cozycactus/x0xb0x-hardware/README.md

# x0xb0x hardware: KiCad and Blender

Private working repository for the x0xb0x Eagle-to-KiCad conversion and reconstructed enclosure assembly. Original design: **Copyright (c) Limor Fried & Adafruit Industries**. x0xb0x is an Adafruit trademark.

## Open the current projects

- [Mainboard — KiCad working revision 30](kicad-working/mainboard/mainboard.kicad_pro)
- [I/O board — KiCad working revision 30](kicad-working/ioboard/ioboard.kicad_pro)
- [Schematics as PDF: mainboard](kicad-working/schematic-redraw/mainboard-schematic.pdf) and [I/O board](kicad-working/schematic-redraw/ioboard-schematic.pdf)
- [Fabrication packages — revision 30](kicad-working/fabrication/revision-30/README.md)
- [Complete assembly — Blender revision 29](kicad-working/visualization/blender-case-revision-29/x0xb0x-populated-with-case.blend)
- [KiCad notes](kicad-working/README.md) and [Blender views and limitations](kicad-working/visualization/blender-case-revision-29/README.md)

Keep each complete project folder together: symbols, footprints and STEP models use project-relative paths. The Blender file embeds the populated boards and can be opened without the original workspace or external board exports. The current scene was saved with Blender 5.2.2 LTS. The current KiCad projects were checked using KiCad 10.0.7.

See [opening and verification instructions](docs/OPENING.md) for a fresh download.

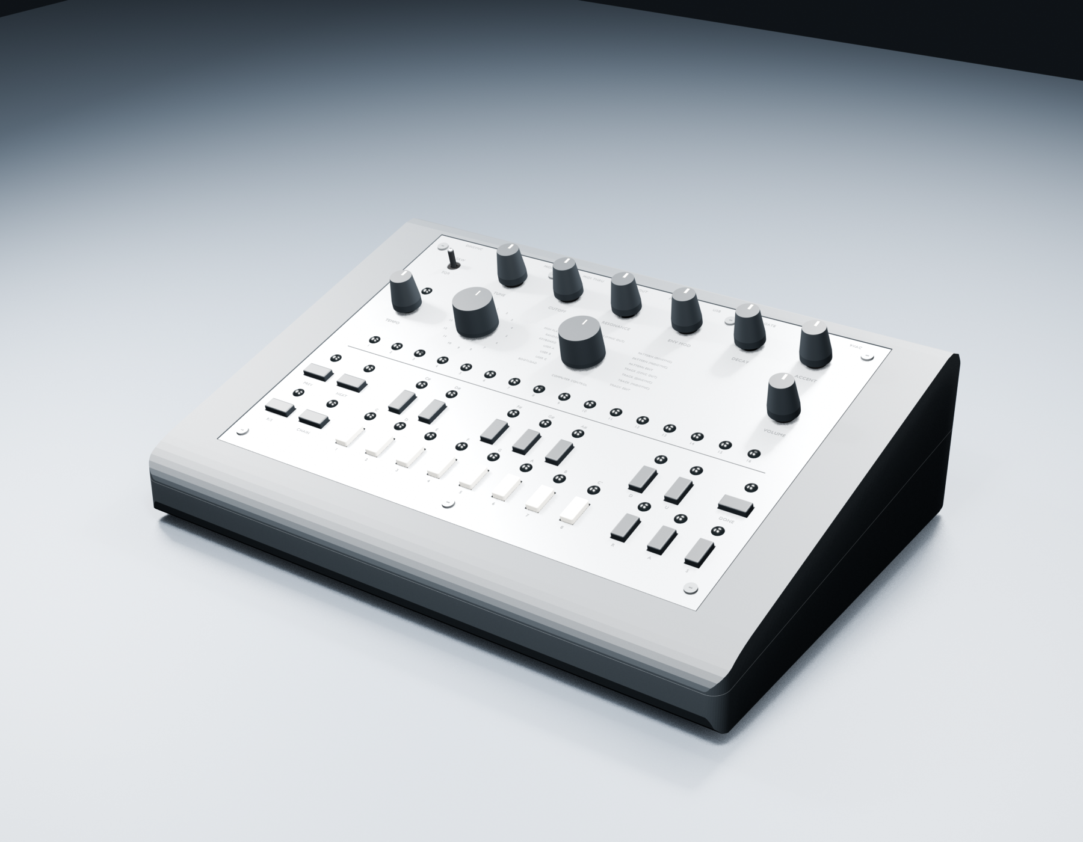
[picture p1: kicad-working/visualization/blender-case-revision-29/assembled.png]
Assembled x0xb0x


## What is included

- Both editable KiCad schematics and routed PCBs, project-local libraries and all 491 fitted component models.
- The original four Eagle files, byte-for-byte preserved under [original-eagle](original-eagle/).
- The corrected Blender enclosure, original panel DXFs, model generators, reference sources, attribution and verification reports.
- Complete PCB-mounted LED models with black STD240B spacers at all 40 positions. Their lenses pass through the front panel; the earlier duplicate lens objects were removed.
- All 23 button caps attached to their PCB switches in the exploded view, with their assembled positions retained.
- The detailed rear jacks and photo-qualified bent-back regulator/heatsink arrangement.
- Open rear socket mouths in the complete assembly: five obsolete solid display disks removed, and through-bores added to the three audio jack nuts and washers.
- The rear plate seated on the original Eagle I/O datum, with the three audio jack shoulders on its inner face.
- The I/O board on the original rear-panel height datum, with the USB shell now retaining its printed0.38mm body-to-PCB gap and the audio jacks centred in their holes.
- Solder terminals on every fitted model: the 12 models that had none now carry terminals from their manufacturer drawings, with the drawing/footprint conflicts recorded.
- A [simulation of the VCF and the whole analog section](kicad-working/validation/vcf-simulation/README.md) in ngspice, generated from the KiCad schematic and compared with published analysis of the TB-303 filter, with WAV renders from the line output. Nothing in it is measured on hardware.
- [Adapter boards](kicad-working/adapters/ssip5-dual/README.md) that replace the rare 2SC1583 and 2SC2291 dual transistors with current parts, without changing the mainboard. They are designed and checked in KiCad and in simulation; nothing has been ordered or built.
- [FR-4 main and rear panels](kicad-working/panels/README.md), drawn as KiCad boards with silkscreen legends so a PCB fab can make them. They are checked in KiCad and against part drawings; nothing has been ordered, made or fitted.
- A [parts order list](parts/README.md) for one unit: Mouser numbers, stock and prices as read, substitutes for the rare parts and fit notes checked against the footprints.

Blender views: **frame 1** assembled, **frame 80** exploded, **frame 120** control-side inspection, **frame 160** wiring study. The caps are intentionally hidden in the two inspection views.

## Validation and known limits

Blender29 brings the scene level with KiCad30 on the mainboard. The two SC-59 chips Q128 and Q139 stand at their footprints, and the do-not-place JFETs Q28 and Q39 they replace are out of the scene, so it shows the board as built and still holds 491 fitted models; Blender28 still shows the JFETs. The eight mainboard layer meshes are a fresh KiCad export in the scene's own materials. No chip model overlaps a neighbour. Q128 is the tight one, between C33 and standing resistor R105: its model is 0.35 mm from C33's and 0.42 mm from R105's, and its gate land ends 0.08 mm from R105's model in plan. See the [revision notes](kicad-working/visualization/blender-case-revision-29/README.md) and [validation](docs/blender-jfet-sites.json).

KiCad30 puts two SC-59 chips on the mainboard, Q128 and Q139, next to the rare JFETs Q28 and Q39, so that no rare transistor is left on the board. The holes stay, every original pad, track, via and drill still matches the Eagle board, and nothing has been built or measured. See [the SMD sites](kicad-working/smd-sites/README.md).

Blender28 brings the scene level with KiCad29 on the mainboard. The four chips stand at their footprints, and the do-not-place SIP pairs they replace are out of the scene, so it shows the board as built and still holds 491 fitted models; Blender27 still shows the pairs. The eight mainboard layer meshes are a fresh KiCad export in the scene's own materials, which also brings the earlier KiCad board changes into the scene. No chip model overlaps a neighbour; the closest is thermistor R100A0, 0.07 mm from Q126's top edge. See the [revision notes](kicad-working/visualization/blender-case-revision-28/README.md) and [validation](docs/blender-smd-sites.json).

KiCad29 puts four SOT-363 chips on the mainboard, next to the rare SIP pairs Q12, Q21, Q22 and Q26, so the board can be built with parts in production. The SIP holes stay, every original pad, track, via and drill still matches the Eagle board, and nothing has been built or measured. See [the SMD sites](kicad-working/smd-sites/README.md).

KiCad28 redraws both schematics by hand, block by block, on A3 sheets. Every pin is on the same net as on the board copper and in the original Eagle schematic, and the board files change only in the links from footprints to symbols, so the revision 27 fabrication packages still apply. See the [redraw notes](kicad-working/schematic-redraw/README.md).

KiCad27 makes both boards orderable. The first fabrication export, re-imported against the board files, found two defects. The mainboard's saved ground pour still cleared the SIP9 pads as they were before KiCad26 lengthened them, and touched 23 of them; KiCad26's DRC had refilled the zones before checking. The I/O board's Edge.Cuts also carried the original rear-plate datum as a second closed outline. The pours are refilled, with only their fill nodes copied in, and the four datum lines move to Dwgs.User. DRC of the copper as saved is clean, every other DRC item equals KiCad26, and the Eagle comparison is unchanged apart from the datum lines. The [order packages](kicad-working/fabrication/revision-27/README.md) (Gerbers, drills, drill maps, BOM, placement, fab notes with the owner's choices) pass a re-import against the board files and a gerbv re-export. See the [revision-27 notes](kicad-working/validation/models-review-27/README.md).

KiCad26 restores the two conversion differences KiCad25 recorded: the 27 SIP9 pads of IC14, IC15A and IC15B now have Eagle's 1.408x2.816mm size, and the 461 name labels sit at the original smashed positions, rotations and sizes, with the 11 references KiCad ends in 0 printing their Eagle names (MIXOUT, IC15A, ...). Every pad and every silkscreen text now matches the original Eagle CAM output; via tenting, the NPTH stop frame and the IC25 mask corners remain as recorded. Non-silkscreen DRC results are unchanged and silkscreen warnings decrease. See the [revision-26 notes](kicad-working/validation/models-review-26/README.md).

KiCad25 compares both boards' Gerbers and drills with the original Eagle 4.13 boards and settles the three recorded connection gaps. Drills, copper tracks, vias, pads, pour outlines and connectivity, paste and all non-text silkscreen reproduce the original, except 27 SIP9 pads that the import made 0.78mm shorter; 445 name labels sit at library positions instead of the original smashed positions. The +5V gap at S22 is closed inside switches S19 and S22, whose pins 1-2 form one strip, now declared as KiCad jumper pad groups. The two GND gaps are the original's drawn ground splits, joined without loops through the J3-J7 wiring, and stay unrouted. No copper changed. See the [fabrication comparison](kicad-working/validation/models-review-25/fabrication-comparison/README.md) and [readiness record](docs/fabrication-readiness.json).

KiCad24 and Blender27 print the part markings of the17 ICs, transcribed from the original kit photographs (part number and code lines, no logos), raised0.03mm in light-grey ink on the unchanged chip tops. See the [marking sources and validation](docs/ic-markings.json).

KiCad23 and Blender26 seat IC3 and IC2 in their original-BOM sockets (AMP390262-5 and390261-2) using TE manufacturer models: black ladder housings5.10mm tall with tin contacts, the chips resting on top. Socket tails fit the original drills; no new contact appears. See the [socket sources and validation](docs/ic-socket-completion.json).

KiCad22 and Blender25 give all212 fixed resistors the original kit's colour bands, read from the original parts page: tan5% bodies with four bands and light-blue1% bodies with five (R4, R5, R106, R74-R90). Body and lead geometry are the unchanged KiCad models, so no outline, clearance or fit changes. R16 and R106 follow the parts page; their PCB values are unchanged. See the [band sources and validation](docs/resistor-colour-bands.json).

KiCad21 and Blender24 give all39 radial electrolytics Xicon XRL bodies, the original kit's light-blue Mouser parts, sized from the XRL datasheet and checked against the original kit photographs:5x11mm for33 parts,6.3x11mm for C7/C8 and10x12.5mm for C43, replacing generic5mm- and10mm-tall cans. Leads land on the original2.54/5.08mm holes; C17 and C3/C5 keep their geometry in the photo colours. C8's larger can reaches the TM6 trimmer by about0.09mm, recorded rather than moved. See the [sources, sizes and validation](docs/electrolytic-xrl-correction.json). The expanded BOM, later printed from the wiki by the owner, confirms all seven XRL part numbers (its two100uF numbers are transposed against their descriptions, which the circuit shows are right) and208 of209 resistor values; see the [expanded BOM cross-check](docs/expanded-bom-crosscheck.json).

KiCad20 and Blender23 correct both Micro-Ohm LPTC12 PTCs from the original manufacturer page recovered by the user:3.7x1.9mm body and0.45mm leads, replacing the footprint-derived7.62x2.54mm body and assumed0.50mm leads. Original PCB spacing and all component transforms remain. See the [source dimensions and validation](docs/ptc-primary-dimension-correction.json).

Additional [terminal and source checks](docs/terminal-isolation-and-source-review.json) found no overlap or touching among151 pairs of separate solder-terminal solids across12 families at25 references. The original Mitsubishi2SC1583 datasheet is now included, with fresh package/pad checks for Q12/Q21/Q26. These checks preserve KiCad19 and Blender22 geometry.

KiCad19 and Blender22 add the40 black STD240B spacers from the user-supplied VCC drawing. Its section A-A confirms that0.240inch includes the end lands, preserving the existing6.096mm LED seat. The original three LED solids, optics and panel projection remain unchanged. See the [spacer source and validation](docs/led-spacer-completion.json).

KiCad working revision18 and Blender revision21 correct USB0 from the recovered original-BOM Kobiconn154-2442-E drawing (KC-301021,2006). The shell sits0.38mm above the PCB; signal pins project2.91mm and mounting tabs3.72mm below it. The previous mixed model used a flush body and FCI61729 terminal lengths. Four signal pins also intersected the illustrative metal floor; their exits now have shell clearances and white insulation. Four illustrative gold mating strips are added. The original footprint, model transform, body width/depth/height, mating cavity, all other components and every assembly pose are preserved. See the [USB correction](docs/usb-kobiconn-correction.json) and [source review](kicad-working/validation/models-review-18/README.md).

KiCad working revision 17 and Blender revision 20 colour the TL1100F tact-switch legs as metal. Revision 8 had coloured the publisher CAD by face position and left black the leg faces that rise above the board outside the housing. Only colours change; the geometry is byte-identical. See the [TL1100F colour report](docs/tl1100f-leg-colour.json).

KiCad working revision 16 and Blender revision 19 rebuild the two Grayhill 25L rotary switches (S3, S4) from the Series 25L drawing and a product photograph of the hex-output part. The photograph supplies the round drum top with lock lugs, the white `8 4 2 1 C` label band, and the green output board with solder joints; the drawing puts the non-turn tab on the centre line opposite the pins. Printed dimensions and pins are unchanged, and the four MT holes stay empty because the BOM part 25LB22-H has no bracket. See the [Grayhill rebuild report](docs/grayhill-25l-rebuild.json), the [KiCad review](kicad-working/validation/models-review-16/README.md) and the [revision-19 notes](kicad-working/visualization/blender-case-revision-19/README.md).

KiCad working revision 15 and Blender revision 18 join every drawing-derived terminal to its body. Checking pots in the KiCad 3D viewer showed that 24 terminals of six models (the Alpha and Panasonic pots, the CTS encoder, the NKK bracket legs, SDS-50J pins 4–5 and the MJ-3536N tip and shunt) stopped just above the seat beside the body. The drawings show them leaving the base edge and turning down; each now has a formed leg with its own section. Leg height and bend are assumptions, and pins, holes and the recorded hole conflicts are unchanged. A new check confirms that all 133 placed terminal pieces join their bodies. See the [terminal join report](docs/terminal-join-correction.json), the [KiCad review](kicad-working/validation/models-review-15/README.md) and the [revision-18 notes](kicad-working/visualization/blender-case-revision-18/README.md).

KiCad working revision 14 and Blender revision 17 correct four of those terminal models against their drawings, after an independent source review of the 19 recorded hole conflicts. The Alpha and Panasonic potentiometer tabs move to their slot centres: their drawings' 13.0 and 10.60 mm dimensions run across the outer slot edges, which revision 13 misread as centre spacing. PJ-202AH terminal 2 becomes the 2.50 mm blade, and the SDS-50J pins follow the period CUI drawing (rev D, 2006), now retained in the repository. The conflicts fall from 19 to 11. The NYS216 rows remain 0.35 mm from the footprint rows with no source explaining the Eagle datum, and the illustrative USB board locks exceed Eagle's smaller nominal mounting holes; their actual deformation and fitted variant remain unqualified; PJ-202AH terminal 3 and SDS-50J pins 1 and 2 differ by Eagle's grid positions within drawing tolerance. Only 12 model paths and 12 Blender meshes change. See the [terminal correction report](docs/terminal-drawing-correction.json), the [KiCad review](kicad-working/validation/models-review-14/README.md) and the [revision-17 notes](kicad-working/visualization/blender-case-revision-17/README.md).

KiCad working revision 13 and Blender revision 16 add solder terminals from the manufacturer drawings to the 12 component models that had none: the NYS216, SDS-50J, MJ-3536N, PJ-202AH and USB-B rear connectors, the bent-back MC78M05, the LPTC thermistors, the CTS encoder, the Alpha and Panasonic potentiometers, and the NKK and Grayhill switches (25 placed references). Every fitted component now has a lead in every drilled hole, except the four Grayhill bracket holes, whose legs the drawing does not define. Terminals follow the drawing dimensions and were not moved to the pads. A native audit against the real drills records 19 nominal interferences where a drawing and the footprint disagree, for example the NYS216 rows 0.35 mm from the footprint rows and the Alpha and Panasonic bracket tabs outside their holes; neither source was altered to fit. Previous body solids, copper, placement and every Blender pose are preserved. Terminal thicknesses, bends and some widths are labelled assumptions. See the [terminal completion report](docs/terminal-completion.json), the [KiCad review](kicad-working/validation/models-review-13/README.md) and the [revision-16 notes](kicad-working/visualization/blender-case-revision-16/README.md).

Blender revision 15 seats the I/O board on the height datum of the original rear-panel DXF, which measures every cutout from 0.250 in (6.350 mm) above the plate's lower edge. Both POWER/USB rectangles start exactly there, and the audio and DIN holes sit their part axis heights above it within 0.001 and 0.018 mm. Revision 14's 6.269 mm compromise left the POWER/USB bodies 0.081 mm below their cutouts. Only the I/O board, with its wiring-study endpoints and the three audio nuts that thread onto the jacks, now moves 0.081 mm upward. No port overlaps plate material, the audio jacks are centred in their holes and no new contacts appear. The original CV/GATE holes sit 0.21 in (5.334 mm) above that datum, against the MJ-3536N's 5.5 mm axis, which the manufacturer's revision history shows unchanged from the 2005 release through 2024. They read as an inch rounding within the part's ±0.2 mm tolerance, so the modelled bushings clear by only about 0.005 mm; see the [MJ-3536N note](kicad-working/validation/rear-seating-review/source-audit/README.md#mj-3536n-axis-height-follow-up-to-blender-revision-15). See the [rear height datum report](docs/rear-height-datum-correction.json) and the [revision-15 notes](kicad-working/visualization/blender-case-revision-15/README.md).

Blender revision 14 seats the rear plate on the datum drawn in the original Eagle I/O board. A detached Dimension-layer strip lies 0.508 mm (0.020 in) behind the PCB rear edge, exactly at the three REAN audio footprint origins, and the original finishing manual clamps the plate with those three jacks. Revision 13 had put the plate inner face on the PCB edge, so each audio shoulder ran 0.508 mm (about 102 mm³) into the plate. Only the I/O board placement moved 0.508 mm toward the case front, with its wiring-study endpoints. The audio shoulders seat within 0.001 mm, the DIN and MJ fronts sit 0.508 mm behind the plate, and a triangle-level screen finds no new contacts. KiCad, copper, placement, the case, plate cutouts and all other poses are unchanged. Reading the strip as the plate section is an interpretation, since the strip is wider than the plate. See the [rear plate datum report](docs/rear-plate-datum-correction.json) and the [revision-14 notes](kicad-working/visualization/blender-case-revision-14/README.md).

Blender revision 13 and KiCad working revision 12 correct the contact pattern of all four SDS-50J DIN models. The primary drawing's 25-degree leaders describe elongated slot tilts; our previous reconstruction used them incorrectly for the outer contact center positions. The two outer centers now lie on the horizontal diameter. The three lower contacts, nominal body envelope, all component poses, materials, case geometry and animation are preserved. See the [contact correction report](docs/din-contact-correction.json) and [model source review](kicad-working/validation/models-review-12/README.md).

The downloaded Warehouse model was placed unchanged into two separate local full-case comparison scenes. Its flange dimensions and body-to-pin datum differ from the current drawing and PCB: its terminals match the drawing's pattern measured from the back of a 0.2 mm thicker flange. At the revision-13 plate position, a nominal pin-fitting shift moved its flange 0.12 mm into the panel material. At the revision-14 plate datum the same fit clears the plate by 0.388 mm. It has not replaced the active drawing-derived model. The received CAD and comparison scenes remain outside this published repository.

Blender revision 12 corrected three rear MIDI legends against the original Eagle schematic and PCB wiring: DIN1 is MIDI OUT, DIN2 is MIDI THRU (displayed as THRU), DIN3 is MIDI IN, and DIN4 remains DIN SYNC (displayed as SYNC). In that revision only the three existing text bodies changed; their fonts, materials, style, positions and 0.01 mm panel offset are preserved. Every connector, component, PCB, enclosure, hardware mesh and animation was preserved in revision 12. See the [DIN/MIDI source review](kicad-working/validation/din-midi-review/README.md) and [correction report](docs/din-midi-correction.json). The [original receipt and source inspection](kicad-working/validation/din-midi-review/user-model-inspection.json) is preserved separately.

Blender revision 11 places the eleven existing rear legends on the plate. Their glyphs previously floated more than 1.24 mm above it and cast detached shadows; they now retain a 0.01 mm rendering gap. Their typography, ink material and in-plane positions are preserved, along with all connector, nut, washer, PCB and enclosure geometry. The text remains presentation artwork; the original rear DXF contains manufacturing annotations rather than these control legends. See the [rear seating and legend review](docs/rear-seating-and-legends.json).

The revision-11 seating review recorded nominal intersections: the three audio body shoulders extended 0.508 mm into the panel from its inner plane, and the power/USB bodies overlap the rectangular lower edges by approximately 0.081 mm. Revision 14 resolves the audio intersection from the original Eagle datum, and revision 15 resolves the power/USB lower-edge overlap from the original rear-DXF height datum. Historical body/terminal registration and fitted variants remain uncertain, and the original cutouts are unchanged. The legend correction does not establish mechanical clearance. Detailed [scene measurements](kicad-working/validation/rear-seating-review/scene-audit/README.md) and [source limits](kicad-working/validation/rear-seating-review/source-audit/README.md) remain explicit.

Blender revision 10 refines the three NYS216 mounting nuts from the retained official DXF, PDF and product photograph: 15 mm wrench flats, a circular rear flange and a rounded front treatment. Only these three presentation meshes change. The washer geometry, native connectors, all other components, case, materials, positions and animation remain as in revision 9. The source dimensions and illustrative details are separated in the [hardware refinement review](kicad-working/validation/nys216-hardware-quality/README.md). The front rounding remains a visual reconstruction; undimensioned rear-face features are omitted. See the [nut refinement report](docs/nys216-hardware-refinement.json).

Blender revision 9 corrects rear socket occlusion in the presentation geometry. The installed native connector models already had open entrances; five separate display disks and six solid audio hardware pieces covered them. The correction preserves all 491 native component assemblies, the case and panel cutouts, component positions, materials and animation. Independent checks inspect all 11 rear ports using the evaluated assembly geometry, including the DIN contact mouths and the passages around the power pin and USB tongue. See the [rear opening review](kicad-working/validation/rear-openings-review/scene-audit/README.md) and [source model review](kicad-working/validation/rear-openings-review/source-audit/README.md). Earlier preservation checks did not test these openings.

The audio nut bores use an illustrative 9.6 mm clearance around the installed 9.525 mm nose; washer bores use the retained 11.3 mm drawing dimension. The manufacturer's DXF and product photo confirm the six-flat SW15 nut, as recorded in the [hardware source review](kicad-working/validation/rear-openings-review/source-audit/NYS216-HARDWARE.md). The older 3/8-32 UNEF source and later M11 drawing describe different threads, so the exterior hardware depiction does not establish interchangeability or physical fit. Those revision-9 and revision-10 updates changed only Blender and preserved the KiCad revision-11 projects and electrical findings.

KiCad revision 11 updates 24 historical 2SC536F transistor illustrations and both ceramic resonators. Its saved model integration passed 5,200 checks and source/native integration review passed 4,041 checks; the companion Blender revision 8 passed 12,819 preservation checks. The transistor dimensions are typical values, and the historical NP package choice remains a documented inference from the BOM and original photo. Resonator maximum envelopes and complete leads are preserved. Both schematics passed ERC with zero errors and warnings under the recorded project rules. Existing PCB connection gaps remain at mainboard IC9.8/GND, mainboard S22.1/+5V and I/O MIXOUT0/GND; recorded DRC and schematic-parity warnings also remain. The 3D updates did not alter the circuit, copper routing or footprint placement.

The LED height uses the BOM's named STD240B 0.24-inch spacer. An older assembly table says 0.22 inch; the discrepancy is documented. Exact spacer molding, button retention/travel, historical vendor variations, assumed terminal sections, the remaining omitted locators, reconstructed enclosure tolerances and the wiring study remain qualified. These files do not establish physical assembly readiness.

Twelve reusable checks are included:

- `python3 scripts/verify_project.py` checks file hashes, the 375 current KiCad project files, original Eagle sources and saved Blender scene.
- `python3 scripts/verify_kicad_dependencies.py` checks that symbols, footprints and all 497 placed models, the six do-not-place parts among them, resolve inside the checkout, without global KiCad libraries. Both Python checks accept `--root PATH` and require Python 3.9 or later.
- `scripts/verify_blender_scene.py` runs inside native Blender and checks embedded components, complete LED assemblies, cap attachment across views and external file dependencies. See the opening instructions for the command, including the required failure exit-code option.
- `scripts/verify_rear_openings.py` runs inside native Blender and checks the actual rear mating passages for scene geometry that covers them. It accounts for intentional contacts and recessed inserts.
- `scripts/verify_kicad_blender_models.py` runs inside native Blender, exports both KiCad PCBs to a temporary folder with `kicad-cli`, and checks that every placed KiCad model matches the scene's embedded native mesh: footprint frame, bounds, centroid, surface area and triangle count. Footprints marked do-not-place are left out of the export, because the scene shows the boards as built. Blender-only enclosure and presentation parts are outside its scope. It needs KiCad installed; set `KICAD_CLI` to override the macOS path.
- `scripts/verify_drill_fit.py` runs inside native Blender, exports both KiCad PCBs to a temporary folder and cuts every placed model at both board faces and mid-depth against the drills read from the PCB files. It requires a lead in every drilled hole and fails on any interference or board crossing not declared, with its source reason, in [docs/drill-fit-allowances.json](docs/drill-fit-allowances.json). It exports the do-not-place SIP pairs too, so their leads stay checked against the holes that remain. Currently it measures 489 models and finds only the declared exceptions: the TL1100F free-state retention kinks, the NYS216 row offset, the USB press-fit board locks, two SDS-50J pins, PJ-202AH terminal 3 and the empty Grayhill bracket holes.
- `scripts/verify_terminal_joins.py` runs inside native Blender, exports both KiCad PCBs to a temporary folder and checks that every terminal of the drawing-derived terminal models (`*_Terminals.step`) touches or enters its body. It currently checks 133 terminal pieces at 25 references.
- `python3 kicad-working/schematic-redraw/verify_current_functions.py` replays 214 original-source and current-PCB MIDI function checks. It does not modify the project.
- `python3 kicad-working/fabrication/revision-30/verify_packages.py` re-imports the fabrication packages and checks every pad, via, track, zone fill, mask and paste opening, drill and outline segment against the board files, re-exports every file with gerbv, and runs KiCad's DRC on the copper as saved. It needs KiCad and gerbv.
- `python3 kicad-working/validation/vcf-simulation/verify_report.py` checks the stored VCF and analog-section simulation results against the published statements they are compared with, and that the simulated parts still match the schematic. It needs numpy and `kicad-cli`, and says nothing about real hardware.
- `python3 kicad-working/schematic-redraw/verify_redraw.py` regenerates the schematics and compares them with the installed files, checks their file format and sheet instances, compares every pin with the board copper and the original Eagle nets, checks each footprint's link to its symbol, and reruns ERC and DRC. `--mutation` also leaves one wire out of each sheet to show that the comparison fails. It needs `kicad-cli`.
- `python3 -I kicad-working/adapters/ssip5-dual/make_package.py --check` reruns ERC and DRC on the adapter boards, checks that every mainboard pad reaches the expected chip pin, reads the exported Gerbers and drills back, and compares them with their recorded hashes. It needs `kicad-cli`, and says nothing about a built adapter.
- `kicad-working/panels/make_package.py`, with any Python that has Pillow, reruns DRC on the FR-4 panels, exports them afresh, reads the Gerbers and drills back, compares them with the original panel drawings and the boards, and works out each part's margin at the worst fab tolerance.
- `python3 -I parts/scripts/build_table.py` rebuilds the parts list and checks every reference and quantity in it against the boards.

The initial revision-10 fresh download passed native KiCad ERC, model exports and 106 Blender portability checks; [historical fresh-download verification](docs/fresh-clone-verification.json) pins that source commit and scene hash. Current model integration and electrical evidence are recorded in [working validation](kicad-working/validation/working-validation-summary-revision-30.json). Fresh ERC on both boards reports zero errors and warnings under the recorded rules; DRC now checks the copper as saved, without a zone refill. Both boards' non-silkscreen DRC violations, parity and ignored-check lists exactly equal the previous fresh reports, and I/O silkscreen-to-edge warnings decrease with the datum outline removed; the remaining unconnected items are the two original GND splits. The saved Blender28 audit passes 16 saved-scene comparison checks against revision 27, 106 portability checks and 44 rear-opening checks using 974 rays, and all 491 placed KiCad models match the scene's native meshes. The Blender13 contact-correction, Blender14 plate-datum, Blender15 height-datum, Blender16 terminal, Blender17 terminal-correction, Blender18 terminal-join and Blender19 Grayhill evidence, including the four circuit-function checks, is retained.

These checks do not establish physical fit. The historical native audit/model-generation scripts retain source paths and may require macOS applications, earlier source baselines or other tools; their recorded results are preserved as evidence.

Key reports: [working validation](kicad-working/validation/working-validation-summary-revision-30.json), [fabrication readiness](docs/fabrication-readiness.json), [fabrication packages](kicad-working/fabrication/revision-30/README.md), [FR-4 panels](kicad-working/panels/README.md), [parts list](parts/x0xb0x-parts-order.md), [SMD sites](kicad-working/smd-sites/README.md), [VCF simulation](kicad-working/validation/vcf-simulation/README.md), [dual-transistor adapters](kicad-working/adapters/ssip5-dual/README.md), [front controls](kicad-working/validation/models-review-10/front-controls-review/final-front-control-assembly-review.md), [saved-scene verification](kicad-working/visualization/blender-case-revision-29/verification/final-saved-scene-audit.json), [Blender JFET sites](docs/blender-jfet-sites.json), [Blender SMD sites](docs/blender-smd-sites.json), [rear opening correction](docs/rear-opening-correction.json), [hardware refinement](docs/nys216-hardware-refinement.json), [rear seating and legends](docs/rear-seating-and-legends.json), [DIN/MIDI functions](docs/din-midi-correction.json), [DIN contact correction](docs/din-contact-correction.json), [rear plate datum](docs/rear-plate-datum-correction.json), [rear height datum](docs/rear-height-datum-correction.json), [terminal completion](docs/terminal-completion.json), [terminal drawing correction](docs/terminal-drawing-correction.json), [terminal joins](docs/terminal-join-correction.json), [Grayhill rebuild](docs/grayhill-25l-rebuild.json), [TL1100F leg colour](docs/tl1100f-leg-colour.json), [USB BOM correction](docs/usb-kobiconn-correction.json), [XRL electrolytics](docs/electrolytic-xrl-correction.json), [resistor colour bands](docs/resistor-colour-bands.json), [IC sockets](docs/ic-socket-completion.json), [IC markings](docs/ic-markings.json).

Delivery ZIPs, earlier experimental Blender scenes, temporary native probes, local application state and redundant board GLB exports are excluded. The revision-7 through revision-28 scenes are retained as comparison baselines for the subsequent updates. Native meshes are already embedded in the saved Blender scene. Whole-board exports can be regenerated with the recorded scripts; the last exports' hashes (revision 24; revision 25 changes no model) are recorded in `validation/models-review-24/native-export-record.json`.

## Sources and licensing

See [LICENSE.md](LICENSE.md) for asset-level attribution. Original documentation: [downloads](https://www.ladyada.net/make/x0xb0x/download.html), [parts list](https://www.ladyada.net/make/x0xb0x/fab/parts.html), [sequencer assembly](https://www.ladyada.net/wiki/x0x/sequencerfabrication). The original Eagle conversion used the existing cozycactus KiCad fork at commit `ac8691a64afa0a78d04f0073e82896bcdec82657`; no KiCad source change was required.

This repository starts with a snapshot of the current validated working files. Earlier local work is represented by the included provenance and reports, rather than an invented Git history.
