cozycactus/x0xb0x-hardware/kicad-working/panels/fabrication/iopanel/gerbers/iopanel-drill-report.txt

Drill report for iopanel.kicad_pcb
Created on 2026-11-05T16:48:35

Copper Layer Stackup:
    =============================================================
    L1 :  F.Cu                      front
    L2 :  B.Cu                      back

Drill file 'iopanel-PTH.drl' contains
    plated through holes:
    =============================================================

    Total plated holes count 0

Drill file 'iopanel-NPTH.drl' contains
    unplated through holes:
    =============================================================

    Total unplated holes count 0
