cozycactus/x0xb0x-hardware/kicad-working/panels/fabrication/mainpanel/gerbers/mainpanel-drill-report.txt

Drill report for mainpanel.kicad_pcb
Created on 2026-11-05T16:48:32

Copper Layer Stackup:
    =============================================================
    L1 :  F.Cu                      front
    L2 :  B.Cu                      back

Drill file 'mainpanel-PTH.drl' contains
    plated through holes:
    =============================================================

    Total plated holes count 0

Drill file 'mainpanel-NPTH.drl' contains
    unplated through holes:
    =============================================================
    T1  3.454mm  0.1360"  (7 holes))
    T2  5.400mm  0.2126"  (40 holes))

    Total unplated holes count 47
