cozycactus/x0xb0x-hardware/kicad-working/fabrication/revision-30/ioboard/gerbers/ioboard-drill-report.txt

Drill report for ioboard.kicad_pcb
Created on 2026-11-05T02:32:41

Copper Layer Stackup:
    =============================================================
    L1 :  F.Cu                      front
    L2 :  B.Cu                      back

Drill file 'ioboard-PTH.drl' contains
    plated through holes:
    =============================================================
    T1  0.600mm  0.0236"  (2 holes))
    T2  0.813mm  0.0320"  (17 holes))
    T3  0.950mm  0.0374"  (4 holes))
    T4  1.000mm  0.0394"  (116 holes))
    T5  1.016mm  0.0400"  (27 holes))
    T6  1.200mm  0.0472"  (8 holes))
    T7  1.321mm  0.0520"  (28 holes))
    T8  1.600mm  0.0630"  (18 holes))
    T9  2.200mm  0.0866"  (2 holes))
    T10  2.540mm  0.1000"  (6 holes))
    T11  2.800mm  0.1102"  (2 holes))
    T12  3.200mm  0.1260"  (1 hole)

    Total plated holes count 231

Drill file 'ioboard-NPTH.drl' contains
    unplated through holes:
    =============================================================

    Total unplated holes count 0
