cozycactus/x0xb0x-hardware/kicad-working/fabrication/revision-30/mainboard/gerbers/mainboard-drill-report.txt

Drill report for mainboard.kicad_pcb
Created on 2026-11-05T02:32:35

Copper Layer Stackup:
    =============================================================
    L1 :  F.Cu                      front
    L2 :  B.Cu                      back

Drill file 'mainboard-PTH.drl' contains
    plated through holes:
    =============================================================
    T1  0.390mm  0.0154"  (7 holes))
    T2  0.600mm  0.0236"  (6 holes))
    T3  0.813mm  0.0320"  (228 holes))
    T4  0.900mm  0.0354"  (27 holes))
    T5  1.000mm  0.0394"  (781 holes))
    T6  1.016mm  0.0400"  (36 holes))
    T7  1.194mm  0.0470"  (92 holes))
    T8  1.270mm  0.0500"  (15 holes))
    T9  1.600mm  0.0630"  (8 holes))
    T10  2.184mm  0.0860"  (14 holes))
    T11  2.800mm  0.1102"  (2 holes))

    Total plated holes count 1216

Drill file 'mainboard-NPTH.drl' contains
    unplated through holes:
    =============================================================
    T1  3.302mm  0.1300"  (7 holes))

    Total unplated holes count 7
