cozycactus/x0xb0x-hardware/kicad-working/adapters/ssip5-dual/fabrication/cb/gerbers/ssip5-cb-drill-report.txt

Drill report for ssip5-cb.kicad_pcb
Created on 2026-11-04T11:57:08

Copper Layer Stackup:
    =============================================================
    L1 :  F.Cu                      front
    L2 :  B.Cu                      back

Drill file 'ssip5-cb-PTH.drl' contains
    plated through holes:
    =============================================================
    T1  0.300mm  0.0118"  (2 holes))
    T2  0.800mm  0.0315"  (5 holes))

    Total plated holes count 7

Drill file 'ssip5-cb-NPTH.drl' contains
    unplated through holes:
    =============================================================

    Total unplated holes count 0
