cozycactus/x0xb0x-hardware/kicad-working/visualization/blender-case-revision-22/README.md

# Blender revision22 —40 LED spacers

Open `x0xb0x-populated-with-case.blend` with Blender5.2.2LTS. Forty black STD240B spacer meshes are added at the existing PCB-mounted LEDs. All1681 previous objects, original meshes/materials, cameras, poses and animation are retained. There are now1721 objects,491 native references,40 LEDs and23 button caps. LED height and panel projection remain unchanged.

The detailed VCC drawing resolves0.240inch as total spacer length including end lands:6.096mm. Central third-lead bore and end-land radii remain illustrative and compliant retention tabs are omitted. See `../../../docs/led-spacer-completion.json` and the KiCad19 source review.

The frozen scene passes9 saved-file preservation checks,160 spacer pose/visibility comparisons across four frames,106 portability checks,491 exact native-model comparisons,44 rear-opening checks/974 rays, and the existing terminal-join checks. All489 models with drilled holes pass declared fit allowances. The40 new spacers introduce no unexpected contacts in113 nearby-mesh tests. Five rendered views were visually reviewed.

Frames1 assembled,80 exploded,120 control-side and160 wiring study. New close-ups are `led-spacer-detail.png` and `led-spacer-installed.png`; the latter adds temporary inspection lighting only during its read-only render. The previous USB correction and all enclosure details are retained. Existing11 nominal fit findings and three electrical gaps remain; this does not qualify fabrication or actual assembly.
