cozycactus/x0xb0x-hardware/kicad-working/visualization/blender-case-revision-7/harness-sources/primary-wiki-jumpers.md

- [skip to content](https://wiki.ladyada.net/x0x/jumpers#dokuwiki__content)

# [AdaWiki](https://wiki.ladyada.net/start "[H]")

### User Tools

- [Log In](https://wiki.ladyada.net/x0x/jumpers?do=login&sectok= "Log In")

### Site Tools

Search

ToolsShow pagesourceOld revisionsBacklinksRecent ChangesMedia ManagerSitemapLog In>

- [Recent Changes](https://wiki.ladyada.net/x0x/jumpers?do=recent "Recent Changes [R]")
- [Media Manager](https://wiki.ladyada.net/x0x/jumpers?do=media&ns=x0x "Media Manager")
- [Sitemap](https://wiki.ladyada.net/x0x/jumpers?do=index "Sitemap [X]")

* * *

x0x:jumpers

## Jumpers

#### 3 Wire Jumpers

| Jumper | Pin1 | Pin2 | Pin3 |
| --- | --- | --- | --- |
| J4 | 5.333V | GND | 12V |
| J5 | Headphone | GND | 6V |
| J6 | CV | GND | Gate |
| J7 | Mix Out | GND | Mix In |

#### The 12 Wire Jumper

| Pin | Signal |
| --- | --- |
| 1 | USB TX |
| 2 | USB RX |
| 3 | +5 V |
| 4 | +5 V |
| 5 | Midi In |
| 6 | Midi Out |
| 7 | GND |
| 8 | GND |
| 9 | Din Sync 4 |
| 10 | Din Sync 3 |
| 11 | Din Sync 2 |
| 12 | Din Sync 1 |

/home/ladyada/public\_html/wiki/data/pages/x0x/jumpers.txt · Last modified: 2016/01/28 18:05 (external edit)

* * *

### Page Tools

- [Show pagesource](https://wiki.ladyada.net/x0x/jumpers?do=edit "Show pagesource [V]")
- [Old revisions](https://wiki.ladyada.net/x0x/jumpers?do=revisions "Old revisions [O]")
- [Backlinks](https://wiki.ladyada.net/x0x/jumpers?do=backlink "Backlinks")

Except where otherwise noted, content on this wiki is licensed under the following license: [CC Attribution-Share Alike 4.0 International](http://creativecommons.org/licenses/by-sa/4.0/)

CC Attribution-Share Alike 4.0 International (http://creativecommons.org/licenses/by-sa/4.0/)Donate (http://www.dokuwiki.org/donate "Donate")Powered by PHP (http://www.php.net/ "Powered by PHP")Valid HTML5 (http://validator.w3.org/check/referer "Valid HTML5")Valid CSS (http://jigsaw.w3.org/css-validator/check/referer?profile=css3 "Valid CSS")Driven by DokuWiki (http://dokuwiki.org/ "Driven by DokuWiki")
