cozycactus/x0xb0x-hardware/kicad-working/visualization/blender-case-revision-7/harness-sources/termination-continuity-strategy.md

# Ribbon termination continuity strategy

Keep all existing491 native references and their source meshes, including the10 ribbon terminations. A full harness can join the existing flat insulation ends at canonical Z7.5mm. Extend the existing visible termination rather than adding a second stub or a fictitious connector housing. A small0.05mm overlap of the new visual cable into the preserved insulation end can hide a numerical seam without modifying the original ECAD geometry.

The existing source construction uses2.54mm conductor pitch, D1.0mm insulation, a0.35mm connecting web, and insulation from Z1.2 to7.5mm. The D0.4mm bare ends extend from Z−1.8 to+1.2mm. There is no exposed metal at the upper insulation tip. Three-way overall width is6.08mm;12-way width is28.94mm. These sections and installed heights are documented illustration assumptions, while pad axes and conductor counts follow the source footprints.

Use each exported world tip and outward tangent as the cable attachment frame. Start new geometry0.05mm inside the tip, keep its centerline tangent to outward canonical Z through the attachment, and carry the2.54mm row axis into the span with a continuous transported frame. Preserve the1mm insulation diameter and web thickness at the join. If a thinner/different-pitch ribbon is later supported by a manufacturer source, put the explicit fan-out transition in the new span, without altering these native terminations.

An8mm minimum curve radius is a reasonable visible routing choice for the initial illustration; it is not a manufacturer minimum. Document route length, any torsional transition and radius per cable. Original152.4mm stock length does not establish installed length: current inferred stub heights and board seats can already conflict with a straight-span lower bound. Treat that as a visualization/seating ambiguity to resolve, not a factory defect.

For a saved harness revision, audit endpoint centerline error at each of48 joins (target less than0.01mm), tangent dot product (target greater than0.9999), diameter/web continuity and minimum centerline radius. Confirm each new conductor uses the separately reviewed pin mapping. Check conductor-to-conductor and nearby-body intersections, recording any intersections with coarse housing envelopes as source/seating uncertainties.

Reopen the saved harness scene independently. Compare all491 native reference sets, native mesh vertex/topology/transform fingerprints, native palettes, source collection retention, hidden historical outline, labels/caps and unchanged assembly matrices against stable revision4. Only a new dedicated harness collection and its explicit route/animation data should be added. Verify frames1,80,120 against the exported moving endpoint frames or clearly state the harness's supported inspection frames. Do not save any scene during the audit.
