cozycactus/x0xb0x-hardware/kicad-working/visualization/blender-case-revision-7/source/ladyada-download.md

x0xb0x®Downloads

- [About](https://www.ladyada.net/make/x0xb0x/index.html)

- [News](https://www.ladyada.net/rant/?cat=2)

- [F.A.Q.](https://www.ladyada.net/make/x0xb0x/FAQ.html)

- [Samples](https://www.ladyada.net/make/x0xb0x/samples.html)

- [Gallery](https://www.ladyada.net/make/x0xb0x/gallery.html)

- [Mods](https://www.ladyada.net/make/x0xb0x/mods.html)

- [Make it!](https://www.ladyada.net/make/x0xb0x/fab/index.html)

- [Use it!](https://www.ladyada.net/make/x0xb0x/manual/index.html)

- [Firmware](http://sourceforge.net/projects/x0xb0x/)

- [Software](https://www.ladyada.net/make/x0xb0x/software/index.html)

- [Download](https://www.ladyada.net/make/x0xb0x/download.html)

- [Resources](https://www.ladyada.net/make/x0xb0x/resc.html)

- [Forums](http://forums.ladyada.net/)

- [Wiki](https://www.ladyada.net/wiki/x0x:x0xd0x)

ladyada.net

Please note!

If you plan to make, sell or manufacture x0xb0xes please contact us - we request that you credit Adafruit Industries on the documentation, supporting pages and circuit boards "Copyright (c) Limor Fried & Adafruit industries". x0xb0x (TM) is a trademarked name of Adafruit Industries. Please contact [support@adafruit.com](mailto:support@adafruit.com) if you wish to seek permission to use the name for your products or projects, otherwise you cannot call your product "x0xb0x".

Source

Files

These

files are all released under the [MIT Open Source license:](https://en.wikipedia.org/wiki/MIT_License)

**Copyright (c)**

**Limor Fried & Adafruit industries**

**Permission is hereby granted, free of charge, to any person**
**obtaining a copy of this software, firmware, layout and associated documentation**
**files (the "Design files"), to deal in the Design files without**
**restriction, including without limitation the rights to use,**
**copy, modify, merge, publish, distribute, sublicense, and/or sell**
**copies of the Design, and to permit persons to whom the**
**Design is furnished to do so, subject to the following**
**conditions:**

**The above copyright notice and this permission notice shall be**
**included in all copies or substantial portions of the Design.**

**THE DESIGN FILES ARE PROVIDED "AS IS", WITHOUT WARRANTY OF ANY KIND,**
**EXPRESS OR IMPLIED, INCLUDING BUT NOT LIMITED TO THE WARRANTIES**
**OF MERCHANTABILITY, FITNESS FOR A PARTICULAR PURPOSE AND**
**NONINFRINGEMENT. IN NO EVENT SHALL THE AUTHORS OR COPYRIGHT**
**HOLDERS BE LIABLE FOR ANY CLAIM, DAMAGES OR OTHER LIABILITY,**
**WHETHER IN AN ACTION OF CONTRACT, TORT OR OTHERWISE, ARISING**
**FROM, OUT OF OR IN CONNECTION WITH THE SOFTWARE OR THE USE OR**
**OTHER DEALINGS IN THE SOFTWARE.**

- DXF files (imperial dimension) for the [top](https://www.ladyada.net/media/x0xb0x/x0xbox_mainpanel_march2.dxf)
and [i/o](https://www.ladyada.net/media/x0xb0x/x0xb0x_iopanel_march2.dxf) panels.
These fit the [PT-10](http://www.pactecenclosures.com/Plastic-Enclosures/PT-10.html)
case and should be cut out of 0.062" material.
- [Schematic](http://x0xb0x.cvs.sourceforge.net/*checkout*/x0xb0x/hardware/mainboard.sch?revision=1.1)
and [board file](http://x0xb0x.cvs.sourceforge.net/*checkout*/x0xb0x/hardware/mainboard.brd?revision=1.1) for v1.0 mainboard (in [Eagle](http://www.cadsoft.de/) 4.13 format) and [snapshot](https://www.ladyada.net/media/x0xb0x/mainboard_beta.png)
- [Schematic](http://x0xb0x.cvs.sourceforge.net/*checkout*/x0xb0x/hardware/ioboard.sch?revision=1.1) and [board file](http://x0xb0x.cvs.sourceforge.net/*checkout*/x0xb0x/hardware/ioboard.brd?revision=1.1) for v1.0 ioboard and [snapshot](https://www.ladyada.net/media/x0xb0x/ioboard%20release%20v1_0.png) (the files are out of sync but are correct, hopefully someone can fix it or I will later)

- [Firmware is available from sourceforge](http://sourceforge.net/projects/x0xb0x), [download the latest .hex file](http://x0xb0x.cvs.ourceforge.net/*checkout*/x0xb0x/firmware/x0xb0x.hex?revision=1.12) (1.05) or look in the [CVS repository for the latest firmware/bootloader source code](http://x0xb0x.cvs.sourceforge.net/x0xb0x/).

If you plan to make, sell or manufacture x0xb0xes please contact us - we request that you credit Adafruit Industries on the documentation, supporting pages and circuit boards " **Copyright (c)**

**Limor Fried & Adafruit industries**"

Datasheets

- [BA6110](https://www.ladyada.net/wiki/x0x/rareparts)
- [2SC1583](https://www.ladyada.net/wiki/x0x/rareparts)
- [2SK30](https://www.ladyada.net/wiki/x0x/rareparts)
- [2SA733](https://www.ladyada.net/wiki/x0x/rareparts)

October 17, 2011 11:32
