cozycactus/x0xb0x-hardware/kicad-working/validation/models-review-10/remaining-quality-research/sources/sanyo-discontinued-transistors-table-primary-scan.pdf

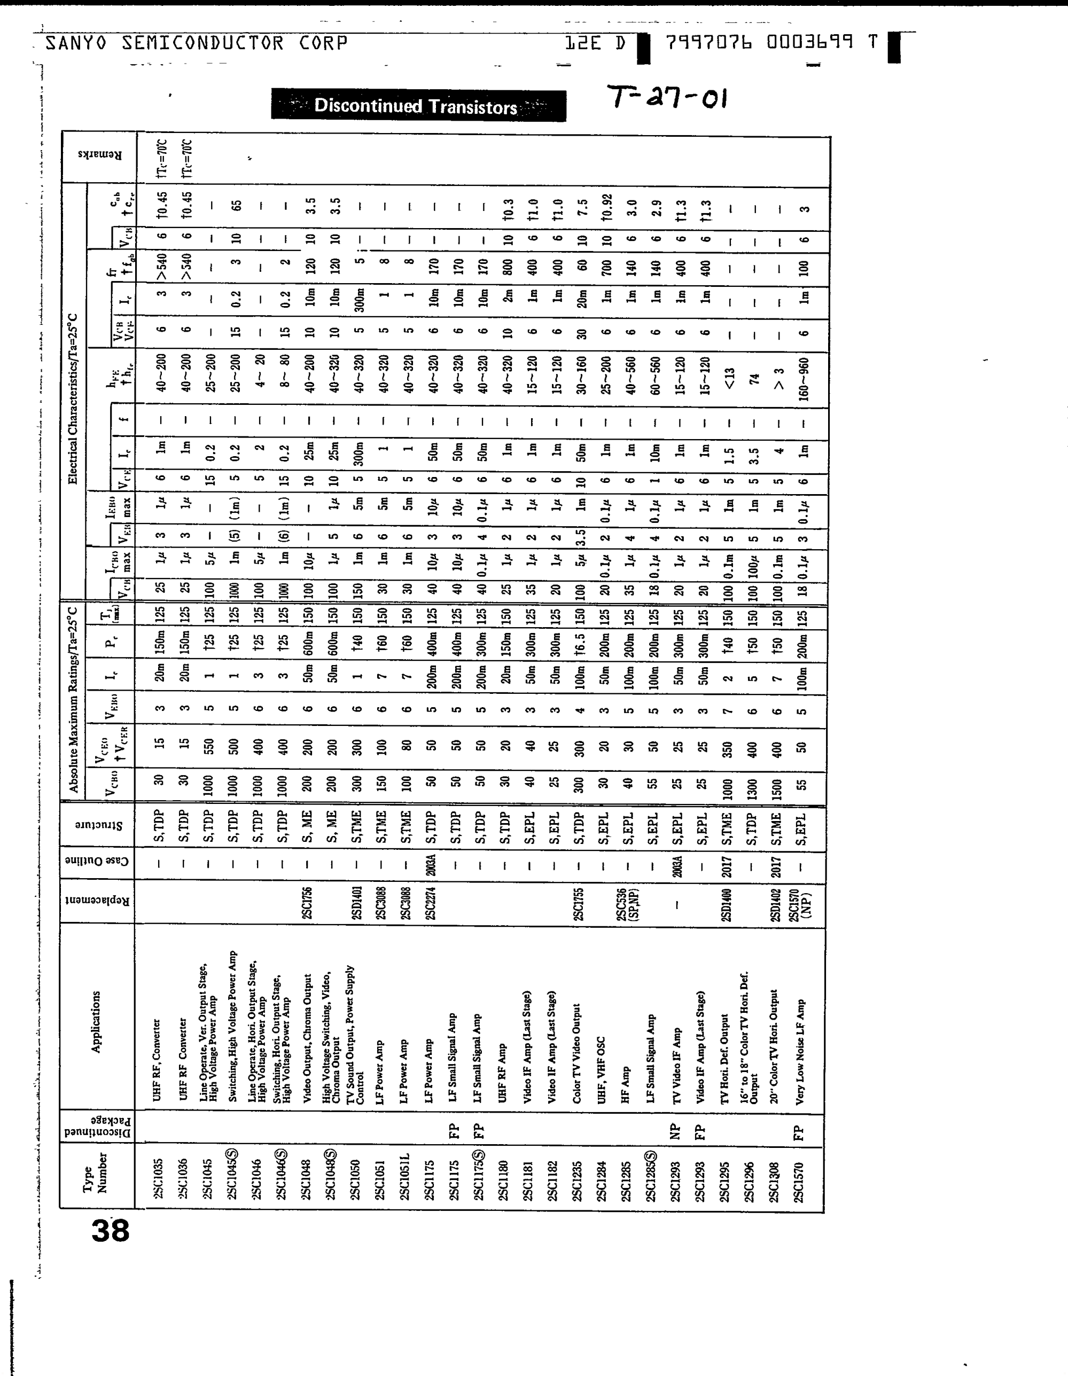
[picture p13: page 1]

Find price and stock options from leading distributors for 2SC536NP on Findchips.com:

https://findchips.com/search/2SC536NP (https://findchips.com/search/2SC536NP?f=dsa&manufacturer=SANYO-Semiconductor-Co-Ltd)

Find CAD models and details for this part:

https://findchips.com/detail/2sc536np/SANYO-Semiconductor-Co -Ltd (https://findchips.com/detail/2sc536np/SANYO-Semiconductor-Co-Ltd?f=dsa)
