cozycactus/x0xb0x-hardware/kicad-working/adapters/ssip5-dual/previews/cb-back.png

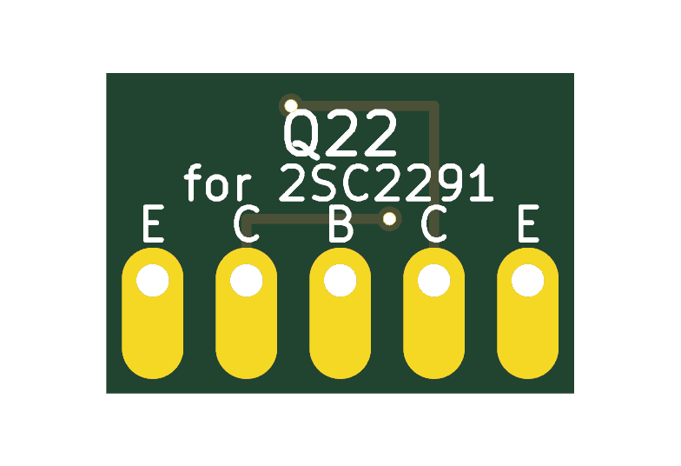
kicad-working/adapters/ssip5-dual/previews/cb-back.png
