cozycactus/x0xb0x-hardware/kicad-working/panels/previews/iopanel-back.png

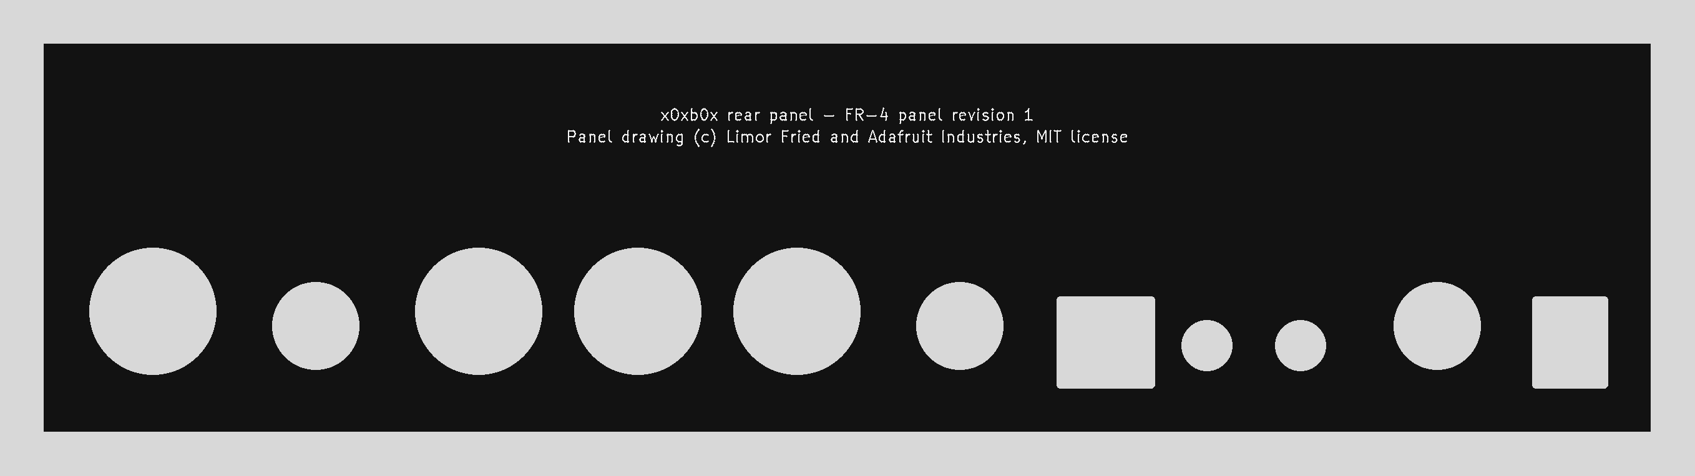
kicad-working/panels/previews/iopanel-back.png
