cozycactus/x0xb0x-hardware/kicad-working/panels/previews/mainpanel-back.png

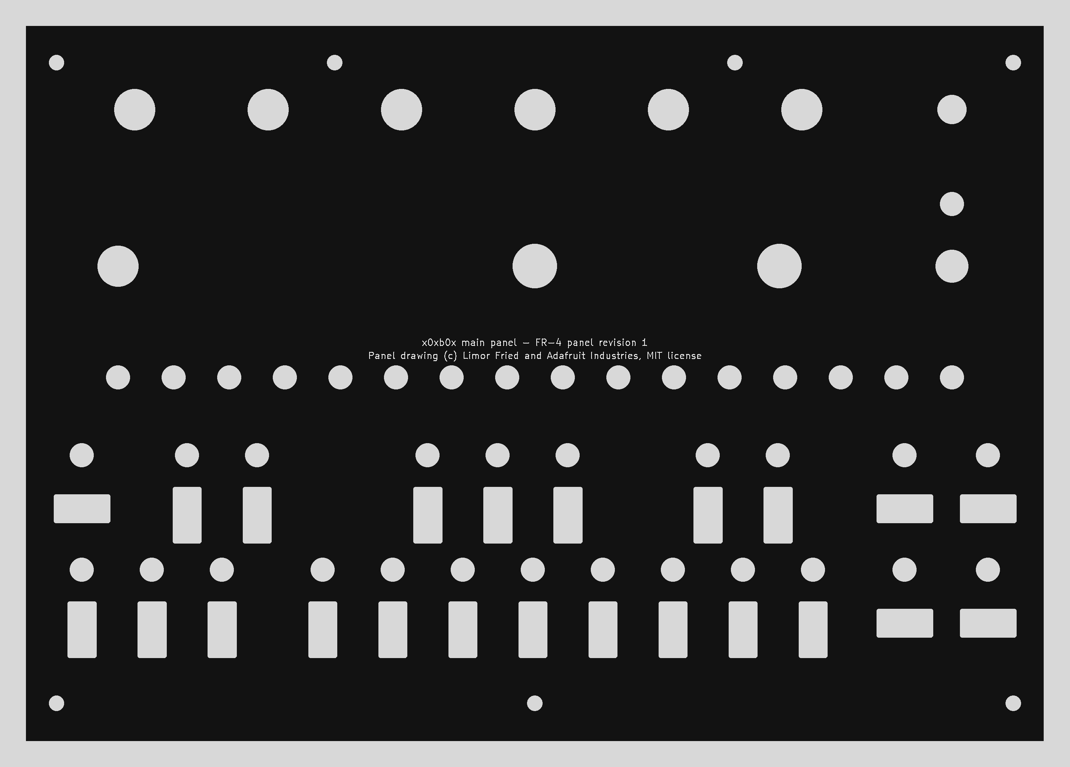
kicad-working/panels/previews/mainpanel-back.png
