cozycactus/x0xb0x-hardware/kicad-working/visualization/blender-case-revision-29/control-side.png

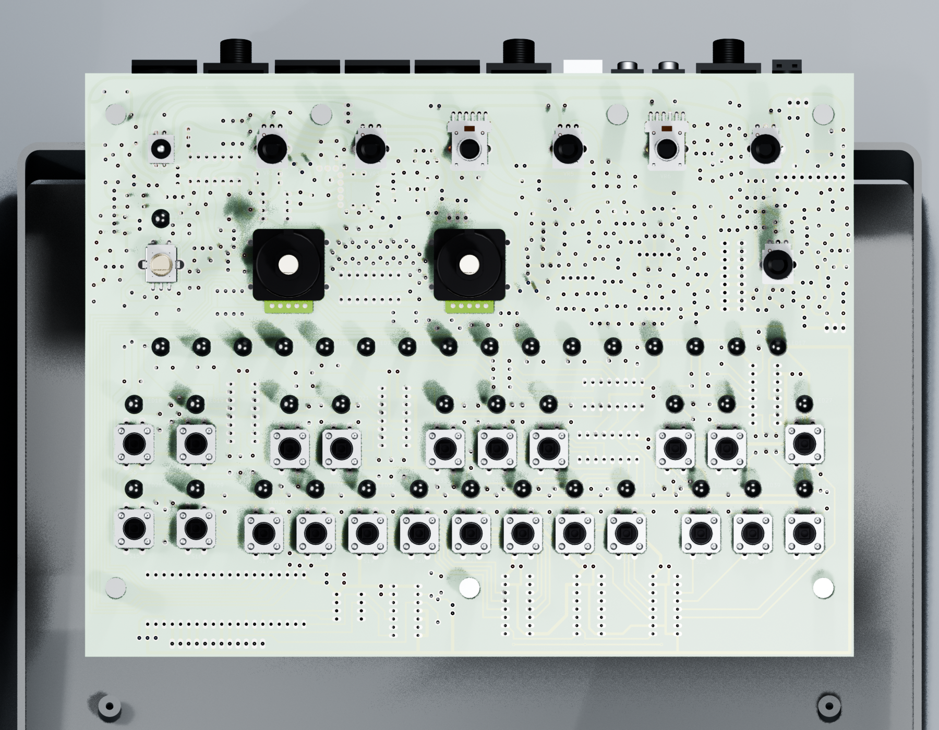
kicad-working/visualization/blender-case-revision-29/control-side.png
