cozycactus/x0xb0x-hardware/kicad-working/visualization/blender-case-revision-29/jfet-q139-before.png

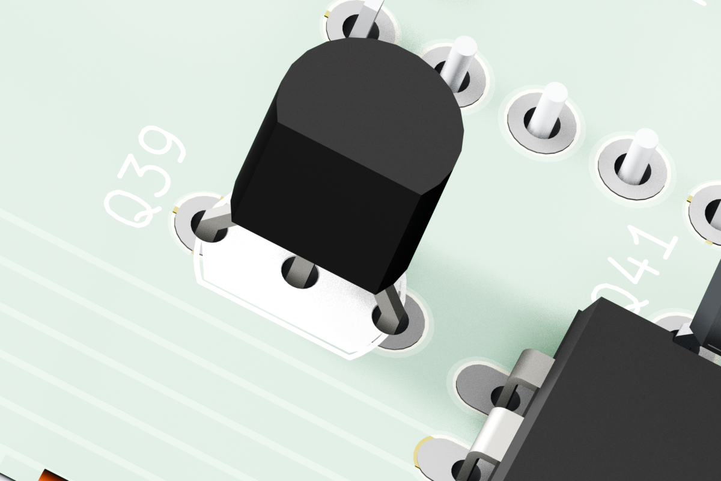
kicad-working/visualization/blender-case-revision-29/jfet-q139-before.png
