cozycactus/x0xb0x-hardware/parts/x0xb0x-parts-order.md

# x0xb0x parts order list (one unit)

Research only: nothing was ordered and neither repository was changed. Mouser stock and one-piece prices were re-read on **2026-11-05**, before shipping and tax. Re-check them on the day you order.

The CSV is [`x0xb0x-parts-order.csv`](x0xb0x-parts-order.csv). It has one row per BOM line, plus the source URLs and notes columns that this page leaves out. Regenerate both files with `python3 -I scripts/extract_footprints.py <mainboard.kicad_pcb> <ioboard.kicad_pcb>` and then `python3 -I scripts/build_table.py`. The build fails loudly if a reference is missing from the boards, listed twice, or does not add up to the row quantity. It passes for all 112 rows: every populated reference on both KiCad boards appears exactly once.

## Summary

| Status | BOM lines | Parts | Meaning |
|---|---|---|---|
| in stock | 69 | 434 | The original part, or an identical current version, is stocked at a major distributor. |
| in stock (EOL) | 2 | 2 | Stocked now, but marked End of Life or No Longer Manufactured. Buy these first. |
| substitute | 28 | 126 | A different current part with a stated fit check, or the original is backordered. |
| hunt | 3 | 3 | No new equivalent exists. You need old stock, the secondary market, or an adapter. |
| generic | 10 | 40 | Screws, standoffs, wire, wall adapter: any equivalent. |
| custom | 2 | 2 | Panels and PCBs, made to order. |
| not ordered | 1 | 0 | Optional BA662A position, left empty. |

**The 3 hunt lines (3 parts):**
- BA6110 ×1
- LA4140 ×1
- FT232BM ×1 (FT232BL is obsolete too)

Everything else can be bought new today. The rare 2SC1583 and 2SC2291 pairs are replaced by [SOT-363 chips on the mainboard](../kicad-working/smd-sites/README.md), lines 61-62, using current parts. That design is simulated and checked in KiCad, but not built. The rows not re-checked are the generic hardware and the made-to-order panels and PCBs (see "Limits").

## Order table

| # | Original description | Qty | References | Original part | Footprint constraint | Order now (MPN / distributor no.) | Checked 2026-11-05 | Status | Fit flag |
|---|---|---|---|---|---|---|---|---|---|
| 1 | 10 ohm 5% resistor | 2 | R164 R186 | Generic 5% (BOM) | 0207 axial, mounted standing; pads 5.08 mm apart, 1.0 mm drill | MFR-25FBF52-10R (YAGEO) / Mouser 603-MFR-25FBF52-10R | Mouser 35,242 at $0.10. Read 2026-11-05 | in stock | none |
| 2 | 22 ohm 5% resistor | 2 | R20 R150 | Generic 5% (BOM) | 0207 axial, mounted standing; pads 5.08 mm apart, 1.0 mm drill | MFR-25FBF52-22R (YAGEO) / Mouser 603-MFR-25FBF52-22R | Mouser 78,658 at $0.11. Read 2026-11-05 | in stock | none |
| 3 | 27 ohm 5% resistor | 2 | R6 R7 | Generic 5% (BOM) | 0207 axial, mounted standing; pads 5.08 mm apart, 1.0 mm drill | MFR-25FBF52-27R (YAGEO) / Mouser 603-MFR-25FBF52-27R | Mouser 7,783 at $0.10. Read 2026-11-05 | in stock | none |
| 4 | 100 ohm 5% resistor | 6 | R1 R95 R130 R132 R136 R152 | Generic 5% (BOM) | 0207 axial, mounted standing; pads 5.08 mm apart, 1.0 mm drill | MFR-25FBF52-100R (YAGEO) / Mouser 603-MFR-25FBF52-100R | Mouser 46,691 +40,000 on order at $0.10. Read 2026-11-05 | in stock | none |
| 5 | 220 ohm 5% resistor | 5 | R13 R14 R15 R18 R19 | Generic 5% (BOM) | 0207 axial, mounted standing; pads 5.08 mm apart, 1.0 mm drill | MFR-25FBF52-220R (YAGEO) / Mouser 603-MFR-25FBF52-220R | Mouser 6,873 +10,000 on order at $0.10. Read 2026-11-05 | in stock | none |
| 6 | 470 ohm 5% resistor | 1 | R12 | Generic 5% (BOM) | 0207 axial, mounted standing; pads 5.08 mm apart, 1.0 mm drill | MFR-25FBF52-470R (YAGEO) / Mouser 603-MFR-25FBF52-470R | Mouser 4,633 +10,000 on order at $0.11. Read 2026-11-05 | in stock | none |
| 7 | 1K 5% resistor | 4 | R2 R17 R137 R161 | Generic 5% (BOM) | 0207 axial, mounted standing; pads 5.08 mm apart, 1.0 mm drill; R137/R232 lie flat on 10.16 mm, R234 on 15.24 mm | MFR-25FBF52-1K (YAGEO) / Mouser 603-MFR-25FBF52-1K | Mouser 45,172 +130,000 on order at $0.10. Read 2026-11-05 | in stock | none |
| 8 | 1.5K 5% resistor | 1 | R8 | Generic 5% (BOM) | 0207 axial, mounted standing; pads 5.08 mm apart, 1.0 mm drill | MFR-25FBF52-1K5 (YAGEO) / Mouser 603-MFR-25FBF52-1K5 | Mouser 13,163 +10,000 on order at $0.12. Read 2026-11-05 | in stock | none |
| 9 | 1.8K 5% resistor | 1 | R179 | Generic 5% (BOM) | 0207 axial, mounted standing; pads 5.08 mm apart, 1.0 mm drill | MFR-25FBF52-1K8 (YAGEO) / Mouser 603-MFR-25FBF52-1K8 | Mouser 75,848 at $0.10. Read 2026-11-05 | in stock | none |
| 10 | 2.2K 5% resistor | 19 | R21 R22 R23 R24 R67 R68 R69 R70 R71 R98 R104 R107 R108 R124 R125 R126 R133 R162 R178 | Generic 5% (BOM) | 0207 axial, mounted standing; pads 5.08 mm apart, 1.0 mm drill; R96 R97 R98 R115 standing on 2.54 mm pads (0207_2V) | MFR-25FBF52-2K2 (YAGEO) / Mouser 603-MFR-25FBF52-2K2 | Mouser 18,395 +20,000 on order at $0.10. Read 2026-11-05 | in stock | At assembly: bend the leads for the 2.54 mm pads (R96 R97 R98 R115) |
| 11 | 4.7K 5% resistor | 2 | R9 R135 | Generic 5% (BOM) | 0207 axial, mounted standing; pads 5.08 mm apart, 1.0 mm drill | MFR-25FBF52-4K7 (YAGEO) / Mouser 603-MFR-25FBF52-4K7 | Mouser 10,110 +20,000 on order at $0.11. Read 2026-11-05 | in stock | none |
| 12 | 6.8K 5% resistor | 1 | R3 | Generic 5% (BOM) | 0207 axial, mounted standing; pads 5.08 mm apart, 1.0 mm drill | MFR-25FBF52-6K8 (YAGEO) / Mouser 603-MFR-25FBF52-6K8 | Mouser 11,462 +10,000 on order at $0.10. Read 2026-11-05 | in stock | none |
| 13 | 10K 5% (40 of them are LED series resistors) resistor | 94 | R10 R11 R34 R36 R47 R61 R64 R65 R94 R96 R97 R101 R105 R109 R112 R115 R116 R142 R143 R144 R145 R148 R149 R157 R158 R160 R201-R234 R237-R270 | Generic 5% (BOM) | 0207 axial, mounted standing; pads 5.08 mm apart, 1.0 mm drill; R96 R97 R98 R115 standing on 2.54 mm pads (0207_2V); R137/R232 lie flat on 10.16 mm, R234 on 15.24 mm | MFR-25FBF52-10K (YAGEO) / Mouser 603-MFR-25FBF52-10K | Mouser 110,107 +70,000 on order at $0.10. Read 2026-11-05 | in stock | At assembly: bend the leads for the 2.54 mm pads (R96 R97 R98 R115) |
| 14 | 22K 5% resistor | 10 | R45 R60 R110 R111 R117 R120 R129 R134 R146 R151 | Generic 5% (BOM) | 0207 axial, mounted standing; pads 5.08 mm apart, 1.0 mm drill | MFR-25FBF52-22K (YAGEO) / Mouser 603-MFR-25FBF52-22K | Mouser 6,224 +10,000 on order at $0.10. Read 2026-11-05 | in stock | none |
| 15 | 33K 5% resistor | 1 | R159 | Generic 5% (BOM) | 0207 axial, mounted standing; pads 5.08 mm apart, 1.0 mm drill | MFR-25FBF52-33K (YAGEO) / Mouser 603-MFR-25FBF52-33K | Mouser 26,679 at $0.10. Read 2026-11-05 | in stock | none |
| 16 | 47K 5% resistor | 4 | R46 R119 R127 R155 | Generic 5% (BOM) | 0207 axial, mounted standing; pads 5.08 mm apart, 1.0 mm drill | MFR-25FBF52-47K (YAGEO) / Mouser 603-MFR-25FBF52-47K | Mouser 9,325 +10,000 on order at $0.10. Read 2026-11-05 | in stock | none |
| 17 | 68K 5% resistor | 1 | R138 | Generic 5% (BOM) | 0207 axial, mounted standing; pads 5.08 mm apart, 1.0 mm drill | MFR-25FBF52-68K (YAGEO) / Mouser 603-MFR-25FBF52-68K | Mouser 6,050 +10,000 on order at $0.12. Read 2026-11-05 | in stock | none |
| 18 | 100K 5% resistor | 24 | R25 R26 R27 R28 R35 R59 R66 R72 R73 R92 R93 R99 R102 R113 R114 R118 R122 R139 R140 R141 R153 R154 R156 R165 | Generic 5% (BOM) | 0207 axial, mounted standing; pads 5.08 mm apart, 1.0 mm drill | MFR-25FBF52-100K (YAGEO) / Mouser 603-MFR-25FBF52-100K | Mouser 12,970 +70,000 on order at $0.10. Read 2026-11-05 | in stock | none |
| 19 | 220K 5% resistor | 8 | R62 R63 R103 R121 R128 R131 R235 R236 | Generic 5% (BOM) | 0207 axial, mounted standing; pads 5.08 mm apart, 1.0 mm drill | MFR-25FBF52-220K (YAGEO) / Mouser 603-MFR-25FBF52-220K | Mouser 3,559 +10,000 on order at $0.10. Read 2026-11-05 | in stock | none |
| 20 | 1MEG 5% resistor | 2 | R91 R200 | Generic 5% (BOM) | 0207 axial, mounted standing; pads 5.08 mm apart, 1.0 mm drill | MFR-25FBF52-1M (YAGEO) / Mouser 603-MFR-25FBF52-1M | Mouser 14,847 +50,000 on order at $0.10. Read 2026-11-05 | in stock | none |
| 21 | 2.4K 1% resistor | 1 | R5 | Generic 5% (BOM) | 0207 axial, mounted standing; pads 5.08 mm apart, 1.0 mm drill | MFR-25FBF52-2K4 (YAGEO) / Mouser 603-MFR-25FBF52-2K4 | Mouser 18,733 at $0.10. Read 2026-11-05 | in stock | none |
| 22 | 5.6K 1% resistor | 1 | R4 | Generic 5% (BOM) | 0207 axial, mounted standing; pads 5.08 mm apart, 1.0 mm drill | MFR-25FBF52-5K6 (YAGEO) / Mouser 603-MFR-25FBF52-5K6 | Mouser 6,715 +10,000 on order at $0.10. Read 2026-11-05 | in stock | none |
| 23 | 200K 1% resistor | 17 | R74-R90 | Generic 5% (BOM) | 0207 axial, mounted standing; pads 5.08 mm apart, 1.0 mm drill | MFR-25FBF52-200K (YAGEO) / Mouser 603-MFR-25FBF52-200K | Mouser 500 +80,000 on order at $0.11. Read 2026-11-05 | in stock | none |
| 24 | 1.5MEG 5% resistor | 1 | R123 | Generic | 0207 axial, mounted standing; pads 5.08 mm apart, 1.0 mm drill | MFR-25FTE52-1M5 (YAGEO) / Mouser 603-MFR-25FTE52-1M5 | Mouser 7,176 +5,000 on order at $0.11. Read 2026-11-05 | in stock | none |
| 25 | 24K 1% resistor (BOM) / 27K on the PCB | 1 | R106 | Generic; BOM PDF and parts page 24.0K 1%, PCB value 27K | 0207 axial, mounted standing; pads 5.08 mm apart, 1.0 mm drill | MFR-25FBF52-24K (and MFR-25FBF52-27K) (YAGEO) / Mouser 603-MFR-25FBF52-24K / -27K | Mouser 78,937 / 13,839 at $0.10. Read 2026-11-05 | in stock | none |
| 26 | 1K PTC thermistor (VCO tempco) | 2 | R100A R100B | Micro-Ohm LPTC12T21001 (1/6 W, 1k, T2 = +3000 ppm/K) | R-7,5: axial, pads 10.16 mm apart, 1.0 mm drill; original body 3.7 x 1.9 mm | LT7330002A1K0JTE (LT73, 3000, 1K0, 5%, SMD) (TE Connectivity) / Mouser 279-LT7330002A1K0JTE | Mouser 3,645 at $1.22, End of Life. ERA-S33J102V (667-ERA-S33J102V): Restricted Availability, End of Life. Read 2026-11-05 | substitute | At assembly: an 0805 chip on wire tails across the 10.16 mm pads |
| 27 | 2K (202) trim potentiometer | 1 | TM6 | Vishay CT6EP202 (Digi-Key 306UC202B) | 306: 3 pads in a triangle (1 and 3 at 5.08 mm, wiper 2.54 mm offset), 6.4 x 6.4 mm outline | 3362P-1-202LF (Bourns) / Mouser 652-3362P-1-202LF | Mouser 151 +6,750 on order at $1.25. CT-6EP202 (229-CT-6EP202): 0. Read 2026-11-05 | substitute | At assembly: the body corner reaches C8's 6.3 mm can by 0.17 mm. Form C8 0.3 mm away from TM6 |
| 28 | 5K (502) trim potentiometer | 1 | TM5 | Vishay CT6EP502 (Digi-Key 306UC502B) | 306: 3 pads in a triangle (1 and 3 at 5.08 mm, wiper 2.54 mm offset), 6.4 x 6.4 mm outline | 3362P-1-502 (or CT-6EP502 / 3362P-1-502LF when they arrive) (Bourns) / Mouser 652-3362P-1-502 | Mouser 194 at $1.68, not the LF part. CT-6EP502 (229-CT-6EP502): 0 +7,000 on order. 3362P-1-502LF: 0 +23,500 on order. Read 2026-11-05 | substitute | none |
| 29 | 50K (503) trim potentiometer | 1 | TM4 | Vishay CT6EP503 (Digi-Key 306UC503B) | 306: 3 pads in a triangle (1 and 3 at 5.08 mm, wiper 2.54 mm offset), 6.4 x 6.4 mm outline | CT-6EP503 (Nidec Copal) / Mouser 229-CT-6EP503 | Mouser 887 at $1.10. Read 2026-11-05 | in stock | none |
| 30 | 500K (504) trim potentiometer | 1 | TM3 | Vishay CT6EP504 (Digi-Key 306UC504B) | 306: 3 pads in a triangle (1 and 3 at 5.08 mm, wiper 2.54 mm offset), 6.4 x 6.4 mm outline | CT-6EP504 (Nidec Copal) / Mouser 229-CT-6EP504 | Mouser 199 at $1.10. Read 2026-11-05 | in stock | none |
| 31 | 50K D (log) potentiometer | 3 | VR3 VR5 VR8 | Panasonic EVU-F2LFL3D54 (Digi-Key P3L2503) | EVU: 3 pins at 2.5 mm pitch, pin row 7.0 mm behind two mounting lugs 9.144 mm apart (2.18 mm drill); 9.6 x 12.5 mm outline | PTV09A-5025F-A503 (audio taper, 6 mm D shaft, 25 mm, plastic bushing) (Bourns) / Mouser 652-PTV09A-5025FA503 | Mouser 831 at $1.75. Alpha RV09AF-40-20K-A54 (317-2080F-50K) 620 at $1.32 has a knurled shaft, which does not suit the D knob. EVU-F2LFL3D54: Obsolete. Read 2026-11-05 | substitute | none |
| 32 | 50K B (linear) potentiometer | 2 | VR2 VR7 | Panasonic EVU-F2LFL3B54 (Digi-Key P3K1503) | EVU: 3 pins at 2.5 mm pitch, pin row 7.0 mm behind two mounting lugs 9.144 mm apart (2.18 mm drill); 9.6 x 12.5 mm outline | PTV09A-4025F-B503 (linear, 6 mm D shaft, 25 mm) (Bourns) / Mouser 652-PTV09A-4025FB503 | Mouser 1,040 at $0.89. EVU-F2LFL3B54: Obsolete. Read 2026-11-05 | substitute | none |
| 33 | 50K B (linear) dual potentiometer | 1 | VR4 | Alpha RV112BCF-40-25F-B54 (Mouser 317-2202-50K) | ALPHADUAL: 6 pins in one row at 2.0 mm pitch, row 11 mm behind two lugs 11 mm apart (2.18 mm drill); 13 x 17.6 mm outline | RV112BCF-40-25A-B50K (11 mm linear 50K dual, 6 mm D shaft, 25 mm) (Alpha (Taiwan)) / Mouser 317-2202F-50K | Mouser 135 at $2.49. Read 2026-11-05 | substitute | none |
| 34 | 1Meg A (log) dual potentiometer | 1 | VR6 | Alpha RV112BCF-40-25F-A16 (Mouser 317-2102-1M) | ALPHADUAL: 6 pins in one row at 2.0 mm pitch, row 11 mm behind two lugs 11 mm apart (2.18 mm drill); 13 x 17.6 mm outline | RV112BCF-40-25F-A16 (Alpha (Taiwan)) / Mouser 317-2102F-1M | Mouser 1,276 at $2.49. Read 2026-11-05 | in stock | none |
| 35 | .001uF (2A102K) polyester capacitor | 3 | C34 C100 C101 | Xicon PM2A102K | C050-035X075: pads 3.556 mm apart, 5.08 x 2.54 mm outline | C320C102J1G5TA (1000 pF C0G ceramic, 100 V, 2.54 mm) (KEMET) / Mouser 80-C320C102J1G | Mouser 2,418 at $0.52. WIMA MKS02 at 1000 pF: not found at Mouser. FKP2D011001D00HO00 film 5,979 at $0.68 needs 5 mm. Read 2026-11-05 | substitute | none |
| 36 | .0068uF (2A682K) polyester capacitor | 1 | C47 | Xicon PF2A682K | C050-075X075: pads 3.81 mm apart, 5.46 x 3.05 mm outline | MKS0F016800B00MSSD (6800 pF, 250 V, 2.5 mm) (WIMA) / Mouser 505-MKS026800/250/20 | Mouser 513 at $0.84, marked Factory Special Order. Read 2026-11-05 | substitute | none |
| 37 | .01uF (2A103K) polyester capacitor | 5 | C10 C20 C21 C33 C46 | Xicon PM2A103K | C050-024X044: pads 4.064 mm apart, 6.10 x 3.30 mm outline | MKS0C021000B00JSSD (0.01 uF, 63 V, 5%, 2.5 mm) (WIMA) / Mouser 505-MKS02.01/63/5 | Mouser 5,478 at $1.13, marked Factory Special Order. Read 2026-11-05 | substitute | none |
| 38 | .018uF (2A183K) polyester capacitor | 1 | C18 | Xicon PF2A183K | C050-025X075: pads 4.064 mm apart, 6.35 x 3.56 mm outline | C320C183J1G5TA (0.018 uF C0G ceramic, 100 V, 2.54 mm) (KEMET) / Mouser 80-C320C183J1G5TA | Mouser 356 at $0.68. Film with 5 mm leads: R82EC2180SH50J 52,973 at $0.34. Read 2026-11-05 | substitute | none |
| 39 | .033uF (2A333K) polyester capacitor | 5 | C19 C24 C26 C36 C201 | Xicon PM2A333K | C050-025X075 (C19 C24 C36 C201): 4.064 mm; C075-032X103 (C26): 5.08 mm | MKS2D023301A00KSSD (C26) + MKS0C023300B00KSSD (others, 2.5 mm, 63 V, 10%) (WIMA) / Mouser 505-MKS2.033/100/10 (C26); 505-MKS0C023300BKSSD (others) | Mouser 9,706 at $0.61 (C26); 2,698 at $0.81 (others). Read 2026-11-05 | substitute | none |
| 40 | .047uF (2A473K) polyester capacitor | 1 | C54 | Xicon PM2A473K | C050-055X075: pads 5.08 mm apart, 7.37 x 4.32 mm outline | MKS2D024701A00KSSD (2.5 x 6.5 x 7.2 mm, 5 mm) (WIMA) / Mouser 505-MKS2.047/100/10 | Mouser 10,123 at $0.62. Read 2026-11-05 | substitute | none |
| 41 | .068uF (2A683K) polyester capacitor | 1 | C45 | Xicon PF2A683K | C050-050X075: pads 7.62 mm apart, 8.89 x 5.08 mm outline | MKS4D026802A00KSSD (0.068 uF, 100 V, 7.5 mm) (WIMA) / Mouser 505-MKS4.068/100/10 | Mouser 515 +5,000 on order at $0.95. MKS4D026803C00KSSD (505-MKS4.068/100/10P) 2,710 at $0.67. Read 2026-11-05 | substitute | none |
| 42 | .1uF (2A104K) polyester capacitor | 3 | C25 C27 C41 | Xicon PM2A104K | C050-030X075: pads 5.08 mm apart, 8.13 x 5.08 mm outline | MKS2D031001A00KSSD (2.5 x 6.5 x 7.2 mm, 5 mm) (WIMA) / Mouser 505-MKS2.1/100/10 | Mouser 9,619 at $0.58. Read 2026-11-05 | substitute | none |
| 43 | .22uF (2A224K) polyester capacitor | 1 | C35 | Xicon PM2A224K | C050-045X075: pads 7.62 mm apart, 11.43 x 6.35 mm outline | MKS4D032202B00KSSD (0.22 uF, 100 V, 7.5 mm) (WIMA) / Mouser 505-MKS4.22/100/10 | Mouser 8,288 at $0.60. MKS4D032203C00KSSD (505-MKS4.22/100/10P) 2,067 at $0.67. Read 2026-11-05 | substitute | none |
| 44 | .1uF (104) ceramic capacitor | 16 | C1 C2 C4 C6 C103 C104 C106 C107 C108 C109 C110 C111 C112 C113 C202 C204 | AVX SR205E104MAR (Mouser 581-SR205E104M) | C050H075X075: pads 2.54 mm apart, 4.57 x 2.54 mm outline | SR205E104MARAP1 (the same part, ammo packaging) (KYOCERA AVX) / Mouser 581-SR205E104MARAP1 | Mouser 13,783 at $0.44. 581-SR205E104MAR: 0 +51,480 on order. X7R alternative FG18X7R1H104KNT06 (810-FG18X7R1H104KNT6) 25,459 at $0.27. Read 2026-11-05 | in stock | none |
| 45 | 1uF (105) tantalum capacitor | 2 | C42 C62 | Kemet T350A105K035AT (Digi-Key 399-1429) | E2,5-7: pads 2.54 mm apart, 5.1 x 4.1 mm outline | T350A105K035AT (KEMET) / Mouser 80-T350A105K035AT | Mouser 114 +35,000 on order at $3.22. Read 2026-11-05 | in stock | none |
| 46 | 1uF 50V electrolytic | 13 | C11 C13 C14 C15 C17 C22 C23 C29 C38 C56 C58 C59 C105 | Xicon XRL50V1.0 (Mouser 140-XRL50V1.0) | E5-6: pads 2.54 mm, 5.33 mm circle (12 pcs); C17 E3,5-8: pads 3.556 mm | ESK105M050AC3AA (5 x 11 mm, 2.0 mm lead spacing) (KEMET) / Mouser 80-ESK105M050AC3AA | Mouser 37,659 +22,500 on order at $0.16. Read 2026-11-05 | in stock | At assembly: form the leads from 2.0 to 2.54 mm; C17 needs 3.556 mm |
| 47 | 2.2uF 50V electrolytic | 1 | C51 | Xicon XRL50V2.2 | E5-6: pads 2.54 mm, 5.33 mm circle | ESK225M050AC3AA (5 x 11 mm) (KEMET) / Mouser 80-ESK225M050AC3AA | Mouser 5,627 at $0.20. Read 2026-11-05 | in stock | At assembly: form the leads from 2.0 to 2.54 mm |
| 48 | 10uF 16V (or 35V) electrolytic | 13 | C16 C30 C31 C32 C37 C40 C50 C52 C60 C61 C72 C203 C205 | Xicon XRL16V10 | E5-6: pads 2.54 mm, 5.33 mm circle | ESK106M035AC3AA (10 uF 35 V, 5 x 11 mm) (KEMET) / Mouser 80-ESK106M035AC3AA | Mouser 38,171 at $0.17. Read 2026-11-05 | in stock | At assembly: form the leads from 2.0 to 2.54 mm |
| 49 | 47uF 16V electrolytic (parts page: 10V) | 4 | C28 C44 C53 C55 | Xicon XRL16V47 | E5-6: pads 2.54 mm, 5.33 mm circle | ECA-1CM470 (Panasonic) / Mouser 667-ECA-1CM470 | Mouser 6,521 at $0.23. Read 2026-11-05 | in stock | none |
| 50 | 100uF 10V electrolytic | 3 | C48 C49 C102 | Xicon XRL (BOM PDF lists 140-xrl25v100 here: transposed) | E5-6: pads 2.54 mm, 5.33 mm circle | ESK107M010AC3AA (5 x 11 mm) (KEMET) / Mouser 80-ESK107M010AC3AA | Mouser 11,251 at $0.18. Read 2026-11-05 | in stock | At assembly: form the leads from 2.0 to 2.54 mm |
| 51 | 100uF 25V electrolytic | 2 | C7 C8 | Xicon XRL (BOM PDF lists 140-xrl10v100 here: transposed) | E5-6: pads 2.54 mm, 5.33 mm circle (original XRL is 6.3 x 11 mm) | ESK107M025AE3AA (6.3 x 11 mm, 2.5 mm) (KEMET) / Mouser 80-ESK107M025AE3AA | Mouser 12,105 at $0.22. Read 2026-11-05 | in stock | none |
| 52 | 1000uF 10V electrolytic (PCB: 1000/6.3) | 1 | C43 | Xicon XRL10V1000 | E5-5: pads 5.08 mm, 10.85 mm circle | UVR1A102MPD (10 x 12.5 mm, 5 mm) (Nichicon) / Mouser 647-UVR1A102MPD | Mouser 2,630 at $0.62. Read 2026-11-05 | in stock | none |
| 53 | 2200uF 16V electrolytic | 2 | C3 C5 | Xicon XRL16V2200 | E5-13: pads 5.08 mm, 12.7 mm circle | UVR1C222MHD (12.5 x 20 mm, 5 mm) (Nichicon) / Mouser 647-UVR1C222MHD | Mouser 922 at $0.93. Read 2026-11-05 | in stock | none |
| 54 | 1N4001 | 4 | D40 D41 D42 D43 | Generic 1N4001 | DO41-10: pads 11.18 mm apart, 1.2 mm drill | 1N4001G (onsemi) / Mouser 863-1N4001G | Mouser 47,613 at $0.27. Read 2026-11-05 | in stock | none |
| 55 | 1N4148 | 29 | D1 D2 D3 D4 D5 D6 D7 D8 D9 D10 D24 D25 D26 D27 D28 D29 D30 D31 D32 D33 D34 D35 D36 D37 D44 D45 D46 D47 D48 | Generic 1N4148 | DO35-10: pads 7.11 mm apart | 1N4148-TAP (Vishay) / Mouser 78-1N4148-TAP | Mouser 111,783 at $0.26. Read 2026-11-05 | in stock | none |
| 56 | Red 5mm LED | 40 | LED1-LED40 | Generic | LED5MM: pads 2.54 mm, 5.7 mm outline | WP7113ID (diffused, 625 nm) (Kingbright) / Mouser 604-WP7113ID | Mouser 26,977 +81,000 on order at $0.21. Read 2026-11-05 | in stock | none |
| 57 | 0.24" LED standoff | 40 | LED1-LED40 (spacers) | VCC STD240B (Mouser 593-STD240B) | Spacer 6.10 mm long, 5.08 mm OD, 2.54 mm lead holes (repo led-spacer record) | ELM 1-240 (5 mm LED mount, black, 0.240 in) (Bivar) / Mouser 749-ELM-1-240 | Mouser 9,900 at $0.38. Essentra LEDS2M-240-01 (144-LEDS2M-240-01): Non-Stocked. Read 2026-11-05 | substitute | none |
| 58 | 2SA733P PNP, TO-92 | 10 | Q1 Q2 Q8 Q9 Q10 Q27 Q31 Q33 Q36 Q38 | Fairchild 2SA733P (Mouser) | TO92 / 2SC536F: 3 pads in line at 2.54 mm; pad order E-C-B (E -2.54, C 0, B +2.54) | KSA992FTA (E-C-B, hFE 300-600) (onsemi) / Mouser 512-KSA992FTA | Mouser 101,160 at $0.34. Read 2026-11-05 | substitute | none |
| 59 | 2SC536F NPN, TO-92 | 24 | Q3 Q4 Q5 Q11 Q13 Q14 Q15 Q16 Q17 Q18 Q19 Q20 Q23 Q24 Q25 Q29 Q30 Q32 Q34 Q35 Q37 Q40 Q41 Q50 | NEC 2SC536F ("Rare") | TO92 / 2SC536F: 3 pads in line at 2.54 mm; pad order E-C-B (E -2.54, C 0, B +2.54); Q17 Q19 Q23 use 2SC536_UNEVEN (E pad at -3.30 mm) | KSC1815YTA or KSC945CYTA (both E-C-B, hFE 120-240) (onsemi) / Mouser 512-KSC1815YTA / 512-KSC945CYTA | Mouser 119,521 / 13,603 at $0.31. Read 2026-11-05 | substitute | none |
| 60 | JFET on the board, in place of the 2SK30A at Q28 (O grade) and Q39 (Y grade) | 2 | Q128 Q139 | Toshiba 2SK30A-O / 2SK30A-Y at Q28 and Q39 ("Rare") | x0x-smd:SC-59_Hand on the mainboard since KiCad revision 30: 3 lands, 1.9 mm pitch | 2SK208-O at Q128 and 2SK208-Y at Q139, S-Mini (SC-59) (Toshiba) / Mouser 757-2SK208OTE85LF / 757-2SK208-YTE85LF | Mouser 9,313 / 9,454 at $0.66. Read 2026-11-05 | substitute | At assembly: O grade at Q128, Y grade at Q139; solder them before the neighbours. Fit a chip or its TO-92 part, never both |
| 61 | Dual NPN on the board, in place of the 2SC1583 at Q12 and Q26 and the 2SC2291 at Q22 | 3 | Q112 Q122 Q126 | Mitsubishi 2SC1583 at Q12 and Q26, 2SC2291 at Q22 ("Rare"); those SIP positions are do-not-place | x0x-smd:SOT-363_Hand on the mainboard since KiCad revision 29: 6 lands, 0.65 mm pitch | BCM847BS,135 (Nexperia) / Mouser 771-BCM847BS135 | Mouser 2,018 +10,000 on order at $0.51. Also at Mouser: 771-BCM847BS-T/R 1,508 at $0.76, Diotec 637-BCM847BS 7,100 at $0.39, Diodes 621-BCM847BS-7 238 at $0.36 (those read 2026-11-04). Digi-Key: Diotec 12,587, Nexperia and Diodes none (2026-11-04). Read 2026-11-05 | substitute | At assembly: solder before the neighbours, 0.65 mm pitch by hand. Q126 touches the R100A model |
| 62 | Dual NPN on the board, in place of the 2SC1583 at Q21 | 1 | Q121 | Mitsubishi 2SC1583 at Q21 ("Rare"); that SIP position is do-not-place | x0x-smd:SOT-363_Hand on the mainboard since KiCad revision 29: 6 lands, 0.65 mm pitch | BC847CDW1T1G (onsemi) / Mouser 863-BC847CDW1T1G | Mouser 14,086 +60,000 on order at $0.19; Digi-Key 48,000 (2026-11-04). Read 2026-11-05 | substitute | At assembly: solder before R110; its land ends 0.07 mm from the R110 model |
| 63 | AN6562 8-DIP dual op-amp | 2 | IC11 IC23 | Panasonic AN6562 ("Rare") | DIL08: 300 mil DIP-8, standard dual op-amp pinout (OUT1 -IN1 +IN1 V- +IN2 -IN2 OUT2 V+) | LM358P (Texas Instruments) / Mouser 595-LM358P | Mouser 39,792 at $0.33. Read 2026-11-05 | substitute | none |
| 64 | 4066 analog switch | 1 | IC12 | Generic 4066 | DIL14 | CD4066BE (Texas Instruments) / Mouser 595-CD4066BE | Mouser 19,069 at $0.99. Read 2026-11-05 | in stock | none |
| 65 | 74HC174 / 74AC174 | 1 | IC9 | Generic (parts page: HC or AC) | DIL16 | SN74HC174N (Texas Instruments) / Mouser 595-SN74HC174N | Mouser 526 at $1.72. Read 2026-11-05 | in stock | none |
| 66 | 74HC126 | 1 | IC1 | Generic | DIL14 | SN74HC126N (Texas Instruments) / Mouser 595-SN74HC126N | Mouser 1,139 at $0.97. Read 2026-11-05 | in stock | none |
| 67 | 74AC165 / 74HC165 | 3 | IC16 IC17 IC18 | Generic (parts page: AC or HC) | DIL16 | SN74HC165N (Texas Instruments) / Mouser 595-SN74HC165N | Mouser 3,954 at $1.64. Read 2026-11-05 | in stock | none |
| 68 | 74HC595 | 5 | IC4 IC5 IC6 IC7 IC8 | Generic | DIL16 | SN74HC595N (Texas Instruments) / Mouser 595-SN74HC595N | Mouser 10,480 at $1.86. Read 2026-11-05 | in stock | none |
| 69 | 4N37 optoisolator | 1 | IC24 | Generic 4N37 (Mouser 512-4N37, onsemi: now obsolete) | DIL06 | 4N37 (Lite-On) / Mouser 859-4N37 | Mouser 6,678 at $0.44. Read 2026-11-05 | in stock | none |
| 70 | 25C33 SPI EEPROM, 32 Kbit | 1 | IC2 | CSI/onsemi CAT25C33P (parts page: CAT2532 / AT25320) | DIL08_AT25: DIP-8, 25xxx SPI pinout | 25LC320A-I/P (Microchip) / Mouser 579-25LC320A-I/P | Mouser 740 at $0.90. Read 2026-11-05 | substitute | none |
| 71 | ATmega162 microcontroller | 1 | IC3 | Atmel ATmega162-16PU (BOM PDF: -40PI) | DIL40 (600 mil) | ATMEGA162-16PU (Microchip) / Mouser 556-ATMEGA162-16PU | Mouser 380 at $6.18. Read 2026-11-05 | in stock | none |
| 72 | LA4140 9-SIP headphone amplifier | 1 | IC14 | Sanyo LA4140 ("Rare") | SIP9: 9 pads at 2.54 mm, 0.9 mm drill, 23 x 3 mm outline | LA4140 NOS/pull (-) | Not at Mouser: no match for LA4140. Read 2026-11-05 | hunt | none for an original part; any replacement amp needs an adapter |
| 73 | BA6110 9-SIP OTA (VCA) | 1 | IC15B | Rohm BA6110 ("Rare") | SIP9 at IC15B: 9 pads at 2.54 mm; IC15A is the alternative BA662 footprint (pins 1-4 differ) | BA6110 NOS/pull (-) | Not at Mouser: no match for BA6110. Read 2026-11-05 | hunt | At assembly: a BA662 or a clone goes in IC15A, not IC15B, with Q1-Q4 left off |
| 74 | BA662A 9-SIP OTA (optional, not in kit) | 0 |  | Roland/Rohm BA662A ("Extremely rare") | SIP9 at IC15A | not ordered (-) | - | not ordered | none |
| 75 | 7805 regulator, TO-220 | 1 | IC20 | onsemi MC78M05CT (Mouser 512-MC78M05CT) | 78XXS: TO-220 lying flat, IN-GND-OUT at 2.54 mm | MC78M05CTG (onsemi) / Mouser 863-MC78M05CTG | Mouser 3,441 at $0.78. Read 2026-11-05 | in stock | none |
| 76 | 78L06 regulator, TO-92 | 1 | IC21 | JRC NJM78L06A (Mouser 513-NJM78L06A) | TO-92_x0x: 3 pads at 2.54 mm | UA78L06ACLP (Texas Instruments) / Mouser 595-UA78L06ACLP | Mouser 1,360 at $1.20. Read 2026-11-05 | substitute | none |
| 77 | LM336Z-5.0 reference, TO-92 | 1 | IC22 | National LM336Z-5.0 | TO-92_x0x | LM336Z-5.0/NOPB (Texas Instruments) / Mouser 926-LM336Z-50/NOPB | Mouser 4,888 at $0.83. Read 2026-11-05 | in stock | none |
| 78 | FT232BM USB UART | 1 | IC25 | FTDI FT232BM (Mouser) | SQFP-S-7X7-32: LQFP-32, 7 x 7 mm body, 0.8 mm pitch (SMD) | FT232BL (pin-compatible lead-free B-series) (FTDI) / LCSC C15916 / C18968 | Mouser: FT232BM (895-FT232BM) Obsolete, no match for FT232BL. Read 2026-11-05. LCSC marketplace figures are from 2026-10-17 | hunt | none for FT232BL; FT232R/FT232RL are not pin-compatible |
| 79 | 6MHz ceramic resonator | 1 | XTL2 | Abracon AWCR-6.00MD | Resonator_6MHz_x0x: 3 pads at 2.54 mm | CSTLS6M00G53-B0 (Murata) / Mouser 81-CSTS0600MG03 | Mouser 1,770 at $0.21. Read 2026-11-05, End of Life | in stock (EOL) | none |
| 80 | 16MHz ceramic resonator | 1 | XTL1 | Abracon AWCR-16.00MD | 2SC2021 footprint: 3 pads at 2.54 mm | CSTLS16M0X53-B0 (Murata) / Mouser 81-CSTLS16M0X53-B0 | Mouser 15,541 at $0.34. Read 2026-11-05, End of Life | in stock (EOL) | none |
| 81 | 40-pin DIP socket | 1 | IC3 (socket) | TE AMP 390262-5 (Mouser 571-3902625) | DIL40 600 mil | 110-44-640-41-001000 (Mill-Max) / Mouser 575-11044640 | Mouser 3,801 at $3.22. Read 2026-11-05 | substitute | none |
| 82 | 8-pin DIP socket | 1 | IC2 (socket) | TE AMP 390261-2 (Mouser 571-3902612) | DIL08 300 mil | 110-44-308-41-001000 (Mill-Max) / Mouser 575-144308 | Mouser 8,752 at $0.89. Read 2026-11-05 | substitute | none |
| 83 | Heat sink (TO-220) | 1 | KK1 (on IC20) | Aavid 574502B00000G (Mouser 532-574502B00) | D03S outline 13.7 x 7.6 mm | 574502B00000G (Boyd/Aavid) / Mouser 532-574502B00 | Mouser 21,205 at $1.98. Read 2026-11-05 | in stock | none |
| 84 | 1/4" stereo jack | 3 | MIXOUT MIXIN HEADPHONE | Neutrik/REAN NYS216 (Mouser 568-NYS216) | REAN_1_4STERO: 6 pads, 1.6 mm drill, 18.2 x 32.7 mm outline | NYS216-U (the same jack, with nut and washer loose) (REAN (Neutrik)) / Mouser 568-NYS216-U | Mouser 801 at $0.61. NYS216: 0 +6,800 on order at $0.72. Read 2026-11-05 | in stock | none |
| 85 | 1/8" jack | 2 | CV GATE | CUI MJ-CP3536N (Digi-Key CP-3536N) | MJ-3536N: 3 slotted pads, 2.54 mm drill, 10.2 x 17.8 mm outline | MJ-3536N (Same Sky (CUI)) / Mouser 490-MJ-3536N | Mouser 7,424 +12,500 on order at $1.09. Read 2026-11-05 | in stock | none |
| 86 | 2.1mm power jack | 1 | POWER | CUI PJ-202AH (Digi-Key CP-202A) | PJ-202AH: 3 slotted pads 2.8/3.2 mm | PJ-202AH (Same Sky (CUI)) / Mouser 490-PJ-202AH | Mouser 3,610 at $0.86. Read 2026-11-05 | in stock | none |
| 87 | USB type-B jack | 1 | USB | Kobiconn 154-2442-E (Mouser) | PN61729: signal pins 2.5 x 2.0 mm, board locks 12.19 mm apart (2.2 mm drill) | 61729-0010BLF (Amphenol FCI) / Mouser 649-61729-0010BLF | Mouser 24,974 at $1.61. Read 2026-11-05 | substitute | none |
| 88 | MIDI/DINSYNC 5-pin DIN jack | 4 | DIN1 DIN2 DIN3 DIN4 | CUI SDS-50J (Digi-Key CP-2350) | CP-2350: 5 pins on a 7 mm circle + 2 shield pins, 1.32 mm drill | SDS-50J (Same Sky (CUI)) / Mouser 490-SDS-50J | Mouser 20,799 at $2.65. Read 2026-11-05 | in stock | none |
| 89 | Toggle switch (saw/square) | 1 | S1 | NKK B12AB-RO (Mouser 633-B12AB) | NKKTOGGLE: 3 pins at 2.54 mm + 4 bracket pins | B12AB (NKK) / Mouser 633-B12AB | Mouser 2,996 at $7.04. Read 2026-11-05 | in stock | none |
| 90 | Rotary encoder (tempo) | 1 | S2 | CTS 290VAA5F201B2 (Digi-Key CT3011) | PEC11-S: A-C-B at 2.5 mm, switch pins 5 mm, lugs 11.4 mm apart (2.8 mm) | 290VAA5F201B2 (CTS) / Mouser 774-290VAA5F201B2 | Mouser 472 at $4.96. Read 2026-11-05 | in stock | none |
| 91 | 16-position rotary switch (bank/mode) | 2 | S3 S4 | Grayhill 25LB22-H (Digi-Key GH3074) | GH3074: C,1,2,4,8 at 2.54 mm, 12.7 mm from shaft; MT1-MT4 take no bracket, only the anchor wire | 25LB22-H (Grayhill) / Mouser 706-25LB22-H | Mouser 60 at $33.63. Read 2026-11-05 | in stock | none |
| 92 | Tact switch 12 mm | 23 | S5-S27 | E-Switch TL1100F160Q (Digi-Key EG1821) | B3F-40XX: 4 pins 12.5 x 5.0 mm, 1.19 mm drill | TL1100F160Q (E-Switch) / Mouser 612-TL1100 | Mouser 3,126 +12,000 on order at $0.51. Read 2026-11-05 | in stock | none |
| 93 | Switch cap (white) | 8 | (on S5-S27) | ITT PE/WHT (Digi-Key 401-1155) | Cap 12.1 x 5.9 x 11 mm | PEWH (C&K) / Mouser 611-PEWH | Mouser 2,338 at $0.93. Read 2026-11-05 | in stock | none |
| 94 | Switch cap (black) | 15 | (on S5-S27) | ITT PE/BLK (Digi-Key 401-1152) | Cap 12.1 x 5.9 x 11 mm | PEBK (C&K) / Mouser 611-PEBK | Mouser 1,999 at $0.84. Read 2026-11-05 | in stock | none |
| 95 | Potentiometer knob | 8 | (on VR2-VR8, S2) | Eagle Plastic Devices 450-4760 (Mouser) | 6 mm D shaft; 13.2 mm body | 450-4765 soft-touch knob (grey pointer line) (Eagle Plastic Devices) / Mouser 450-4765 | Mouser 3,732 at $1.66. 450-4760 (white line, the original): 3 +4,000 on order at $1.88. Plain 450-BA600: 8,541 at $1.85. Read 2026-11-05 | substitute | none |
| 96 | Switch knob | 2 | (on S3 S4) | Davies 1510AH (Mouser 5164-1510) | 0.75 in dia x 0.56 in | 1510AH (Davies Molding) / Mouser 5164-1510AH | Mouser 4,030 at $1.73. Read 2026-11-05 | in stock | none |
| 97 | Board-to-board jumper ribbon (0.1 in) | 4 x 6-wire, or 2 x 9 + 1 x 6 | J3 J4 J5 J6 J7 (both boards) | Molex jumpers (Digi-Key WM09-06 / WM06-06 / WM03-06) | MA12-1 + 4 x MA03-1: 0.100 in pitch, 1.016 mm drill, 24 conductors per board | 0.1 in pitch flat jumper / ribbon, solder both ends (-) | Digi-Key codes not resolved; not checked | generic | none |
| 98 | Wire links J1 (12.7 mm) and J2 (15.24 mm) | 2 | J1 J2 | Not in BOM | 2 pads each, 1.0 mm drill | resistor lead offcuts (-) | - | generic | none |
| 99 | Solid ~20 AWG wire (anchor S3, S4) | 1 |  | Generic (supply yourself) | - | solid 20 AWG tinned copper (-) | - | generic | At assembly: separate wires MT1-MT4 and MT2-MT3, or the ground split is bridged (check 15) |
| 100 | ABS case | 1 |  | PacTec PT-10 | - | 82404-501-000 (PT-10 production unit, black) (PacTec) / Mouser 616-82404-501-000 | Mouser 160 +23 on order at $18.85. Read 2026-11-05 | in stock | Black, the owner's choice on 2026-11-06, to match the black FR-4 panels. Bone is Mouser 616-82404-501-039, 24 at $18.85, read 2026-11-05. No kit needed: this unit has both covers, the assembly screws and the feet, and the panels are line 101 |
| 101 | Set of main and I/O panels | 1 |  | Custom (Adafruit) | - | fabricated from kicad-working/panels (-) | JLCPCB $22.30 main + $9.60 rear for 5 of each, before shipping. Both ZIPs uploaded, read 2026-11-05 | custom | FR-4, black with white legends. Designed, not made or fitted: kicad-working/panels/README.md |
| 102 | Set of main and I/O PCBs | 1 |  | Custom (Adafruit) | - | fabricated from kicad-working/fabrication/revision-30 (-) | JLCPCB $26.80 mainboard + $9.90 I/O for 5 of each, before shipping. Mainboard: revision 30 ZIP uploaded, read 2026-11-05. I/O: revision 29 ZIP, read 2026-11-04 | custom | none |
| 103 | 9 V AC wall adapter, 300-500 mA, 2.1 mm plug | 1 |  | Generic (Jameco) | - | 9 V AC (not DC) adapter, >= 500 mA, 2.1 mm barrel (-) | Not checked (choose for your mains) | generic | none |
| 104 | 15/32" x 1/4" hex 4-40 standoff | 3 |  | Generic (McMaster) | - | aluminium hex standoff, female-female, 4-40, 15/32 in (-) | Generic McMaster hardware; not checked | generic | none |
| 105 | 3/8" x 1/4" hex 4-40 standoff | 4 |  | Generic (McMaster) | - | aluminium hex standoff, female-female, 4-40, 3/8 in (-) | Generic McMaster hardware; not checked | generic | none |
| 106 | 4-40 lock washer | 7 |  | Generic (McMaster) | - | #4 split lock washer (-) | Generic McMaster hardware; not checked | generic | none |
| 107 | 4-40 washer | 4 |  | Generic (McMaster) | - | #4 flat washer (-) | Generic McMaster hardware; not checked | generic | none |
| 108 | 4-40 x 1/4" hex button screw | 7 |  | Generic (McMaster) | - | 4-40 x 1/4 in button head hex drive (-) | Generic McMaster hardware; not checked | generic | none |
| 109 | 4-40 x 1/4" phillips button screw | 7 |  | Generic (McMaster) | - | 4-40 x 1/4 in button head Phillips (-) | Generic McMaster hardware; not checked | generic | none |
| 110 | 4-40 x 1/2" phillips cheesehead screw + 4 rubber feet | 4 |  | Comes with case | - | included with PT-10 (PacTec) | - | in stock | none |
| 111 | 100 pF C0G ceramic, IC9 clock | 1 | IC9 pin 9 to pin 8 | Not in BOM | Existing pads 7.62 mm apart | FG28C0G1H101JNT06 (5 mm leads) (TDK) / Mouser 810-FG28C0G1H101JNT6 | Mouser 3,813 in stock at $0.23. Read 2026-11-05 | in stock | At assembly: form the leads from 5 mm to 7.62 mm, on the solder side |
| 112 | 1 nF C0G ceramic, across the ground split | 1 | IC9 pin 8 to S3 MT3 | Not in BOM | Existing pads 6.03 mm apart | FG28C0G1H102JNT06 (5 mm leads) (TDK) / Mouser 810-FG28C0G1H102JNT6 | Mouser 12,277 in stock at $0.27. Read 2026-11-05 | in stock | At assembly: form the leads to 6.03 mm; S3 MT3 also takes the anchor wire (check 15) |
| 113 | 0.1 uF X7R ceramic, 595 LED driver decoupling | 3 | IC4 IC5 IC7, pin 16 to pin 13 | Not in BOM | Existing pads 7.62 mm apart | FG28X7R1H104KNT06 (5 mm leads) (TDK) / Mouser 810-FG28X7R1H104KNT6 | Mouser 103,402 in stock at $0.27. Read 2026-11-05 | in stock | At assembly: on the solder side, with the leads arched clear of the joints of pins 14 and 15 |
| 114 | 0.1 uF X7R ceramic, MCU decoupling | 1 | IC3 pin 40 to C101 pad 1 | Not in BOM | Existing pads 3.64 mm apart | FG18X7R1H104KNT06 (2.5 mm leads) (TDK) / Mouser 810-FG18X7R1H104KNT6 | Mouser 25,459 in stock at $0.27. Read 2026-11-05 | in stock | At assembly: form the leads from 2.5 mm to 3.64 mm, on the solder side |
| 115 | 150 ohm 5% resistor | 1 | R16 | Parts page: 150 ohm in newer kits, 100 ohm in older ones; BOM PDF and PCB 100 ohm | 0207 axial, mounted standing; pads 5.08 mm apart, 1.0 mm drill | MFR-25FBF52-150R (YAGEO) / Mouser 603-MFR-25FBF52-150R | Mouser 6,535 +30,000 expected 2026-12-03 at $0.10. Read 2026-11-05 | in stock | none |

## Rare and obsolete parts: substitutes and fit

The parts marked **secondary market** below can only be had as old stock (NOS), pulls or clones. Expect fakes, and test each part before soldering it in.

| Part (qty, refs) | Status | Best route | Electrical fit | Footprint fit / change needed | Sources |
|---|---|---|---|---|---|
| **2SC1583** ×3, Q12 Q21 Q26 | substitute, **chips on the board** (owner's choice) | [SOT-363 sites](../kicad-working/smd-sites/README.md) on the mainboard: **BCM847BS** as Q112 and Q126, and **BC847CDW1T1G** as Q121. Old stock from eBay remains the alternative, with a risk of fakes; it goes in the SIP holes, as does an [adapter](../kicad-working/adapters/ssip5-dual/README.md), only if the chip stays off. | Dual NPN; the board ties the two emitters. In the model Q21's gain sets the resonance: top Q 28.3 with BC847C, 18.1 with BCM847, 26.1 for an original at hFE 400. BC847C has no matching figure, and BCM847's holds only at 2 mA, so measure a chip before relying on it. Avoid DMMT3904W at Q21: only a minimum hFE of 100 at 10 mA was confirmed. | No drop-in part exists, so KiCad revision 29 adds 6-land SOT-363 sites beside the SIP holes. See check 2 below. | SMD sites README; [midibox thread](https://forum.midibox.org/t/x0xb0x-rare-parts/9689); repo `kicad-working/validation/2sc1583-review/sources/mitsubishi-2sc1583.pdf`; [Brian Castro via sequencer.de](https://www.sequencer.de/synthesizer/threads/303.123942/post-1463815) (SMD pairs exist but need sorting); [Mouser BCM847BS](https://www.mouser.com/c/?q=BCM847BS); [Mouser BC847CDW1T1G](https://www.mouser.com/c/?q=BC847CDW1T1G); [Digi-Key BC847CDW1T1G](https://www.digikey.ie/en/products/detail/onsemi/BC847CDW1T1G/1476009) |
| **2SC2291** ×1, Q22 | substitute, **chip on the board** (owner's choice) | **BCM847BS** as Q122. Old stock from eBay ([listing example](https://www.ebay.de/itm/177515067274)) remains the alternative, in the SIP holes, only if the chip stays off. | Dual NPN; the board ties the two bases. The model shows no effect from this pair. | As above. | as above |
| **BA6110** ×1, IC15B | **secondary market** | Pulls from eBay or AliExpress. A 2010 forum post warns about one seller of defective parts. | Option: the Open Music Labs **BA662 clone**, a discrete matched-pair replica. Compared with the BA6110, the BA662 is 3-7 dB quieter (subatomicglue measured one chip of each) and has a 0.6 V control threshold instead of about 1.15 V. | The clone is a BA662 replacement, so it goes in **IC15A** (the BA662 footprint). With anything in IC15A, leave IC15B and Q1-Q4 off: Q1-Q4 are the BA6110's current mirror, and Q3 would sit across the BA662's control input. IC15A and IC15B differ in pins 1-4. LM13700 is not pin-compatible, and TI's DIP version is obsolete. | [OML BA662 clone](http://www.openmusiclabs.com/projects/ba662-clone/); [subatomicglue BA662 analysis](https://www.subatomicglue.com/x0xl0g/ba662a-analysis/); [diystompboxes thread](https://www.diystompboxes.com/smfforum/index.php?msg=950824) |
| **LA4140** ×1, IC14 | **secondary market** | NOS or pulls only. It is not stocked at Mouser or LCSC. | Headphone amplifier only. | Nothing pin-compatible is current. A modern amplifier would need a SIP9 adapter (2.54 mm pitch). | [midibox thread](https://forum.midibox.org/t/x0xb0x-rare-parts/9689) |
| **AN6562** ×2, IC11 IC23 | substitute, **new** | **TI LM358P** (Mouser 39,792). | Panasonic's datasheet calls the AN6562 the AN1358, a 358-class dual op-amp whose input range reaches 0 V. A midibox builder reported that LM358 works. A 4558 is a different class. | Drop-in: standard DIP-8 dual op-amp pinout, confirmed from the board symbol. | [AN6562 datasheet](https://html.alldatasheet.com/html-pdf/13277/PANASONIC/AN6562S/406/1/AN6562S.html); [midibox](https://forum.midibox.org/t/x0xb0x-rare-parts/9689) |
| **2SK30A** ×2, Q28 (O) and Q39 (Y) | substitute, **chips on the board** (owner's choice) | [SC-59 sites](../kicad-working/smd-sites/README.md) on the mainboard: **Toshiba 2SK208-O** as Q128 and **2SK208-Y** as Q139 (Mouser 9,313 / 9,454). QNHCHIP 2SK30A-Y/-GR clones from LCSC (960 / 1,140) remain the alternative, in the original holes. | The two datasheets give the same ratings and characteristics line by line; nothing was measured. midibox says the Y grade at Q39 matters most. | Fit a chip or its TO-92 part, never both. 2N5457 and J201 have a different pin order and Idss. | [pedalpcb thread](https://forum.pedalpcb.com/goto/post?id=319954); [midibox p.4](https://forum.midibox.org/t/x0xb0x-rare-parts/9689?page=4); [LCSC 2SK30A](https://www.lcsc.com/search?q=2SK30A) |
| **2SC536F** ×24 | substitute, **new** | **onsemi KSC1815YTA** or **KSC945CYTA**. Both are E-C-B with hFE 120-240. Toshiba 2SC1815-GR (200-400) is on the LCSC marketplace. | The community group buys listed 2SC945P as the 2SC536F alternative. A 2008 batch had "totally wrong" hFE, so measure. Match Q3/Q4 (VCA pair), and preferably the VCF ladder too. | Drop-in E-C-B, **but the KSC945 needs the -C suffix**: plain KSC945 is E-B-C (onsemi datasheet). Q17, Q19 and Q23 sit on an uneven footprint (E pad 3.30 mm out), so bend the leads. | [onsemi KSC945](https://www.onsemi.com/pdf/datasheet/ksc945-d.pdf), [onsemi KSC1815](https://www.onsemi.com/pdf/datasheet/ksc1815-d.pdf); [midibox p.4-5](https://forum.midibox.org/t/x0xb0x-rare-parts/9689?page=5) |
| **2SA733P** ×10 | substitute, **new** | **onsemi KSA992FTA** (E-C-B, hFE 300-600, 101k stock). Alternative: MCC 2SA1015-GR-AP (E-C-B, 200-400, EOL). Renesas 2SA733 old stock is on the LCSC marketplace (minimum 100). | A 2008 batch of 2SA733P measured hFE 340-350 (midibox), so KSA992F is the closest gain grade. Its 120 V / 50 mA rating is fine for small-signal use. Match Q1/Q2. | Drop-in E-C-B. Check the flat side against the silkscreen. | [onsemi KSA992](https://www.onsemi.com/pdf/datasheet/ksa992-d.pdf); [midibox p.5](https://forum.midibox.org/t/x0xb0x-rare-parts/9689?page=5) |
| **Grayhill 25LB22-H** ×2 | in stock | Original part: Mouser 60 in stock at $33.63 each. | Same part. | Same part. There is no bracket, so holes MT1-MT4 take only the anchor wire (check 15 below). | [Mouser](https://www.mouser.com/c/?q=25LB22-H) |
| **Kobiconn 154-2442-E** ×1 | substitute, **new** | **Amphenol FCI 61729-0010BLF** (Mouser 24,974). | Same USB-B pinout. | The board footprint is literally named PN61729, so this is the footprint's own part. | [Mouser](https://www.mouser.com/ProductDetail/Amphenol-FCI/61729-0010BLF) |
| **Neutrik/REAN NYS216** ×3 | substitute (original backordered) | Original part: Mouser 0 in stock with 6,800 on order. NYS216-U has 801 in stock at Mouser. | Same part. | Check the NYS216-U pin layout against REAN_1_4STERO before choosing it instead. | [Mouser](https://www.mouser.com/c/?q=NYS216) |
| **CUI SDS-50J / MJ-3536N / PJ-202AH** | in stock | Originals, now sold under the Same Sky name: 20,799 / 7,424 / 3,610 in stock. | Same parts. | Same parts. | [Mouser SDS-50J](https://www.mouser.com/ProductDetail/Same-Sky/SDS-50J) |
| **TL1100F160Q** ×23 | in stock | Original part: Mouser 3,126 in stock. Caps are C&K PEWH/PEBK (Mouser 611-PEWH 2,338, 611-PEBK 1,999). | Same part. | Same part. | [Mouser](https://www.mouser.com/c/?q=TL1100F160Q); [Digi-Key PEWH](https://www.digikey.com/en/products/detail/c-k/PEWH/417706) |
| **STD240B spacers** ×40 | substitute | Bivar ELM 1-240 (Mouser 9,900): 5.1 mm OD, 6.1 mm long, lead slots on 2.54 mm, black, as the original. Essentra LEDS2M-240-01 is Non-Stocked at Mouser. | Mechanical only. | Length sets the LED height under the panel. Keep it at 6.10 mm. | repo `docs/led-spacer-completion.json` |
| **Xicon PM/PF film caps** ×21 | substitute | WIMA MKS2 100 V for the 5.08 mm positions (MKS2D021001A00KSSD: Mouser 9,735). Use WIMA MKS02 (2.5 mm pitch, 63 V or 250 V at Mouser) with spread leads for the 3.56-4.06 mm positions. Mouser has no 2.5 mm film part at 1000 pF or 0.018 uF, so those lines use KEMET C0G ceramics. Use WIMA MKS4 (7.5 mm) for C35 and C45. | Metallized polyester, like the original. | **Pitch changes**. 13 positions have holes 3.556, 3.81 or 4.064 mm apart, so a rigid 5 mm box cap does not fit there. | [WIMA MKS 2](https://www.wima.de/wp-content/uploads/media/e_WIMA_MKS_2.pdf) |
| **Xicon XRL electrolytics** ×39 | in stock (EOL) / in stock | KEMET ESK (5 x 11 and 6.3 x 11 mm), Nichicon UVR1A102MPD / UVR1C222MHD and Panasonic ECA-1CM470, all at Mouser. Farnell marked ESK No Longer Manufactured on 2026-10-17; Mouser shows no such mark. | Same values and can sizes as the original. | Same as the original: 2.0 mm factory lead spacing formed to the 2.54 mm holes. C17 is on 3.556 mm. Check C3/C5 height (12.5 x 20 mm). | [Farnell ESK105M050AC3AA](https://uk.farnell.com/search?st=ESK105M050AC3AA) |
| **Micro-Ohm LPTC12T21001 PTC** ×2 | substitute | TE LT7330002A1K0JTE (LT73: 1k 5%, 3000 ppm/C, 0805; Mouser 3,645, End of Life, obsolete at TE). Panasonic ERA-S33J102V (1k, +3300 ppm/K) is End of Life with restricted availability at Mouser. | The original's TC is +3000 ppm/K (T2 code in the Micro-Ohm datasheet). A different TC shifts the VCO's temperature tracking. | SMD needs wire tails across 10.16 mm pads. A through-hole part fits if it is 1/4 W size. | repo Micro-Ohm PDF; [OML tempco article](http://www.openmusiclabs.com/2015/03/temperature-compensation-of-analog-exponential-converters/); [Electrokit 1k 3500 ppm](https://www.electrokit.com/ptc-motstand-1kohm-3500ppm) |
| **FT232BM** ×1 | **hunt** | FT232BL (the pin-compatible lead-free B-series part). Mouser lists it as obsolete. LCSC marketplace has 304 at about $105 or 710 reels at about $45. | Same function. | Same LQFP-32 package. FT232R/RL is **not** pin-compatible. | [Mouser FT232BM](https://www.mouser.com/ProductDetail/FTDI/FT232BM); [LCSC](https://www.lcsc.com/search?q=FT232BL) |

## Check against the KiCad footprints before ordering

These substitutes change the pitch, body size or pinout, or need a mechanical check:

1. **Film caps (lines 35-43):** 13 positions have holes closer than 5 mm. These are C34, C100 and C101 (3.556 mm), C47 (3.81 mm), and C10, C20, C21, C33, C46, C18, C19, C24, C36 and C201 (4.064 mm). C35 and C45 are on 7.62 mm and need 7.5 mm parts. Only C25, C27, C41, C26 and C54 take 5 mm parts as-is.
2. **SOT-363 chips (lines 61-62):** solder them before any neighbour: 0.65 mm pitch, pin 1 at the silkscreen dot. Fit a chip or its SIP part, never both. The figures here come from illustrative models. R100A's model touches Q126's top corner, reaching 0.09 mm over it, so this depends on the PTC chosen in line 26; keep R100A from pressing on the chip. Q121's land ends 0.07 mm from R110, and Q126's lands 0.07 mm from R100A. C18 reaches 0.31 mm over Q112, 0.41 mm above it, and Q23 reaches 0.5 mm over Q122, 2.09 mm above it.
3. **2SK208 (line 60):** since KiCad revision 30 the mainboard has SC-59 sites for it, Q128 and Q139, routed on the board. Pin 1 is the source, at the silkscreen dot; 2 drain, 3 gate. Take the O grade for Q128 and the Y grade for Q139. Solder them before their neighbours and fit a chip or its TO-92 part, never both. Q128 stands between R105 and C33: in the illustrative models its gate land ends 0.08 mm from R105's body and the chip's body 0.26 mm from it, so stand R105 straight.
4. **Transistors (lines 58-59):** onsemi KSA992 and KSC1815 are 1 emitter, 2 collector, 3 base, leads formed to 2.54 mm, matching the footprint and its flat side. KSC945 only with the **-C** suffix.
5. **9 mm pots (lines 31-32):** Bourns PTV09A has the same pin plan as the original Panasonic EVU: 2.5 mm pins, 7.0 mm behind tabs 10.6 mm apart. The board's holes are 9.144 mm apart, so a tab corner is about 0.2 mm tight, against 0.34 mm for the original: press or nudge the tabs in. The 25 mm shafts have the 450-series knob's 6 mm D flat, and stand 11.5 mm above the panel, as the dual pots do.
6. **Encoder (line 90):** the footprint is named Bourns PEC11, but the CTS 290 drawing fits it: all 7 pins and tabs, smallest margin 0.07 mm. PEC11R is cheaper at Mouser, with 24 detents instead of 20.
7. **78L06 (line 76):** TI UA78L06ACLP is 1 output, 2 common, 3 input, which matches the nets on the IC21 pads.
8. **Trimmers (lines 27-28):** these use Bourns 3362P, because Mouser has no CT-6EP202 or CT-6EP502. Its pin triangle matches the 306 footprint, from the Bourns drawing. Its 6.60 x 6.99 mm body reaches C8's 6.3 mm can by 0.17 mm at TM6, so form C8 0.3 mm away.
9. **Electrolytics:** 5 mm cans have 2.0 mm leads, which must be formed to 2.54 mm (as with XRL). C17 is on 3.556 mm. C3/C5 are 12.5 x 20 mm, with 4.37 mm of headroom under the case and 0.28 mm between them at nominal size, as on the original board.
10. **Resonators (lines 79-80):** Murata CSTLS leads at 2.5 mm are 0.04 mm from the 2.54 mm holes, so they fit.
11. **IC sockets (lines 81-82):** Mill-Max machined sockets sit lower than the 5.1 mm TE ladder socket. This only matters for the chip-top height.
12. **LED spacers (line 57):** Bivar ELM 1-240 is 6.1 mm long with lead slots on 2.54 mm, from its drawing. Keep that length, or the LED height under the panel changes.
13. **PTC (line 26):** an 0805 chip on wire tails across the 10.16 mm pads. Its TC matches the original at 3000 ppm/C, from the TE datasheet.
14. **NYS216-U (line 84):** REAN lists it as the same jack as NYS216, with washer and nut not assembled, so it fits the same footprint.
15. **S3 anchor wire (lines 91 and 99):** S3's holes MT1 and MT4 are on analog ground and MT2 and MT3 on digital. Use two separate wires, MT1-MT4 and MT2-MT3. A diagonal, or one wire through all four holes, joins the two grounds on the mainboard and breaks the star ground. S4's holes are all analog, so its route does not matter. See `../x0xb0x-si-emc/REPORT.md` §6.1.
16. **Optional capacitors (lines 111-114):** these come from the [signal-integrity study](../../x0xb0x-si-emc/REPORT.md), section 1.2, and are not in the original design. They join existing pads, with formed leads. Only the pad spacing was checked, not how they fit. A scope check on the built board decides whether the 100 pF and 1 nF are needed: IC9 pin 8 against IC3 pin 20, and IC9 pin 9 against pin 8, while the sequencer plays rests.
17. **R16 (line 115):** 150 ohm, chosen by the owner on 2026-11-05. The KiCad board's value field and the BOM PDF still say 100 ohm, and the original parts page gives 150 ohm for newer kits. It uses the same pads. The [signal-integrity study](../../x0xb0x-si-emc/REPORT.md), section 12.5, explains the MIDI IN margin; that is a model, so check MIDI IN on the built board.

## Open questions for the owner

- **Q1 R106:** the BOM PDF and the parts page say 24K 1%, but the PCB says 27K. Which value do you want? Both are in the order.
- **Q2 Rare-part strategy:** decided for the 2SC1583 and 2SC2291: SOT-363 chips on the mainboard, KiCad revision 29 (lines 61-62). Decided for the 2SK30A: SC-59 chips, KiCad revision 30 (line 60). Still open for the BA6110: pulls, or the OML clone in IC15A? The LA4140 is Q6.
- **Q3 FT232:** for the Rust firmware test, is USB needed? MIDI plus ISP programming would avoid the scarce FT232BL (about $45-105).
- **Q4 Pots:** settled by the datasheet check: Bourns PTV09A for the five singles and RV112BCF-40-25A-B50K for the B50K dual (lines 31-33). Audio taper replaces the original D, which nobody makes now.
- **Q5 Gain matching:** will you hFE-match the transistors (Q1/Q2, Q3/Q4, the VCF ladder)? If so, buy extras: about 40 NPN, 20 PNP and 10 of each JFET grade.
- **Q6 LA4140:** do you need it for the first bring-up? It only drives the headphone jack.
- **Q7 EEPROM:** the 25LC320A replaces the CAT25C33. Does the firmware's page-write length (and any status-register use) match the 25LC320A datasheet?
- **Q8 Board-to-board jumpers:** the BOM's Digi-Key codes WM09-06 / WM06-06 / WM03-06 could not be resolved. Would 0.1 in ribbon or wire for the 24 conductors be acceptable?
- **Q9 Panels and case:** the panels are settled: FR-4 at a PCB fab, [KiCad project here](../kicad-working/panels/README.md), line 101. Case colour: black, chosen 2026-11-06 (line 100).
- **Q10 Ordering region:** do you order from Mouser US, Farnell UK or LCSC? Stock differs by region. The adapter must be 9 V **AC** for your mains.

## Limits of this check

- Mouser stock and prices on 2026-11-05 cover about 110 part numbers, read in a browser session with no bot check.
- On 2026-10-17 Mouser, Digi-Key, TME and later Farnell put up bot checks or CAPTCHAs. I did not try to get around them.
- Generic hardware was not checked. The substitutes in lines 26-28, 31-33, 35-39, 41, 43, 44, 57 and 95 were compared on paper with their datasheets or Mouser's listed dimensions and with the board's footprints on 2026-11-05. Nothing has been fitted. Knob bore depth was not found.
- Digi-Key numbers in the original BOM were not re-checked.
- LCSC "Other Suppliers" offers are marketplace stock with long lead times.
- "In stock" is distributor stock on 2026-11-05, not a guarantee. LCSC, Digi-Key and Farnell figures that remain are older.
