cozycactus/x0xb0x-hardware/parts/x0xb0x-parts-order.csv

line | section | description | qty | references | original_part | footprint | proposed_mfr | proposed_mpn | distributor_pn | availability | status | fit_flag | notes | sources
1 | Resistors | 10 ohm 5% resistor | 2 | R164 R186 | Generic 5% (BOM) | 0207 axial, mounted standing; pads 5.08 mm apart, 1.0 mm drill | YAGEO | MFR-25FBF52-10R | Mouser 603-MFR-25FBF52-10R | Mouser 35,242 at $0.10. Read 2026-11-05 | in stock | none | 1/4 W 1% metal film, body 2.4 x 6.3 mm (Mouser parametrics); one family for every value. | https://www.mouser.com/c/?q=MFR-25FBF52-10R
2 | Resistors | 22 ohm 5% resistor | 2 | R20 R150 | Generic 5% (BOM) | 0207 axial, mounted standing; pads 5.08 mm apart, 1.0 mm drill | YAGEO | MFR-25FBF52-22R | Mouser 603-MFR-25FBF52-22R | Mouser 78,658 at $0.11. Read 2026-11-05 | in stock | none | 1/4 W 1% metal film, body 2.4 x 6.3 mm (Mouser parametrics); one family for every value. | https://www.mouser.com/c/?q=MFR-25FBF52-22R
3 | Resistors | 27 ohm 5% resistor | 2 | R6 R7 | Generic 5% (BOM) | 0207 axial, mounted standing; pads 5.08 mm apart, 1.0 mm drill | YAGEO | MFR-25FBF52-27R | Mouser 603-MFR-25FBF52-27R | Mouser 7,783 at $0.10. Read 2026-11-05 | in stock | none | 1/4 W 1% metal film, body 2.4 x 6.3 mm (Mouser parametrics); one family for every value. | https://www.mouser.com/c/?q=MFR-25FBF52-27R
4 | Resistors | 100 ohm 5% resistor | 6 | R1 R95 R130 R132 R136 R152 | Generic 5% (BOM) | 0207 axial, mounted standing; pads 5.08 mm apart, 1.0 mm drill | YAGEO | MFR-25FBF52-100R | Mouser 603-MFR-25FBF52-100R | Mouser 46,691 +40,000 on order at $0.10. Read 2026-11-05 | in stock | none | R16 is on line 115, at 150 ohm. The BOM PDF and the PCB say 100 ohm; the owner chose 150 ohm on 2026-11-05. | https://www.mouser.com/c/?q=MFR-25FBF52-100R
5 | Resistors | 220 ohm 5% resistor | 5 | R13 R14 R15 R18 R19 | Generic 5% (BOM) | 0207 axial, mounted standing; pads 5.08 mm apart, 1.0 mm drill | YAGEO | MFR-25FBF52-220R | Mouser 603-MFR-25FBF52-220R | Mouser 6,873 +10,000 on order at $0.10. Read 2026-11-05 | in stock | none | 1/4 W 1% metal film, body 2.4 x 6.3 mm (Mouser parametrics); one family for every value. | https://www.mouser.com/c/?q=MFR-25FBF52-220R
6 | Resistors | 470 ohm 5% resistor | 1 | R12 | Generic 5% (BOM) | 0207 axial, mounted standing; pads 5.08 mm apart, 1.0 mm drill | YAGEO | MFR-25FBF52-470R | Mouser 603-MFR-25FBF52-470R | Mouser 4,633 +10,000 on order at $0.11. Read 2026-11-05 | in stock | none | 1/4 W 1% metal film, body 2.4 x 6.3 mm (Mouser parametrics); one family for every value. | https://www.mouser.com/c/?q=MFR-25FBF52-470R
7 | Resistors | 1K 5% resistor | 4 | R2 R17 R137 R161 | Generic 5% (BOM) | 0207 axial, mounted standing; pads 5.08 mm apart, 1.0 mm drill; R137/R232 lie flat on 10.16 mm, R234 on 15.24 mm | YAGEO | MFR-25FBF52-1K | Mouser 603-MFR-25FBF52-1K | Mouser 45,172 +130,000 on order at $0.10. Read 2026-11-05 | in stock | none | 1/4 W 1% metal film, body 2.4 x 6.3 mm (Mouser parametrics); one family for every value. | https://www.mouser.com/c/?q=MFR-25FBF52-1K
8 | Resistors | 1.5K 5% resistor | 1 | R8 | Generic 5% (BOM) | 0207 axial, mounted standing; pads 5.08 mm apart, 1.0 mm drill | YAGEO | MFR-25FBF52-1K5 | Mouser 603-MFR-25FBF52-1K5 | Mouser 13,163 +10,000 on order at $0.12. Read 2026-11-05 | in stock | none | 1/4 W 1% metal film, body 2.4 x 6.3 mm (Mouser parametrics); one family for every value. | https://www.mouser.com/c/?q=MFR-25FBF52-1K5
9 | Resistors | 1.8K 5% resistor | 1 | R179 | Generic 5% (BOM) | 0207 axial, mounted standing; pads 5.08 mm apart, 1.0 mm drill | YAGEO | MFR-25FBF52-1K8 | Mouser 603-MFR-25FBF52-1K8 | Mouser 75,848 at $0.10. Read 2026-11-05 | in stock | none | 1/4 W 1% metal film, body 2.4 x 6.3 mm (Mouser parametrics); one family for every value. | https://www.mouser.com/c/?q=MFR-25FBF52-1K8
10 | Resistors | 2.2K 5% resistor | 19 | R21 R22 R23 R24 R67 R68 R69 R70 R71 R98 R104 R107 R108 R124 R125 R126 R133 R162 R178 | Generic 5% (BOM) | 0207 axial, mounted standing; pads 5.08 mm apart, 1.0 mm drill; R96 R97 R98 R115 standing on 2.54 mm pads (0207_2V) | YAGEO | MFR-25FBF52-2K2 | Mouser 603-MFR-25FBF52-2K2 | Mouser 18,395 +20,000 on order at $0.10. Read 2026-11-05 | in stock | At assembly: bend the leads for the 2.54 mm pads (R96 R97 R98 R115) | 1/4 W 1% metal film, body 2.4 x 6.3 mm (Mouser parametrics); one family for every value. | https://www.mouser.com/c/?q=MFR-25FBF52-2K2
11 | Resistors | 4.7K 5% resistor | 2 | R9 R135 | Generic 5% (BOM) | 0207 axial, mounted standing; pads 5.08 mm apart, 1.0 mm drill | YAGEO | MFR-25FBF52-4K7 | Mouser 603-MFR-25FBF52-4K7 | Mouser 10,110 +20,000 on order at $0.11. Read 2026-11-05 | in stock | none | 1/4 W 1% metal film, body 2.4 x 6.3 mm (Mouser parametrics); one family for every value. | https://www.mouser.com/c/?q=MFR-25FBF52-4K7
12 | Resistors | 6.8K 5% resistor | 1 | R3 | Generic 5% (BOM) | 0207 axial, mounted standing; pads 5.08 mm apart, 1.0 mm drill | YAGEO | MFR-25FBF52-6K8 | Mouser 603-MFR-25FBF52-6K8 | Mouser 11,462 +10,000 on order at $0.10. Read 2026-11-05 | in stock | none | 1/4 W 1% metal film, body 2.4 x 6.3 mm (Mouser parametrics); one family for every value. | https://www.mouser.com/c/?q=MFR-25FBF52-6K8
13 | Resistors | 10K 5% (40 of them are LED series resistors) resistor | 94 | R10 R11 R34 R36 R47 R61 R64 R65 R94 R96 R97 R101 R105 R109 R112 R115 R116 R142 R143 R144 R145 R148 R149 R157 R158 R160 R201-R234 R237-R270 | Generic 5% (BOM) | 0207 axial, mounted standing; pads 5.08 mm apart, 1.0 mm drill; R96 R97 R98 R115 standing on 2.54 mm pads (0207_2V); R137/R232 lie flat on 10.16 mm, R234 on 15.24 mm | YAGEO | MFR-25FBF52-10K | Mouser 603-MFR-25FBF52-10K | Mouser 110,107 +70,000 on order at $0.10. Read 2026-11-05 | in stock | At assembly: bend the leads for the 2.54 mm pads (R96 R97 R98 R115) | Parts page: the 40 LED resistors (R203 R204 ... R268) may change with LED type and brightness; 10K suits the diffused red LED in line 72. Order 100 (cut-tape price break). | https://www.mouser.com/c/?q=MFR-25FBF52-10K
14 | Resistors | 22K 5% resistor | 10 | R45 R60 R110 R111 R117 R120 R129 R134 R146 R151 | Generic 5% (BOM) | 0207 axial, mounted standing; pads 5.08 mm apart, 1.0 mm drill | YAGEO | MFR-25FBF52-22K | Mouser 603-MFR-25FBF52-22K | Mouser 6,224 +10,000 on order at $0.10. Read 2026-11-05 | in stock | none | 1/4 W 1% metal film, body 2.4 x 6.3 mm (Mouser parametrics); one family for every value. | https://www.mouser.com/c/?q=MFR-25FBF52-22K
15 | Resistors | 33K 5% resistor | 1 | R159 | Generic 5% (BOM) | 0207 axial, mounted standing; pads 5.08 mm apart, 1.0 mm drill | YAGEO | MFR-25FBF52-33K | Mouser 603-MFR-25FBF52-33K | Mouser 26,679 at $0.10. Read 2026-11-05 | in stock | none | 1/4 W 1% metal film, body 2.4 x 6.3 mm (Mouser parametrics); one family for every value. | https://www.mouser.com/c/?q=MFR-25FBF52-33K
16 | Resistors | 47K 5% resistor | 4 | R46 R119 R127 R155 | Generic 5% (BOM) | 0207 axial, mounted standing; pads 5.08 mm apart, 1.0 mm drill | YAGEO | MFR-25FBF52-47K | Mouser 603-MFR-25FBF52-47K | Mouser 9,325 +10,000 on order at $0.10. Read 2026-11-05 | in stock | none | 1/4 W 1% metal film, body 2.4 x 6.3 mm (Mouser parametrics); one family for every value. | https://www.mouser.com/c/?q=MFR-25FBF52-47K
17 | Resistors | 68K 5% resistor | 1 | R138 | Generic 5% (BOM) | 0207 axial, mounted standing; pads 5.08 mm apart, 1.0 mm drill | YAGEO | MFR-25FBF52-68K | Mouser 603-MFR-25FBF52-68K | Mouser 6,050 +10,000 on order at $0.12. Read 2026-11-05 | in stock | none | 1/4 W 1% metal film, body 2.4 x 6.3 mm (Mouser parametrics); one family for every value. | https://www.mouser.com/c/?q=MFR-25FBF52-68K
18 | Resistors | 100K 5% resistor | 24 | R25 R26 R27 R28 R35 R59 R66 R72 R73 R92 R93 R99 R102 R113 R114 R118 R122 R139 R140 R141 R153 R154 R156 R165 | Generic 5% (BOM) | 0207 axial, mounted standing; pads 5.08 mm apart, 1.0 mm drill | YAGEO | MFR-25FBF52-100K | Mouser 603-MFR-25FBF52-100K | Mouser 12,970 +70,000 on order at $0.10. Read 2026-11-05 | in stock | none | 1/4 W 1% metal film, body 2.4 x 6.3 mm (Mouser parametrics); one family for every value. | https://www.mouser.com/c/?q=MFR-25FBF52-100K
19 | Resistors | 220K 5% resistor | 8 | R62 R63 R103 R121 R128 R131 R235 R236 | Generic 5% (BOM) | 0207 axial, mounted standing; pads 5.08 mm apart, 1.0 mm drill | YAGEO | MFR-25FBF52-220K | Mouser 603-MFR-25FBF52-220K | Mouser 3,559 +10,000 on order at $0.10. Read 2026-11-05 | in stock | none | 1/4 W 1% metal film, body 2.4 x 6.3 mm (Mouser parametrics); one family for every value. | https://www.mouser.com/c/?q=MFR-25FBF52-220K
20 | Resistors | 1MEG 5% resistor | 2 | R91 R200 | Generic 5% (BOM) | 0207 axial, mounted standing; pads 5.08 mm apart, 1.0 mm drill | YAGEO | MFR-25FBF52-1M | Mouser 603-MFR-25FBF52-1M | Mouser 14,847 +50,000 on order at $0.10. Read 2026-11-05 | in stock | none | 1/4 W 1% metal film, body 2.4 x 6.3 mm (Mouser parametrics); one family for every value. | https://www.mouser.com/c/?q=MFR-25FBF52-1M
21 | Resistors | 2.4K 1% resistor | 1 | R5 | Generic 5% (BOM) | 0207 axial, mounted standing; pads 5.08 mm apart, 1.0 mm drill | YAGEO | MFR-25FBF52-2K4 | Mouser 603-MFR-25FBF52-2K4 | Mouser 18,733 at $0.10. Read 2026-11-05 | in stock | none | 1/4 W 1% metal film, body 2.4 x 6.3 mm (Mouser parametrics); one family for every value. | https://www.mouser.com/c/?q=MFR-25FBF52-2K4
22 | Resistors | 5.6K 1% resistor | 1 | R4 | Generic 5% (BOM) | 0207 axial, mounted standing; pads 5.08 mm apart, 1.0 mm drill | YAGEO | MFR-25FBF52-5K6 | Mouser 603-MFR-25FBF52-5K6 | Mouser 6,715 +10,000 on order at $0.10. Read 2026-11-05 | in stock | none | 1/4 W 1% metal film, body 2.4 x 6.3 mm (Mouser parametrics); one family for every value. | https://www.mouser.com/c/?q=MFR-25FBF52-5K6
23 | Resistors | 200K 1% resistor | 17 | R74-R90 | Generic 5% (BOM) | 0207 axial, mounted standing; pads 5.08 mm apart, 1.0 mm drill | YAGEO | MFR-25FBF52-200K | Mouser 603-MFR-25FBF52-200K | Mouser 500 +80,000 on order at $0.11. Read 2026-11-05 | in stock | none | 1/4 W 1% metal film, body 2.4 x 6.3 mm (Mouser parametrics); one family for every value. | https://www.mouser.com/c/?q=MFR-25FBF52-200K
24 | Resistors | 1.5MEG 5% resistor | 1 | R123 | Generic | 0207 axial, mounted standing; pads 5.08 mm apart, 1.0 mm drill | YAGEO | MFR-25FTE52-1M5 | Mouser 603-MFR-25FTE52-1M5 | Mouser 7,176 +5,000 on order at $0.11. Read 2026-11-05 | in stock | none | MFR-25FBF52-1M5 is not stocked (Mouser lists it non-stocked). Alternative KOA Speer MF1/4DCT52R1504F, Mouser 4,068 in stock. | https://www.mouser.com/c/?q=MFR-25FTE52-1M5 ; https://www.mouser.com/ProductDetail/KOA-Speer/MF1-4DCT52R1504F
25 | Resistors | 24K 1% resistor (BOM) / 27K on the PCB | 1 | R106 | Generic; BOM PDF and parts page 24.0K 1%, PCB value 27K | 0207 axial, mounted standing; pads 5.08 mm apart, 1.0 mm drill | YAGEO | MFR-25FBF52-24K (and MFR-25FBF52-27K) | Mouser 603-MFR-25FBF52-24K / -27K | Mouser 78,937 / 13,839 at $0.10. Read 2026-11-05 | in stock | none | Value conflict recorded in docs/expanded-bom-crosscheck.json; buy both (cents) and decide at assembly. Open question Q1. | https://www.mouser.com/c/?q=MFR-25FBF52-24K ; kicad-working/validation/expanded-bom-review/sources/x0x-billofmaterials-adawiki-user-print.pdf
26 | Resistors | 1K PTC thermistor (VCO tempco) | 2 | R100A R100B | Micro-Ohm LPTC12T21001 (1/6 W, 1k, T2 = +3000 ppm/K) | R-7,5: axial, pads 10.16 mm apart, 1.0 mm drill; original body 3.7 x 1.9 mm | TE Connectivity | LT7330002A1K0JTE (LT73, 3000, 1K0, 5%, SMD) | Mouser 279-LT7330002A1K0JTE | Mouser 3,645 at $1.22, End of Life. ERA-S33J102V (667-ERA-S33J102V): Restricted Availability, End of Life. Read 2026-11-05 | substitute | At assembly: an 0805 chip on wire tails across the 10.16 mm pads | TE LT73 datasheet: 3000 ppm/C +/-10%, 0805 (2.0 x 1.25 mm), 1K0 +/-5%, 0.1 W, -40 to +125 C. That is the original's +3000 ppm/K. TE lists this part as obsolete and Mouser as End of Life, so buy spares. Solder wire tails to it to span the 10.16 mm pads. Recheck tuning drift after warm-up. | kicad-working/validation/models-review-20/ptc-quality/sources/micro-ohm-precision-film-sensor-user.pdf ; https://www.lcsc.com/search?q=ERA-S33J102V ; https://www.electrokit.com/ptc-motstand-1kohm-3500ppm ; http://www.openmusiclabs.com/2015/03/temperature-compensation-of-analog-exponential-converters/
27 | Trimmers & pots | 2K (202) trim potentiometer | 1 | TM6 | Vishay CT6EP202 (Digi-Key 306UC202B) | 306: 3 pads in a triangle (1 and 3 at 5.08 mm, wiper 2.54 mm offset), 6.4 x 6.4 mm outline | Bourns | 3362P-1-202LF | Mouser 652-3362P-1-202LF | Mouser 151 +6,750 on order at $1.25. CT-6EP202 (229-CT-6EP202): 0. Read 2026-11-05 | substitute | At assembly: the body corner reaches C8's 6.3 mm can by 0.17 mm. Form C8 0.3 mm away from TM6 | Bourns drawing: pins 1 and 3 are 5.08 mm apart and pin 2 is 2.54 mm off that line, the same as the 306 footprint in the same orientation. Body 6.60 x 6.99 x 4.88 mm. Tin-plated LF terminals. | https://www.mouser.com/ProductDetail/Nidec-Components/CT-6EP202 ; https://uk.farnell.com/search?st=3362P-1-503LF
28 | Trimmers & pots | 5K (502) trim potentiometer | 1 | TM5 | Vishay CT6EP502 (Digi-Key 306UC502B) | 306: 3 pads in a triangle (1 and 3 at 5.08 mm, wiper 2.54 mm offset), 6.4 x 6.4 mm outline | Bourns | 3362P-1-502 (or CT-6EP502 / 3362P-1-502LF when they arrive) | Mouser 652-3362P-1-502 | Mouser 194 at $1.68, not the LF part. CT-6EP502 (229-CT-6EP502): 0 +7,000 on order. 3362P-1-502LF: 0 +23,500 on order. Read 2026-11-05 | substitute | none | Bourns drawing: the same pin triangle as the 306 footprint. TM5 clears its neighbours: the nearest is a pad 0.19 mm from the body. This part has tin/lead terminals; the LF version is on order. | https://www.mouser.com/ProductDetail/Nidec-Components/CT-6EP502 ; https://uk.farnell.com/search?st=3362P-1-503LF
29 | Trimmers & pots | 50K (503) trim potentiometer | 1 | TM4 | Vishay CT6EP503 (Digi-Key 306UC503B) | 306: 3 pads in a triangle (1 and 3 at 5.08 mm, wiper 2.54 mm offset), 6.4 x 6.4 mm outline | Nidec Copal | CT-6EP503 | Mouser 229-CT-6EP503 | Mouser 887 at $1.10. Read 2026-11-05 | in stock | none | CT-6EP is the same 6 mm top-adjust family as the BOM part (Vishay/Copal CT6EP). Parts page: any ceramic trimmer with the same pinout is OK. | https://www.mouser.com/ProductDetail/Nidec-Components/CT-6EP503 ; https://uk.farnell.com/search?st=3362P-1-503LF
30 | Trimmers & pots | 500K (504) trim potentiometer | 1 | TM3 | Vishay CT6EP504 (Digi-Key 306UC504B) | 306: 3 pads in a triangle (1 and 3 at 5.08 mm, wiper 2.54 mm offset), 6.4 x 6.4 mm outline | Nidec Copal | CT-6EP504 | Mouser 229-CT-6EP504 | Mouser 199 at $1.10. Read 2026-11-05 | in stock | none | CT-6EP is the same 6 mm top-adjust family as the BOM part (Vishay/Copal CT6EP). Parts page: any ceramic trimmer with the same pinout is OK. | https://www.mouser.com/ProductDetail/Nidec-Components/CT-6EP504 ; https://uk.farnell.com/search?st=3362P-1-503LF
31 | Trimmers & pots | 50K D (log) potentiometer | 3 | VR3 VR5 VR8 | Panasonic EVU-F2LFL3D54 (Digi-Key P3L2503) | EVU: 3 pins at 2.5 mm pitch, pin row 7.0 mm behind two mounting lugs 9.144 mm apart (2.18 mm drill); 9.6 x 12.5 mm outline | Bourns | PTV09A-5025F-A503 (audio taper, 6 mm D shaft, 25 mm, plastic bushing) | Mouser 652-PTV09A-5025FA503 | Mouser 831 at $1.75. Alpha RV09AF-40-20K-A54 (317-2080F-50K) 620 at $1.32 has a knurled shaft, which does not suit the D knob. EVU-F2LFL3D54: Obsolete. Read 2026-11-05 | substitute | none | Compared with the Bourns PTV09 and Panasonic EVU drawings: same 2.5 mm pins, pin row 7.0 mm behind the tabs, tabs 10.6 mm apart. The board holes are 9.144 mm apart at 2.18 mm, so a tab corner is about 0.2 mm tight, against 0.34 mm for the original pot: press or nudge the tabs in. Shaft 25 mm from the board with a 12 mm flat, the same height as the dual pots VR4 and VR6 and 5 mm shorter than the original singles. It stands 11.5 mm above the panel, which is 13.5 mm from the board. The 7.9 mm bushing passes the 9.35 mm panel hole. Audio is the nearest taper to the original D. | https://www.mouser.com/c/?q=EVU-F2LFL3D54
32 | Trimmers & pots | 50K B (linear) potentiometer | 2 | VR2 VR7 | Panasonic EVU-F2LFL3B54 (Digi-Key P3K1503) | EVU: 3 pins at 2.5 mm pitch, pin row 7.0 mm behind two mounting lugs 9.144 mm apart (2.18 mm drill); 9.6 x 12.5 mm outline | Bourns | PTV09A-4025F-B503 (linear, 6 mm D shaft, 25 mm) | Mouser 652-PTV09A-4025FB503 | Mouser 1,040 at $0.89. EVU-F2LFL3B54: Obsolete. Read 2026-11-05 | substitute | none | Compared with the Bourns PTV09 and Panasonic EVU drawings: same 2.5 mm pins, pin row 7.0 mm behind the tabs, tabs 10.6 mm apart. The board holes are 9.144 mm apart at 2.18 mm, so a tab corner is about 0.2 mm tight, against 0.34 mm for the original pot: press or nudge the tabs in. Shaft 25 mm from the board with a 12 mm flat, the same height as the dual pots VR4 and VR6 and 5 mm shorter than the original singles. It stands 11.5 mm above the panel, which is 13.5 mm from the board. | https://www.mouser.com/c/?q=EVU-F2LFL3B54
33 | Trimmers & pots | 50K B (linear) dual potentiometer | 1 | VR4 | Alpha RV112BCF-40-25F-B54 (Mouser 317-2202-50K) | ALPHADUAL: 6 pins in one row at 2.0 mm pitch, row 11 mm behind two lugs 11 mm apart (2.18 mm drill); 13 x 17.6 mm outline | Alpha (Taiwan) | RV112BCF-40-25A-B50K (11 mm linear 50K dual, 6 mm D shaft, 25 mm) | Mouser 317-2202F-50K | Mouser 135 at $2.49. Read 2026-11-05 | substitute | none | Alpha catalog and Mouser: RV112BCF-40 family with a 6 mm D shaft, 25 mm, the same pins and tabs as line 34. Open question Q4 is settled. | https://www.mouser.com/c/?q=RV112BCF-40-25F-B54
34 | Trimmers & pots | 1Meg A (log) dual potentiometer | 1 | VR6 | Alpha RV112BCF-40-25F-A16 (Mouser 317-2102-1M) | ALPHADUAL: 6 pins in one row at 2.0 mm pitch, row 11 mm behind two lugs 11 mm apart (2.18 mm drill); 13 x 17.6 mm outline | Alpha (Taiwan) | RV112BCF-40-25F-A16 | Mouser 317-2102F-1M | Mouser 1,276 at $2.49. Read 2026-11-05 | in stock | none | Original part number still active. | https://www.mouser.com/ProductDetail/Alpha-Taiwan/RV112BCF-40-25F-A16
35 | Capacitors - film | .001uF (2A102K) polyester capacitor | 3 | C34 C100 C101 | Xicon PM2A102K | C050-035X075: pads 3.556 mm apart, 5.08 x 2.54 mm outline | KEMET | C320C102J1G5TA (1000 pF C0G ceramic, 100 V, 2.54 mm) | Mouser 80-C320C102J1G | Mouser 2,418 at $0.52. WIMA MKS02 at 1000 pF: not found at Mouser. FKP2D011001D00HO00 film 5,979 at $0.68 needs 5 mm. Read 2026-11-05 | substitute | none | Ceramic C0G in place of polyester, because Mouser has no 2.5 mm film part at this value. Body 5.08 x 3.18 mm, 0.64 mm wider than the outline and clear of its neighbours. Pads are 3.556 mm apart: spread the leads. | https://www.mouser.com/c/?q=PM2A102K ; https://www.wima.de/wp-content/uploads/media/e_WIMA_MKS_2.pdf
36 | Capacitors - film | .0068uF (2A682K) polyester capacitor | 1 | C47 | Xicon PF2A682K | C050-075X075: pads 3.81 mm apart, 5.46 x 3.05 mm outline | WIMA | MKS0F016800B00MSSD (6800 pF, 250 V, 2.5 mm) | Mouser 505-MKS026800/250/20 | Mouser 513 at $0.84, marked Factory Special Order. Read 2026-11-05 | substitute | none | Body 4.6 x 2.5 x 7 mm, inside the outline. Pads are 3.81 mm apart: spread the leads. | https://www.mouser.com/c/?q=PF2A682K ; https://www.wima.de/wp-content/uploads/media/e_WIMA_MKS_2.pdf
37 | Capacitors - film | .01uF (2A103K) polyester capacitor | 5 | C10 C20 C21 C33 C46 | Xicon PM2A103K | C050-024X044: pads 4.064 mm apart, 6.10 x 3.30 mm outline | WIMA | MKS0C021000B00JSSD (0.01 uF, 63 V, 5%, 2.5 mm) | Mouser 505-MKS02.01/63/5 | Mouser 5,478 at $1.13, marked Factory Special Order. Read 2026-11-05 | substitute | none | Body 4.6 x 2.5 x 7 mm, inside the outline. Pads are 4.064 mm apart: spread the leads. 63 V is enough on 12 V rails. A 7.2 mm MKS2 would overrun the outline. | https://uk.farnell.com/search?st=MKS2D021001A00KSSD ; https://www.wima.de/wp-content/uploads/media/e_WIMA_MKS_2.pdf
38 | Capacitors - film | .018uF (2A183K) polyester capacitor | 1 | C18 | Xicon PF2A183K | C050-025X075: pads 4.064 mm apart, 6.35 x 3.56 mm outline | KEMET | C320C183J1G5TA (0.018 uF C0G ceramic, 100 V, 2.54 mm) | Mouser 80-C320C183J1G5TA | Mouser 356 at $0.68. Film with 5 mm leads: R82EC2180SH50J 52,973 at $0.34. Read 2026-11-05 | substitute | none | Ceramic C0G in place of polyester, because Mouser has no 2.5 mm film part at this value; 5% against the original 10%. Pads are 4.064 mm apart. C18 is beside Q112: this 5.08 x 3.18 mm body clears the chip by 0.1 mm and its lands by 0.25 mm, where the model of the original overhung it. | https://www.mouser.com/c/?q=PF2A183K ; https://www.wima.de/wp-content/uploads/media/e_WIMA_MKS_2.pdf
39 | Capacitors - film | .033uF (2A333K) polyester capacitor | 5 | C19 C24 C26 C36 C201 | Xicon PM2A333K | C050-025X075 (C19 C24 C36 C201): 4.064 mm; C075-032X103 (C26): 5.08 mm | WIMA | MKS2D023301A00KSSD (C26) + MKS0C023300B00KSSD (others, 2.5 mm, 63 V, 10%) | Mouser 505-MKS2.033/100/10 (C26); 505-MKS0C023300BKSSD (others) | Mouser 9,706 at $0.61 (C26); 2,698 at $0.81 (others). Read 2026-11-05 | substitute | none | C26 has 5.08 mm pads and takes the 5 mm MKS2. The others have 4.064 mm pads: spread the leads of the 4.6 x 2.5 x 7 mm body. 10% matches the original. 63 V is enough on 12 V rails. | https://www.mouser.com/c/?q=PM2A333K ; https://www.wima.de/wp-content/uploads/media/e_WIMA_MKS_2.pdf
40 | Capacitors - film | .047uF (2A473K) polyester capacitor | 1 | C54 | Xicon PM2A473K | C050-055X075: pads 5.08 mm apart, 7.37 x 4.32 mm outline | WIMA | MKS2D024701A00KSSD (2.5 x 6.5 x 7.2 mm, 5 mm) | Mouser 505-MKS2.047/100/10 | Mouser 10,123 at $0.62. Read 2026-11-05 | substitute | none | 5 mm pins fit 5.08 mm holes. | https://www.mouser.com/c/?q=PM2A473K ; https://www.wima.de/wp-content/uploads/media/e_WIMA_MKS_2.pdf
41 | Capacitors - film | .068uF (2A683K) polyester capacitor | 1 | C45 | Xicon PF2A683K | C050-050X075: pads 7.62 mm apart, 8.89 x 5.08 mm outline | WIMA | MKS4D026802A00KSSD (0.068 uF, 100 V, 7.5 mm) | Mouser 505-MKS4.068/100/10 | Mouser 515 +5,000 on order at $0.95. MKS4D026803C00KSSD (505-MKS4.068/100/10P) 2,710 at $0.67. Read 2026-11-05 | substitute | none | Pitch confirmed at 7.5 mm for the 7.62 mm pads. The 10 mm body overruns the 8.89 mm outline, and it clears its nearest neighbour C47 by 1.1 mm. | https://www.mouser.com/c/?q=PF2A683K
42 | Capacitors - film | .1uF (2A104K) polyester capacitor | 3 | C25 C27 C41 | Xicon PM2A104K | C050-030X075: pads 5.08 mm apart, 8.13 x 5.08 mm outline | WIMA | MKS2D031001A00KSSD (2.5 x 6.5 x 7.2 mm, 5 mm) | Mouser 505-MKS2.1/100/10 | Mouser 9,619 at $0.58. Read 2026-11-05 | substitute | none | 5 mm pins fit 5.08 mm holes. | https://www.mouser.com/c/?q=PM2A104K ; https://www.wima.de/wp-content/uploads/media/e_WIMA_MKS_2.pdf
43 | Capacitors - film | .22uF (2A224K) polyester capacitor | 1 | C35 | Xicon PM2A224K | C050-045X075: pads 7.62 mm apart, 11.43 x 6.35 mm outline | WIMA | MKS4D032202B00KSSD (0.22 uF, 100 V, 7.5 mm) | Mouser 505-MKS4.22/100/10 | Mouser 8,288 at $0.60. MKS4D032203C00KSSD (505-MKS4.22/100/10P) 2,067 at $0.67. Read 2026-11-05 | substitute | none | Pitch confirmed at 7.5 mm for the 7.62 mm pads. Body 10 x 3 x 8.5 mm, inside the outline. | https://www.mouser.com/c/?q=PM2A224K
44 | Capacitors - ceramic/tantalum | .1uF (104) ceramic capacitor | 16 | C1 C2 C4 C6 C103 C104 C106 C107 C108 C109 C110 C111 C112 C113 C202 C204 | AVX SR205E104MAR (Mouser 581-SR205E104M) | C050H075X075: pads 2.54 mm apart, 4.57 x 2.54 mm outline | KYOCERA AVX | SR205E104MARAP1 (the same part, ammo packaging) | Mouser 581-SR205E104MARAP1 | Mouser 13,783 at $0.44. 581-SR205E104MAR: 0 +51,480 on order. X7R alternative FG18X7R1H104KNT06 (810-FG18X7R1H104KNT6) 25,459 at $0.27. Read 2026-11-05 | in stock | none | Mouser: 2.54 mm straight leads and the same 5.08 x 3.18 x 5.08 mm body as the bulk part. | https://www.mouser.com/c/?q=SR205E104MAR ; https://www.mouser.com/c/?q=C320C104K5R5TA
45 | Capacitors - ceramic/tantalum | 1uF (105) tantalum capacitor | 2 | C42 C62 | Kemet T350A105K035AT (Digi-Key 399-1429) | E2,5-7: pads 2.54 mm apart, 5.1 x 4.1 mm outline | KEMET | T350A105K035AT | Mouser 80-T350A105K035AT | Mouser 114 +35,000 on order at $3.22. Read 2026-11-05 | in stock | none | Original part still made. | https://www.mouser.com/c/?q=T350A105K035AT
46 | Capacitors - electrolytic | 1uF 50V electrolytic | 13 | C11 C13 C14 C15 C17 C22 C23 C29 C38 C56 C58 C59 C105 | Xicon XRL50V1.0 (Mouser 140-XRL50V1.0) | E5-6: pads 2.54 mm, 5.33 mm circle (12 pcs); C17 E3,5-8: pads 3.556 mm | KEMET | ESK105M050AC3AA (5 x 11 mm, 2.0 mm lead spacing) | Mouser 80-ESK105M050AC3AA | Mouser 37,659 +22,500 on order at $0.16. Read 2026-11-05 | in stock | At assembly: form the leads from 2.0 to 2.54 mm; C17 needs 3.556 mm | Original Xicon XRL not found at Mouser (search for the Mouser numbers returns other parts). Same 5 x 11 can as XRL; buy now. Farnell marked this No Longer Manufactured on 2026-10-17; Mouser shows no such mark on 2026-11-05. | https://uk.farnell.com/search?st=ESK105M050AC3AA
47 | Capacitors - electrolytic | 2.2uF 50V electrolytic | 1 | C51 | Xicon XRL50V2.2 | E5-6: pads 2.54 mm, 5.33 mm circle | KEMET | ESK225M050AC3AA (5 x 11 mm) | Mouser 80-ESK225M050AC3AA | Mouser 5,627 at $0.20. Read 2026-11-05 | in stock | At assembly: form the leads from 2.0 to 2.54 mm | Original Xicon XRL not found at Mouser (search for the Mouser numbers returns other parts). Farnell marked this No Longer Manufactured on 2026-10-17; Mouser shows no such mark on 2026-11-05. | https://uk.farnell.com/search?st=ESK225M050AC3AA
48 | Capacitors - electrolytic | 10uF 16V (or 35V) electrolytic | 13 | C16 C30 C31 C32 C37 C40 C50 C52 C60 C61 C72 C203 C205 | Xicon XRL16V10 | E5-6: pads 2.54 mm, 5.33 mm circle | KEMET | ESK106M035AC3AA (10 uF 35 V, 5 x 11 mm) | Mouser 80-ESK106M035AC3AA | Mouser 38,171 at $0.17. Read 2026-11-05 | in stock | At assembly: form the leads from 2.0 to 2.54 mm | Original Xicon XRL not found at Mouser (search for the Mouser numbers returns other parts). Parts page allows 16 V or 35 V. ESK106M016AC3AA is out of stock. Farnell marked this No Longer Manufactured on 2026-10-17; Mouser shows no such mark on 2026-11-05. | https://uk.farnell.com/search?st=ESK106M035AC3AA
49 | Capacitors - electrolytic | 47uF 16V electrolytic (parts page: 10V) | 4 | C28 C44 C53 C55 | Xicon XRL16V47 | E5-6: pads 2.54 mm, 5.33 mm circle | Panasonic | ECA-1CM470 | Mouser 667-ECA-1CM470 | Mouser 6,521 at $0.23. Read 2026-11-05 | in stock | none | Original Xicon XRL not found at Mouser (search for the Mouser numbers returns other parts). Farnell shows ECA-1CM470 as no longer manufactured; Mouser still stocks it. Mouser: 5 x 11 mm, 2 mm leads. | https://www.mouser.com/c/?q=ECA-1CM470
50 | Capacitors - electrolytic | 100uF 10V electrolytic | 3 | C48 C49 C102 | Xicon XRL (BOM PDF lists 140-xrl25v100 here: transposed) | E5-6: pads 2.54 mm, 5.33 mm circle | KEMET | ESK107M010AC3AA (5 x 11 mm) | Mouser 80-ESK107M010AC3AA | Mouser 11,251 at $0.18. Read 2026-11-05 | in stock | At assembly: form the leads from 2.0 to 2.54 mm | The BOM PDF swaps the two 100 uF Mouser numbers (docs/expanded-bom-crosscheck.json); descriptions are right. PCB values: C48/C49 100/6.3, C102 100/10. Farnell marked this No Longer Manufactured on 2026-10-17; Mouser shows no such mark on 2026-11-05. | https://uk.farnell.com/search?st=ESK107M010AC3AA
51 | Capacitors - electrolytic | 100uF 25V electrolytic | 2 | C7 C8 | Xicon XRL (BOM PDF lists 140-xrl10v100 here: transposed) | E5-6: pads 2.54 mm, 5.33 mm circle (original XRL is 6.3 x 11 mm) | KEMET | ESK107M025AE3AA (6.3 x 11 mm, 2.5 mm) | Mouser 80-ESK107M025AE3AA | Mouser 12,105 at $0.22. Read 2026-11-05 | in stock | none | Same 6.3 mm can as the original XRL; overhangs the 5.33 mm silkscreen like the original. Farnell marked this No Longer Manufactured on 2026-10-17; Mouser shows no such mark on 2026-11-05. | https://uk.farnell.com/search?st=ESK107M025AE3AA
52 | Capacitors - electrolytic | 1000uF 10V electrolytic (PCB: 1000/6.3) | 1 | C43 | Xicon XRL10V1000 | E5-5: pads 5.08 mm, 10.85 mm circle | Nichicon | UVR1A102MPD (10 x 12.5 mm, 5 mm) | Mouser 647-UVR1A102MPD | Mouser 2,630 at $0.62. Read 2026-11-05 | in stock | none | Same 10 x 12.5 mm can as the original XRL. | https://www.mouser.com/c/?q=UVR1A102MPD
53 | Capacitors - electrolytic | 2200uF 16V electrolytic | 2 | C3 C5 | Xicon XRL16V2200 | E5-13: pads 5.08 mm, 12.7 mm circle | Nichicon | UVR1C222MHD (12.5 x 20 mm, 5 mm) | Mouser 647-UVR1C222MHD | Mouser 922 at $0.93. Read 2026-11-05 | in stock | none | I/O board; compare the can height with the repo model of the original XRL before ordering. Same 12.5 x 20 mm as the modelled XRL, with 4.37 mm of headroom under the case. C3 and C5 stand 0.28 mm apart at nominal size, as on the original board. | https://www.mouser.com/c/?q=UVR1C222MHD
54 | Diodes & LEDs | 1N4001 | 4 | D40 D41 D42 D43 | Generic 1N4001 | DO41-10: pads 11.18 mm apart, 1.2 mm drill | onsemi | 1N4001G | Mouser 863-1N4001G | Mouser 47,613 at $0.27. Read 2026-11-05 | in stock | none |  | https://www.mouser.com/c/?q=1N4001G
55 | Diodes & LEDs | 1N4148 | 29 | D1 D2 D3 D4 D5 D6 D7 D8 D9 D10 D24 D25 D26 D27 D28 D29 D30 D31 D32 D33 D34 D35 D36 D37 D44 D45 D46 D47 D48 | Generic 1N4148 | DO35-10: pads 7.11 mm apart | Vishay | 1N4148-TAP | Mouser 78-1N4148-TAP | Mouser 111,783 at $0.26. Read 2026-11-05 | in stock | none |  | https://www.mouser.com/ProductDetail/Vishay-Semiconductors/1N4148-TAP
56 | Diodes & LEDs | Red 5mm LED | 40 | LED1-LED40 | Generic | LED5MM: pads 2.54 mm, 5.7 mm outline | Kingbright | WP7113ID (diffused, 625 nm) | Mouser 604-WP7113ID | Mouser 26,977 +81,000 on order at $0.21. Read 2026-11-05 | in stock | none | Brightness sets the 10K LED resistor value (parts page); try one before soldering 40. | https://www.mouser.com/c/?q=WP7113ID
57 | Diodes & LEDs | 0.24" LED standoff | 40 | LED1-LED40 (spacers) | VCC STD240B (Mouser 593-STD240B) | Spacer 6.10 mm long, 5.08 mm OD, 2.54 mm lead holes (repo led-spacer record) | Bivar | ELM 1-240 (5 mm LED mount, black, 0.240 in) | Mouser 749-ELM-1-240 | Mouser 9,900 at $0.38. Essentra LEDS2M-240-01 (144-LEDS2M-240-01): Non-Stocked. Read 2026-11-05 | substitute | none | Bivar drawing: 5.1 mm OD, 0.240 +/-0.005 in (6.1 mm) long, two lead slots on 2.54 mm centres, black PVC. That matches the 6.10 mm, 5.08 mm OD original STD240BLK. No pad lies within 3.2 mm of any LED centre. | https://www.mouser.com/c/?q=STD240B ; docs/led-spacer-completion.json
58 | Transistors | 2SA733P PNP, TO-92 | 10 | Q1 Q2 Q8 Q9 Q10 Q27 Q31 Q33 Q36 Q38 | Fairchild 2SA733P (Mouser) | TO92 / 2SC536F: 3 pads in line at 2.54 mm; pad order E-C-B (E -2.54, C 0, B +2.54) | onsemi | KSA992FTA (E-C-B, hFE 300-600) | Mouser 512-KSA992FTA | Mouser 101,160 at $0.34. Read 2026-11-05 | substitute | none | Original: Renesas 2SA733 old stock only via LCSC marketplace (38,000, min 100, ~$1.95). A 2008 batch of 2SA733P measured hFE 340-350 (midibox); KSA992F (300-600) is the nearest gain grade. Alt: MCC 2SA1015-GR-AP (E-C-B, 200-400), Mouser 14,354, EOL. Q1/Q2 are the VCA pair: match hFE. onsemi: 1 emitter, 2 collector, 3 base, leads formed to 2.54 mm, and the FTA part is active. This order and the footprint's flat side match. | https://www.onsemi.com/pdf/datasheet/ksa992-d.pdf ; https://www.mouser.com/c/?q=KSA992FTA ; https://forum.midibox.org/t/x0xb0x-rare-parts/9689?page=5 ; https://www.lcsc.com/search?q=2SA733
59 | Transistors | 2SC536F NPN, TO-92 | 24 | Q3 Q4 Q5 Q11 Q13 Q14 Q15 Q16 Q17 Q18 Q19 Q20 Q23 Q24 Q25 Q29 Q30 Q32 Q34 Q35 Q37 Q40 Q41 Q50 | NEC 2SC536F ("Rare") | TO92 / 2SC536F: 3 pads in line at 2.54 mm; pad order E-C-B (E -2.54, C 0, B +2.54); Q17 Q19 Q23 use 2SC536_UNEVEN (E pad at -3.30 mm) | onsemi | KSC1815YTA or KSC945CYTA (both E-C-B, hFE 120-240) | Mouser 512-KSC1815YTA / 512-KSC945CYTA | Mouser 119,521 / 13,603 at $0.31. Read 2026-11-05 | substitute | none | Community lists 2SC945P as the 2SC536F alternative (midibox group buy, 2008). For a closer gain grade: Toshiba 2SC1815-GR (200-400) TO-92, LCSC marketplace 1,745; Renesas 2SC945A old stock on LCSC marketplace. Q3/Q4 are the VCA pair: match hFE; the VCF ladder (Q11-Q20) benefits from matching. onsemi KSC1815: 1 emitter, 2 collector, 3 base, hFE 120-240. If you use KSC945, take the -C suffix only: plain KSC945 is E-B-C. | https://www.onsemi.com/pdf/datasheet/ksc945-d.pdf ; https://www.onsemi.com/pdf/datasheet/ksc1815-d.pdf ; https://www.mouser.com/c/?q=KSC945CYTA ; https://forum.midibox.org/t/x0xb0x-rare-parts/9689?page=4 ; https://www.lcsc.com/search?q=2SC1815
60 | Transistors | JFET on the board, in place of the 2SK30A at Q28 (O grade) and Q39 (Y grade) | 2 | Q128 Q139 | Toshiba 2SK30A-O / 2SK30A-Y at Q28 and Q39 ("Rare") | x0x-smd:SC-59_Hand on the mainboard since KiCad revision 30: 3 lands, 1.9 mm pitch | Toshiba | 2SK208-O at Q128 and 2SK208-Y at Q139, S-Mini (SC-59) | Mouser 757-2SK208OTE85LF / 757-2SK208-YTE85LF | Mouser 9,313 / 9,454 at $0.66. Read 2026-11-05 | substitute | At assembly: O grade at Q128, Y grade at Q139; solder them before the neighbours. Fit a chip or its TO-92 part, never both | On paper the 2SK208 is the 2SK30A in another package: Toshiba's 2SK208 sheet and the 2SK30A sheet (Tiger's copy of Toshiba's) give the same ratings, the same Idss grades, Vgs(off), |Yfs|, Ciss, Crss and noise figure. Not measured here. The sites sit beside Q28 and Q39, whose holes stay. Through-hole option in those holes: QNHCHIP 2SK30A-Y/-GR (LCSC 960/1,140 in stock, clone brand, measure Idss). midibox: the Y grade at Q39 matters most. 2N5457/J201 have different pinouts and Idss. Toshiba: 1 source, 2 drain, 3 gate, Idss Y 1.2-3.0 mA and O 0.6-1.4 mA. The lands follow that drawing. | https://www.mouser.com/c/?q=2SK208 ; https://forum.pedalpcb.com/goto/post?id=319954 ; https://forum.midibox.org/t/x0xb0x-rare-parts/9689?page=4 ; https://www.lcsc.com/search?q=2SK30A
61 | Transistors | Dual NPN on the board, in place of the 2SC1583 at Q12 and Q26 and the 2SC2291 at Q22 | 3 | Q112 Q122 Q126 | Mitsubishi 2SC1583 at Q12 and Q26, 2SC2291 at Q22 ("Rare"); those SIP positions are do-not-place | x0x-smd:SOT-363_Hand on the mainboard since KiCad revision 29: 6 lands, 0.65 mm pitch | Nexperia | BCM847BS,135 | Mouser 771-BCM847BS135 | Mouser 2,018 +10,000 on order at $0.51. Also at Mouser: 771-BCM847BS-T/R 1,508 at $0.76, Diotec 637-BCM847BS 7,100 at $0.39, Diodes 621-BCM847BS-7 238 at $0.36 (those read 2026-11-04). Digi-Key: Diotec 12,587, Nexperia and Diodes none (2026-11-04). Read 2026-11-05 | substitute | At assembly: solder before the neighbours, 0.65 mm pitch by hand. Q126 touches the R100A model | Owner chose chips on the board (Q2). Buy 5 in all for the 3 sites, as spares for hand soldering. Fit a chip or its SIP part, never both. Vbe matching counts at Q112 and Q126: Nexperia states 2 mV at 2 mA, but the ladder runs at 3 to 27 uA, so measure a chip before relying on it. The Diotec and Diodes matching figures were not compared. The model shows no effect from Q122. All of this is simulated; nothing is built yet. Original only as NOS/pulls (eBay; 2007 midibox reports of paired 2SC1583/2SC2291 sets). Brian Castro (via sequencer.de) notes SMD equivalents exist but must be sorted on a curve tracer. The SSIP5 adapters remain a fallback for a site whose chip is left off. | kicad-working/smd-sites/README.md ; kicad-working/adapters/ssip5-dual/README.md ; kicad-working/validation/2sc1583-review/sources/mitsubishi-2sc1583.pdf ; https://www.mouser.com/c/?q=BCM847BS ; https://forum.midibox.org/t/x0xb0x-rare-parts/9689 ; https://www.sequencer.de/synthesizer/threads/303.123942/post-1463815 ; https://www.ebay.de/itm/177515067274
62 | Transistors | Dual NPN on the board, in place of the 2SC1583 at Q21 | 1 | Q121 | Mitsubishi 2SC1583 at Q21 ("Rare"); that SIP position is do-not-place | x0x-smd:SOT-363_Hand on the mainboard since KiCad revision 29: 6 lands, 0.65 mm pitch | onsemi | BC847CDW1T1G | Mouser 863-BC847CDW1T1G | Mouser 14,086 +60,000 on order at $0.19; Digi-Key 48,000 (2026-11-04). Read 2026-11-05 | substitute | At assembly: solder before R110; its land ends 0.07 mm from the R110 model | Owner chose chips on the board (Q2). Buy 3 for this one site, as spares for hand soldering. Fit it or Q21, never both. In the model Q21 gain sets the resonance: top Q 28.3 with this part, 18.1 with BCM847BS, 26.1 for an original at hFE 400, so do not swap it with line 61. It has no matching figure, so measure a chip before relying on it. Avoid Diodes DMMT3904W at Q21: only a minimum hFE of 100 at 10 mA was confirmed. All of this is simulated; nothing is built yet. | kicad-working/smd-sites/README.md ; https://www.mouser.com/c/?q=BC847CDW1T1G ; https://www.digikey.ie/en/products/detail/onsemi/BC847CDW1T1G/1476009
63 | ICs | AN6562 8-DIP dual op-amp | 2 | IC11 IC23 | Panasonic AN6562 ("Rare") | DIL08: 300 mil DIP-8, standard dual op-amp pinout (OUT1 -IN1 +IN1 V- +IN2 -IN2 OUT2 V+) | Texas Instruments | LM358P | Mouser 595-LM358P | Mouser 39,792 at $0.33. Read 2026-11-05 | substitute | none | Panasonic: AN6562 = AN1358, a 358-class dual op-amp with inputs to 0 V; midibox (TheAncientOne, 2007) reports LM358 working. A 4558 is not single-supply and is not the same class. | https://html.alldatasheet.com/html-pdf/13277/PANASONIC/AN6562S/406/1/AN6562S.html ; https://forum.midibox.org/t/x0xb0x-rare-parts/9689 ; https://www.mouser.com/c/?q=LM358P
64 | ICs | 4066 analog switch | 1 | IC12 | Generic 4066 | DIL14 | Texas Instruments | CD4066BE | Mouser 595-CD4066BE | Mouser 19,069 at $0.99. Read 2026-11-05 | in stock | none |  | https://www.mouser.com/c/?q=CD4066BE
65 | ICs | 74HC174 / 74AC174 | 1 | IC9 | Generic (parts page: HC or AC) | DIL16 | Texas Instruments | SN74HC174N | Mouser 595-SN74HC174N | Mouser 526 at $1.72. Read 2026-11-05 | in stock | none | No 74AC174 in DIP at Mouser; parts page allows HC. | https://www.mouser.com/c/?q=SN74HC174N
66 | ICs | 74HC126 | 1 | IC1 | Generic | DIL14 | Texas Instruments | SN74HC126N | Mouser 595-SN74HC126N | Mouser 1,139 at $0.97. Read 2026-11-05 | in stock | none |  | https://www.mouser.com/c/?q=SN74HC126N
67 | ICs | 74AC165 / 74HC165 | 3 | IC16 IC17 IC18 | Generic (parts page: AC or HC) | DIL16 | Texas Instruments | SN74HC165N | Mouser 595-SN74HC165N | Mouser 3,954 at $1.64. Read 2026-11-05 | in stock | none | No 74AC165 in DIP at Mouser. | https://www.mouser.com/c/?q=SN74HC165N
68 | ICs | 74HC595 | 5 | IC4 IC5 IC6 IC7 IC8 | Generic | DIL16 | Texas Instruments | SN74HC595N | Mouser 595-SN74HC595N | Mouser 10,480 at $1.86. Read 2026-11-05 | in stock | none |  | https://www.mouser.com/c/?q=SN74HC595N
69 | ICs | 4N37 optoisolator | 1 | IC24 | Generic 4N37 (Mouser 512-4N37, onsemi: now obsolete) | DIL06 | Lite-On | 4N37 | Mouser 859-4N37 | Mouser 6,678 at $0.44. Read 2026-11-05 | in stock | none | The BOM Mouser number (onsemi) is obsolete; Lite-On and Vishay make the same part. | https://www.mouser.com/c/?q=4N37
70 | ICs | 25C33 SPI EEPROM, 32 Kbit | 1 | IC2 | CSI/onsemi CAT25C33P (parts page: CAT2532 / AT25320) | DIL08_AT25: DIP-8, 25xxx SPI pinout | Microchip | 25LC320A-I/P | Mouser 579-25LC320A-I/P | Mouser 740 at $0.90. Read 2026-11-05 | substitute | none | CAT25C33 no longer listed. 25LC320A is the same 4K x 8 SPI EEPROM in the standard 25xxx pinout; check its write-page size against the firmware (open question Q7). | https://www.mouser.com/c/?q=25LC320A-I/P
71 | ICs | ATmega162 microcontroller | 1 | IC3 | Atmel ATmega162-16PU (BOM PDF: -40PI) | DIL40 (600 mil) | Microchip | ATMEGA162-16PU | Mouser 556-ATMEGA162-16PU | Mouser 380 at $6.18. Read 2026-11-05 | in stock | none | Blank part: needs the bootloader/firmware programmed over ISP. | https://www.mouser.com/ProductDetail/Microchip-Technology/ATMEGA162-16PU
72 | ICs | LA4140 9-SIP headphone amplifier | 1 | IC14 | Sanyo LA4140 ("Rare") | SIP9: 9 pads at 2.54 mm, 0.9 mm drill, 23 x 3 mm outline | - | LA4140 NOS/pull |  | Not at Mouser: no match for LA4140. Read 2026-11-05 | hunt | none for an original part; any replacement amp needs an adapter | Secondary market only (eBay, Vintage Planet, Cricklewood were the 2007-2008 sources). Only feeds the headphone jack (open question Q6). | https://forum.midibox.org/t/x0xb0x-rare-parts/9689 ; https://www.lcsc.com/search?q=LA4140
73 | ICs | BA6110 9-SIP OTA (VCA) | 1 | IC15B | Rohm BA6110 ("Rare") | SIP9 at IC15B: 9 pads at 2.54 mm; IC15A is the alternative BA662 footprint (pins 1-4 differ) | - | BA6110 NOS/pull |  | Not at Mouser: no match for BA6110. Read 2026-11-05 | hunt | At assembly: a BA662 or a clone goes in IC15A, not IC15B, with Q1-Q4 left off | Secondary market only; a 2010 forum warning about a seller of defective BA6110s. Alternative: Open Music Labs BA662 clone (matched-pair replica) in IC15A; BA662 vs BA6110: ~3-7 dB level and control threshold differences (subatomicglue). TI LM13700N is obsolete and not pin-compatible. | http://www.openmusiclabs.com/projects/ba662-clone/ ; https://www.subatomicglue.com/x0xl0g/ba662a-analysis/ ; https://www.diystompboxes.com/smfforum/index.php?msg=950824 ; https://forum.midibox.org/t/x0xb0x-rare-parts/9689
74 | ICs | BA662A 9-SIP OTA (optional, not in kit) | 0 |  | Roland/Rohm BA662A ("Extremely rare") | SIP9 at IC15A | - | not ordered |  | - | not ordered | none | Leave IC15A empty when BA6110 is fitted in IC15B. With a BA662 or a clone in IC15A, leave IC15B and Q1-Q4 off: Q1-Q4 are the BA6110 current mirror, and Q3 would sit across the BA662 control input. | kicad-working/validation/expanded-bom-review/sources/x0x-billofmaterials-adawiki-user-print.pdf
75 | ICs | 7805 regulator, TO-220 | 1 | IC20 | onsemi MC78M05CT (Mouser 512-MC78M05CT) | 78XXS: TO-220 lying flat, IN-GND-OUT at 2.54 mm | onsemi | MC78M05CTG | Mouser 863-MC78M05CTG | Mouser 3,441 at $0.78. Read 2026-11-05 | in stock | none | Lead-free version of the BOM part. | https://www.mouser.com/ProductDetail/onsemi/MC78M05CTG
76 | ICs | 78L06 regulator, TO-92 | 1 | IC21 | JRC NJM78L06A (Mouser 513-NJM78L06A) | TO-92_x0x: 3 pads at 2.54 mm | Texas Instruments | UA78L06ACLP | Mouser 595-UA78L06ACLP | Mouser 1,360 at $1.20. Read 2026-11-05 | substitute | none | NJM78L06A and ST L78L06ACZ: Mouser obsolete. onsemi MC78L06ACP: 7,304 in stock but EOL. TI: 1 output, 2 common, 3 input, which matches the nets on the footprint's pads. | https://www.mouser.com/c/?q=UA78L06ACLP ; https://www.mouser.com/ProductDetail/Nisshinbo/NJM78L06A
77 | ICs | LM336Z-5.0 reference, TO-92 | 1 | IC22 | National LM336Z-5.0 | TO-92_x0x | Texas Instruments | LM336Z-5.0/NOPB | Mouser 926-LM336Z-50/NOPB | Mouser 4,888 at $0.83. Read 2026-11-05 | in stock | none |  | https://www.mouser.com/ProductDetail/Texas-Instruments/LM336Z-5.0-NOPB
78 | ICs | FT232BM USB UART | 1 | IC25 | FTDI FT232BM (Mouser) | SQFP-S-7X7-32: LQFP-32, 7 x 7 mm body, 0.8 mm pitch (SMD) | FTDI | FT232BL (pin-compatible lead-free B-series) | LCSC C15916 / C18968 | Mouser: FT232BM (895-FT232BM) Obsolete, no match for FT232BL. Read 2026-11-05. LCSC marketplace figures are from 2026-10-17 | hunt | none for FT232BL; FT232R/FT232RL are not pin-compatible | Needed for USB; MIDI and ISP do not need it (open question Q3). Expect old stock or pulls. | https://www.mouser.com/ProductDetail/FTDI/FT232BM ; https://www.mouser.com/ProductDetail/FTDI/FT232BL-REEL ; https://www.lcsc.com/search?q=FT232BL
79 | ICs | 6MHz ceramic resonator | 1 | XTL2 | Abracon AWCR-6.00MD | Resonator_6MHz_x0x: 3 pads at 2.54 mm | Murata | CSTLS6M00G53-B0 | Mouser 81-CSTS0600MG03 | Mouser 1,770 at $0.21. Read 2026-11-05, End of Life | in stock (EOL) | none | AWCR-6.00MD and ECS ZTT-6.00MT: Mouser obsolete. A 2.5 mm lead pitch is 0.04 mm from the 2.54 mm holes. | https://www.mouser.com/c/?q=CSTLS6M00G53-B0 ; https://www.mouser.com/ProductDetail/ABRACON/AWCR-6.00MD
80 | ICs | 16MHz ceramic resonator | 1 | XTL1 | Abracon AWCR-16.00MD | 2SC2021 footprint: 3 pads at 2.54 mm | Murata | CSTLS16M0X53-B0 | Mouser 81-CSTLS16M0X53-B0 | Mouser 15,541 at $0.34. Read 2026-11-05, End of Life | in stock (EOL) | none | AWCR-16.00MD and ECS ZTT-16.00MX: Mouser obsolete. A 2.5 mm lead pitch is 0.04 mm from the 2.54 mm holes. | https://www.mouser.com/c/?q=CSTLS16M0X53-B0
81 | Mechanical - board | 40-pin DIP socket | 1 | IC3 (socket) | TE AMP 390262-5 (Mouser 571-3902625) | DIL40 600 mil | Mill-Max | 110-44-640-41-001000 | Mouser 575-11044640 | Mouser 3,801 at $3.22. Read 2026-11-05 | substitute | none | TE 390262-5 and 1-390262-5: Mouser obsolete. Parts page: any 40-pin socket will do. A lower socket changes only the chip-top height. | https://www.mouser.com/ProductDetail/Mill-Max/110-44-640-41-001000 ; https://www.mouser.com/ProductDetail/TE-Connectivity-AMP/390262-5
82 | Mechanical - board | 8-pin DIP socket | 1 | IC2 (socket) | TE AMP 390261-2 (Mouser 571-3902612) | DIL08 300 mil | Mill-Max | 110-44-308-41-001000 | Mouser 575-144308 | Mouser 8,752 at $0.89. Read 2026-11-05 | substitute | none | TE 390261-2 and 1-390261-2: Mouser obsolete. | https://www.mouser.com/ProductDetail/Mill-Max/110-44-308-41-001000
83 | Mechanical - board | Heat sink (TO-220) | 1 | KK1 (on IC20) | Aavid 574502B00000G (Mouser 532-574502B00) | D03S outline 13.7 x 7.6 mm | Boyd/Aavid | 574502B00000G | Mouser 532-574502B00 | Mouser 21,205 at $1.98. Read 2026-11-05 | in stock | none |  | https://www.mouser.com/ProductDetail/Aavid/574502B00000G
84 | Connectors | 1/4" stereo jack | 3 | MIXOUT MIXIN HEADPHONE | Neutrik/REAN NYS216 (Mouser 568-NYS216) | REAN_1_4STERO: 6 pads, 1.6 mm drill, 18.2 x 32.7 mm outline | REAN (Neutrik) | NYS216-U (the same jack, with nut and washer loose) | Mouser 568-NYS216-U | Mouser 801 at $0.61. NYS216: 0 +6,800 on order at $0.72. Read 2026-11-05 | in stock | none | REAN: stereo 3 pole, 8.2 mm distance to PCB, the same as NYS216 with washer and nut not assembled. | https://www.mouser.com/c/?q=NYS216
85 | Connectors | 1/8" jack | 2 | CV GATE | CUI MJ-CP3536N (Digi-Key CP-3536N) | MJ-3536N: 3 slotted pads, 2.54 mm drill, 10.2 x 17.8 mm outline | Same Sky (CUI) | MJ-3536N | Mouser 490-MJ-3536N | Mouser 7,424 +12,500 on order at $1.09. Read 2026-11-05 | in stock | none |  | https://www.mouser.com/c/?q=MJ-3536N
86 | Connectors | 2.1mm power jack | 1 | POWER | CUI PJ-202AH (Digi-Key CP-202A) | PJ-202AH: 3 slotted pads 2.8/3.2 mm | Same Sky (CUI) | PJ-202AH | Mouser 490-PJ-202AH | Mouser 3,610 at $0.86. Read 2026-11-05 | in stock | none |  | https://www.mouser.com/ProductDetail/Same-Sky/PJ-202AH
87 | Connectors | USB type-B jack | 1 | USB | Kobiconn 154-2442-E (Mouser) | PN61729: signal pins 2.5 x 2.0 mm, board locks 12.19 mm apart (2.2 mm drill) | Amphenol FCI | 61729-0010BLF | Mouser 649-61729-0010BLF | Mouser 24,974 at $1.61. Read 2026-11-05 | substitute | none | Kobiconn 154-2442-E: Mouser obsolete. The board footprint is named after the FCI 61729 itself. | https://www.mouser.com/ProductDetail/Amphenol-FCI/61729-0010BLF ; https://www.mouser.com/ProductDetail/Kobiconn/154-2442-E
88 | Connectors | MIDI/DINSYNC 5-pin DIN jack | 4 | DIN1 DIN2 DIN3 DIN4 | CUI SDS-50J (Digi-Key CP-2350) | CP-2350: 5 pins on a 7 mm circle + 2 shield pins, 1.32 mm drill | Same Sky (CUI) | SDS-50J | Mouser 490-SDS-50J | Mouser 20,799 at $2.65. Read 2026-11-05 | in stock | none |  | https://www.mouser.com/ProductDetail/Same-Sky/SDS-50J
89 | Switches | Toggle switch (saw/square) | 1 | S1 | NKK B12AB-RO (Mouser 633-B12AB) | NKKTOGGLE: 3 pins at 2.54 mm + 4 bracket pins | NKK | B12AB | Mouser 633-B12AB | Mouser 2,996 at $7.04. Read 2026-11-05 | in stock | none | Parts page says B12AB-RO; the BOM PDF Mouser number is B12AB. | https://www.mouser.com/c/?q=B12AB
90 | Switches | Rotary encoder (tempo) | 1 | S2 | CTS 290VAA5F201B2 (Digi-Key CT3011) | PEC11-S: A-C-B at 2.5 mm, switch pins 5 mm, lugs 11.4 mm apart (2.8 mm) | CTS | 290VAA5F201B2 | Mouser 774-290VAA5F201B2 | Mouser 472 at $4.96. Read 2026-11-05 | in stock | none | Original still made (15 mm flatted, 20 detents). Footprint-native alternative: Bourns PEC11R-4215F-S0024, Mouser 10,167 in stock (24 detents: firmware tempo step feel changes). The CTS 290 drawing was checked in revision 13: all 7 pins and tabs fit the PEC11-S holes, smallest margin 0.07 mm. Cheaper, with 24 detents: PEC11R-4220F-S0024 (652-PEC11R-4220F-S0024) 1,330 at $2.23. | https://www.mouser.com/ProductDetail/CTS-Electronic-Components/290VAA5F201B2 ; https://www.mouser.com/ProductDetail/Bourns/PEC11R-4215F-S0024
91 | Switches | 16-position rotary switch (bank/mode) | 2 | S3 S4 | Grayhill 25LB22-H (Digi-Key GH3074) | GH3074: C,1,2,4,8 at 2.54 mm, 12.7 mm from shaft; MT1-MT4 take no bracket, only the anchor wire | Grayhill | 25LB22-H | Mouser 706-25LB22-H | Mouser 60 at $33.63. Read 2026-11-05 | in stock | none | Original still made. The BOM anchors S3 and S4 with ~20 AWG wire but gives no route. On S3 use two separate wires, MT1-MT4 and MT2-MT3: MT1/MT4 are analog ground and MT2/MT3 digital, so any other route bridges the ground split. | https://www.mouser.com/c/?q=25LB22-H
92 | Switches | Tact switch 12 mm | 23 | S5-S27 | E-Switch TL1100F160Q (Digi-Key EG1821) | B3F-40XX: 4 pins 12.5 x 5.0 mm, 1.19 mm drill | E-Switch | TL1100F160Q | Mouser 612-TL1100 | Mouser 3,126 +12,000 on order at $0.51. Read 2026-11-05 | in stock | none |  | https://www.mouser.com/c/?q=TL1100F160Q
93 | Mechanical - panel | Switch cap (white) | 8 | (on S5-S27) | ITT PE/WHT (Digi-Key 401-1155) | Cap 12.1 x 5.9 x 11 mm | C&K | PEWH | Mouser 611-PEWH | Mouser 2,338 at $0.93. Read 2026-11-05 | in stock | none |  | https://www.digikey.com/en/products/detail/c-k/PEWH/417706
94 | Mechanical - panel | Switch cap (black) | 15 | (on S5-S27) | ITT PE/BLK (Digi-Key 401-1152) | Cap 12.1 x 5.9 x 11 mm | C&K | PEBK | Mouser 611-PEBK | Mouser 1,999 at $0.84. Read 2026-11-05 | in stock | none | Same family as PEWH. | https://www.digikey.com/en/products/detail/c-k/PEBK/417703
95 | Mechanical - panel | Potentiometer knob | 8 | (on VR2-VR8, S2) | Eagle Plastic Devices 450-4760 (Mouser) | 6 mm D shaft; 13.2 mm body | Eagle Plastic Devices | 450-4765 soft-touch knob (grey pointer line) | Mouser 450-4765 | Mouser 3,732 at $1.66. 450-4760 (white line, the original): 3 +4,000 on order at $1.88. Plain 450-BA600: 8,541 at $1.85. Read 2026-11-05 | substitute | none | Mouser lists the same knob as 450-4760 but for the pointer colour: 14 mm wide, 16 mm tall, rubber, 6 mm D shaft. Choose 450-4760 once restocked for the white line. | https://www.mouser.com/ProductDetail/450-4760
96 | Mechanical - panel | Switch knob | 2 | (on S3 S4) | Davies 1510AH (Mouser 5164-1510) | 0.75 in dia x 0.56 in | Davies Molding | 1510AH | Mouser 5164-1510AH | Mouser 4,030 at $1.73. Read 2026-11-05 | in stock | none |  | https://www.mouser.com/ProductDetail/Davies-Molding/1510AH
97 | Mechanical - wiring | Board-to-board jumper ribbon (0.1 in) | 4 x 6-wire, or 2 x 9 + 1 x 6 | J3 J4 J5 J6 J7 (both boards) | Molex jumpers (Digi-Key WM09-06 / WM06-06 / WM03-06) | MA12-1 + 4 x MA03-1: 0.100 in pitch, 1.016 mm drill, 24 conductors per board | - | 0.1 in pitch flat jumper / ribbon, solder both ends |  | Digi-Key codes not resolved; not checked | generic | none | The WM09-06 etc. codes could not be matched to a current Molex part. 24 conductors of 0.1 in ribbon or wire do the job (open question Q8). | kicad-working/validation/expanded-bom-review/sources/x0x-billofmaterials-adawiki-user-print.pdf
98 | Mechanical - wiring | Wire links J1 (12.7 mm) and J2 (15.24 mm) | 2 | J1 J2 | Not in BOM | 2 pads each, 1.0 mm drill | - | resistor lead offcuts |  | - | generic | none | Mainboard wire links (footprints 12 and 15).
99 | Mechanical - wiring | Solid ~20 AWG wire (anchor S3, S4) | 1 |  | Generic (supply yourself) | - | - | solid 20 AWG tinned copper |  | - | generic | At assembly: separate wires MT1-MT4 and MT2-MT3, or the ground split is bridged (check 15) | See line 91 for the S3 route. | kicad-working/validation/expanded-bom-review/sources/x0x-billofmaterials-adawiki-user-print.pdf
100 | Mechanical - enclosure | ABS case | 1 |  | PacTec PT-10 | - | PacTec | 82404-501-000 (PT-10 production unit, black) | Mouser 616-82404-501-000 | Mouser 160 +23 on order at $18.85. Read 2026-11-05 | in stock | Black, the owner's choice on 2026-11-06, to match the black FR-4 panels. Bone is Mouser 616-82404-501-039, 24 at $18.85, read 2026-11-05. No kit needed: this unit has both covers, the assembly screws and the feet, and the panels are line 101 | PacTec lists only black and PC bone. The original kit case was fitted with Adafruit panels. | https://www.mouser.com/ProductDetail/PacTec/82404-501-000
101 | Mechanical - enclosure | Set of main and I/O panels | 1 |  | Custom (Adafruit) | - | - | fabricated from kicad-working/panels |  | JLCPCB $22.30 main + $9.60 rear for 5 of each, before shipping. Both ZIPs uploaded, read 2026-11-05 | custom | FR-4, black with white legends. Designed, not made or fitted: kicad-working/panels/README.md | FR-4 panels drawn from the original DXFs. | kicad-working/visualization/blender-case-revision-7/bom-parts/original-parts-page-mirror.html ; kicad-working/panels/README.md
102 | Mechanical - enclosure | Set of main and I/O PCBs | 1 |  | Custom (Adafruit) | - | - | fabricated from kicad-working/fabrication/revision-30 |  | JLCPCB $26.80 mainboard + $9.90 I/O for 5 of each, before shipping. Mainboard: revision 30 ZIP uploaded, read 2026-11-05. I/O: revision 29 ZIP, read 2026-11-04 | custom | none | FR-4, 1.6 mm, 1 oz, lead-free HASL, green, white, tented vias. Not ordered. Packages of revision 29 and earlier no longer match. | kicad-working/visualization/blender-case-revision-7/bom-parts/original-parts-page-mirror.html ; kicad-working/fabrication/revision-30/README.md
103 | Mechanical - enclosure | 9 V AC wall adapter, 300-500 mA, 2.1 mm plug | 1 |  | Generic (Jameco) | - | - | 9 V AC (not DC) adapter, >= 500 mA, 2.1 mm barrel |  | Not checked (choose for your mains) | generic | none | Must be AC: the supply is a voltage doubler (D40-D43). | kicad-working/visualization/blender-case-revision-7/bom-parts/original-parts-page-mirror.html
104 | Mechanical - enclosure | 15/32" x 1/4" hex 4-40 standoff | 3 |  | Generic (McMaster) | - | - | aluminium hex standoff, female-female, 4-40, 15/32 in |  | Generic McMaster hardware; not checked | generic | none | 15/32 in is not a common length; McMaster carries it. | kicad-working/validation/expanded-bom-review/sources/x0x-billofmaterials-adawiki-user-print.pdf
105 | Mechanical - enclosure | 3/8" x 1/4" hex 4-40 standoff | 4 |  | Generic (McMaster) | - | - | aluminium hex standoff, female-female, 4-40, 3/8 in |  | Generic McMaster hardware; not checked | generic | none |  | kicad-working/validation/expanded-bom-review/sources/x0x-billofmaterials-adawiki-user-print.pdf
106 | Mechanical - enclosure | 4-40 lock washer | 7 |  | Generic (McMaster) | - | - | #4 split lock washer |  | Generic McMaster hardware; not checked | generic | none |  | kicad-working/validation/expanded-bom-review/sources/x0x-billofmaterials-adawiki-user-print.pdf
107 | Mechanical - enclosure | 4-40 washer | 4 |  | Generic (McMaster) | - | - | #4 flat washer |  | Generic McMaster hardware; not checked | generic | none |  | kicad-working/validation/expanded-bom-review/sources/x0x-billofmaterials-adawiki-user-print.pdf
108 | Mechanical - enclosure | 4-40 x 1/4" hex button screw | 7 |  | Generic (McMaster) | - | - | 4-40 x 1/4 in button head hex drive |  | Generic McMaster hardware; not checked | generic | none |  | kicad-working/validation/expanded-bom-review/sources/x0x-billofmaterials-adawiki-user-print.pdf
109 | Mechanical - enclosure | 4-40 x 1/4" phillips button screw | 7 |  | Generic (McMaster) | - | - | 4-40 x 1/4 in button head Phillips |  | Generic McMaster hardware; not checked | generic | none |  | kicad-working/validation/expanded-bom-review/sources/x0x-billofmaterials-adawiki-user-print.pdf
110 | Mechanical - enclosure | 4-40 x 1/2" phillips cheesehead screw + 4 rubber feet | 4 |  | Comes with case | - | PacTec | included with PT-10 |  | - | in stock | none | BOM PDF says 1/4 in, parts page 1/2 in; both say they come with the case. | kicad-working/visualization/blender-case-revision-7/bom-parts/original-parts-page-mirror.html
111 | Optional - SI study | 100 pF C0G ceramic, IC9 clock | 1 | IC9 pin 9 to pin 8 | Not in BOM | Existing pads 7.62 mm apart | TDK | FG28C0G1H101JNT06 (5 mm leads) | Mouser 810-FG28C0G1H101JNT6 | Mouser 3,813 in stock at $0.23. Read 2026-11-05 | in stock | At assembly: form the leads from 5 mm to 7.62 mm, on the solder side | Optional, not in the original design, and from a model that has not been measured. Buy them with the rest so that they are on hand; fit them only if the scope check in the study calls for them. With the 1 nF on the next line, the model removes the false clock on IC9 during rests. The nearest bottom-side part is 18 mm away. | x0xb0x-si-emc/REPORT.md section 1.2 ; https://www.mouser.com/c/?q=FG28C0G1H101JNT06
112 | Optional - SI study | 1 nF C0G ceramic, across the ground split | 1 | IC9 pin 8 to S3 MT3 | Not in BOM | Existing pads 6.03 mm apart | TDK | FG28C0G1H102JNT06 (5 mm leads) | Mouser 810-FG28C0G1H102JNT6 | Mouser 12,277 in stock at $0.27. Read 2026-11-05 | in stock | At assembly: form the leads to 6.03 mm; S3 MT3 also takes the anchor wire (check 15) | Optional, not in the original design, and from a model that has not been measured. Buy them with the rest so that they are on hand; fit them only if the scope check in the study calls for them. Joins analog and digital ground at high frequency only, so the star ground stays at DC. The route clears S3's body. | x0xb0x-si-emc/REPORT.md section 1.2 ; https://www.mouser.com/c/?q=FG28C0G1H102JNT06
113 | Optional - SI study | 0.1 uF X7R ceramic, 595 LED driver decoupling | 3 | IC4 IC5 IC7, pin 16 to pin 13 | Not in BOM | Existing pads 7.62 mm apart | TDK | FG28X7R1H104KNT06 (5 mm leads) | Mouser 810-FG28X7R1H104KNT6 | Mouser 103,402 in stock at $0.27. Read 2026-11-05 | in stock | At assembly: on the solder side, with the leads arched clear of the joints of pins 14 and 15 | Optional, not in the original design, and from a model that has not been measured. Buy them with the rest so that they are on hand; fit them only if the scope check in the study calls for them. The nearest 0.1 uF to these ICs is 28-31 mm of copper away. Bottom-side parts are at least 14.7 mm away, and the 5.5 mm body fits the 11.9 mm gap to the panel. | x0xb0x-si-emc/REPORT.md section 1.2 ; https://www.mouser.com/c/?q=FG28X7R1H104KNT06
114 | Optional - SI study | 0.1 uF X7R ceramic, MCU decoupling | 1 | IC3 pin 40 to C101 pad 1 | Not in BOM | Existing pads 3.64 mm apart | TDK | FG18X7R1H104KNT06 (2.5 mm leads) | Mouser 810-FG18X7R1H104KNT6 | Mouser 25,459 in stock at $0.27. Read 2026-11-05 | in stock | At assembly: form the leads from 2.5 mm to 3.64 mm, on the solder side | Optional, not in the original design, and from a model that has not been measured. Buy them with the rest so that they are on hand; fit them only if the scope check in the study calls for them. IC3 pins 40 and 20 are 50.6 mm apart, so this joins pin 40 to the nearest ground pad instead. No bottom-side part is on the route. | x0xb0x-si-emc/REPORT.md section 1.2 ; https://www.mouser.com/c/?q=FG18X7R1H104KNT06
115 | Resistors | 150 ohm 5% resistor | 1 | R16 | Parts page: 150 ohm in newer kits, 100 ohm in older ones; BOM PDF and PCB 100 ohm | 0207 axial, mounted standing; pads 5.08 mm apart, 1.0 mm drill | YAGEO | MFR-25FBF52-150R | Mouser 603-MFR-25FBF52-150R | Mouser 6,535 +30,000 expected 2026-12-03 at $0.10. Read 2026-11-05 | in stock | none | Owner's choice over the PCB's 100 ohm. With 100 ohm, MIDI IN from a 5 V sender needs a 4N37 CTR of about 133 %, against a guaranteed 100 %; with 150 ohm it needs about 89 %. That is a model, not measured: x0xb0x-si-emc/REPORT.md section 12.5. | x0xb0x-si-emc/REPORT.md section 12.5 ; kicad-working/visualization/blender-case-revision-7/bom-parts/original-parts-page-mirror.html ; https://www.mouser.com/c/?q=MFR-25FBF52-150R
