cozycactus/x0xb0x-hardware/kicad-working/fabrication/revision-30/mainboard/assembly/mainboard-bom.csv

Reference | Printed | Value | Footprint | Side | Mount | DNP | Note
C10 | C10 | .01 | mainboard-import-fps:C050-024X044 | top | PTH
C11 | C11 | 1/50 | mainboard-import-fps:E5-6 | top | PTH
C13 | C13 | 1/50 | mainboard-import-fps:E5-6 | top | PTH
C14 | C14 | 1/50 | mainboard-import-fps:E5-6 | top | PTH
C15 | C15 | 1/50 | mainboard-import-fps:E5-6 | top | PTH
C16 | C16 | 10/16 | mainboard-import-fps:E5-6 | top | PTH
C17 | C17 | 1/50 | mainboard-import-fps:E3,5-8 | top | PTH
C18 | C18 | .018 | mainboard-import-fps:C050-025X075 | top | PTH
C19 | C19 | .033 | mainboard-import-fps:C050-025X075 | top | PTH
C20 | C20 | .01 | mainboard-import-fps:C050-024X044 | top | PTH
C21 | C21 | .01 | mainboard-import-fps:C050-024X044 | top | PTH
C22 | C22 | 1/50 | mainboard-import-fps:E5-6 | top | PTH
C23 | C23 | 1/50 | mainboard-import-fps:E5-6 | top | PTH
C24 | C24 | .033 | mainboard-import-fps:C050-025X075 | top | PTH
C25 | C25 | .1 | mainboard-import-fps:C050-030X075 | top | PTH
C26 | C26 | .033 | mainboard-import-fps:C075-032X103 | top | PTH
C27 | C27 | .1 | mainboard-import-fps:C050-030X075 | top | PTH
C28 | C28 | 47/16 | mainboard-import-fps:E5-6 | top | PTH
C29 | C29 | 1/50 | mainboard-import-fps:E5-6 | top | PTH
C30 | C30 | 10/16 | mainboard-import-fps:E5-6 | top | PTH
C31 | C31 | 10/16 | mainboard-import-fps:E5-6 | top | PTH
C32 | C32 | 10/16 | mainboard-import-fps:E5-6 | top | PTH
C33 | C33 | .01 | mainboard-import-fps:C050-024X044 | top | PTH
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
VR5 | VR5 | 50K(A) | mainboard-import-fps:EVU | bottom | PTH
VR6 | VR6 | 1M(A) | mainboard-import-fps:ALPHADUAL | bottom | PTH
VR7 | VR7 | 50K(B) | mainboard-import-fps:EVU | bottom | PTH
VR8 | VR8 | 50K(A) | mainboard-import-fps:EVU | bottom | PTH
XTL1 | XTL1 | 2SC2021R | mainboard-import-fps:2SC2021 | top | PTH
