cozycactus/x0xb0x-hardware/kicad-working/fabrication/revision-30/ioboard/assembly/ioboard-bom.csv

Reference | Printed | Value | Footprint | Side | Mount | DNP | Note
C1 | C1 | .1 | ioboard-import-fps:C050H075X075 | top | PTH
C2 | C2 | .1 | ioboard-import-fps:C050H075X075 | top | PTH
C3 | C3 | 2200/16 | ioboard-import-fps:E5-13 | top | PTH
C4 | C4 | .1 | ioboard-import-fps:C050H075X075 | top | PTH
C5 | C5 | 2200/16 | ioboard-import-fps:E5-13 | top | PTH
C6 | C6 | .1 | ioboard-import-fps:C050H075X075 | top | PTH
C7 | C7 | 100/25 | ioboard-import-fps:E5-6 | top | PTH
C8 | C8 | 100/25 | ioboard-import-fps:E5-6 | top | PTH
C60 | C60 | 10/16 | ioboard-import-fps:E5-6 | top | PTH
C61 | C61 | 10/16 | ioboard-import-fps:E5-6 | top | PTH
C201 | C201 | 33nF | ioboard-import-fps:C050-025X075 | top | PTH
C202 | C202 | .1uF | ioboard-import-fps:C050H075X075 | top | PTH
C203 | C203 | 10uF | ioboard-import-fps:E5-6 | top | PTH
C204 | C204 | .1uF | ioboard-import-fps:C050H075X075 | top | PTH
C205 | C205 | 10uF | ioboard-import-fps:E5-6 | top | PTH
CV0 | CV | MONO_CC | ioboard-import-fps:MJ-3536N | top | PTH |  | silkscreen prints CV
D40 | D40 | 1N4001 | ioboard-import-fps:DO41-10 | top | PTH
D41 | D41 | 1N4001 | ioboard-import-fps:DO41-10 | top | PTH
D42 | D42 | 1N4001 | ioboard-import-fps:DO41-10 | top | PTH
D43 | D43 | 1N4001 | ioboard-import-fps:DO41-10 | top | PTH
D44 | D44 | 1N4148 | ioboard-import-fps:DO35-10 | top | PTH
D45 | D45 | 1N4148 | ioboard-import-fps:DO35-10 | top | PTH
D46 | D46 | 1N4148 | ioboard-import-fps:DO35-10 | top | PTH
D47 | D47 | 1N4148 | ioboard-import-fps:DO35-10 | top | PTH
D48 | D48 | 1N4148 | ioboard-import-fps:DO35-10 | top | PTH
DIN1 | DIN1 | CP2350 | ioboard-import-fps:CP-2350 | top | PTH
DIN2 | DIN2 | CP2350 | ioboard-import-fps:CP-2350 | top | PTH
DIN3 | DIN3 | CP2350 | ioboard-import-fps:CP-2350 | top | PTH
DIN4 | DIN4 | CP2350 | ioboard-import-fps:CP-2350 | top | PTH
GATE0 | GATE | MONO_CC | ioboard-import-fps:MJ-3536N | top | PTH |  | silkscreen prints GATE
HEADPHONE0 | HEADPHONE | NEUTRIX_STEREO | ioboard-import-fps:REAN_1_4STERO | top | PTH |  | silkscreen prints HEADPHONE
IC20 | IC20 | 7805 | ioboard-import-fps:78XXS | top | PTH
IC21 | IC21 | 78L06Z | ioboard-import-fps:TO-92_x0x | top | PTH
IC22 | IC22 | LM336Z-5.0 | ioboard-import-fps:TO-92_x0x | top | PTH
IC23 | IC23 | AN656N | ioboard-import-fps:DIL08 | top | PTH
IC24 | IC24 | 4N37 | ioboard-import-fps:DIL06 | top | PTH
IC25 | IC25 | FT232 | ioboard-import-fps:SQFP-S-7X7-32 | bottom | SMD
J3 | J3 | MA12-'' | ioboard-import-fps:MA12-1 | top | PTH
J4 | J4 | MA03-'' | ioboard-import-fps:MA03-1 | top | PTH
J5 | J5 | MA03-'' | ioboard-import-fps:MA03-1 | top | PTH
J6 | J6 | MA03-'' | ioboard-import-fps:MA03-1 | top | PTH
J7 | J7 | MA03-'' | ioboard-import-fps:MA03-1 | top | PTH
KK1 | KK1 | D03S | ioboard-import-fps:D03S | top | none
MIXIN0 | MIXIN | NEUTRIX_STEREO | ioboard-import-fps:REAN_1_4STERO | top | PTH |  | silkscreen prints MIXIN
MIXOUT0 | MIXOUT | NEUTRIX_STEREO | ioboard-import-fps:REAN_1_4STERO | top | PTH |  | silkscreen prints MIXOUT
POWER0 | POWER | 2.1MMJACK | ioboard-import-fps:PJ-202AH | top | PTH |  | silkscreen prints POWER
Q50 | Q50 | 2SC536F | ioboard-import-fps:2SC536F | top | PTH
R1 | R1 | 100 | ioboard-import-fps:0207_5V | top | PTH
R2 | R2 | 1k | ioboard-import-fps:0207_5V | top | PTH
R3 | R3 | 6.8k | ioboard-import-fps:0207_5V | top | PTH
R4 | R4 | 5.6k | ioboard-import-fps:0207_5V | top | PTH
R5 | R5 | 2.4k | ioboard-import-fps:0207_5V | top | PTH
R6 | R6 | 27 | ioboard-import-fps:0207_5V | top | PTH
R7 | R7 | 27 | ioboard-import-fps:0207_5V | top | PTH
R8 | R8 | 1.5k | ioboard-import-fps:0207_5V | top | PTH
R9 | R9 | 4.7k | ioboard-import-fps:0207_5V | top | PTH
R10 | R10 | 10k | ioboard-import-fps:0207_5V | top | PTH
R11 | R11 | 10K | ioboard-import-fps:0207_5V | top | PTH
R12 | R12 | 470 | ioboard-import-fps:0207_5V | top | PTH
R13 | R13 | 220 | ioboard-import-fps:0207_5V | top | PTH
R14 | R14 | 220 | ioboard-import-fps:0207_5V | top | PTH
R15 | R15 | 220 | ioboard-import-fps:0207_5V | top | PTH
R16 | R16 | 100 | ioboard-import-fps:0207_5V | top | PTH
R17 | R17 | 1k | ioboard-import-fps:0207_5V | top | PTH
R18 | R18 | 220 | ioboard-import-fps:0207_5V | top | PTH
R19 | R19 | 220 | ioboard-import-fps:0207_5V | top | PTH
R20 | R20 | 22 | ioboard-import-fps:0207_5V | top | PTH
R21 | R21 | 2.2K | ioboard-import-fps:0207_5V | top | PTH
R22 | R22 | 2.2K | ioboard-import-fps:0207_5V | top | PTH
R23 | R23 | 2.2K | ioboard-import-fps:0207_5V | top | PTH
R24 | R24 | 2.2K | ioboard-import-fps:0207_5V | top | PTH
R25 | R25 | 100K | ioboard-import-fps:0207_5V | top | PTH
R26 | R26 | 100K | ioboard-import-fps:0207_5V | top | PTH
R27 | R27 | 100K | ioboard-import-fps:0207_5V | top | PTH
R28 | R28 | 100K | ioboard-import-fps:0207_5V | top | PTH
R164 | R164 | 10 | ioboard-import-fps:0207_5V | top | PTH
R178 | R178 | 2.2k | ioboard-import-fps:0207_5V | top | PTH
R179 | R179 | 1.8k | ioboard-import-fps:0207_5V | top | PTH
R186 | R186 | 10 | ioboard-import-fps:0207_5V | top | PTH
TM6 | TM6 | 2k | ioboard-import-fps:306 | top | PTH
USB0 | USB | ACON_TYPEB'' | ioboard-import-fps:PN61729 | top | PTH |  | silkscreen prints USB
XTL2 | XTL2 | 6.00MHz | ioboard-import-fps:Resonator_6MHz_x0x | top | PTH
