cozycactus/x0xb0x-hardware/kicad-working/validation/models-review-10/led-assembly-quality/Generic_LED5mm_STD240B_6p096_ClearBody_FullLeads.step

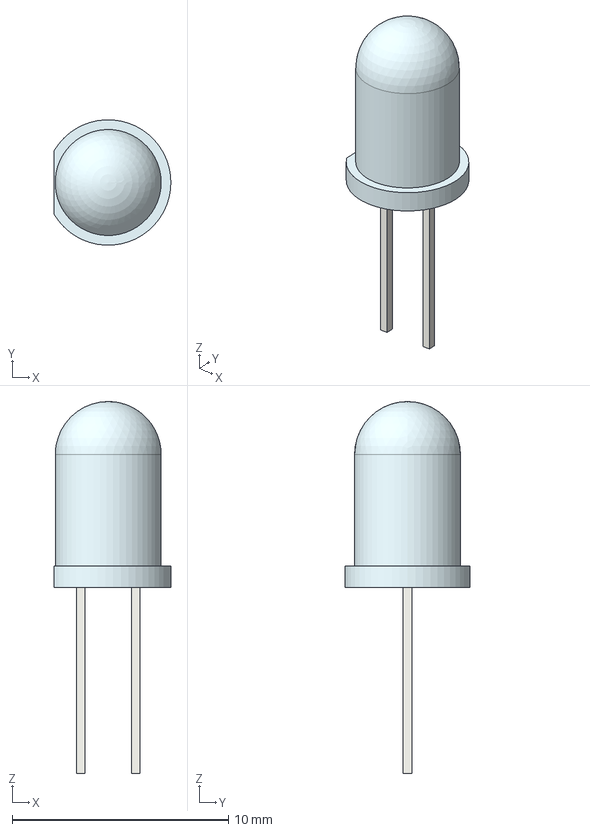
[picture p23: CAD file, 2026-10-14]
kicad-working/validation/models-review-10/led-assembly-quality/Generic_LED5mm_STD240B_6p096_ClearBody_FullLeads.step
5.40 x 5.79 x 17.2 mm
ClearLensBody
CathodeFullWidthLead
AnodeFullWidthLead
