cozycactus/x0xb0x-hardware/kicad-working/validation/models-review-19/led-spacer-quality/CathodeFullWidthLead.stl

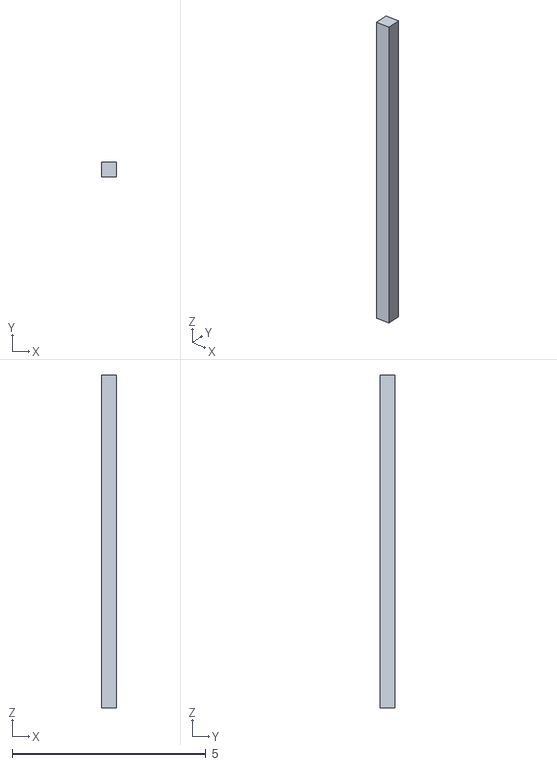
[picture p24: CAD file, 2026-10-14]
kicad-working/validation/models-review-19/led-spacer-quality/CathodeFullWidthLead.stl
0.4 x 0.4 x 8.60
