cozycactus/x0xb0x-hardware/kicad-working/validation/models-review-11/transistor-quality/Sanyo_2SC536_NP2003A_Typical_InlineForm_Illustration--BaseFullWidthLead.stl

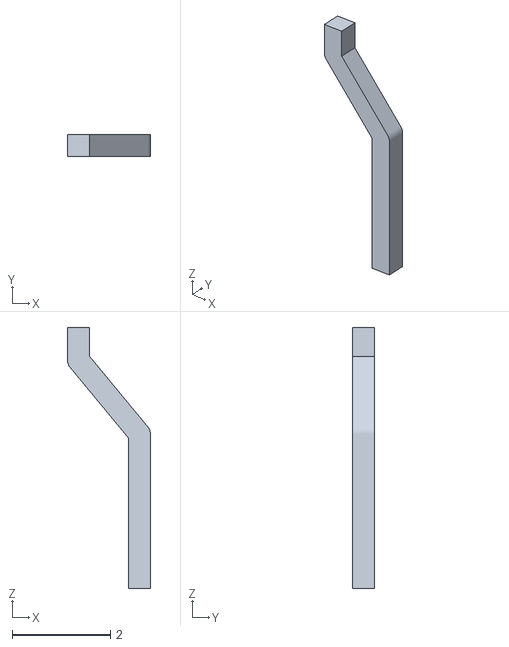
[picture p28: CAD file, 2026-10-14]
kicad-working/validation/models-review-11/transistor-quality/Sanyo_2SC536_NP2003A_Typical_InlineForm_Illustration--BaseFullWidthLead.stl
1.69 x 0.44 x 5.32
