cozycactus/x0xb0x-hardware/kicad-working/validation/models-review-11/transistor-quality/Sanyo_2SC536_NP2003A_Typical_AsymmetricForm_Illustration--EmitterFullWidthLead.stl

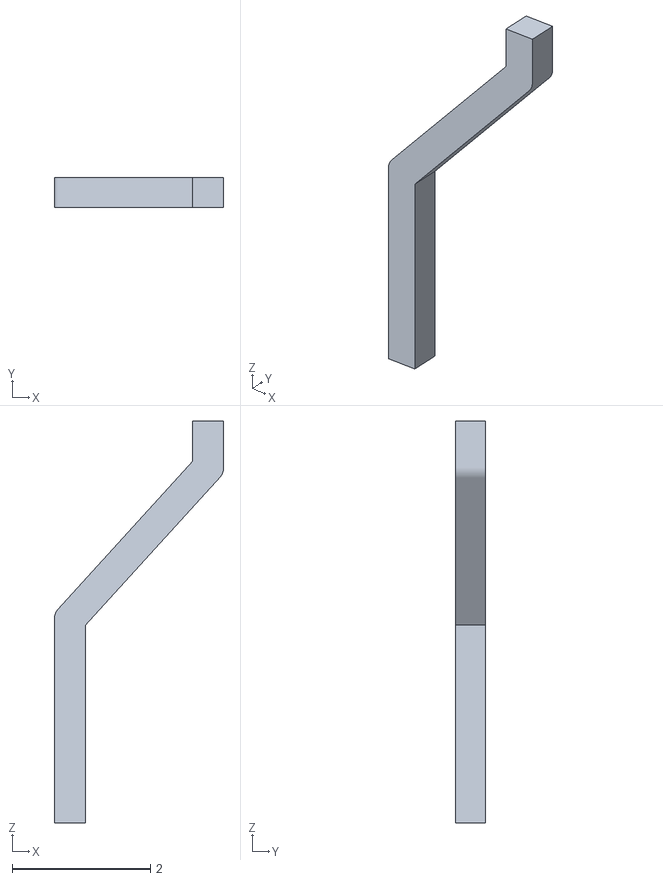
[picture p29: CAD file, 2026-10-14]
kicad-working/validation/models-review-11/transistor-quality/Sanyo_2SC536_NP2003A_Typical_AsymmetricForm_Illustration--EmitterFullWidthLead.stl
2.45 x 0.44 x 5.82
