cozycactus/x0xb0x-hardware/kicad-working/ioboard/3dmodels/Project/D_DO41_P11.176_Illustration.step

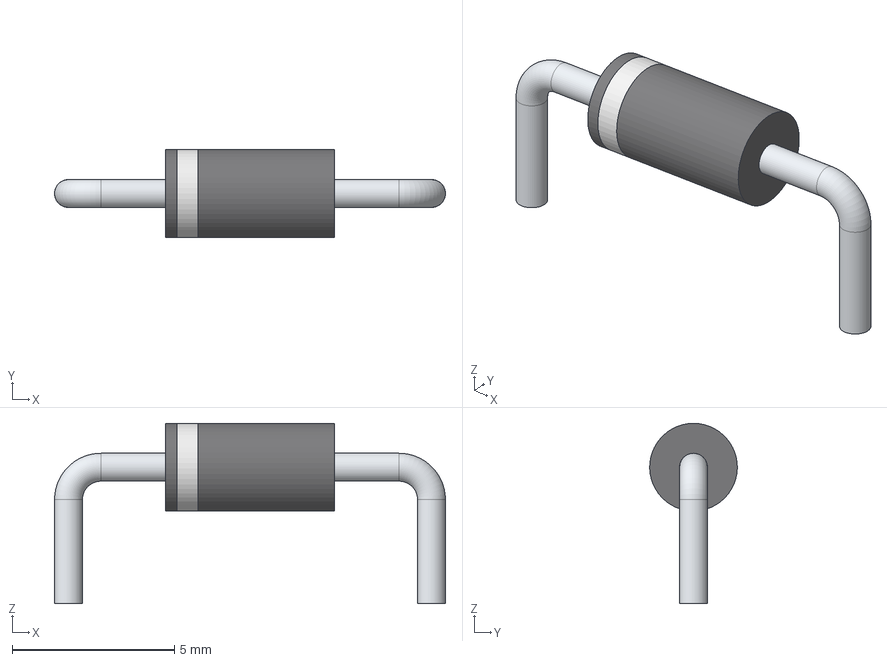
[picture p30: CAD file, 2026-10-14]
kicad-working/ioboard/3dmodels/Project/D_DO41_P11.176_Illustration.step
12.0 x 2.70 x 5.55 mm
