cozycactus/x0xb0x-hardware/kicad-working/ioboard/3dmodels/Revision24/marking-quality/DIP-6_W7.62mm_Marked_4N37.step

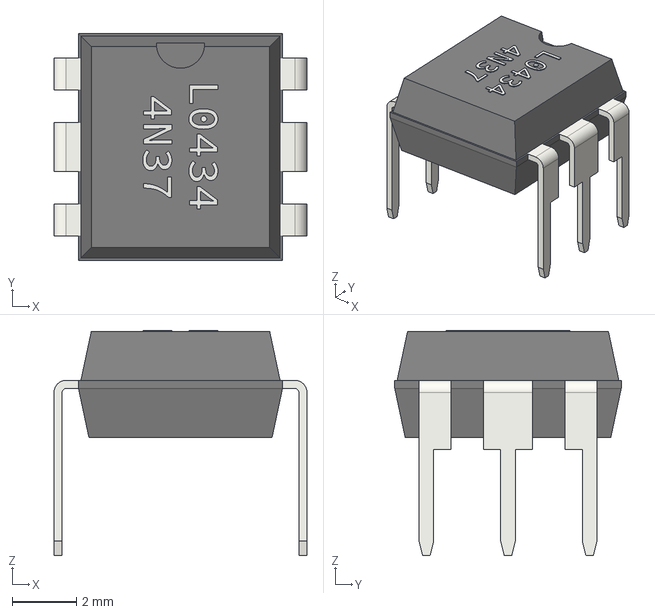
[picture p31: CAD file, 2026-10-16]
kicad-working/ioboard/3dmodels/Revision24/marking-quality/DIP-6_W7.62mm_Marked_4N37.step
7.87 x 7.05 x 7.01 mm
