cozycactus/x0xb0x-hardware/kicad-working/mainboard/3dmodels/Project/D_DO35_P7.112_Illustration.step

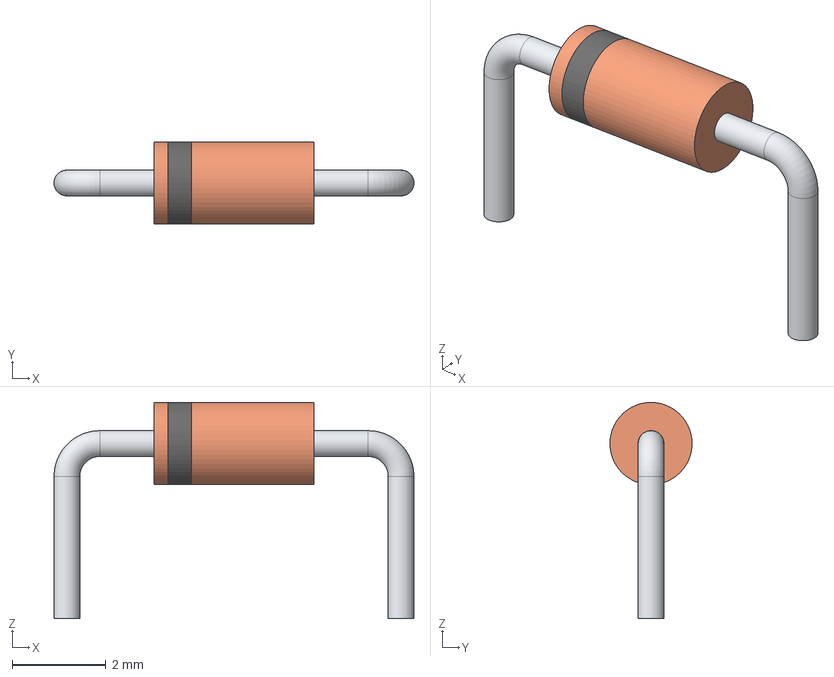
[picture p32: CAD file, 2026-10-14]
kicad-working/mainboard/3dmodels/Project/D_DO35_P7.112_Illustration.step
7.66 x 1.75 x 4.60 mm
