cozycactus/x0xb0x-hardware/kicad-working/mainboard/3dmodels/Revision24/marking-quality/DIP-16_W7.62mm_Marked_74HC595.step

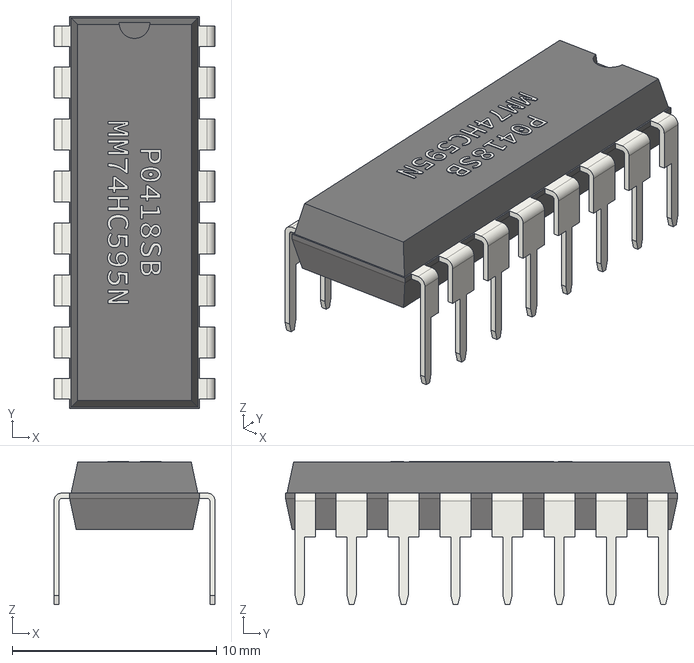
[picture p33: CAD file, 2026-10-16]
kicad-working/mainboard/3dmodels/Revision24/marking-quality/DIP-16_W7.62mm_Marked_74HC595.step
7.87 x 19.2 x 7.01 mm
