cozycactus/x0xb0x-hardware/kicad-working/validation/models-review-10/heatsink-fit-research/Aavid_574502B00000G_BentBack_PhotoQualified--BlackAnodizedSpring.stl

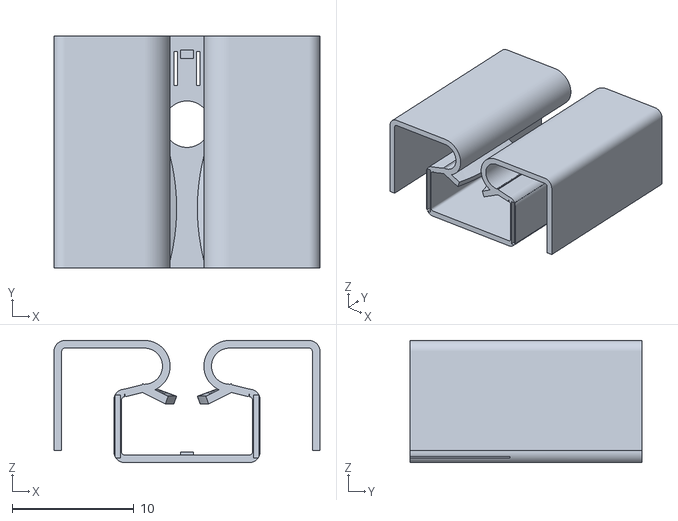
[picture p34: CAD file, 2026-10-14]
kicad-working/validation/models-review-10/heatsink-fit-research/Aavid_574502B00000G_BentBack_PhotoQualified--BlackAnodizedSpring.stl
21.8 x 19.1 x 10.0
