cozycactus/x0xb0x-hardware/kicad-working/validation/models-review-10/led-assembly-quality/sources/official-KiCad-LED_D5.0mm-original.step

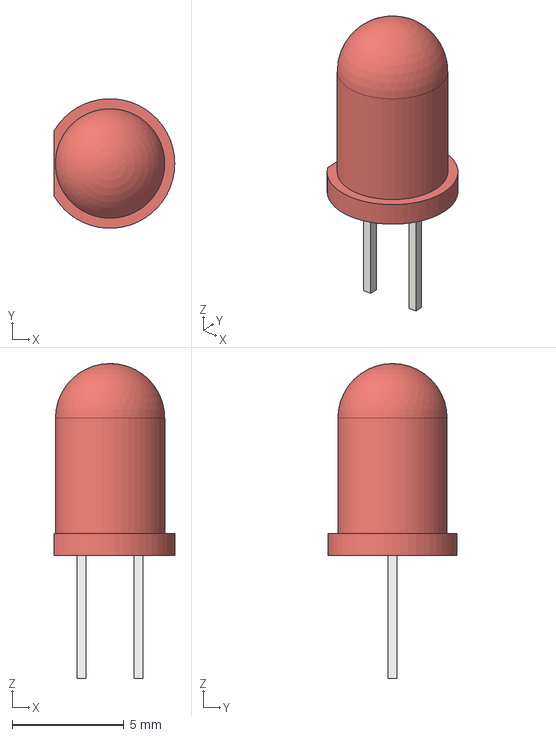
[picture p35: CAD file, 2026-10-14]
kicad-working/validation/models-review-10/led-assembly-quality/sources/official-KiCad-LED_D5.0mm-original.step
5.40 x 5.79 x 14.1 mm
