cozycactus/x0xb0x-hardware/kicad-working/validation/models-review-10/rear-connector-quality/MJ3536N_DrawingDerived_DetailedBody--SlopedOpenHousing.stl

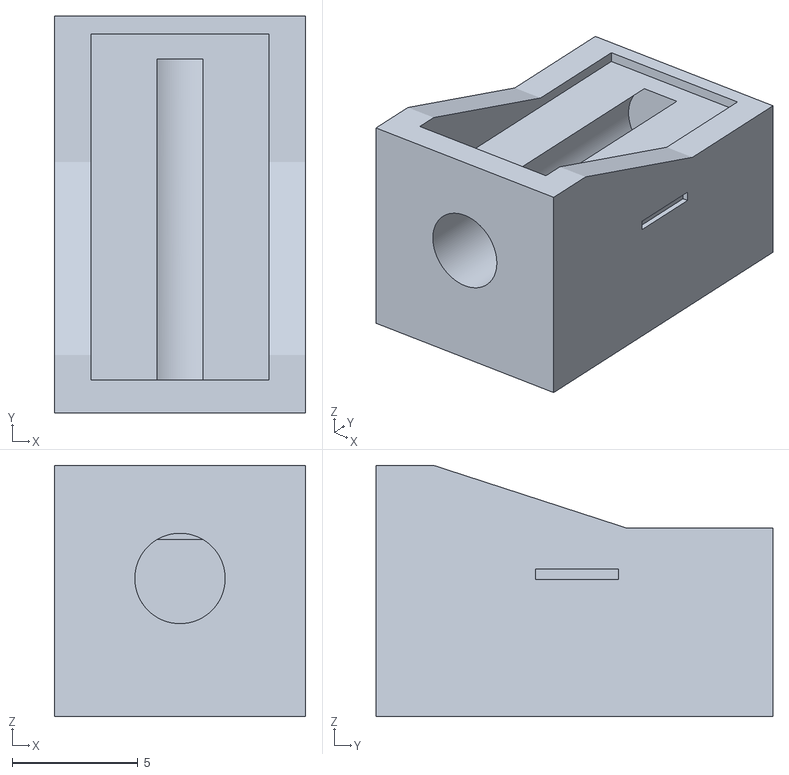
[picture p36: CAD file, 2026-10-14]
kicad-working/validation/models-review-10/rear-connector-quality/MJ3536N_DrawingDerived_DetailedBody--SlopedOpenHousing.stl
10.0 x 15.8 x 10.0
