cozycactus/x0xb0x-hardware/kicad-working/validation/models-review-12/din-contact-quality/MatingSocket1.stl

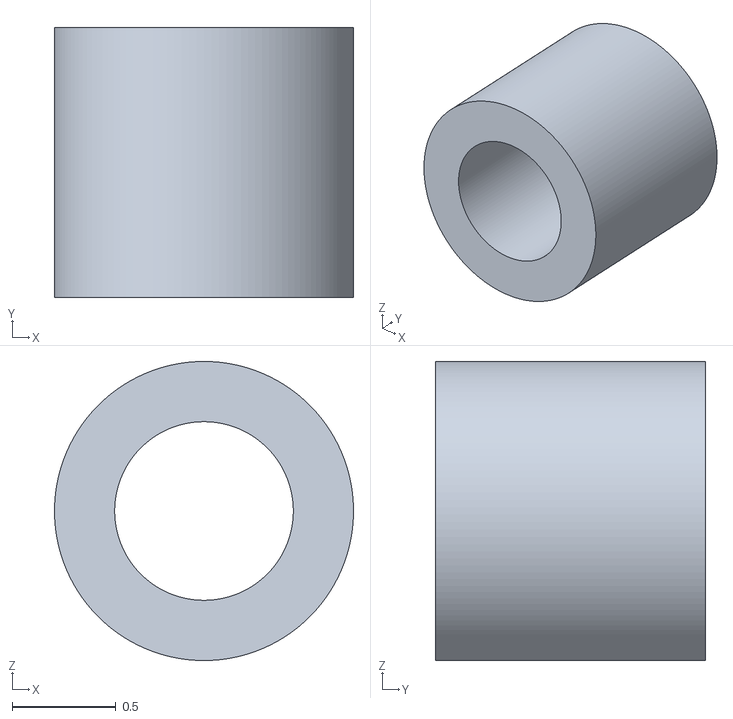
[picture p39: CAD file, 2026-10-14]
kicad-working/validation/models-review-12/din-contact-quality/MatingSocket1.stl
1.44 x 1.30 x 1.44
