cozycactus/x0xb0x-hardware/kicad-working/validation/models-review-16/grayhill-quality/Grayhill_25LB22H_PhotoDrawing.step

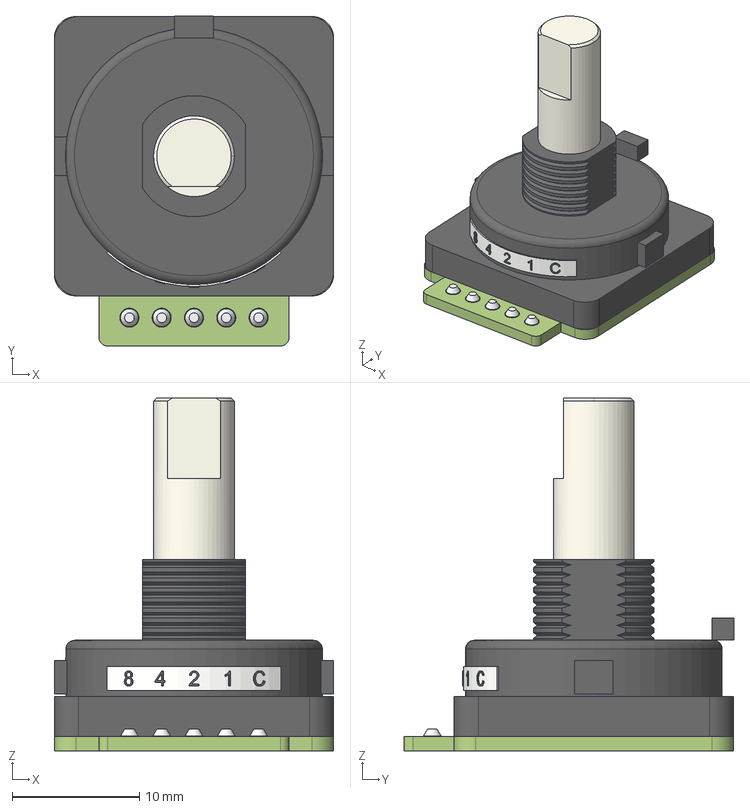
[picture p40: CAD file, 2026-10-15]
kicad-working/validation/models-review-16/grayhill-quality/Grayhill_25LB22H_PhotoDrawing.step
22.0 x 26.0 x 27.8 mm
FR4OutputBoard
OutputBoardLands
SolderJoints
BlackMoldedHousing
LabelBand
LabelText
ThreadedDoubleDBushing
LightPolymerFlattedShaft
IntegralNonTurnTab
