cozycactus/x0xb0x-hardware/kicad-working/validation/models-review-18/usb-quality/Insulator.stl

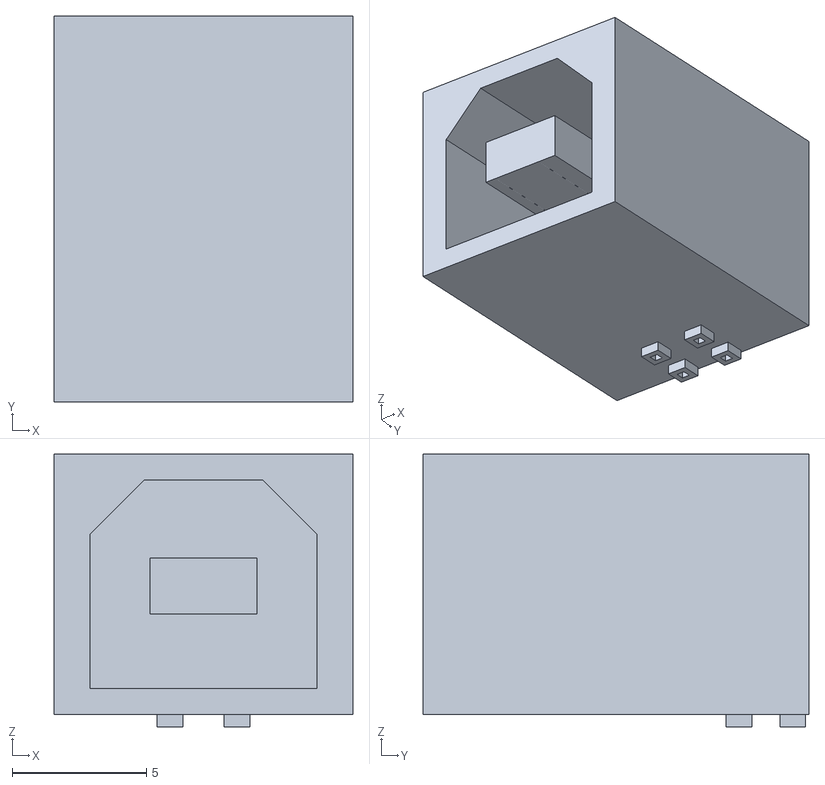
[picture p41: CAD file, 2026-10-15]
kicad-working/validation/models-review-18/usb-quality/Insulator.stl
11.1 x 14.4 x 10.2
