cozycactus/x0xb0x-hardware/kicad-working/validation/models-review-19/led-spacer-quality/LED5mm_STD240B_WithSpacer.step

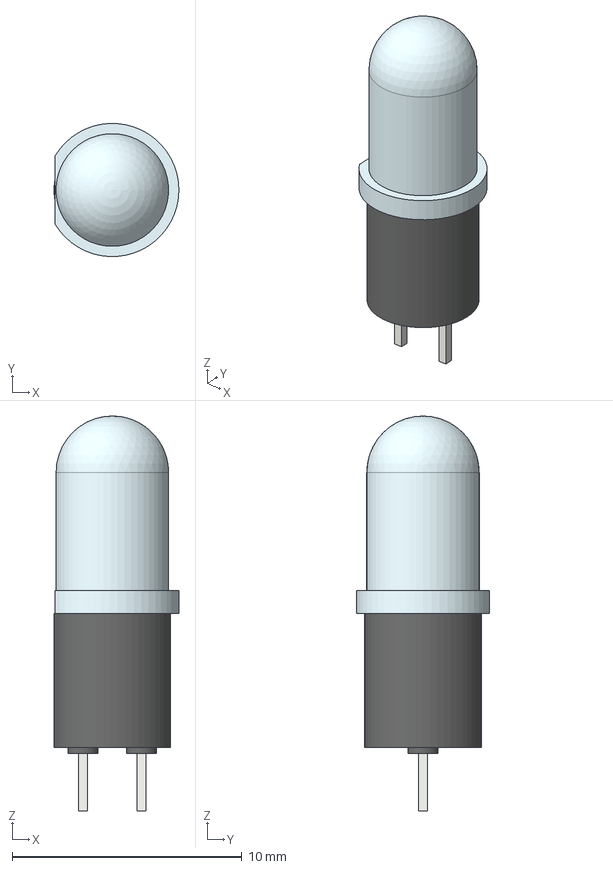
[picture p42: CAD file, 2026-10-15]
kicad-working/validation/models-review-19/led-spacer-quality/LED5mm_STD240B_WithSpacer.step
5.44 x 5.79 x 17.2 mm
ClearLensBody
CathodeFullWidthLead
AnodeFullWidthLead
BlackSTD240BSpacer
