cozycactus/x0xb0x-hardware/kicad-working/validation/models-review-20/ptc-quality/Body.stl

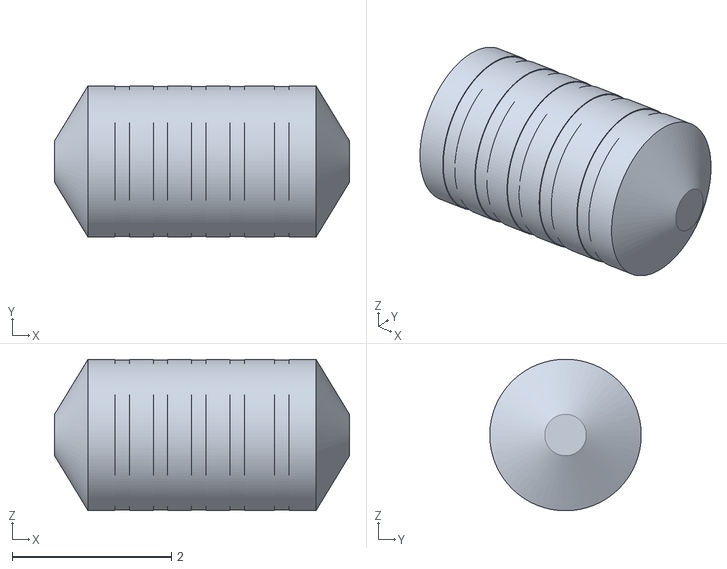
[picture p43: CAD file, 2026-10-15]
kicad-working/validation/models-review-20/ptc-quality/Body.stl
3.70 x 1.90 x 1.90
