cozycactus/x0xb0x-hardware/kicad-working/validation/models-review-21/electrolytic-quality/CP_Xicon_XRL_D5.0x11_P2.54_KiCadFrame.step

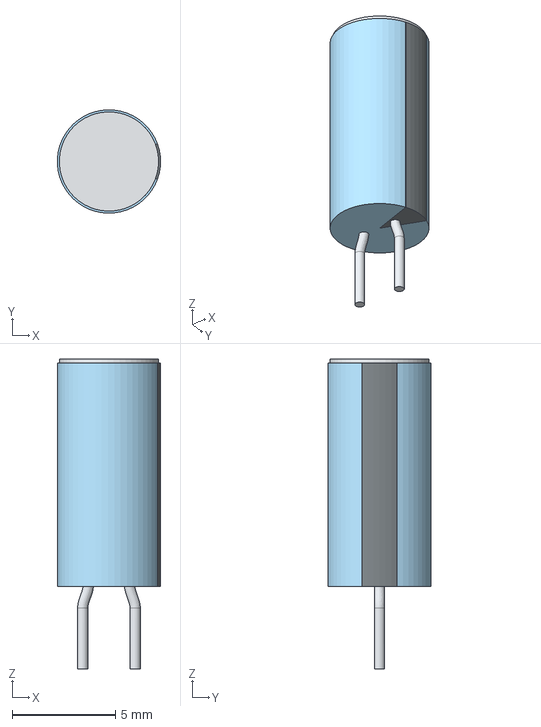
[picture p44: CAD file, 2026-10-15]
kicad-working/validation/models-review-21/electrolytic-quality/CP_Xicon_XRL_D5.0x11_P2.54_KiCadFrame.step
5.00 x 5.00 x 15.0 mm
