cozycactus/x0xb0x-hardware/kicad-working/validation/models-review-22/resistor-quality/R_DIN0207_P5.08mm_Vertical_Brown-Black-Black-Gold_KiCadBody.step

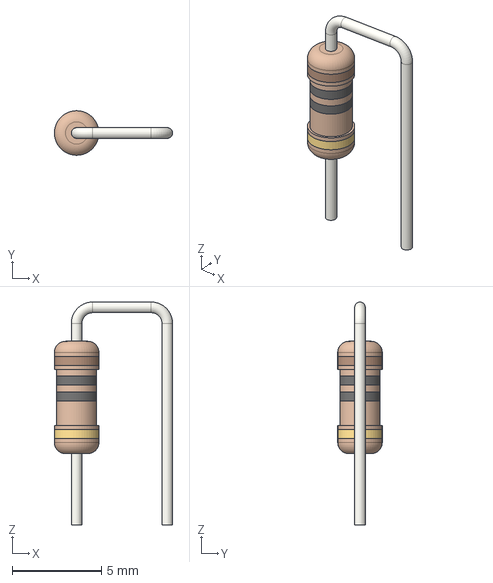
[picture p45: CAD file, 2026-10-15]
kicad-working/validation/models-review-22/resistor-quality/R_DIN0207_P5.08mm_Vertical_Brown-Black-Black-Gold_KiCadBody.step
6.63 x 2.50 x 12.5 mm
