cozycactus/x0xb0x-hardware/kicad-working/validation/models-review-23/socket-quality/DIP-8_W7.62mm_in_1-390261-2_Socket_KiCadFrame.step

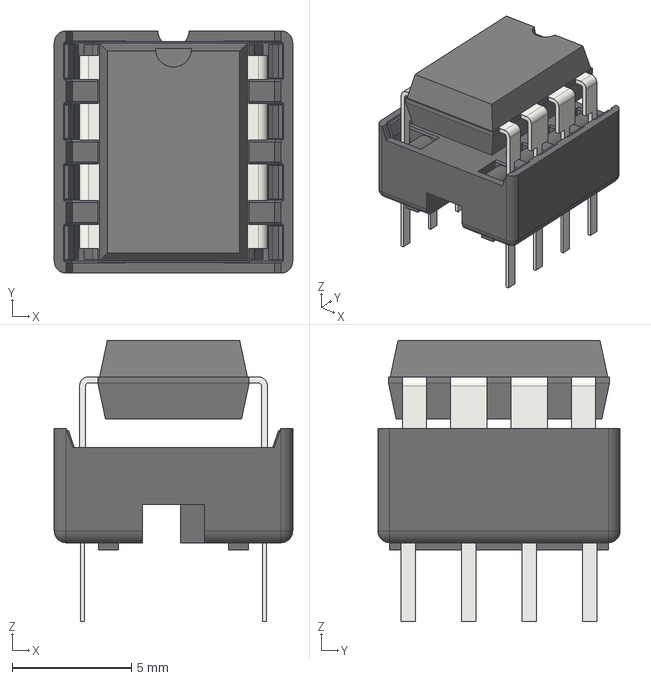
[picture p46: CAD file, 2026-10-15]
kicad-working/validation/models-review-23/socket-quality/DIP-8_W7.62mm_in_1-390261-2_Socket_KiCadFrame.step
10.0 x 10.2 x 11.8 mm
