cozycactus/x0xb0x-hardware/kicad-working/validation/models-review-24/marking-quality/DIP-16_W7.62mm_Marked_74HC165.step

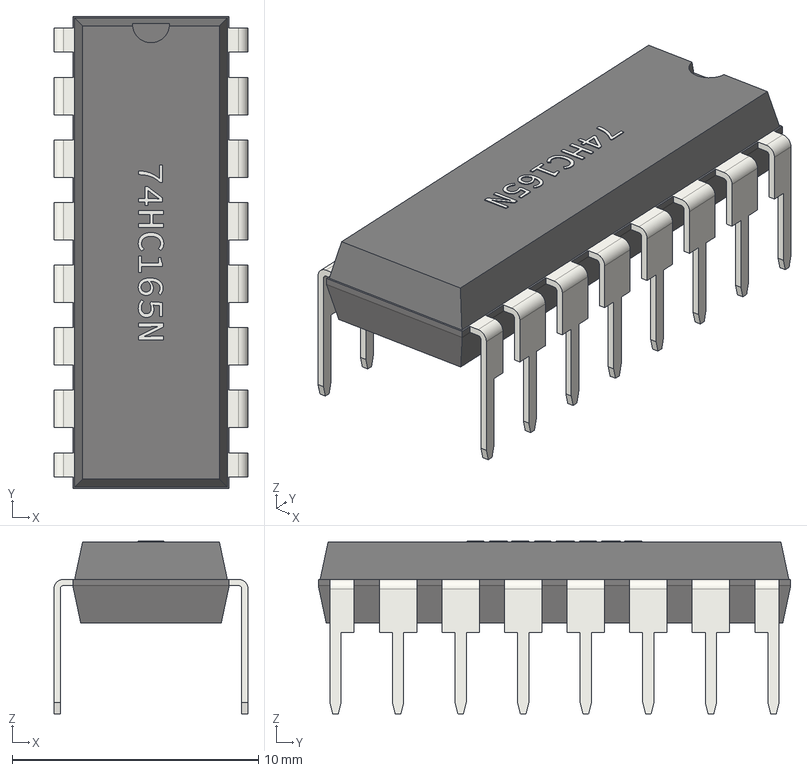
[picture p47: CAD file, 2026-10-16]
kicad-working/validation/models-review-24/marking-quality/DIP-16_W7.62mm_Marked_74HC165.step
7.87 x 19.2 x 7.01 mm
