cozycactus/x0xb0x-hardware/kicad-working/ioboard/3dmodels/Revision24/marking-quality/DIP-8_W7.62mm_Marked_AN6562.step

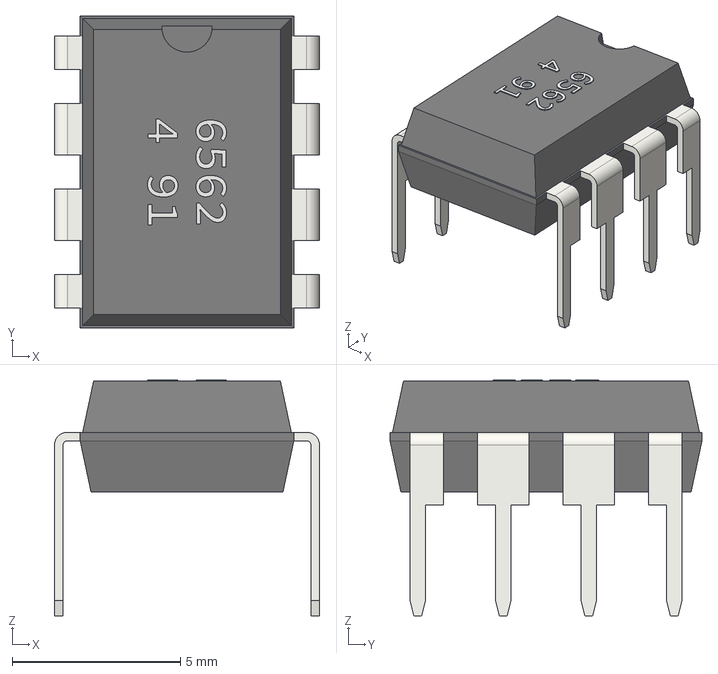
[picture p48: CAD file, 2026-10-16]
kicad-working/ioboard/3dmodels/Revision24/marking-quality/DIP-8_W7.62mm_Marked_AN6562.step
7.87 x 9.27 x 7.01 mm
