cozycactus/x0xb0x-hardware/kicad-working/validation/models-review-10/heatsink-fit-research/MC78M05_TO220_BentBack_PhotoQualified_BodyOnly--MetalTab.stl

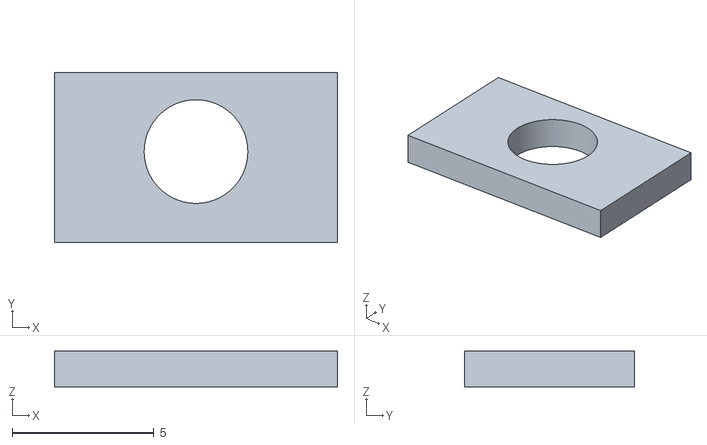
[picture p49: CAD file, 2026-10-14]
kicad-working/validation/models-review-10/heatsink-fit-research/MC78M05_TO220_BentBack_PhotoQualified_BodyOnly--MetalTab.stl
10.0 x 6.00 x 1.27
