cozycactus/x0xb0x-hardware/kicad-working/validation/models-review-10/rear-connector-quality/PJ202AH_DrawingDerived_DetailedBody--RoundedMoldedHousing.stl

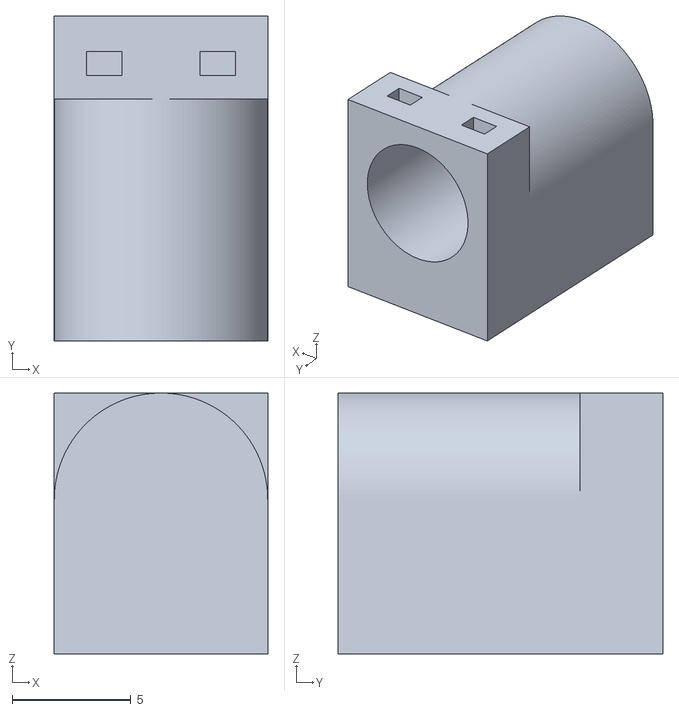
[picture p50: CAD file, 2026-10-14]
kicad-working/validation/models-review-10/rear-connector-quality/PJ202AH_DrawingDerived_DetailedBody--RoundedMoldedHousing.stl
9.00 x 13.7 x 11.0
