cozycactus/x0xb0x-hardware/kicad-working/validation/models-review-11/resonator-quality/Resonator_AWCR16MD_TaperShoulders_P2.54_Illustration--Lead3.stl

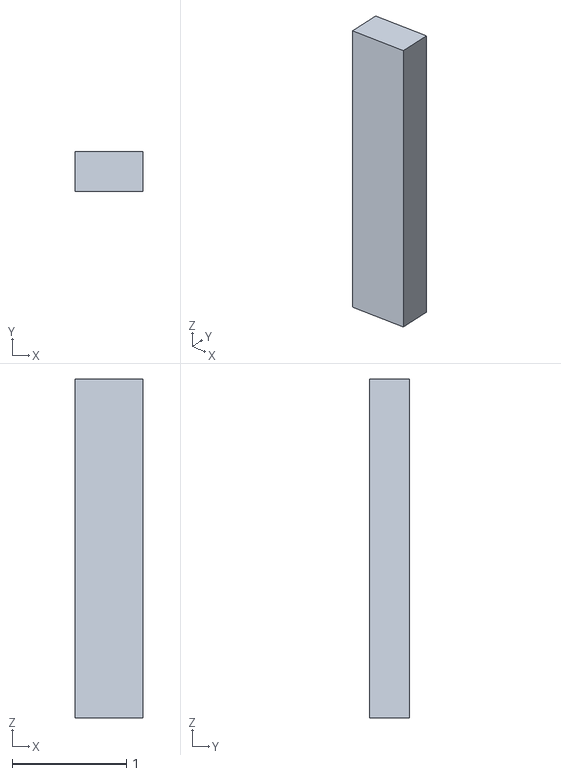
[picture p51: CAD file, 2026-10-14]
kicad-working/validation/models-review-11/resonator-quality/Resonator_AWCR16MD_TaperShoulders_P2.54_Illustration--Lead3.stl
0.6 x 0.35 x 2.97
