cozycactus/x0xb0x-hardware/kicad-working/validation/models-review-11/transistor-quality/Sanyo_2SC536_NP2003A_Typical_InlineForm_Illustration--MouldedNPBody.stl

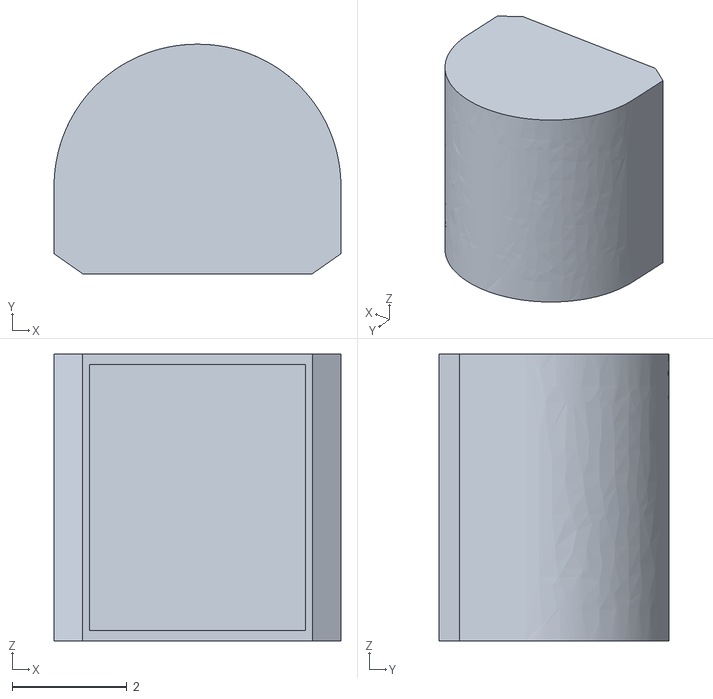
[picture p52: CAD file, 2026-10-14]
kicad-working/validation/models-review-11/transistor-quality/Sanyo_2SC536_NP2003A_Typical_InlineForm_Illustration--MouldedNPBody.stl
5.00 x 4.00 x 5.00
