cozycactus/x0xb0x-hardware/kicad-working/validation/models-review-12/din-contact-quality/SDS50J_CorrectedContactPattern.step

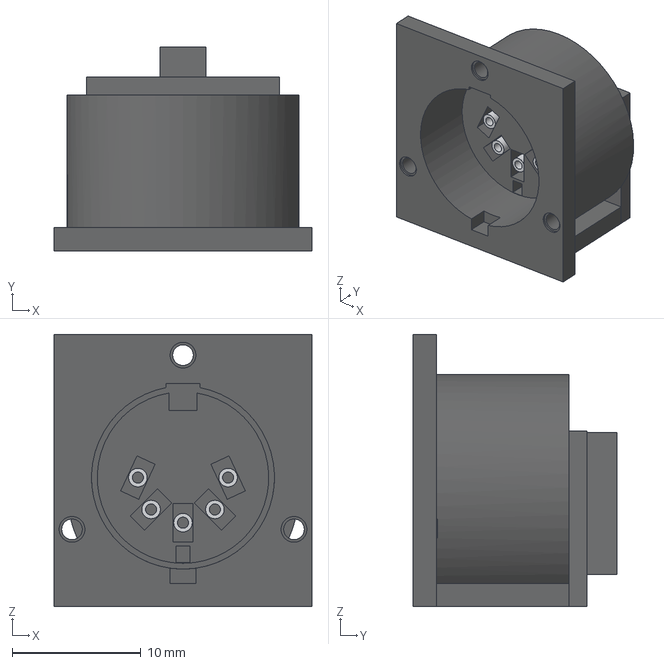
[picture p53: CAD file, 2026-10-14]
kicad-working/validation/models-review-12/din-contact-quality/SDS50J_CorrectedContactPattern.step
20.0 x 15.8 x 21.1 mm
