cozycactus/x0xb0x-hardware/kicad-working/validation/models-review-18/usb-quality/MatingContacts.stl

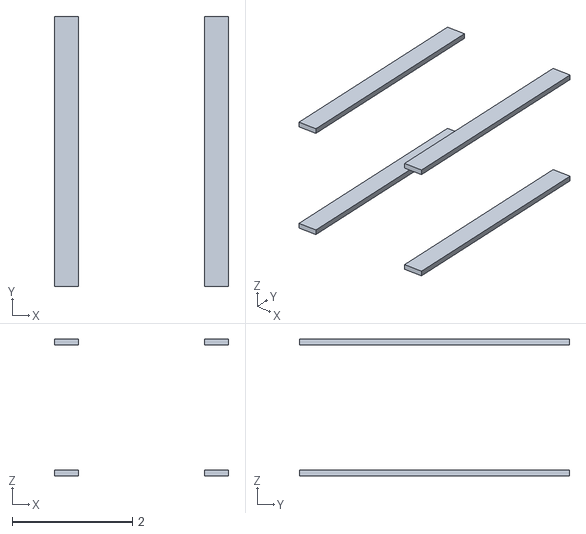
[picture p54: CAD file, 2026-10-15]
kicad-working/validation/models-review-18/usb-quality/MatingContacts.stl
2.90 x 4.50 x 2.28
