cozycactus/x0xb0x-hardware/kicad-working/validation/models-review-19/led-spacer-quality/BlackSTD240BSpacer.stl

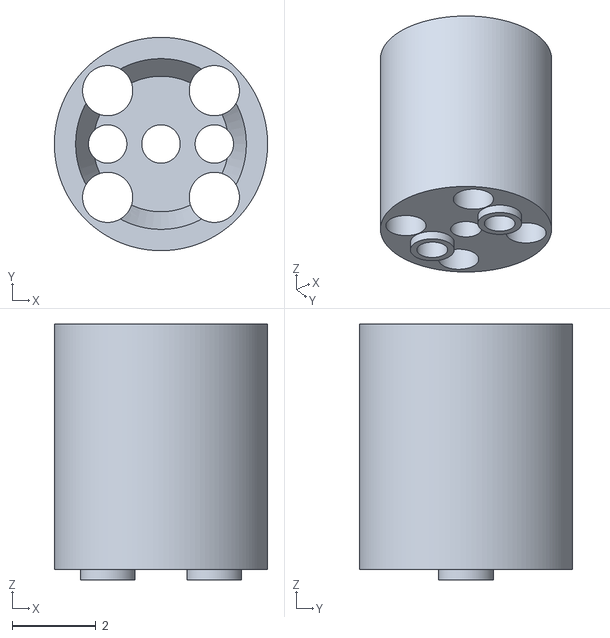
[picture p55: CAD file, 2026-10-15]
kicad-working/validation/models-review-19/led-spacer-quality/BlackSTD240BSpacer.stl
5.08 x 5.08 x 6.10
