cozycactus/x0xb0x-hardware/kicad-working/validation/models-review-20/ptc-quality/Microohm_LPTC12_PrimaryDimensions_Terminals.step

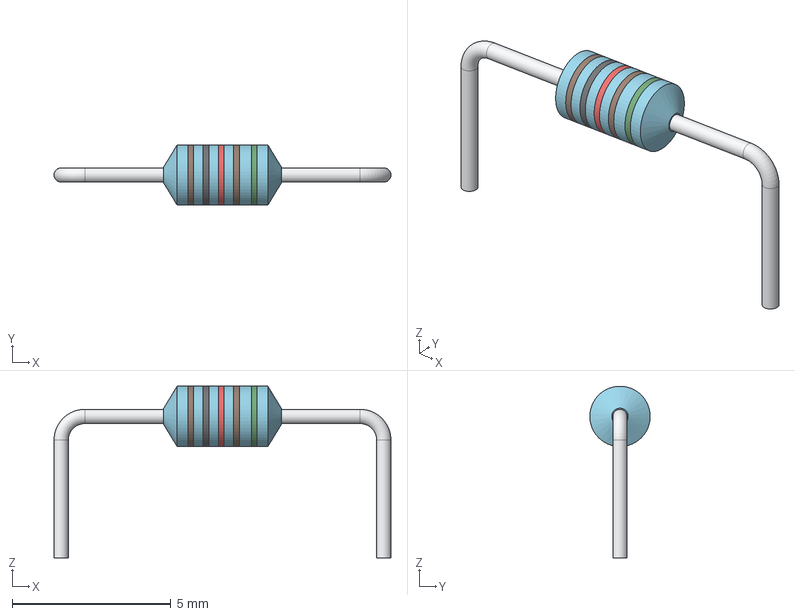
[picture p56: CAD file, 2026-10-15]
kicad-working/validation/models-review-20/ptc-quality/Microohm_LPTC12_PrimaryDimensions_Terminals.step
10.6 x 1.90 x 5.40 mm
Band1
Band2
Band3
Band4
Band5
DrawingDerivedTerminals
