cozycactus/x0xb0x-hardware/kicad-working/validation/models-review-21/electrolytic-quality/CP_Xicon_XRL_D6.3x11_P2.54_KiCadFrame.step

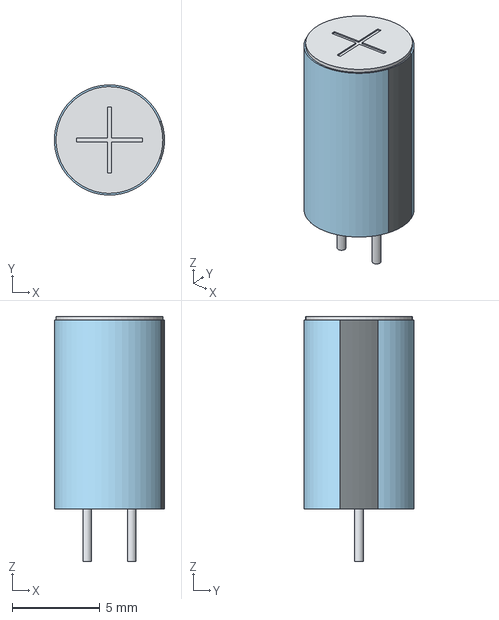
[picture p57: CAD file, 2026-10-15]
kicad-working/validation/models-review-21/electrolytic-quality/CP_Xicon_XRL_D6.3x11_P2.54_KiCadFrame.step
6.29 x 6.30 x 14.0 mm
