cozycactus/x0xb0x-hardware/kicad-working/validation/models-review-23/socket-quality/DIP-40_W15.24mm_in_1-390262-5_Socket_KiCadFrame.step

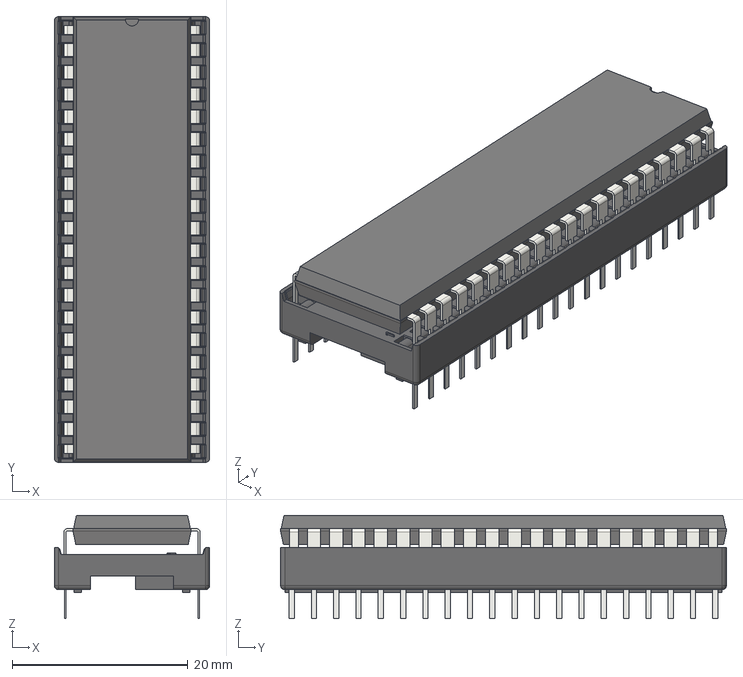
[picture p58: CAD file, 2026-10-15]
kicad-working/validation/models-review-23/socket-quality/DIP-40_W15.24mm_in_1-390262-5_Socket_KiCadFrame.step
17.7 x 50.8 x 11.8 mm
