cozycactus/x0xb0x-hardware/kicad-working/ioboard/3dmodels/Revision24/marking-quality/LQFP-32_7x7mm_P0.8mm_Marked_FT232BM.step

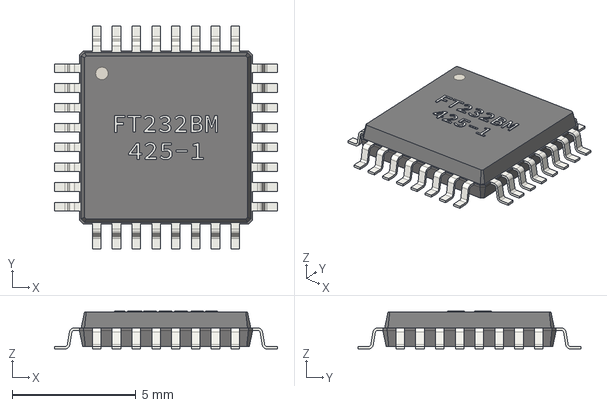
[picture p59: CAD file, 2026-10-16]
kicad-working/ioboard/3dmodels/Revision24/marking-quality/LQFP-32_7x7mm_P0.8mm_Marked_FT232BM.step
9.00 x 9.00 x 1.53 mm
