cozycactus/x0xb0x-hardware/kicad-working/validation/models-review-10/rear-connector-quality/PJ202AH_DrawingDerived_DetailedBody_Corrected--SteppedRearCover.stl

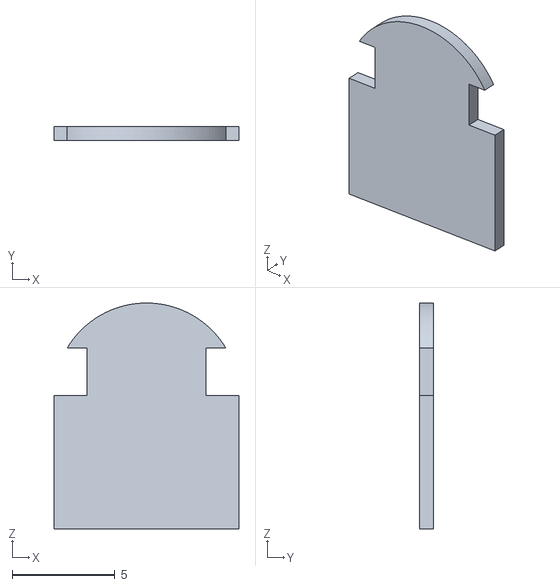
[picture p60: CAD file, 2026-10-14]
kicad-working/validation/models-review-10/rear-connector-quality/PJ202AH_DrawingDerived_DetailedBody_Corrected--SteppedRearCover.stl
9.00 x 0.7 x 11.0
