cozycactus/x0xb0x-hardware/kicad-working/validation/models-review-12/din-contact-quality/SocketInsert.stl

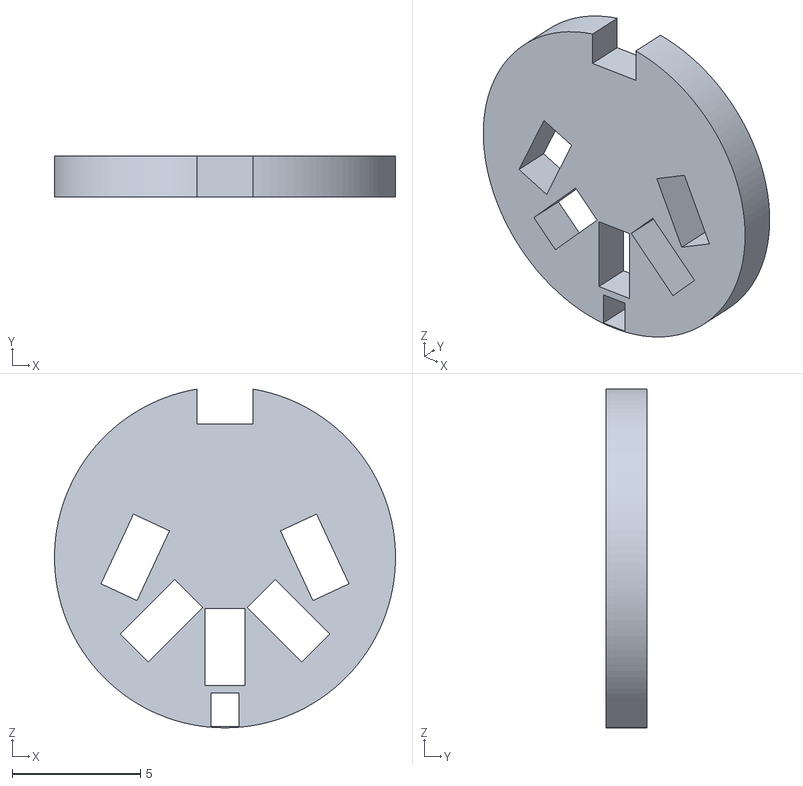
[picture p61: CAD file, 2026-10-14]
kicad-working/validation/models-review-12/din-contact-quality/SocketInsert.stl
13.3 x 1.60 x 13.2
