cozycactus/x0xb0x-hardware/kicad-working/validation/models-review-18/usb-quality/DrawingDerivedTerminals.stl

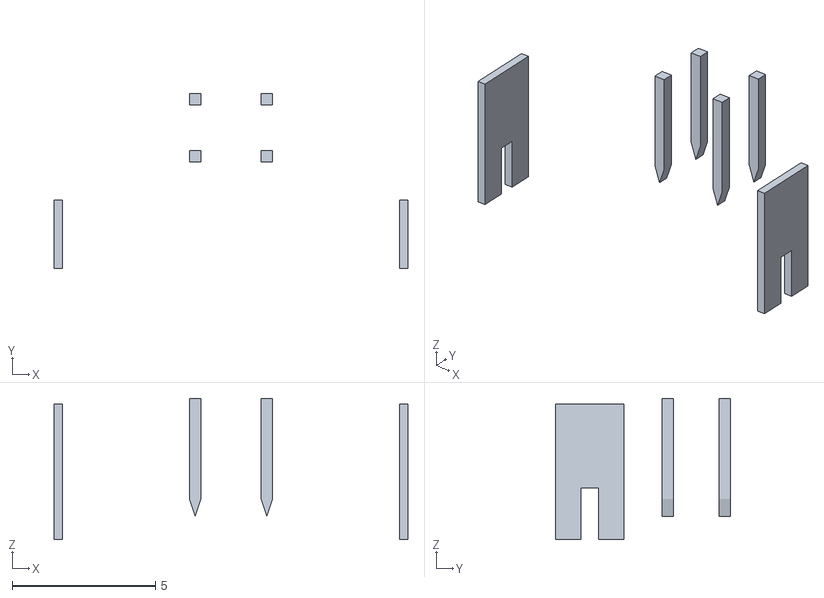
[picture p62: CAD file, 2026-10-15]
kicad-working/validation/models-review-18/usb-quality/DrawingDerivedTerminals.stl
12.3 x 6.11 x 4.92
