cozycactus/x0xb0x-hardware/kicad-working/validation/models-review-20/ptc-quality/Band2.stl

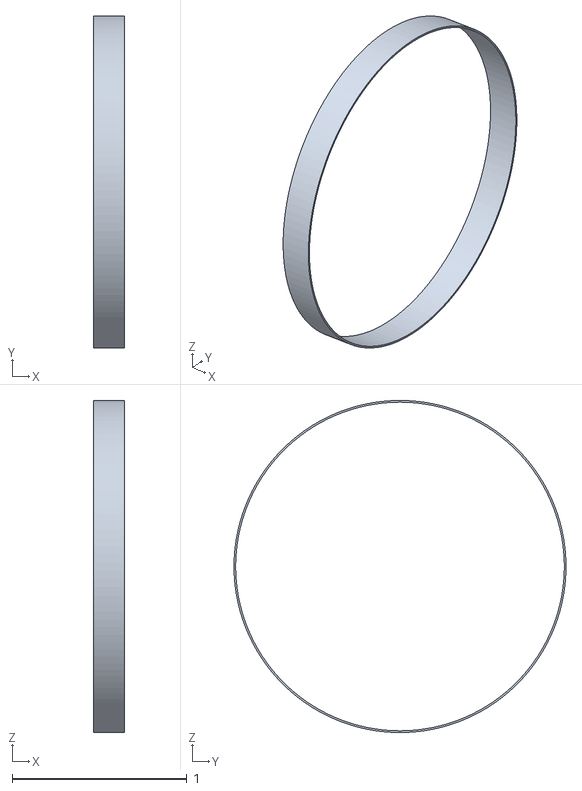
[picture p63: CAD file, 2026-10-15]
kicad-working/validation/models-review-20/ptc-quality/Band2.stl
0.18 x 1.90 x 1.90
