cozycactus/x0xb0x-hardware/kicad-working/validation/models-review-21/electrolytic-quality/CP_Xicon_XRL2200u16_P5.08_PhotoColours.step

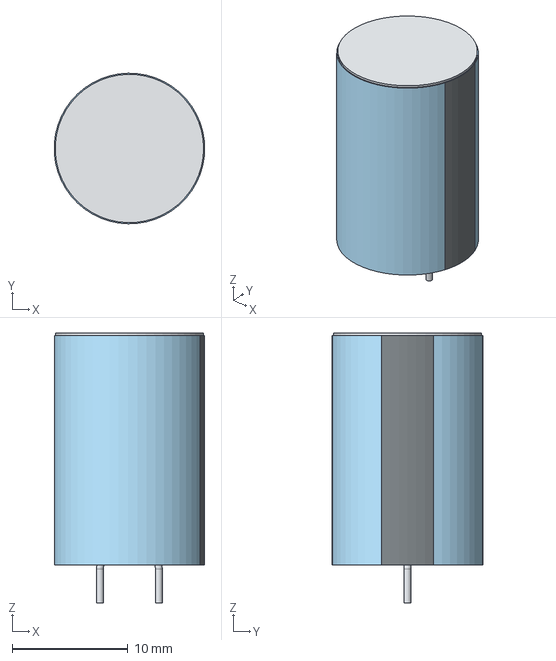
[picture p64: CAD file, 2026-10-15]
kicad-working/validation/models-review-21/electrolytic-quality/CP_Xicon_XRL2200u16_P5.08_PhotoColours.step
13.0 x 13.0 x 23.3 mm
