cozycactus/x0xb0x-hardware/kicad-working/mainboard/3dmodels/Revision24/marking-quality/DIP-14_W7.62mm_Marked_4066.step

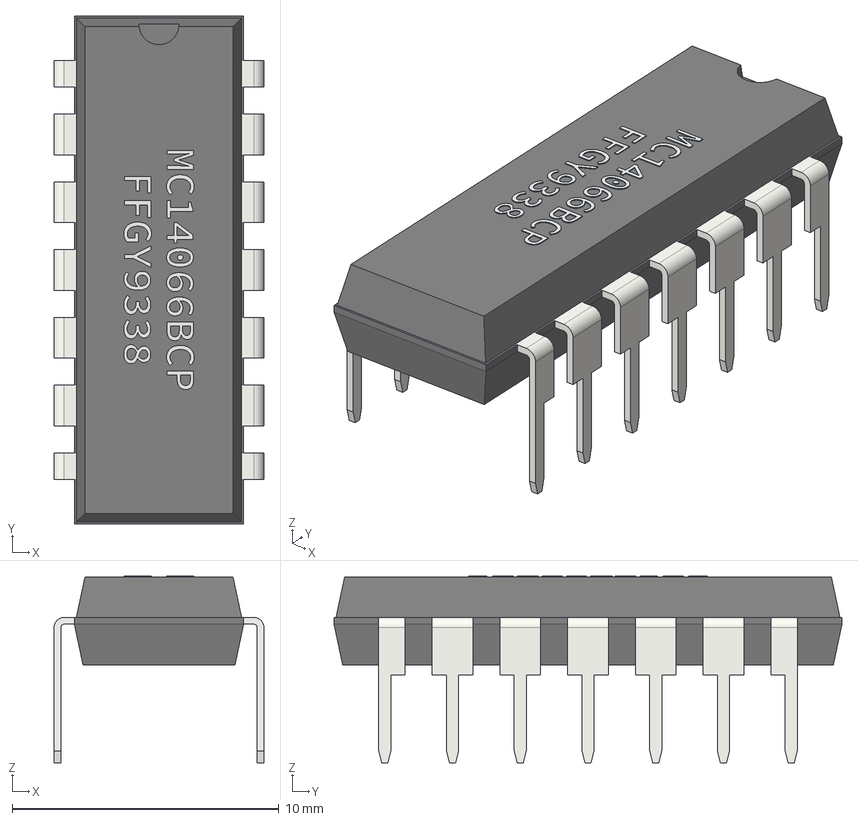
[picture p66: CAD file, 2026-10-16]
kicad-working/mainboard/3dmodels/Revision24/marking-quality/DIP-14_W7.62mm_Marked_4066.step
7.87 x 19.1 x 7.01 mm
