cozycactus/x0xb0x-hardware/kicad-working/validation/models-review-10/heatsink-fit-research/MC78M05_TO220_BentBack_PhotoQualified_BodyOnly.step

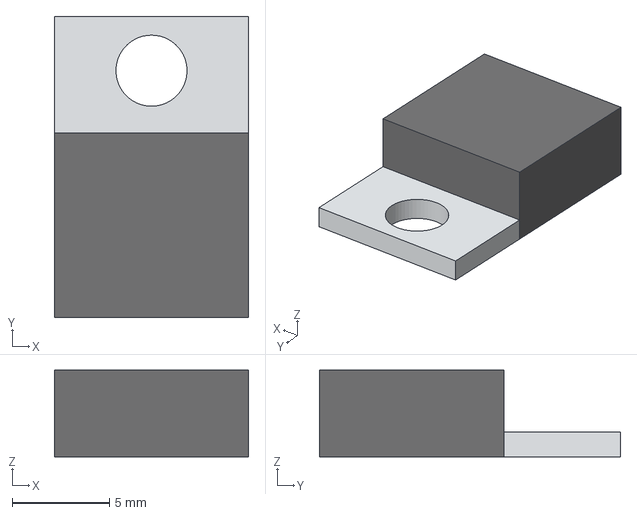
[picture p67: CAD file, 2026-10-14]
kicad-working/validation/models-review-10/heatsink-fit-research/MC78M05_TO220_BentBack_PhotoQualified_BodyOnly.step
10.0 x 15.5 x 4.46 mm
PlasticBody
MetalTab
