cozycactus/x0xb0x-hardware/kicad-working/validation/models-review-10/rear-connector-quality/PJ202AH_DrawingDerived_DetailedBody--TwoMillimetreMatingPin.stl

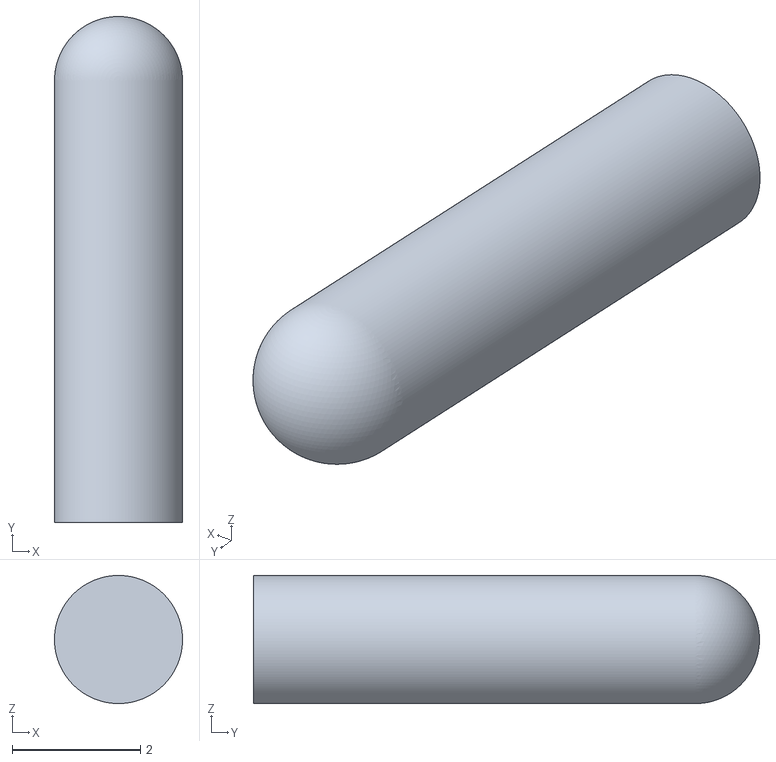
[picture p68: CAD file, 2026-10-14]
kicad-working/validation/models-review-10/rear-connector-quality/PJ202AH_DrawingDerived_DetailedBody--TwoMillimetreMatingPin.stl
2.00 x 7.90 x 2.00
