cozycactus/x0xb0x-hardware/kicad-working/validation/models-review-12/din-contact-quality/Housing.stl

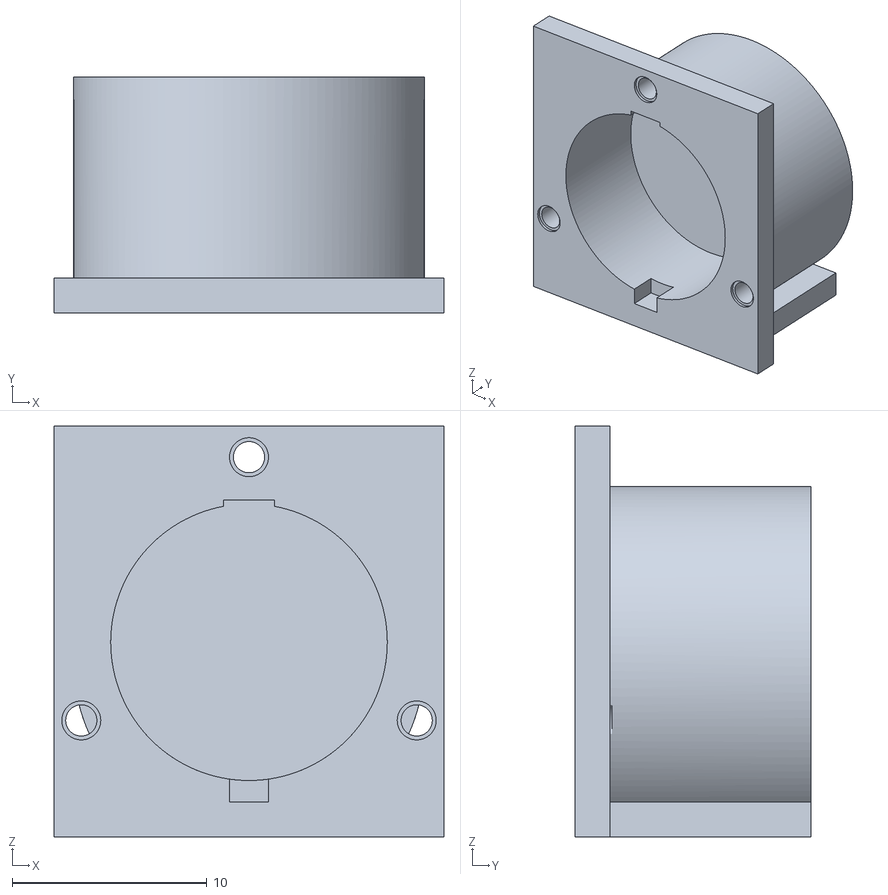
[picture p69: CAD file, 2026-10-14]
kicad-working/validation/models-review-12/din-contact-quality/Housing.stl
20.0 x 12.1 x 21.1
