cozycactus/x0xb0x-hardware/kicad-working/validation/models-review-18/usb-quality/Kobiconn1542442E_DrawingDerived_Terminals.step

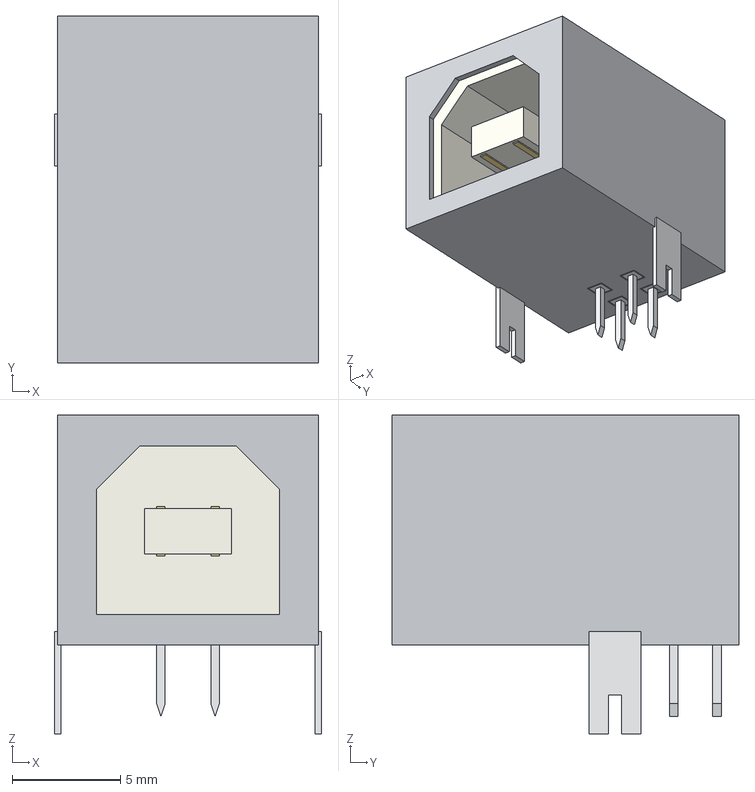
[picture p70: CAD file, 2026-10-15]
kicad-working/validation/models-review-18/usb-quality/Kobiconn1542442E_DrawingDerived_Terminals.step
12.3 x 16.0 x 14.7 mm
Insulator
DrawingDerivedTerminals
MatingContacts
