cozycactus/x0xb0x-hardware/kicad-working/validation/models-review-19/led-spacer-quality/ClearLensBody.stl

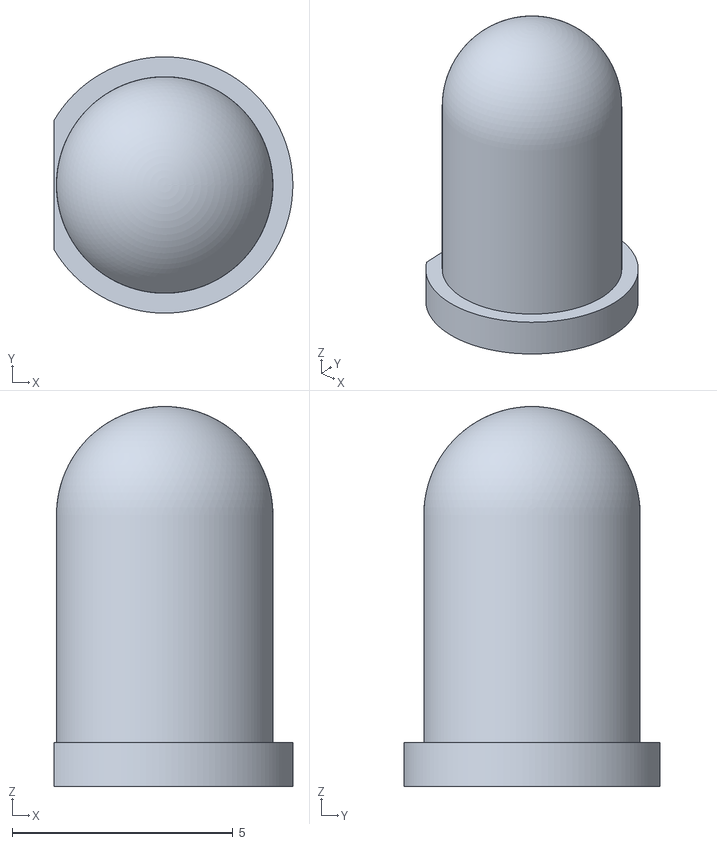
[picture p71: CAD file, 2026-10-14]
kicad-working/validation/models-review-19/led-spacer-quality/ClearLensBody.stl
5.40 x 5.80 x 8.60
