cozycactus/x0xb0x-hardware/kicad-working/validation/models-review-21/electrolytic-quality/CP_Xicon_XRL_D10x12.5_P5.08_KiCadFrame.step

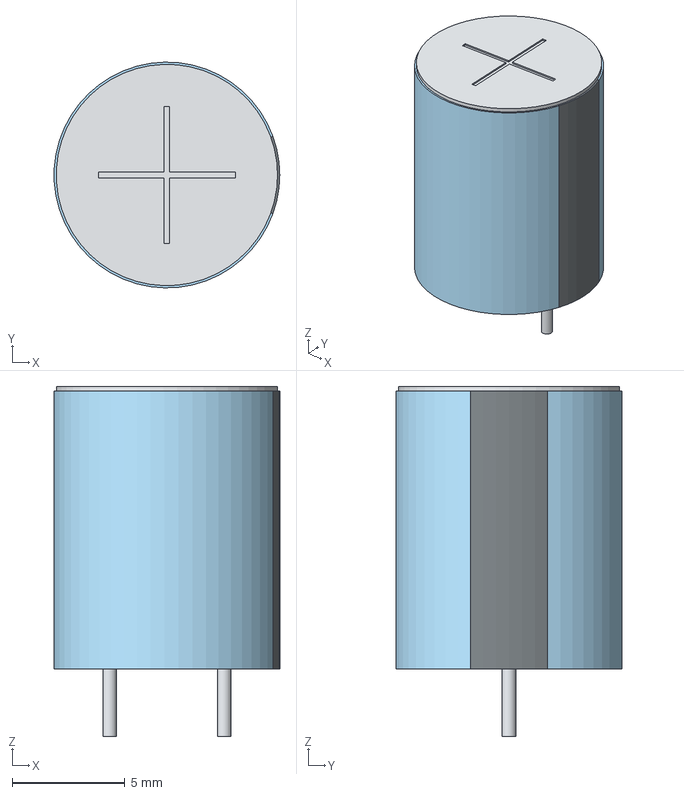
[picture p72: CAD file, 2026-10-15]
kicad-working/validation/models-review-21/electrolytic-quality/CP_Xicon_XRL_D10x12.5_P5.08_KiCadFrame.step
9.99 x 10.00 x 15.5 mm
