cozycactus/x0xb0x-hardware/kicad-working/validation/models-review-22/resistor-quality/R_DIN0207_P5.08mm_Vertical_Red-Black-Black-Orange-Brown_KiCadBody.step

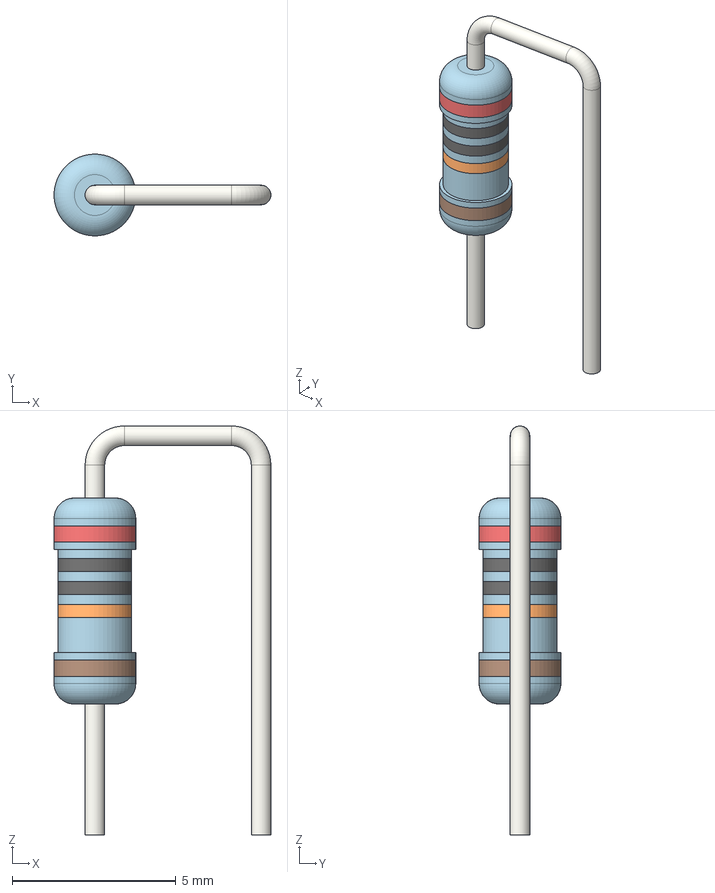
[picture p73: CAD file, 2026-10-15]
kicad-working/validation/models-review-22/resistor-quality/R_DIN0207_P5.08mm_Vertical_Red-Black-Black-Orange-Brown_KiCadBody.step
6.63 x 2.50 x 12.5 mm
