cozycactus/x0xb0x-hardware/kicad-working/mainboard/3dmodels/Revision24/marking-quality/DIP-8_W7.62mm_in_1-390261-2_Socket_KiCadFrame_Marked_EEPROM.step

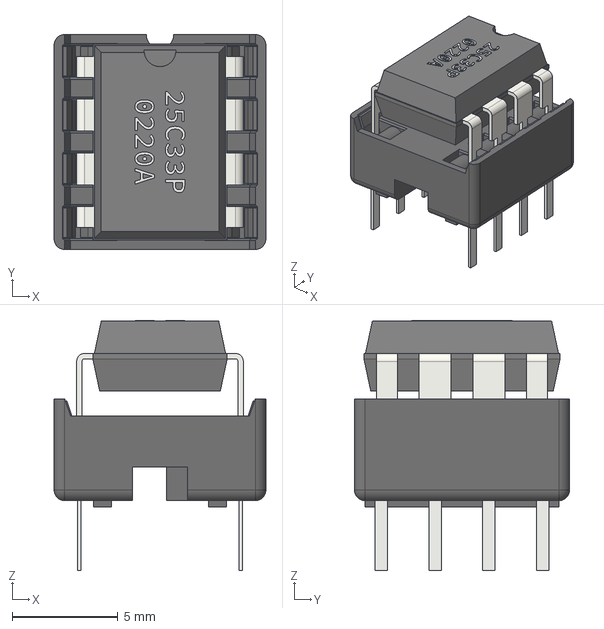
[picture p74: CAD file, 2026-10-16]
kicad-working/mainboard/3dmodels/Revision24/marking-quality/DIP-8_W7.62mm_in_1-390261-2_Socket_KiCadFrame_Marked_EEPROM.step
10.0 x 10.2 x 11.8 mm
