cozycactus/x0xb0x-hardware/kicad-working/validation/models-review-10/heatsink-fit-research/MC78M05_TO220_BentBack_PhotoQualified_BodyOnly--PlasticBody.stl

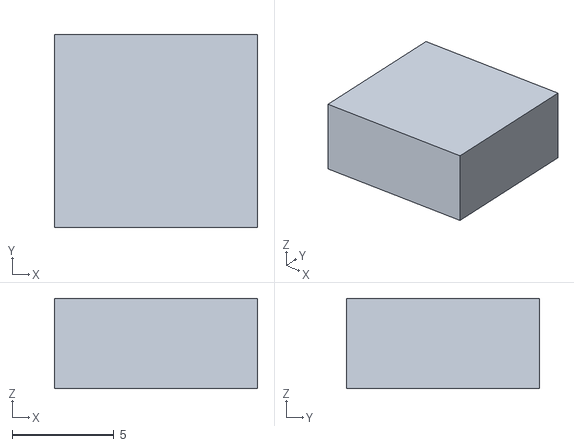
[picture p75: CAD file, 2026-10-14]
kicad-working/validation/models-review-10/heatsink-fit-research/MC78M05_TO220_BentBack_PhotoQualified_BodyOnly--PlasticBody.stl
10.0 x 9.50 x 4.46
