cozycactus/x0xb0x-hardware/kicad-working/validation/models-review-10/rear-connector-quality/MJ3536N_DrawingDerived_DetailedBody.step

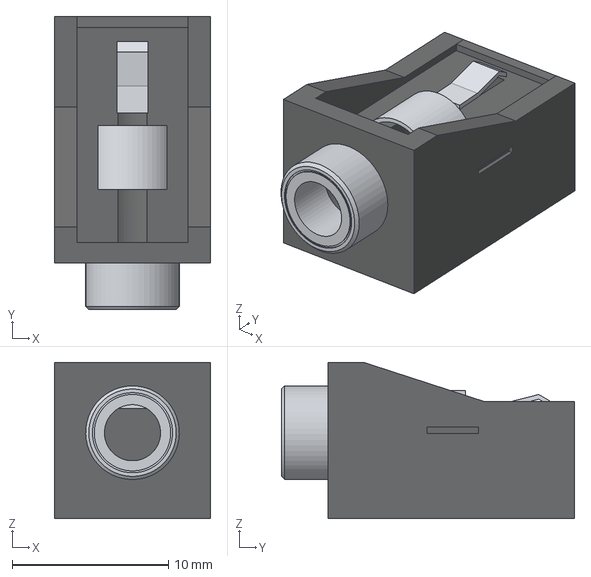
[picture p76: CAD file, 2026-10-14]
kicad-working/validation/models-review-10/rear-connector-quality/MJ3536N_DrawingDerived_DetailedBody.step
10.0 x 18.8 x 10.0 mm
