cozycactus/x0xb0x-hardware/kicad-working/validation/models-review-11/resonator-quality/Resonator_AWCR16MD_TaperShoulders_P2.54_Illustration.step

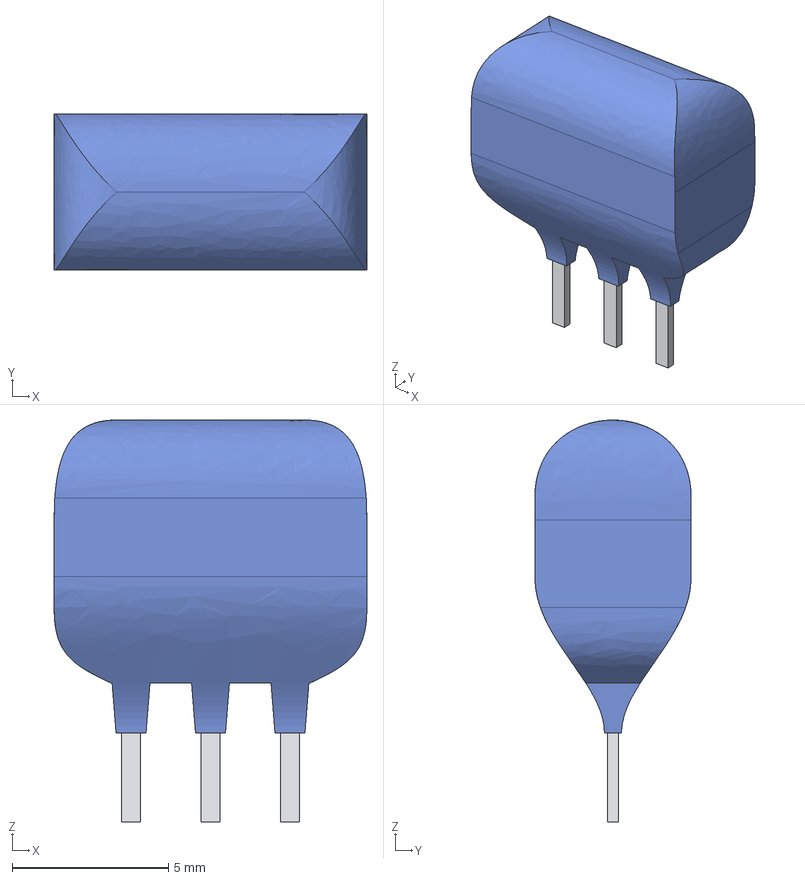
[picture p77: CAD file, 2026-10-14]
kicad-working/validation/models-review-11/resonator-quality/Resonator_AWCR16MD_TaperShoulders_P2.54_Illustration.step
10.0 x 5.00 x 12.8 mm
