cozycactus/x0xb0x-hardware/kicad-working/validation/models-review-18/usb-quality/Shell.stl

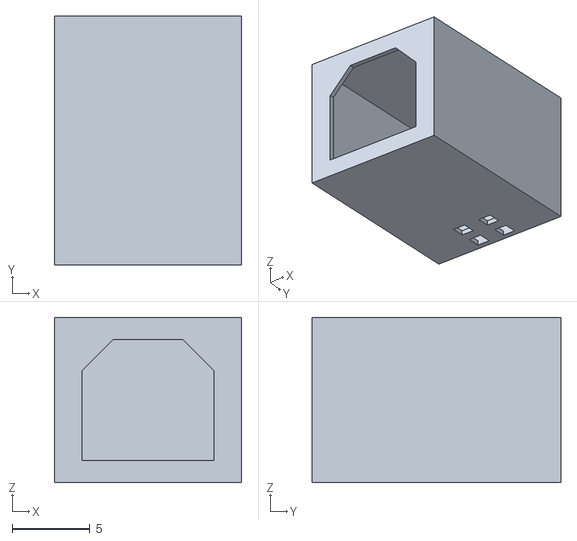
[picture p78: CAD file, 2026-10-15]
kicad-working/validation/models-review-18/usb-quality/Shell.stl
12.0 x 16.0 x 10.6
