cozycactus/x0xb0x-hardware/kicad-working/validation/models-review-21/electrolytic-quality/CP_Xicon_XRL1u50_P3.556_PhotoColours.step

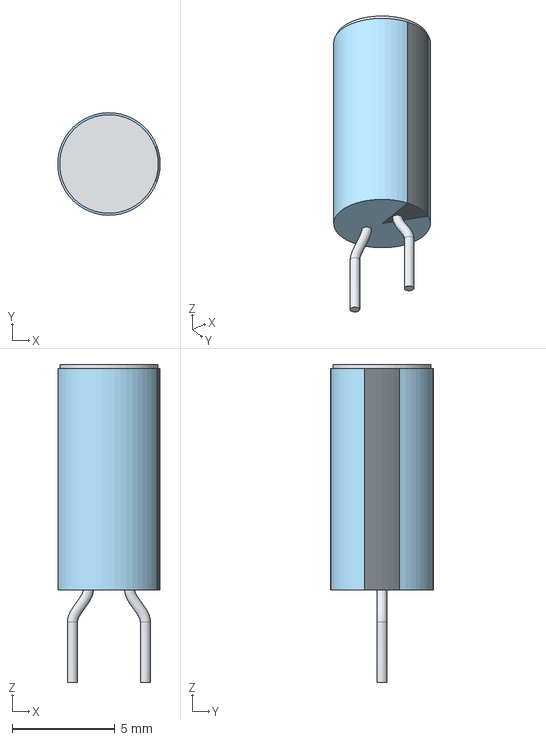
[picture p79: CAD file, 2026-10-15]
kicad-working/validation/models-review-21/electrolytic-quality/CP_Xicon_XRL1u50_P3.556_PhotoColours.step
5.00 x 5.00 x 15.5 mm
