cozycactus/x0xb0x-hardware/kicad-working/validation/models-review-10/rear-connector-quality/PJ202AH_DrawingDerived_DetailedBody_Corrected.step

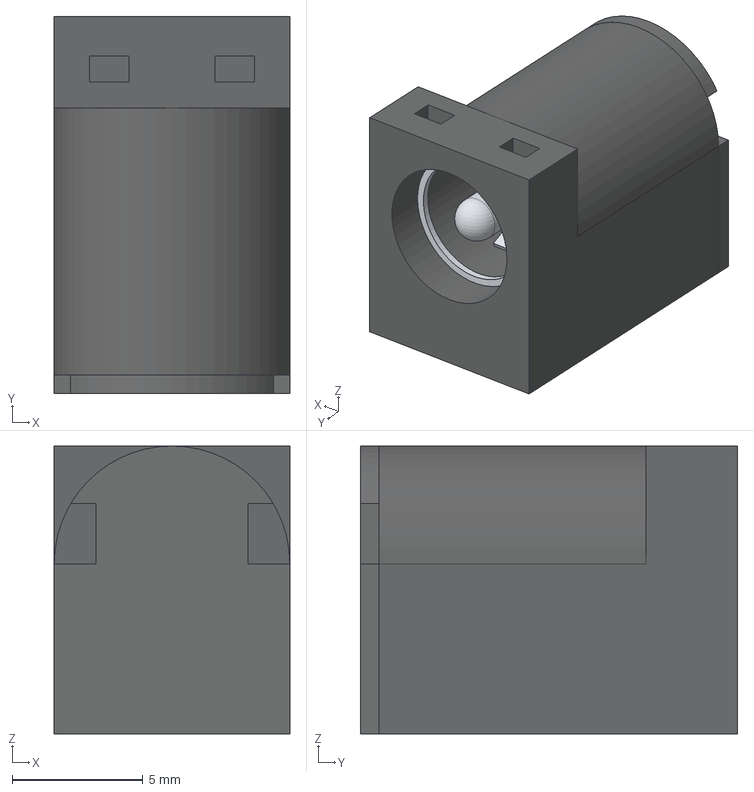
[picture p80: CAD file, 2026-10-14]
kicad-working/validation/models-review-10/rear-connector-quality/PJ202AH_DrawingDerived_DetailedBody_Corrected.step
9.00 x 14.4 x 11.0 mm
