cozycactus/x0xb0x-hardware/kicad-working/validation/models-review-20/ptc-quality/DrawingDerivedTerminals.stl

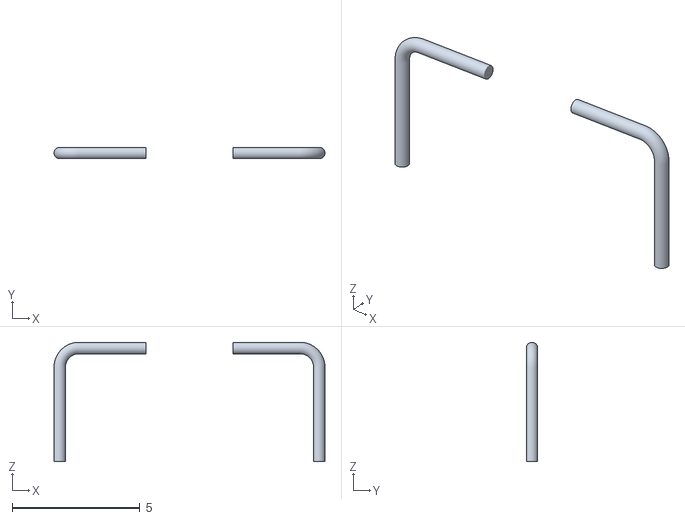
[picture p81: CAD file, 2026-10-15]
kicad-working/validation/models-review-20/ptc-quality/DrawingDerivedTerminals.stl
10.6 x 0.45 x 4.67
