cozycactus/x0xb0x-hardware/kicad-working/validation/models-review-10/rear-connector-quality/MJ3536N_DrawingDerived_DetailedBody--RearMoldedBridge.stl

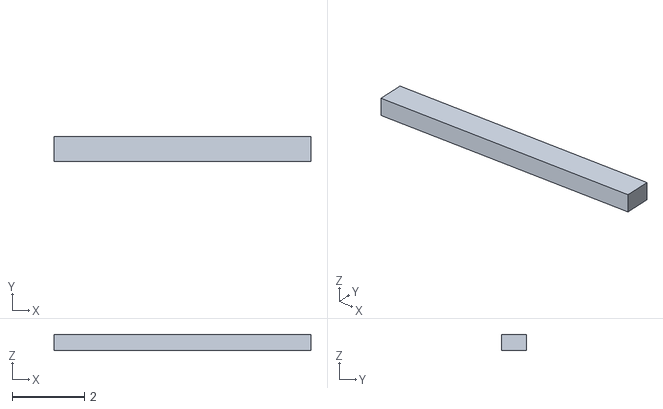
[picture p82: CAD file, 2026-10-14]
kicad-working/validation/models-review-10/rear-connector-quality/MJ3536N_DrawingDerived_DetailedBody--RearMoldedBridge.stl
7.10 x 0.7 x 0.45
