cozycactus/x0xb0x-hardware/kicad-working/validation/models-review-11/transistor-quality/Sanyo_2SC536_NP2003A_Typical_InlineForm_Illustration.step

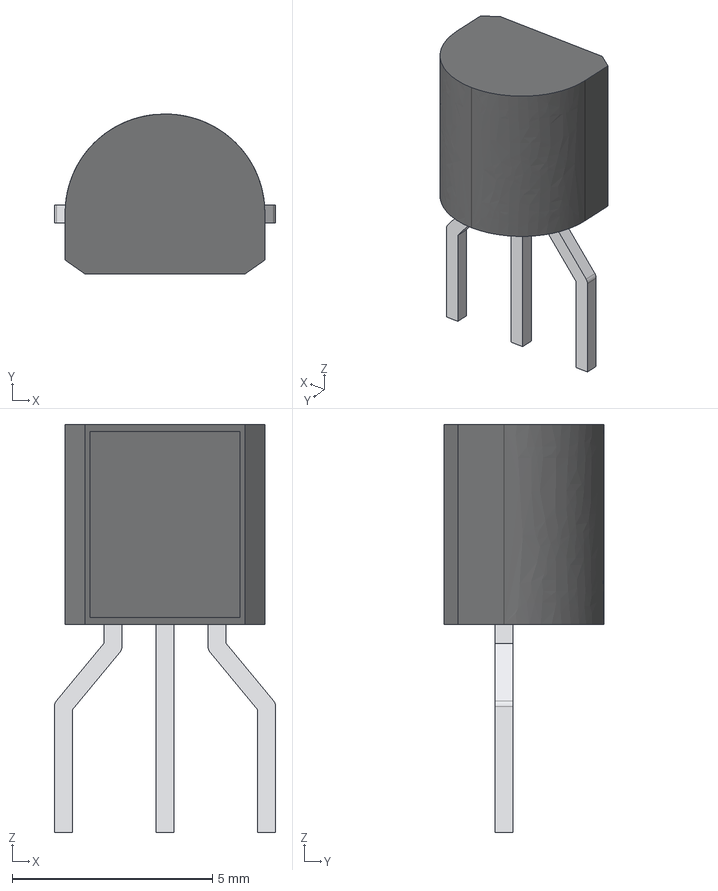
[picture p83: CAD file, 2026-10-14]
kicad-working/validation/models-review-11/transistor-quality/Sanyo_2SC536_NP2003A_Typical_InlineForm_Illustration.step
5.53 x 4.00 x 10.2 mm
MouldedNPBody
BaseFullWidthLead
CollectorFullWidthLead
EmitterFullWidthLead
