cozycactus/x0xb0x-hardware/kicad-working/validation/models-review-10/rear-connector-quality/PJ202AH_DrawingDerived_DetailedBody--RecessedMatingContactRing.stl

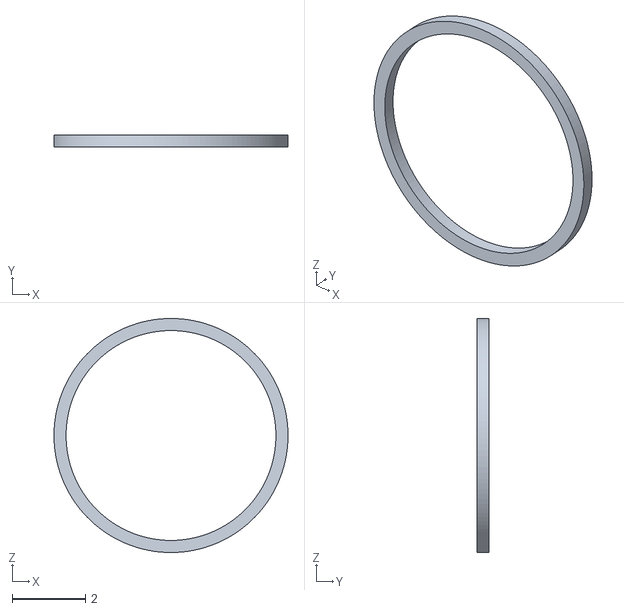
[picture p84: CAD file, 2026-10-14]
kicad-working/validation/models-review-10/rear-connector-quality/PJ202AH_DrawingDerived_DetailedBody--RecessedMatingContactRing.stl
6.38 x 0.32 x 6.38
