cozycactus/x0xb0x-hardware/kicad-working/validation/models-review-10/rear-connector-quality/MJ3536N_DrawingDerived_DetailedBody--NonthreadedNickelBushing.stl

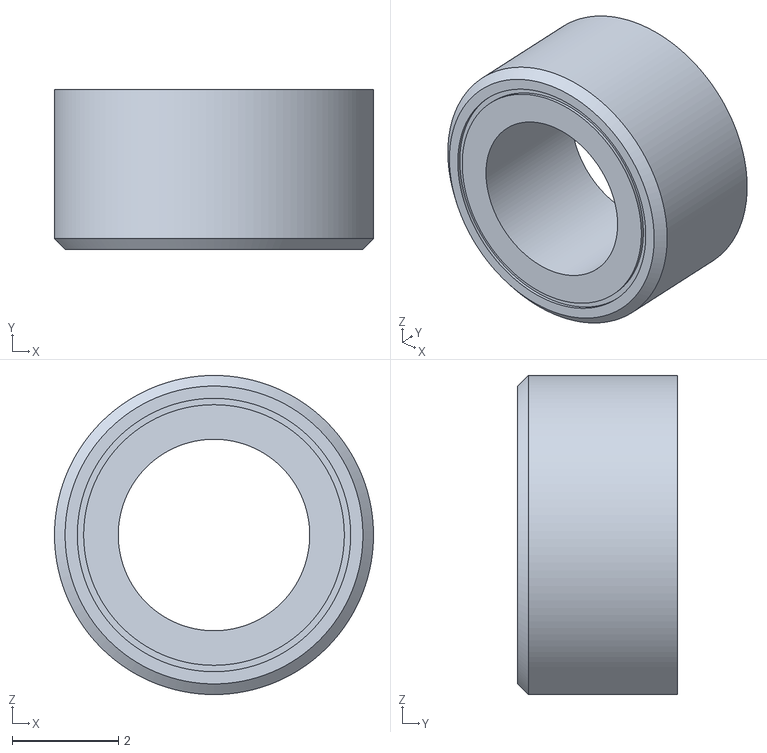
[picture p85: CAD file, 2026-10-14]
kicad-working/validation/models-review-10/rear-connector-quality/MJ3536N_DrawingDerived_DetailedBody--NonthreadedNickelBushing.stl
6.00 x 3.00 x 6.00
