cozycactus/x0xb0x-hardware/kicad-working/validation/models-review-12/din-contact-quality/RearCover.stl

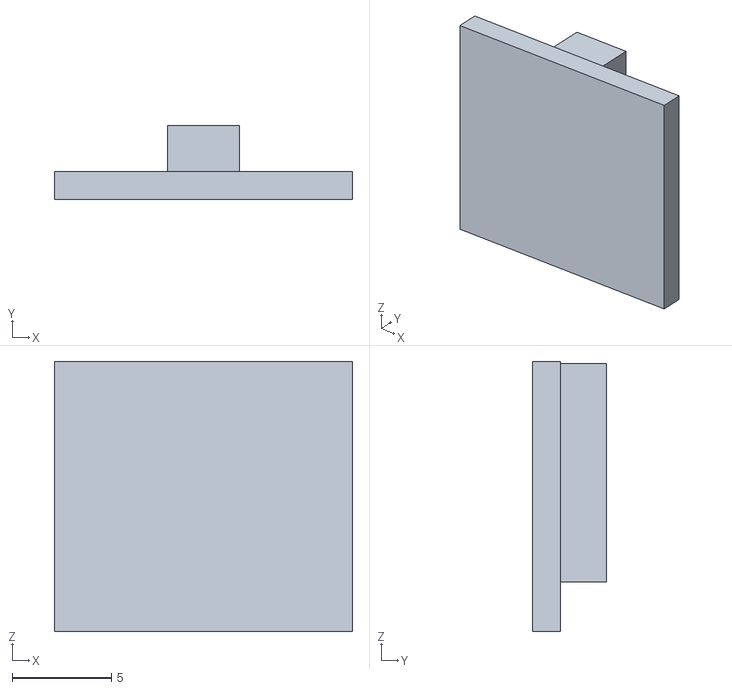
[picture p87: CAD file, 2026-10-14]
kicad-working/validation/models-review-12/din-contact-quality/RearCover.stl
15.0 x 3.70 x 13.6
