cozycactus/x0xb0x-hardware/kicad-working/validation/models-review-22/resistor-quality/R_DIN0207_P15.24mm_Horizontal_Brown-Black-Orange-Gold_KiCadBody.step

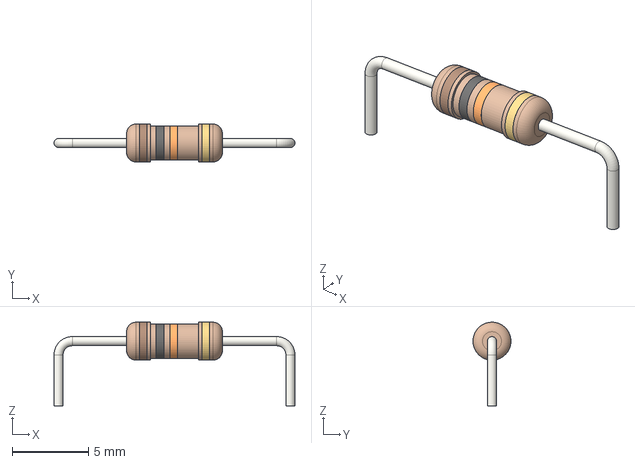
[picture p88: CAD file, 2026-10-15]
kicad-working/validation/models-review-22/resistor-quality/R_DIN0207_P15.24mm_Horizontal_Brown-Black-Orange-Gold_KiCadBody.step
15.8 x 2.50 x 5.50 mm
