cozycactus/x0xb0x-hardware/kicad-working/validation/models-review-10/rear-connector-quality/MJ3536N_DrawingDerived_DetailedBody--VisibleContactArch.stl

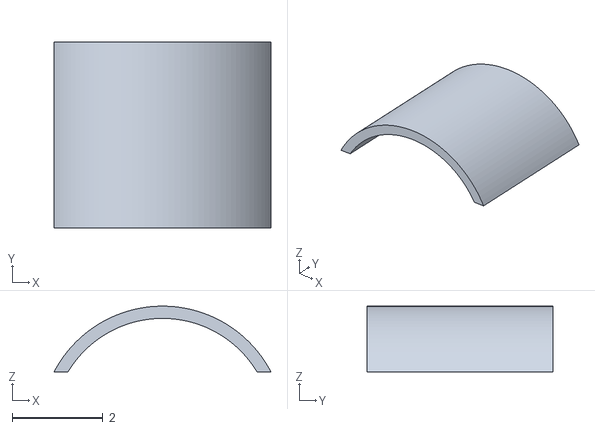
[picture p89: CAD file, 2026-10-14]
kicad-working/validation/models-review-10/rear-connector-quality/MJ3536N_DrawingDerived_DetailedBody--VisibleContactArch.stl
4.79 x 4.10 x 1.45
