cozycactus/x0xb0x-hardware/kicad-working/validation/models-review-11/resonator-quality/Resonator_AWCR6MD_TaperShoulders_P2.54_Illustration.step

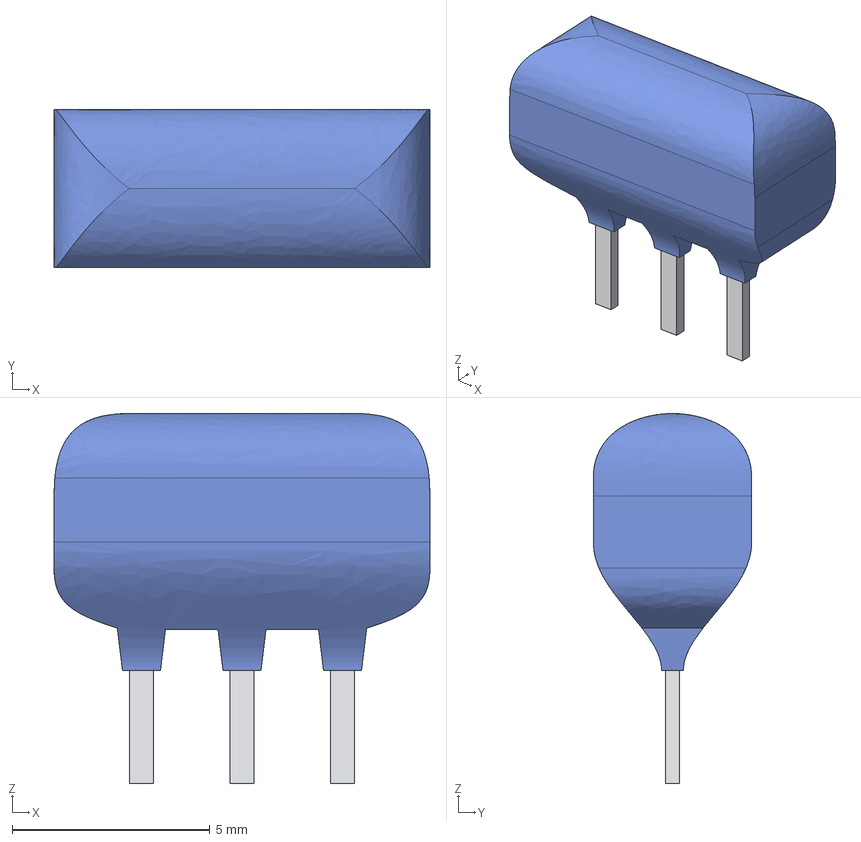
[picture p90: CAD file, 2026-10-14]
kicad-working/validation/models-review-11/resonator-quality/Resonator_AWCR6MD_TaperShoulders_P2.54_Illustration.step
9.50 x 4.00 x 9.35 mm
