cozycactus/x0xb0x-hardware/kicad-working/validation/models-review-22/resistor-quality/R_DIN0207_P2.54mm_Vertical_Red-Red-Red-Gold_KiCadBody.step

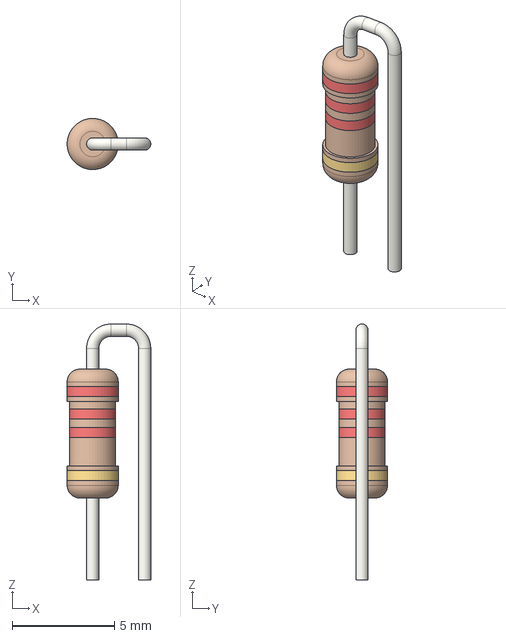
[picture p91: CAD file, 2026-10-15]
kicad-working/validation/models-review-22/resistor-quality/R_DIN0207_P2.54mm_Vertical_Red-Red-Red-Gold_KiCadBody.step
4.09 x 2.50 x 12.5 mm
