cozycactus/x0xb0x-hardware/kicad-working/validation/models-review-10/rear-connector-quality/PJ202AH_DrawingDerived_DetailedBody--VisibleLowerLeaf.stl

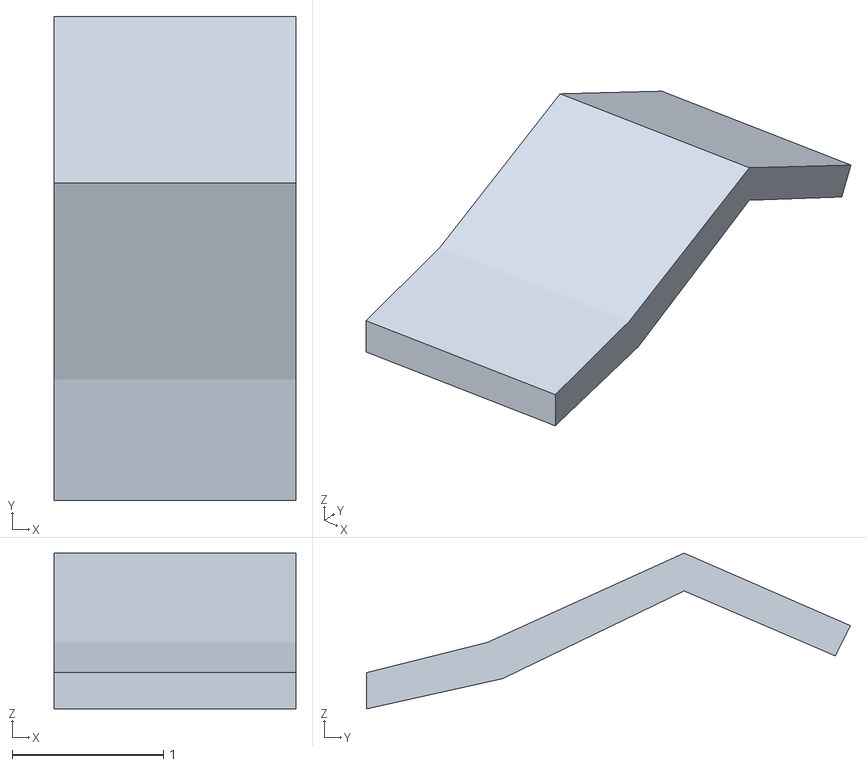
[picture p92: CAD file, 2026-10-14]
kicad-working/validation/models-review-10/rear-connector-quality/PJ202AH_DrawingDerived_DetailedBody--VisibleLowerLeaf.stl
1.60 x 3.20 x 1.03
