cozycactus/x0xb0x-hardware/(list of files, cad)

Other CAD files:
kicad-working/validation/models-review-19/led-spacer-quality/AnodeFullWidthLead.stl
kicad-working/validation/models-review-11/transistor-quality/Sanyo_2SC536_NP2003A_Typical_InlineForm_Illustration--EmitterFullWidthLead.stl
kicad-working/mainboard/3dmodels/Revision24/marking-quality/DIP-16_W7.62mm_Marked_74AC174.step
kicad-working/validation/models-review-22/resistor-quality/R_DIN0207_P5.08mm_Vertical_Brown-Black-Red-Gold_KiCadBody.step
kicad-working/validation/models-review-10/heatsink-fit-research/Aavid_574502B00000G_BentBack_PhotoQualified.step
kicad-working/validation/models-review-11/resonator-quality/Resonator_AWCR16MD_TaperShoulders_P2.54_Illustration--Lead2.stl
kicad-working/validation/models-review-11/transistor-quality/Sanyo_2SC536_NP2003A_Typical_AsymmetricForm_Illustration--MouldedNPBody.stl
kicad-working/validation/models-review-24/marking-quality/DIP-40_W15.24mm_in_1-390262-5_Socket_KiCadFrame_Marked_ATmega162.step
kicad-working/validation/models-review-20/ptc-quality/Band3.stl
kicad-working/validation/models-review-12/din-contact-quality/MatingSocket4.stl
kicad-working/validation/models-review-20/ptc-quality/Microohm_LPTC12_PrimaryDimensions_FormedLeads.FCStd
kicad-working/validation/models-review-22/resistor-quality/R_DIN0207_P5.08mm_Vertical_Red-Red-Black-Gold_KiCadBody.step
kicad-working/validation/models-review-24/marking-quality/DIP-16_W7.62mm_Marked_74AC174.step
kicad-working/mainboard/3dmodels/Revision24/marking-quality/DIP-14_W7.62mm_Marked_74HC126.step
kicad-working/validation/models-review-11/resonator-quality/Resonator_AWCR6MD_TaperShoulders_P2.54_Illustration--Lead1.stl
kicad-working/validation/models-review-12/din-contact-quality/MatingSocket3.stl
kicad-working/validation/models-review-22/resistor-quality/R_DIN0207_P5.08mm_Vertical_Green-Blue-Black-Brown-Brown_KiCadBody.step
kicad-working/validation/models-review-24/marking-quality/DIP-14_W7.62mm_Marked_74HC126.step
kicad-working/mainboard/3dmodels/Revision24/marking-quality/DIP-40_W15.24mm_in_1-390262-5_Socket_KiCadFrame_Marked_ATmega162.step
kicad-working/validation/models-review-11/resonator-quality/Resonator_AWCR16MD_TaperShoulders_P2.54_Illustration--Lead1.stl
kicad-working/validation/models-review-12/din-contact-quality/MatingSocket2.stl
kicad-working/validation/models-review-20/ptc-quality/Band4.stl
kicad-working/validation/models-review-22/resistor-quality/R_DIN0207_P5.08mm_Vertical_Blue-Grey-Red-Gold_KiCadBody.step
kicad-working/validation/models-review-11/resonator-quality/Resonator_AWCR6MD_TaperShoulders_P2.54_Illustration--Lead2.stl
kicad-working/validation/models-review-12/din-contact-quality/MatingSocket5.stl
kicad-working/validation/models-review-20/ptc-quality/Band1.stl
kicad-working/validation/models-review-22/resistor-quality/R_DIN0207_P5.08mm_Vertical_Brown-Black-Orange-Gold_KiCadBody.step
kicad-working/validation/models-review-20/ptc-quality/Band5.stl
kicad-working/validation/models-review-22/resistor-quality/R_DIN0207_P5.08mm_Vertical_Red-Violet-Black-Gold_KiCadBody.step
kicad-working/validation/models-review-22/resistor-quality/R_DIN0207_P5.08mm_Vertical_Red-Yellow-Black-Brown-Brown_KiCadBody.step
kicad-working/validation/models-review-22/resistor-quality/R_DIN0207_P5.08mm_Vertical_Red-Red-Yellow-Gold_KiCadBody.step
kicad-working/validation/models-review-22/resistor-quality/R_DIN0207_P5.08mm_Vertical_Brown-Black-Green-Gold_KiCadBody.step
kicad-working/validation/models-review-22/resistor-quality/R_DIN0207_P5.08mm_Vertical_Yellow-Violet-Red-Gold_KiCadBody.step
kicad-working/validation/models-review-22/resistor-quality/R_DIN0207_P5.08mm_Vertical_Red-Red-Red-Gold_KiCadBody.step
kicad-working/validation/models-review-22/resistor-quality/R_DIN0207_P5.08mm_Vertical_Red-Red-Orange-Gold_KiCadBody.step
kicad-working/validation/models-review-22/resistor-quality/R_DIN0207_P2.54mm_Vertical_Brown-Black-Orange-Gold_KiCadBody.step
kicad-working/validation/models-review-22/resistor-quality/R_DIN0207_P5.08mm_Vertical_Brown-Green-Brown-Gold_KiCadBody.step
kicad-working/validation/models-review-22/resistor-quality/R_DIN0207_P5.08mm_Vertical_Brown-Black-Yellow-Gold_KiCadBody.step
kicad-working/validation/models-review-22/resistor-quality/R_DIN0207_P5.08mm_Vertical_Red-Red-Brown-Gold_KiCadBody.step
kicad-working/validation/models-review-22/resistor-quality/R_DIN0207_P5.08mm_Vertical_Blue-Grey-Orange-Gold_KiCadBody.step
kicad-working/validation/models-review-22/resistor-quality/R_DIN0207_P5.08mm_Vertical_Red-Yellow-Black-Red-Brown_KiCadBody.step
kicad-working/validation/models-review-22/resistor-quality/R_DIN0207_P5.08mm_Vertical_Brown-Green-Green-Gold_KiCadBody.step
kicad-working/validation/models-review-22/resistor-quality/R_DIN0207_P5.08mm_Vertical_Yellow-Violet-Orange-Gold_KiCadBody.step
kicad-working/validation/models-review-22/resistor-quality/R_DIN0207_P5.08mm_Vertical_Orange-Orange-Orange-Gold_KiCadBody.step
kicad-working/validation/models-review-22/resistor-quality/R_DIN0207_P10.16mm_Horizontal_Brown-Black-Red-Gold_KiCadBody.step
kicad-working/validation/models-review-22/resistor-quality/R_DIN0207_P5.08mm_Vertical_Yellow-Violet-Brown-Gold_KiCadBody.step
kicad-working/validation/models-review-22/resistor-quality/R_DIN0207_P5.08mm_Vertical_Brown-Green-Red-Gold_KiCadBody.step
kicad-working/validation/models-review-22/resistor-quality/R_DIN0207_P5.08mm_Vertical_Brown-Black-Brown-Gold_KiCadBody.step
kicad-working/validation/models-review-22/resistor-quality/R_DIN0207_P5.08mm_Vertical_Brown-Grey-Red-Gold_KiCadBody.step
kicad-working/ioboard/3dmodels/Revision10/heatsink-fit-research/Aavid_574502B00000G_BentBack_PhotoQualified.step
kicad-working/ioboard/3dmodels/Revision13/terminals/MC78M05_TO220_BentBack_PhotoQualified_Terminals.step
kicad-working/ioboard/3dmodels/Revision13/terminals/MJ3536N_DrawingDerived_DetailedBody_Terminals.step
kicad-working/ioboard/3dmodels/Revision13/terminals/NYS216_DrawingDerived_DetailedBody_Terminals.step
kicad-working/ioboard/3dmodels/Revision13/terminals/PJ202AH_DrawingDerived_DetailedBody_Terminals.step
kicad-working/ioboard/3dmodels/Revision13/terminals/SDS50J_CorrectedContactPattern_Terminals.step
kicad-working/ioboard/3dmodels/Revision13/terminals/USB_TypeB-body-illustration_Terminals.step
kicad-working/ioboard/3dmodels/Revision14/terminals/PJ202AH_DrawingDerived_DetailedBody_Terminals.step
kicad-working/ioboard/3dmodels/Revision14/terminals/SDS50J_CorrectedContactPattern_Terminals.step
kicad-working/ioboard/3dmodels/Revision15/terminals/MJ3536N_DrawingDerived_DetailedBody_Terminals.step
kicad-working/ioboard/3dmodels/Revision15/terminals/SDS50J_CorrectedContactPattern_Terminals.step
kicad-working/ioboard/3dmodels/Revision22/resistor-quality/R_DIN0207_P5.08mm_Vertical_Blue-Grey-Red-Gold_KiCadBody.step
kicad-working/ioboard/3dmodels/Revision22/resistor-quality/R_DIN0207_P5.08mm_Vertical_Brown-Black-Brown-Gold_KiCadBody.step
kicad-working/ioboard/3dmodels/Revision22/resistor-quality/R_DIN0207_P5.08mm_Vertical_Brown-Black-Orange-Gold_KiCadBody.step
kicad-working/ioboard/3dmodels/Revision22/resistor-quality/R_DIN0207_P5.08mm_Vertical_Brown-Black-Red-Gold_KiCadBody.step
kicad-working/ioboard/3dmodels/Revision22/resistor-quality/R_DIN0207_P5.08mm_Vertical_Brown-Black-Yellow-Gold_KiCadBody.step
kicad-working/ioboard/3dmodels/Revision22/resistor-quality/R_DIN0207_P5.08mm_Vertical_Brown-Green-Brown-Gold_KiCadBody.step
kicad-working/ioboard/3dmodels/Revision22/resistor-quality/R_DIN0207_P5.08mm_Vertical_Brown-Green-Red-Gold_KiCadBody.step
kicad-working/ioboard/3dmodels/Revision22/resistor-quality/R_DIN0207_P5.08mm_Vertical_Brown-Grey-Red-Gold_KiCadBody.step
kicad-working/ioboard/3dmodels/Revision22/resistor-quality/R_DIN0207_P5.08mm_Vertical_Green-Blue-Black-Brown-Brown_KiCadBody.step
kicad-working/ioboard/3dmodels/Revision22/resistor-quality/R_DIN0207_P5.08mm_Vertical_Red-Red-Black-Gold_KiCadBody.step
kicad-working/ioboard/3dmodels/Revision22/resistor-quality/R_DIN0207_P5.08mm_Vertical_Red-Red-Brown-Gold_KiCadBody.step
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
