cozycactus/x0xb0x-hardware/kicad-working/validation/models-review-10/front-controls-review/final-front-control-assembly-review.md

# Final front-control attachment verification

The saved Blender7 scene passed **694 independent read-only checks**. Its SHA256 is `7b26f1a99d5350754413d7af2879317fc7ba6f8e99102761d7143859e068f136`. Both the saved revision7 and preserved revision6 inputs remained byte unchanged during inspection.

There are **40 PCB-mounted LED reference assemblies**, each with one clear head and two full-width lead mesh features; there are **no standalone panel LED lens doubles**. All40 lens axes align with the original DXF holes to a maximum0.0000409mm numerical residual. Raised native tips project1.299947–1.299979mm above the panel; the removed separate proxies projected1.777995–1.777998mm.

The generic source filename identifies a nominal5mm LED family. Fresh analytical source inspection shows an actual4.9mm cylindrical/dome CAD surface and a5.8mm flange. These source dimensions are preserved exactly. The flange remains below the panel. Original panel holes are5.08mm diameter; nominal5mm gives0.04mm radial difference, while the actual4.9mm CAD body gives0.09mm. These are nominal geometric differences, not physical tolerance or fitted-clearance claims.

All80 lead features retain full0.4x0.4mm sections from trimmedZ−2.5 to bodyseatZ6.096mm in the source model frame. The saved geometry envelopes were independently measured, and233 linked frozen STEP checks verify continuous full-width cross-sections and the preserved generic head. Clear-body material is a qualified unlit optical approximation: Metallic0, Transmission0.85, IOR1.5, Roughness0.18, Emission0. Lead materials remain metallic.

All23 caps retain their original mesh geometry, material colors, assembled centers and five-horizontal/eighteen-vertical orientations. They now belong to an ordinary scene collection and are parented to the mainboard, with no membership in the old front-panel instanced source collection. Baseline cap world matrices were independently obtained from actual revision6 evaluated collection instances, so the panel transform is included exactly once. Visible frames1/80 have one correct evaluated cap instance each. Frames120/160 intentionally hide caps in both viewport and render to preserve the original inspection views; these frames verify the constant stored PCB-relative matrix and absence of displayed instances. Blender may leave hidden matrix_world caches stale, so those caches are not treated as rendered poses.

The selected bodyseat6.096mm follows the original BOM STD240B0.24inch entry. The older sequencer table instead gives0.22inch/5.588mm, which would yield0.792mm nominal lens projection. Actual fitted spacer height remains unmeasured. The spacer outer mold and lead-hole shape are omitted; cap socket, retention and switch travel are also unmodeled. The result is source/geometry/animation evidence, not physical hardware certification.

`final-front-control-assembly-audit.json` records every check and input hash. `final-source-lens-dimensions.json` records the fresh analytical CAD dimensions. `final-front-attachment-closeup.png` shows the actual assembled interface with a close camera; it is not a cutaway view. `final-closeup-render-record.json` records the image/source hashes and scope. No source scene was resaved by either read-only verification or rendering.
