cozycactus/x0xb0x-hardware/kicad-working/visualization/blender-case-revision-7/body-model-sources/misc-body-illustrations/reference/ct-6-manufacturer.txt

SINGLE TURN CERMET TRIMMERS                       CT-6
                                          CT-6 構造図
                     RoHS compliant                 INTERNAL STRUCTURE

                                                                             ②    ③
                                                                        ①                   ④
                                                                                                  ⑤

                                                                    ⑩                            ⑥
                                                                      ⑨
                                                                                      ⑧     ⑦

                                                        Part name                               Material

■ FEATURES                                         ① Housing
● RoHS compliant                                                                 PBT（Polybutyleneterephthalate
● Various configurations to choose from            ② Rotor
● Wide variety (14 types)
                                                   ③ Wiper                                 Multi metal alloy
● “O” ring sealed and washable
● Resin material is UL Recognized 94V-0            ④ Rubber cushion                        Silicone rubber

                                                   ⑤ “O” ring                              Silicone rubber

                                                   ⑥ Resistive element                      RuO2 cermet

                                                   ⑦ Terminal pin                         Copper, Tin-plated

                                                   ⑧ Adhesive                                    Epoxy

                                                   ⑨ Base element                               Ceramic

                                                   ⑩ Electrode                              Ag-Pd cermet

■ PART NUMBER DESIGNATION
                                  C T - 6 E T V 5 kΩ ( 5 0 2 )
      Series name                                                                               Resistance code

      Terminal pin                                                                              Resistance value
      E：Sn (Lead-free)
                                                             Product shape
                                                             P：Top adjustment                S：Side adjustment
      Form of packaging                                      W：Top adjustment                X：Side adjustment
                                                             R：Top adjustment                H：Side adjustment
      T：Taping (Ammo pack type)                              V：Top adjustment                N：Side adjustment
      M：Magazine (Stick)                                     F：Rear adjustment
      Blank：Bulk in plastic bag

※ Please refer to the LIST OF PART NUMBERS when placing orders.

                                                                                                                                    CT-6
                                                                                                       CERMET TRIMMERS

■ LIST OF PART NUMBERS
                                                          Form of packaging
 Adjustment       Shape of terminal
                                                                                                                           Remarks
  position           (Top view)
                                           Taping          Magazine (stick)             Plastic bag
                         ②
                         ②
                         ②
                         ②
                         ②
                         ②②
                    ①    ②    ③            CT-6ETP                                                        The pin length of CT-6ETP & CT-6EMP is
                    ①
                    ①
                    ①    ②    ③
                              ③
                              ③                                CT-6EMP                    CT-6EP
                    ①
                    ①①        ③
                              ③③      （ Ammo pack type）                                                   different from CT-6EP.
                    ①         ③
                    ①         ③
                         ②
                         ②
                         ②
Top adjustment           ②
                         ②
                         ②②
                    ①    ②    ③
                    ①
                    ①
                    ①    ②    ③
                              ③
                              ③
                    ①
                    ①
                    ①
                     ①        ③
                              ③
                              ③
                               ③                                                          CT-6EW                              —
                    ①         ③

                    ①         ③
                    ①
                    ①
                    ①         ③
                              ③
                              ③
                    ①
                    ①①        ③
                              ③③
                    ①    ②    ③
                    ①    ②
                         ②
                         ②    ③
                         ②
                         ②
                         ②
                          ②                                                               → CT-6ER                            —
                         ②
                         ②
                         ②
                         ②
                         ②
                         ②
                         ②②
                    ①    ②    ③
                    ①
                    ①
                    ①    ②    ③
                              ③
                              ③
                    ①
                    ①         ③
                              ③            CT-6ETV
                    ①
                     ①
                              ③
                               ③
                                      （ Ammo pack type）
                                                                                          CT-6EV                              —
                    ①         ③

                         ②
                         ②
                         ②
                         ②
                         ②
                         ②②
                    ①    ②    ③                                                                           The pin length of CT-6EMS is different from
                    ①
                    ①
                    ①    ②    ③
                              ③
                              ③
                    ①
                    ①         ③
                              ③
                                                               CT-6EMS                    CT-6ES
                    ①
                     ①
                              ③
                               ③                                                                          CT-6ES.
                    ①         ③
                    ③         ①
                    ③
                    ③
                    ③         ①
                              ①
                              ①
                    ③
                    ③③        ①
                              ①①
                    ③         ①
                    ③    ②    ①
                         ②
                         ②
                         ②                                                                CT-6EX                              —
                         ②
                         ②
     Side                ②
                          ②
 adjustment              ②

(↑Adjustment             ②
                         ②
                         ②
                         ②
                         ②
                         ②
  direction)        ①    ②
                          ②
                              ③            CT-6ETH                                                        The pin length of CT-6ETH is different from
                    ①
                    ①
                    ①    ②    ③
                              ③
                              ③                                                           CT-6EH
                    ①
                    ①①        ③
                              ③③      （ Ammo pack type）                                                   CT-6EH.
                    ①         ③
                    ①         ③

                    ①         ③
                    ①
                    ①
                    ①         ③
                              ③
                              ③
                    ①
                    ①①        ③
                              ③③
                    ①
                    ①
                              ③
                              ③
                                                                                          CT-6EN                              —
                         ②
                         ②
                         ②
                         ②
                         ②
                         ②②
                         ②
                         ②
                         ②
                         ②
                         ②
                         ②
                         ②
                         ②②
                         ②
                   ①          ③
Rear adjustment    ①
                   ①
                   ①
                   ①
                   ①
                         ②    ③
                              ③
                              ③
                              ③
                              ③
                                                                                          → CT-6EF                            —
                    ①          ③
                   ①          ③
                   ①          ③

Pieces in package                      1000 pcs./taping      75 pcs./stick              50 pcs./pack                          —

  ：Not manufactured                                                          〈Nominal resistance values〉                                       Fig. 1
The products indicated by → mark are manufactured upon
receipt of order basis.                                                        → 10 Ω      → 20 Ω       50 Ω      100 Ω        200 Ω        500 Ω
                                                                                1 kΩ        2 kΩ        5 kΩ      10 kΩ        20 kΩ        50 kΩ
                                                                               100 kΩ      200 kΩ      500 kΩ      1 MΩ         2 MΩ

                                                                             ※ The above part numbers are all available with the respective
                                                                               combination of <Nominal resistance values> (Fig. 1).
                                                                             ※ Verify the above part numbers when placing orders.
                                                                             ※ Taping and magazine specifications are not sold separately
                                                                               and must be purchased in taping or stick units.

CT-6
CERMET TRIMMERS

■ ELECTRICAL CHARACTERISTICS                                                     ■ MECHANICAL CHARACTERISTICS
Nominal resistance range                   10 Ω ~ 2 MΩ                           Mechanical angle                                         260 ° (1 turn)

                                                                                 Operating torque                            2 ~ 20 mN·m {20 ~ 204 gf·cm}
Resistance tolerance                           ± 10 %
                                                                                 Stop strength                               50 mN·m {510 gf·cm} minimum
Power ratings                     0.5 W (70 °C) 0 W (120 °C)                     Rotational life                           200 cycles [ΔR/R ≦ ± (2 Ω +3 %)]

                                                                                 Teminal strength                                 10 N {1.02 kgf} minimum
Resistance law                            Linear law（B）                                                                             （Tensile strength）
                                                                                 Thrust to rotor                                  10 N {1.02 kgf} minimum
Maximum input voltage        DC200 V or power rating, whichever is smaller
                                                                                 Solderability                                        245 ± 3°C, 2 ~ 3 s
Maximum wiper current 100 mA or power rating, whichever is smaller                                                                                   { }：Reference only

Effective electrical angle                 220 ° (1 turn)                        ■ ENVIRONMENTAL CHARACTERISTICS
End resistance                  1 % or 2 Ω, whichever is greater                      Test item                 Test conditions                         Specifications

                                                                                 Thermal shock          − 65 ~ 125 °C (0.5 h), 5 cycles                   [ΔR/R ≦ 1 %]
                                                                                                                                                           [S.S. ≦ 1 %]
C.R.V.                          1 % or 3 Ω, whichever is greater
                                                                                                        −10 ~ 65 °C (Relative humidity 80 ~ 98 %),
                                                                                 Humidity                         10 cycles, 240 h                        [ΔR/R ≦ 2 %]
Operating temp. range                      − 55 ~ 120 °C                                                          981 m/s2, 6 ms
                                                                                 Shock                   6 directions for 3 times each
                                                                                                                                                          [ΔR/R ≦ 1 %]
                               10 Ω~ 20 Ω: ± 250 10 /°C maximum
                                                       -6
                                                                                                              Amplitude 1.52 mm or
                                                                                                                                                           [S.S. ≦ 1 %]
Temp. coefficient                                                                Vibration                    Acceleration 196 m/s2,
                              50 Ω ~ 2 MΩ: ± 100 10-6/°C maximum
                                                                                                       10 ~ 2000 Hz, 3 directions, 12 times each
Insulation resistance            1000 MΩ minimum (DC500 V)                       Load life                    70 °C, 0.5 W, 1000 h                        [ΔR/R ≦ 3 %]
                                                                                                                                                           [S.S. ≦ 1 %]
                                                                                 Low temp. operation                −55 °C, 2 h                           [ΔR/R ≦ 2 %]
Dielectric strength                       AC900 V, 60 s                                                                                                    [S.S. ≦ 2 %]
                                                                                 High temp. exposure               120 °C, 250 h                          [ΔR/R ≦ 3 %]
                               Approx. 0.51 g (CT-6EP, EW, ER, EV)                                                                                         [S.S. ≦ 2 %]
Net weight                     Approx. 0.65 g (CT-6ES, EX, EH, EN)                                                                                            No leaks
                                                                                 Immersion seal                     85 °C, 60 s
                                                                                                                                                      (No continuous bubbles)
                               Approx. 0.92 g (CT-6EF)
                                                                                                       Flow：260 ± 3°C, 5 ~ 6 s,
                                                                                 Soldering heat two times maximum
                                                                                                Manual soldering：                                         [ΔR/R ≦ 1 %]
                                                                                                       380 ± 10 °C, 3 ~ 4 s

                                                                                                                                         ΔR/R：Change in total resistance
                                                                                                                                         S.S. ：Setting stability

■ MAXIMUM INPUT RATINGS
          Nominal
                                        Resistance code              Maximum input voltage (V) Maximum wiper current (mA)
   resistance values (Ω)
     →        10                                100                            1.00                                      100
     →        20                                200                            2.00                                      100
              50                                500                            5.00                                      100
             100                                101                            7.07                                      70.7
             200                                201                            10.0                                      50.0
             500                                501                            15.8                                      31.6

             1k                                 102                            22.4                                      22.4
             2k                                 202                            31.6                                      15.8
             5k                                 502                            50.0                                      10.0
             10 k                               103                            70.7                                      7.07
             20 k                               203                            100                                       5.00
             50 k                               503                            158                                       3.16

             100 k                              104                            200                                       2.00
             200 k                              204                            200                                       1.00                        The produc t s indi-
             500 k                              504                            200                                       0.40                        cated by → mark are
              1M                                105                            200                                       0.20                        manufactured upon
              2M                                205                            200                                       0.10                        receipt of order basis.

   CT-6P 外形図
                                                                                                                                                                             CT-6
                                                                                                                                      CERMET TRIMMERS

    ■ OUTLINE DIMENSIONS                                                                                              Unless otherwise specified, tolerance: ± 0.3 (Unit: mm)

    ● CT-6EP
      Top adjustment                                                                                                                                       ①                           ③
                                                                                                                                                                                 CW rotation

CT-6W 外形図
                                                                                                                         3 –φ0.45
                                                                                                                                                                             ②
                                                                             0.6 W ×2.6 L×1.6 D
                                                   260°Nom.                                                                                                2
                Lead-free Identification mark

                                                                                                                                     2.5
                                                                                                  7

                                                                                                                                          3                     1

                                                          7              Resistance code &               5.8    7±2                           2.5 2.5
                                                                         Production date code

    ● CT-6EW
      Top adjustment

CT-6V 外形図
                                                                           0.6 W×2.6 L×1.6 D                          3 –φ0.45
                                                 260°Nom.                                                                                              2
               Lead-free Identification mark

                                                                                                                                    1.3

                                                                                                7
                                                                                                                                    0.6

                                                                                                                                                               1
                                                                                                                                          3
                                                      7                                                 5.8    7±2                            1.8 1.8
                                                                        Resistance code &
                                                                        Production date code

    ● CT-6EV
                                                                                                                                    ★ Pin pitch in W type is different from P type.
      Top adjustment

 CT-6ES 外形図                                     260°Nom.
                                                                           0.6 W ×2.6 L×1.6 D
                                                                                                                                                               1
                                                                                                                        3 –φ0.45          3        2
             Lead-free Identification mark

                                                                                                7

                                                                                                               13.5±2
                                                    7                 Resistance code &                                                       2.5 2.5
                                                                      Production date code             5.8       16±2
    ● CT-6ES
      Side adjustment

                                                              0.6 W×2.6 L×1.6 D
                                                 7 +0.4
                                                    0
                                                                                                                                                        Adjustment
                                                                  Resistance code &
        Lead-free Identification mark                             Production date code                7 +0.4
                                                                                                        -0.2

                                                                                                                                          1                        3   3.5
                                                                       8.2                                                                2
                                                                                                                                                                       2.5
                                                                4.6

                                                                                                                                              2.5 2.5
                                                                       7.5 ± 2
                                                                                                               3 –φ0.45

     CT-6
CT-6X 外形図
       CERMET TRIMMERS

     ■ OUTLINE DIMENSIONS                                                                                                         Unless otherwise specified, tolerance: ± 0.3 (Unit: mm)

     ● CT-6EX
                                                                                                                                                                     ①                          ③
       Side adjustment
                                                                                                                                                                                          CW rotation
                                                      Resistance code &
                                                                                                                                                                                      ②
                                                      Production date code

                                                                                                                                                              Adjustment
                                          7 + 00.4     0.6 W×2.6 L×1.6 D                                                                             2
                                                                                                          7 +– 0.4
                                                                                                               0.2

                                                                                                                                                                               3.5
                                                                8.2

CT-6H 外形図
                                                                                                                                                                               2.5
                                                        4.6

                                                                                                                                              3                        1
                                                                          Lead-free Identification mark                                              2.5 2.5

                                                                10 ±2                                                  3 –φ0.45

     ● CT-6EH
       Side adjustment
                                                        0.6 W×2.6 L×1.6 D
                                                                                                                                                               Adjustment
                                          7 + 00.4          Resistance code &                                                                            2
          Lead-free Identification mark                                                                   7 +– 0.4
                                                                                                               0.2
                                                            Production date code

                                                                                                                                             1                             3    3.5

CT-6N 外形図
                                                                 8.2
                                                         4.6

                                                                                                                                                         2.5 2.5
                                                         7 ±2
                                                                 9.5 ±2                                              3 –φ0.45

     ● CT-6EN
       Side adjustment
                                                      0.6 W×2.6 L×1.6 D
                                                                                                                                                              Adjustment
                                                                                                                                                     2
          Lead-free Identification mark   7   + 0.4
                                                0          Resistance code &                              7 +– 0.4
                                                                                                               0.2
                                                           Production date code

                                                                                                                                                                               3.5

                                                                8.2
                                                                                                                                                                               2.5
                                                        4.6

                                                                                                                                                 1                     3
                                                                                                                                                     2.5 2.5
                                                                7.5 ± 2
                                                                                                                       3 –φ0.45

                                                                                                                          ★ Terminals 1 & 3 position in N type is different from X type.

 CT-6F 外形図
                                                                                                                                                                                               CT-6
                                                                                                                                                          CERMET TRIMMERS

   ■ OUTLINE DIMENSIONS                                                                                                              Unless otherwise specified, tolerance: ± 0.3 (Unit: mm)

   ● CT-6EF                                                                           ＜ Semi-standard products ＞
                                                                                                                                                                                ①                         ③
     Rear adjustment
                                                                   0.6 W × 2.6 L × 1.6 D                3 –φ0.45                                                                                  CW rotation
                                                  2
                                                                                                                                                                                           ②

CT-6R 外形図
                 Lead-free Identification mark

                                                                           4.4

                                                                                                                        φ10.5 max.
                                 1
                                                                                 3

                                                                                                           0.3                                                  Resistance code &
                                                 4.4         4.4                                                                                                Production date code
                                                                                                 5.52         7.6

   ● CT-6ER                                                                           ＜ Semi-standard products ＞
     Top adjustment
                                                                            0.6 W × 2.6 L × 1.6 D                                    3 – φ 0.45

                                                       260°Nom.                                                                                            3                2          1
                 Lead-free Identification mark

                                                                                                    7
                                                                                                                                                          2.5

                                                         7                Resistance code &                    5.8      7±2                                           2.5 2.5
                                                                          Production date code

         梱包仕様
     PACKAGING
   ■CT-6       SPECIFICATIONS
   <Taping packaging specifications>
   ● Taping version is packaged in 1000 pcs. per reel.
    Orders will be accepted for units of 1000 pcs., i.e., 1000,
    2000, 3000 pcs., etc.
   ● Taping version (ammo pack type) is boxed with one reel
    (1000 pcs.).

                                                                                                                     #1 terminal                  Direction of feed
                                                                        Ammo pack type

   Ammo Pack
                                                                                                                         45
   ● Package size: 330 mm × 330 mm × 45 mm
   ● The leader and end of the tape have an empty part of minimum                                                                                 1

     300 mm respectively.
   ● There are two tape outlets on the package for different terminal
     alignment directions, for which details refer to the sketch above.
                                                                                                                                                                  3

     (e.g.) When the tape is fed from the right outlet marked ③ , #3                                                                              33
                                                                                                                                                      0
                                                                                                                                                                                               Direction of feed
                                                                                                                                                                                0
     terminal comes out first.                                                                                                                                               33
   ● Gross weight of the boxing version ETV : Approx. 840 g
                                           ETH : Approx. 930 g
                                                                                                                                                                                                    #3 terminal
                                           ETP : Approx. 850 g

 CT-6
 CERMET TRIMMERS

  CT-6TV
 ● CT-6ETV
           外形図
                                                                                                                   Unless otherwise specified, tolerance: ± 0.3 (Unit: mm)
   Top adjustment
                                                                                                                                                                ①                         ③
                                                                                                                                                                                    CW rotation

             Lead-free Identification mark               260°Nom.                              0.6 W × 2.6 L × 1.6 D                                                            ②

                                                                                               Resistance code &
                                                                                               Production date code

                                                                                                                                                            7
                                                               12.7±1
                                                                                                                                             ∆ 2 max.                ∆ 2 max.
                                                                             7

                                                                                                                                             5.8

                                                                                                0.5 max.
                         24.8±1                                                       3 min.               6±0.5
                                     19±0.75
                                                                                                                   9 +– 0.7
                                                                                                                        0.5

                                                                                                                              18±0.5

                 1                                 2.5              2.5                                                         3
                                                                                                                                                    0.9
                                           6.35±0.5

                                                         12.7±0.3                  0.45±0.02                          φ4±0.2

CT-6TH  外形図
  ● CT-6ETH
   Side adjustment
                                                                                                 0.6 W × 2.6 L × 1.6 D

                                                               12.7±1                                Resistance code &
                                                                                                     Production date code
                                                                                                                                                          7 +– 0.4
                                                                                                                                                               0.1

             Lead-free Identification mark                              7 + 00.4
                                                         260°Nom.                                                                            ∆ 2 max.                ∆ 2 max.

                                                                                                                                       8.2
                                                                                                                                             4.6

                                                                                               0.5 max.
                            27.2±1                                                   3 min.                6±0.5
                                         19±0.75
                                                                                                                                                   3.5

                                                                                                                   9 +– 0.7
                                                                                                                        0.5

                                                                                                                              18±0.5

                     1                             2.5              2.5                                                        3
                                                                                                                                                    0.9
                                           6.35±0.5

                                                         12.7±0.3            0.45±0.02                             φ4±0.2

                                                                                                                                                                                                  CT-6
                                                                                                                                                        CERMET TRIMMERS

● CT-6ETP                                                                                                              Unless otherwise specified, tolerance: ± 0.3 (Unit: mm)
  Top adjustment
                                                                                                                                                                              ①                         ③
                                       Lead-free Identification mark                                         0.6W × 2.6L × 1.6D
                                                                       260°Nom.                                                                                                                   CW rotation

                                                                                                                                                                                             ②

                                                                                                                    Resistance code &
                                                                                                                    Production date code
                                                                                                                                                                                   7
                                                                              12.7±1
                                                                                               7                                                                ∆ 2 max.                ∆ 2 max.

                                                                                                                                                                5.8

                                                                                                    3 min.            0.5 max.
                        24.8±1
                                                                                                                                                                                            2.5
                                                                                                                                 6±0.5
                                 19±0.75   16±1
                                                                                                                                          +0.7
                                                                                                                                          –0.5
                                                                                                                                          9

                                                                                                                                                       18±0.5

                                                              2.5                        2.5                                                                                0.9
                   1                                                                                                                                             3
                                                     6.35±0.5                                                                              φ4±0.2

                                                                       12.7±0.3                0.45±0.02

<Magazine packaging specifications>
● Magazine is packaged 75 pcs. per stick.
  Orders will be accepted for units of 75 pcs. i.e.,
  150, 225 pcs., etc.
      CT-6MP 2 外形図
● Magazine is packed 3000 pcs. sticks per box.
                                                                       CT-6MS 2 外形図
                                                                 <Typical>
                                                                 Plastic magazine length = 580 mm (Without rubber cap)
                                                                                                   9.1                                                                9.1

                                                                                  16.6                                                   16.6
                                                                                         9.8
                                                                                                                                                 7.4

                                                                                                                CT-6EMP                                                           CT-6EMS

Plastic magazine type

 CT-6
 CERMET TRIMMERS

CT-6MP 外形図
 ● CT-6EMP                                                                                           Unless otherwise specified, tolerance: ± 0.3 (Unit: mm)
   Top adjustment
                                                                                                                                      ①                                 ③
                                                     0.6 W × 2.6 L × 1.6 D                      3 – φ0.45
                                                                                                                                                                  CW rotation
                                    260°Nom.                                                                                 2

CT-6EMS 外形図
  Lead-free Identification mark                                                                                                                        ②

                                                                                                                2.5
                                                              7

                                                                                                                 3                                 1

                                      7         Resistance code &            5.8         3.1                                     2.5 2.5
                                                Production date code

 ● CT-6EMS
   Side adjustment

                                      7 +0.4
                                         0
                                               0.6 W × 2.6 L × 1.6 D                                                                  Adjustment
    Lead-free Identification mark                                            7 +0.4
                                                                               –0.2

                                                                                                                 1                                     3.5
                                                                                                                                              3
                                                      8.2                                                        2
                                                                                                                                                       2.5
                                               4.6

                                                      3.1
                                                                                            3 –Φ 0.45                            2.5 2.5
                                               Resistance code &
                                               Production date code

 <Bulk pack specifications>
 ● Unit of bulk pack in a plastic bag is 50 pcs. per pack.
 ● Boxing of bulk in a plastic bag is performed with
   200 pcs. (CT-6EF is 100 pcs.) per box.

 ■ ADJUSTMENT TOOL, MODEL TA-64
                                                                                                     Unless otherwise specified, tolerance: ± 0.3 (Unit: mm)
 ● Good for both minus and cross slot rotors / shafts.
                                                                                      + bit                                                   – bit
 ● Recommended for use with the following copal trimmers.                             Tip thickness 0.5±0.05                                  Tip thickness 0.5±0.05
                                                                                      Tip 2.4 –0.1
                                                                                               0
                                                                                                                                              Tip 2.0

             Recommended models                                                                                              130
                                                                                                12                                                           12
            + bit                     − bit
                                                                                                  2                                                        2
           CT-6                       ST-4
           FT-63                      RJ-4
                                                                                                      2.7                                          2.7
 		                                   RJ-6                                                                            Φ 10
 		                                   TM-7
                                                                                       Material : Polyoxymethylene
 ※ Note : Please do not use the tool for purposes other than adjustment of electronic components.
