cozycactus/x0xb0x-hardware/kicad-working/fabrication/revision-30/ioboard/ioboard-preview-bottom.png

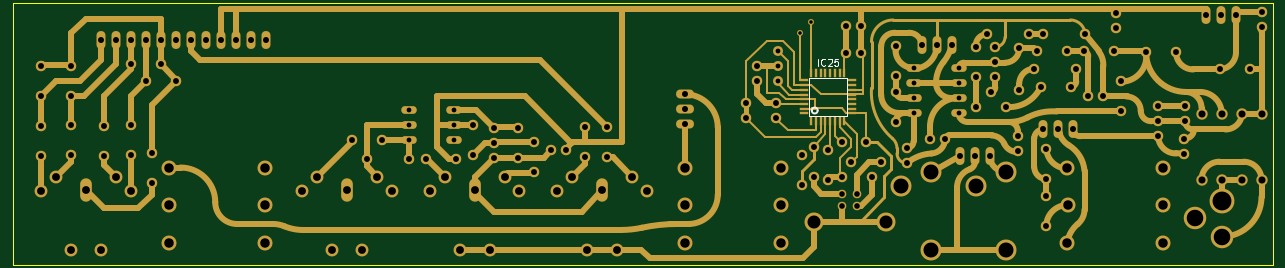
kicad-working/fabrication/revision-30/ioboard/ioboard-preview-bottom.png
