cozycactus/x0xb0x-hardware/kicad-working/fabrication/revision-30/ioboard/ioboard-preview-top.png

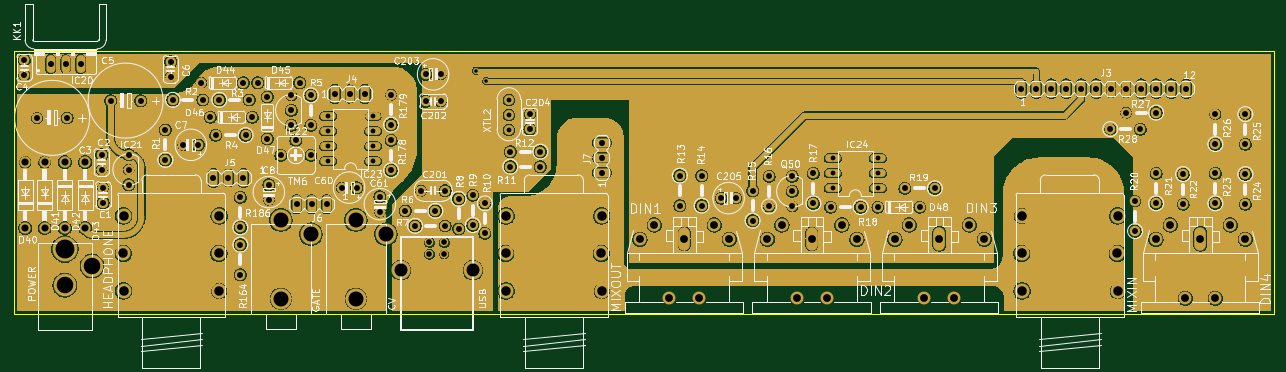
kicad-working/fabrication/revision-30/ioboard/ioboard-preview-top.png
