cozycactus/x0xb0x-hardware/kicad-working/fabrication/revision-30/mainboard/mainboard-preview-top.png

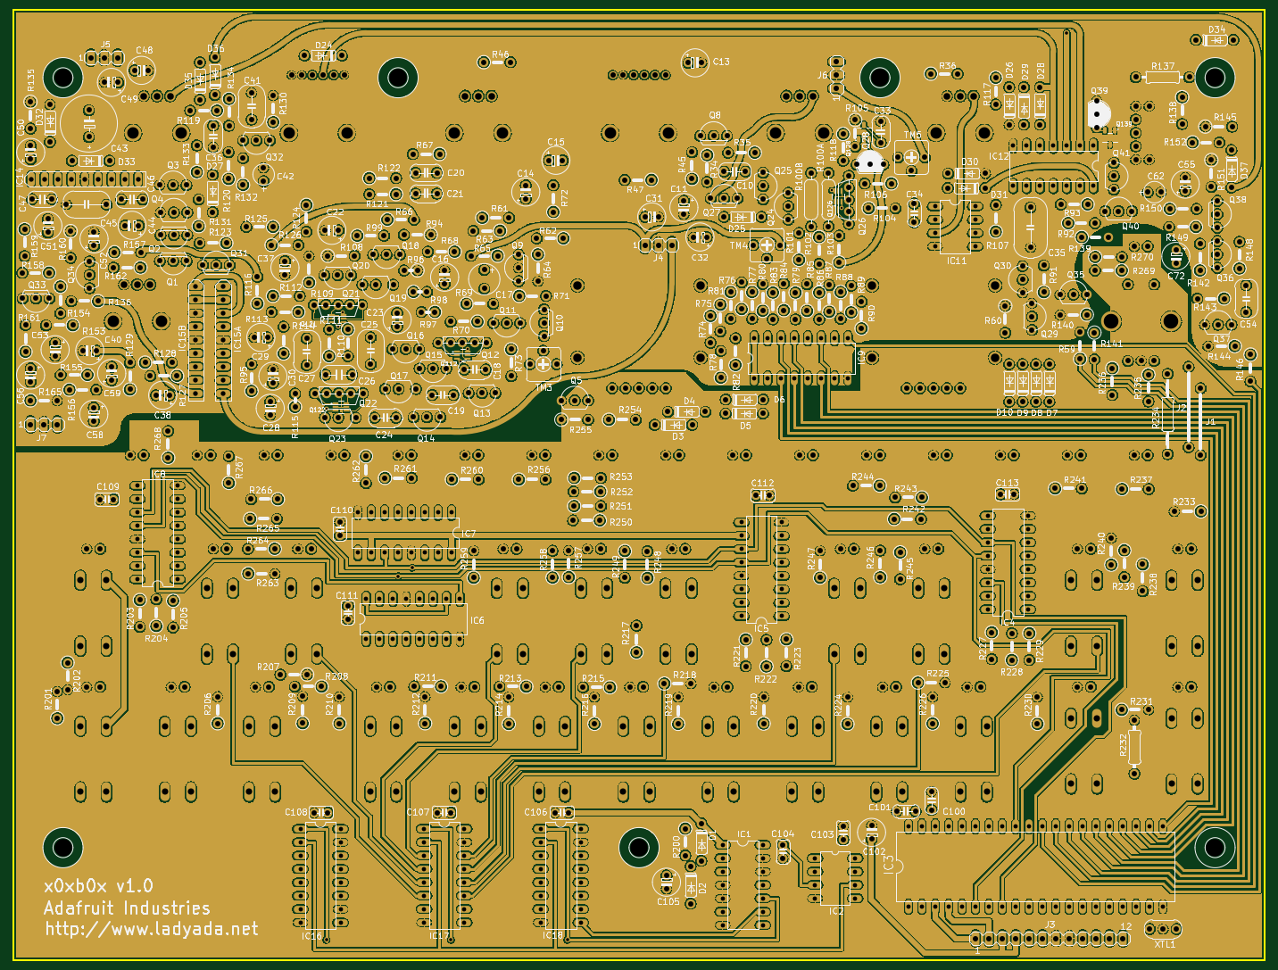
kicad-working/fabrication/revision-30/mainboard/mainboard-preview-top.png
