cozycactus/x0xb0x-hardware/kicad-working/validation/models-review-10/led-assembly-quality/LED-native-panel-mount-review.png

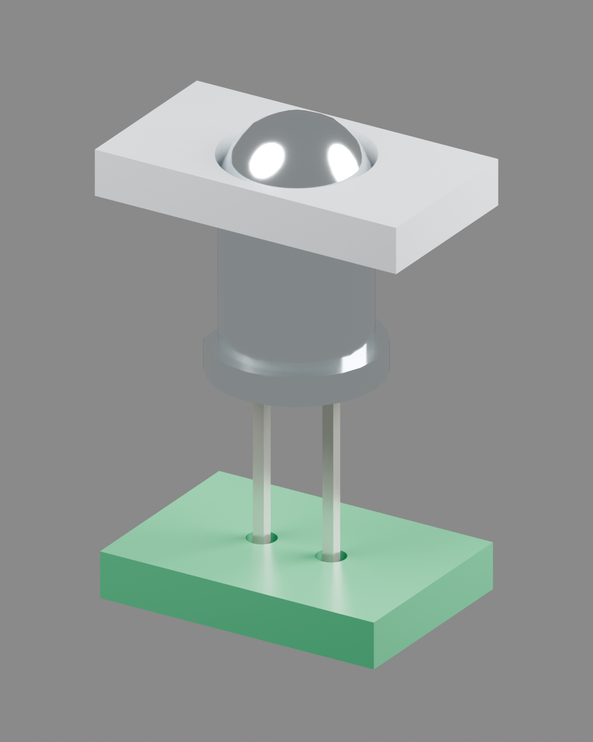
kicad-working/validation/models-review-10/led-assembly-quality/LED-native-panel-mount-review.png
