cozycactus/x0xb0x-hardware/kicad-working/validation/models-review-20/README.md

# KiCad working revision20 — source-dimensioned PTCs

R100A0 and R100B0 now use the original Micro-Ohm LPTC12 family dimensions:3.7mm body length,1.9mm diameter and0.45mm lead diameter. The previous7.62x2.54mm body came from the Eagle footprint outline and the previous0.50mm lead diameter was an assumption. The user recovered the archived manufacturer HTML page and printed it to PDF; its two pages were rendered and inspected. The original PDF is preserved byte-for-byte in `ptc-quality/sources/`. Exact capture timestamp is not established by that print; available CDX archive entries are retained separately.

Original10.16mm PCB pitch, footprint placement, model transforms,1.0mm drills, all copper and rules remain unchanged. The existing illustrated0.4mm body standoff and0.75mm lead bend radius remain, with the lead axis lowered to1.35mm above the model's PCB datum for the smaller body. Solder tails retain their original1.5mm projection beyond the far board face. End tapers, band dimensions/positions and0.01mm recessed paint thickness remain illustrations. The old BOM color sequence and existing Blender materials are retained; this update does not certify TCR decoding, thermal coupling or actual fitted tolerances.

The new STEP passes33 exact-solid, section and round-trip checks. Every lead is a valid continuous sweep with correct analytic volume and full0.45mm cross-section, joined to its body. Round-trip accuracy uses volume, area, centroid, exact bounds and bilateral surface samples to avoid coincident-pipe Boolean classification artifacts and cached display bounds.

Fresh KiCad10.0.7 ERC reports0 errors/0 warnings under retained rules. DRC violations/parity match revision19; the same three electrical gaps remain. Native lead checks pass32 checks across491 models, with11 known nominal fit findings unchanged. Both PTCs fit all four original1.0mm holes with nominal0.275mm radial margin and zero stray sections. See `../working-validation-summary-revision-20.json`. Physical assembly remains unqualified.
