cozycactus/x0xb0x-hardware/kicad-working/validation/models-review-10/remaining-quality-research/sources/2sc536-candidate-pdf-unverified-publisher.txt

2SC536

NPN Silicon Epitaxial Planar Transistor
for switching and AF amplifier applications.

The transistor is subdivided into four groups, O, Y, G
and L, according to its DC current gain.

On special request, these transistors can be
manufactured in different pin configurations.

                                                                                       TO-92 Plastic Package
                                                                                       Weight approx. 0.19g

Absolute Maximum Ratings (Ta = 25℃)

                                                                            Symbol        Value                    Unit
  Collector Base Voltage                                                      VCBO         40                       V

  Collector Emitter Voltage                                                   VCEO         30                       V
  Emitter Base Voltage                                                        VEBO          5                       V
  Collector Current                                                             IC         100                     mA

  Base Current                                                                  IB         50                      mA
  Power Dissipation                                                            Ptot        400                     mW
                                                                                                                   O
  Junction Temperature                                                          Tj         125                       C
                                                                                                                   O
  Storage Temperature Range                                                     TS     -55 to +125                   C

                 SEMTECH ELECTRONICS LTD.
                  (Subsidiary of Sino-Tech International Holdings Limited, a company
                     listed on the Hong Kong Stock Exchange, Stock Code: 724)
            ®
                                                                                                     Dated : 07/12/2002

2SC536

Characteristics at Tamb=25 OC

                                                                Symbol             Min.     Typ.   Max.            Unit
  DC Current Gain
    at VCE=6V, IC=1mA
                             Current Gain Group O                  hFE                 70    -     140               -
                                                         Y         hFE             120       -     240               -
                                                         G         hFE             200       -     400               -
                                                         L         hFE             350       -     700               -
    at VCE=6V, IC=150mA                                            hFE                 25   100     -                -
  Collector Emitter Saturation Voltage
    at IC=50mA, IB=5mA                                           VCE(sat)              -     -     0.5               V
  Base Emitter Saturation Voltage
    at IC=50mA, IB=5mA                                           VBE(sat)              -     -     1.2               V
  Collector Cutoff Current
    at VCB=35V                                                     ICBO                -     -     0.1              μA
  Emitter Cutoff Current
    at VEB=5V                                                      IEBO                -     -     0.1              μA
  Transition Frequency
    at VCE=10V, IE=1mA                                              fT             100       -      -              MHz
  Collector Output Capacitance
    at VCB=10V, f=1MHz                                             COB                 -     2     3.5              pF
  Base Intrinsic Resistance
    at VCB=10V IC=1mA, f=30MHz                                    Rbb’                 -    50      -               Ω
  Noise Figure
    at VCE=6V, IC=0.1Ma
    at f=1KHz, RG=10KΩ                                             NF                  -     1     10               dB

                 SEMTECH ELECTRONICS LTD.
                  (Subsidiary of Sino-Tech International Holdings Limited, a company
                     listed on the Hong Kong Stock Exchange, Stock Code: 724)
            ®
                                                                                                    Dated : 07/12/2002
