cozycactus/x0xb0x-hardware/kicad-working/visualization/blender-case-revision-22/verification/README.md

# Revision22 checks

The saved-file audit compares revision21 and22, accepting only40 named spacer objects, one material, the new guide and declared LED source fields. It verifies the existing object's geometry/appearance and actual rendered instance poses, including hidden wiring-study visibility. The native model, drill-fit, portability, rear-opening and terminal-join checks replay the shared repository tools. Reports pin their source hashes.

All rendering is read-only. The installed close-up uses additional temporary inspection lighting; it does not alter the saved scene. These checks cover nominal geometry and source integrity, not manufacturing tolerances or physical assembly.
