cozycactus/x0xb0x-hardware/kicad-working/visualization/blender-case-revision-20/verification/README.md

# Saved revision-20 checks

`run_verification.sh` regenerates every report, the terminal sheet and the renders from the frozen saved scenes; it never saves a scene.

`../update_tl1100_colour.py` produced the scene from revision 19 and the native KiCad revision-17 GLB exports recorded in `kicad-working/validation/models-review-17/native-export-record.json`. Each TL1100F is a single mesh, mapped to the switch's existing materials by colour. Before saving, it asserts:

- each reference's placement frame and every part's local transform equal the native export;
- every object and material is retained, and none is added;
- only 23 mesh datablocks change.

`audit_saved_scene.py` freshly opens both frozen scenes. It compares all object identities, stored data and properties, shaders, packed fonts, collections, animation, editable glyphs, texts and actual displayed instance matrices at frames 1, 80, 120 and 160. Allowed differences:

- new mesh data on the 23 declared TL1100F objects, with nothing else on them changed;
- five provenance properties on the 23 reference roots;
- the new opening guide and revision properties.

Collections and materials must be identical. The audit also replays the 44 rear checks with 974 rays on both scenes.

`audit_kicad_models.py` replays `scripts/verify_kicad_blender_models.py`: all 491 placed KiCad models match the scene's native meshes. `audit_terminal_joins.py` replays `scripts/verify_terminal_joins.py`: all 133 placed terminal pieces join their bodies. `audit_portability.py` replays the shared 106-check population and resource verifier.

`render_terminal_sheet.py` builds `../terminal-models.png`. It shows each model's own scene meshes in a temporary in-memory scene, in the model frame, with the footprint's drill rings coloured by the nominal-fit audit. `render_tl1100f.py` renders S19 close up into `../tl1100f.png`. `../render_scene.py` renders four standard views and the I/O underside detail. For that detail, the camera clips below the lowest lead and a shadowless upward light exists only in memory. `render-records.json` pins each image and the scene hash, `render-readonly-verification.json` confirms the saved scene bytes are unchanged, and `final-render-review.json` records the visual review and a pixel comparison with revision 19.

`summarize_revision.py` writes `independent-validation-summary.json` and `docs/tl1100f-leg-colour.json` and asserts the stated outcomes.

These checks establish nominal geometry, preservation and native consistency. They do not qualify physical insertion, terminal fit, enclosure tolerances or fabrication.
