cozycactus/x0xb0x-hardware/kicad-working/validation/models-review-10/front-controls-review/final-front-attachment-closeup.png

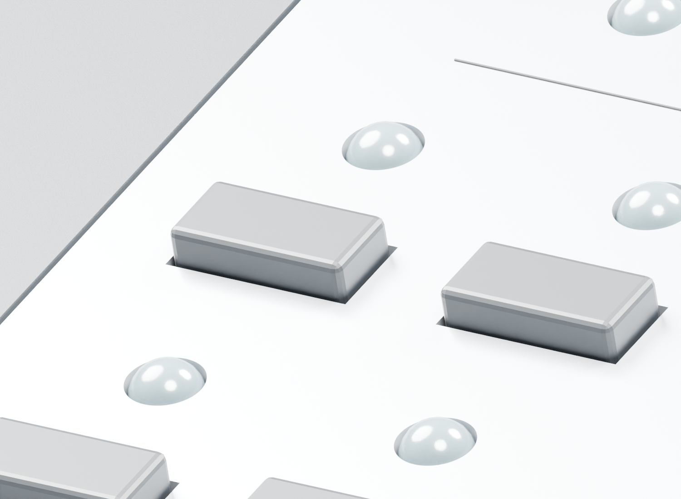
kicad-working/validation/models-review-10/front-controls-review/final-front-attachment-closeup.png
