cozycactus/x0xb0x-hardware/kicad-working/validation/models-review-10/heatsink-fit-research/bent-pair-native-review.png

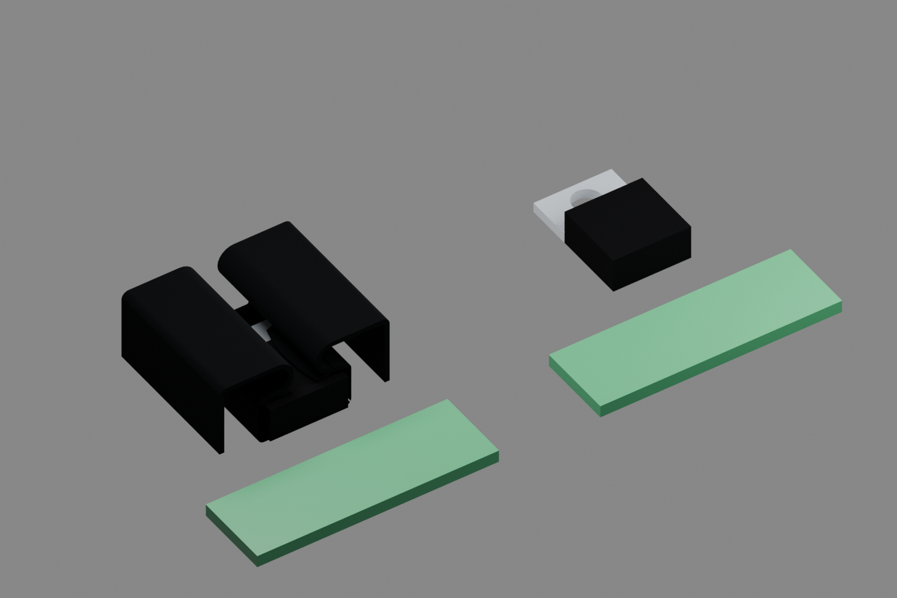
kicad-working/validation/models-review-10/heatsink-fit-research/bent-pair-native-review.png
