cozycactus/x0xb0x-hardware/kicad-working/validation/models-review-10/heatsink-fit-research/sources/boyd-574502B00000G-exact-drawing.png

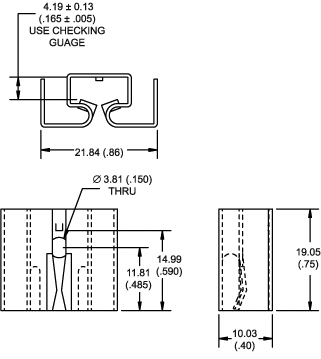
kicad-working/validation/models-review-10/heatsink-fit-research/sources/boyd-574502B00000G-exact-drawing.png
