cozycactus/x0xb0x-hardware/kicad-working/validation/models-review-10/rear-connector-quality/rear-connector-quality-contact-sheet.png

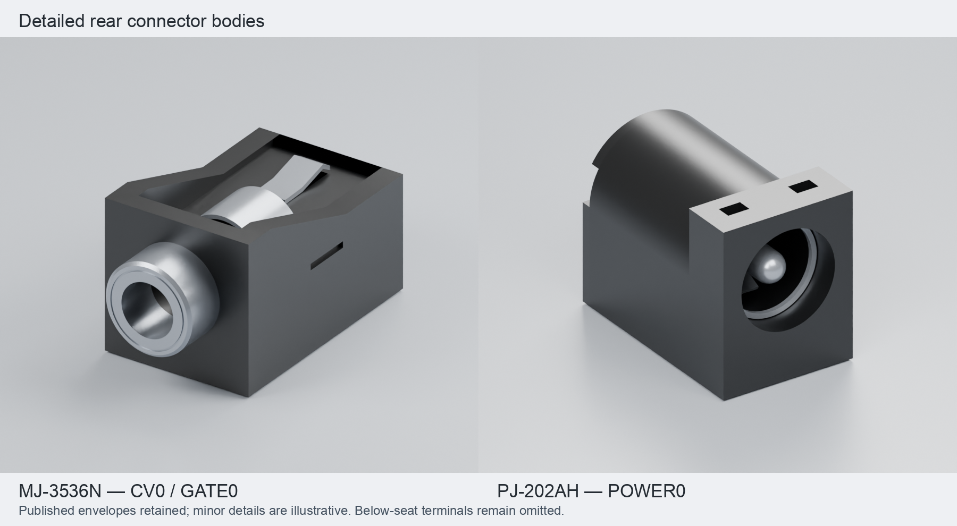
kicad-working/validation/models-review-10/rear-connector-quality/rear-connector-quality-contact-sheet.png
