cozycactus/x0xb0x-hardware/kicad-working/validation/models-review-10/rear-connector-quality/sources/mj3536n-2020-page2.png

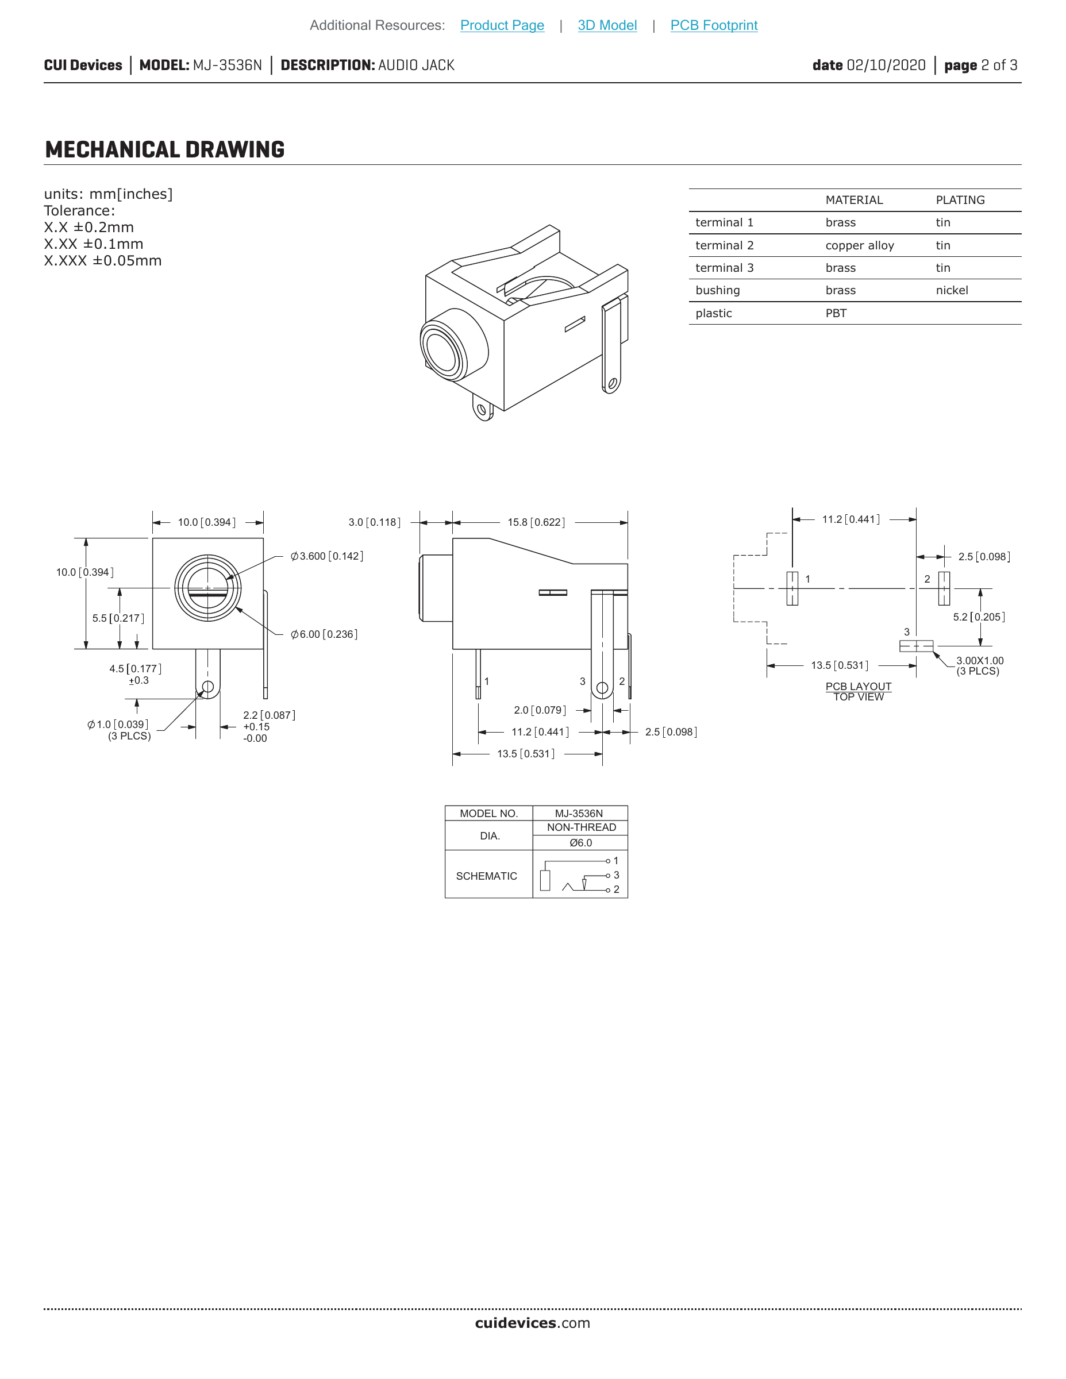
kicad-working/validation/models-review-10/rear-connector-quality/sources/mj3536n-2020-page2.png
