cozycactus/x0xb0x-hardware/kicad-working/validation/models-review-10/remaining-quality-research/rendered/2sc536-candidate-pdf-unverified-publisher-2.png

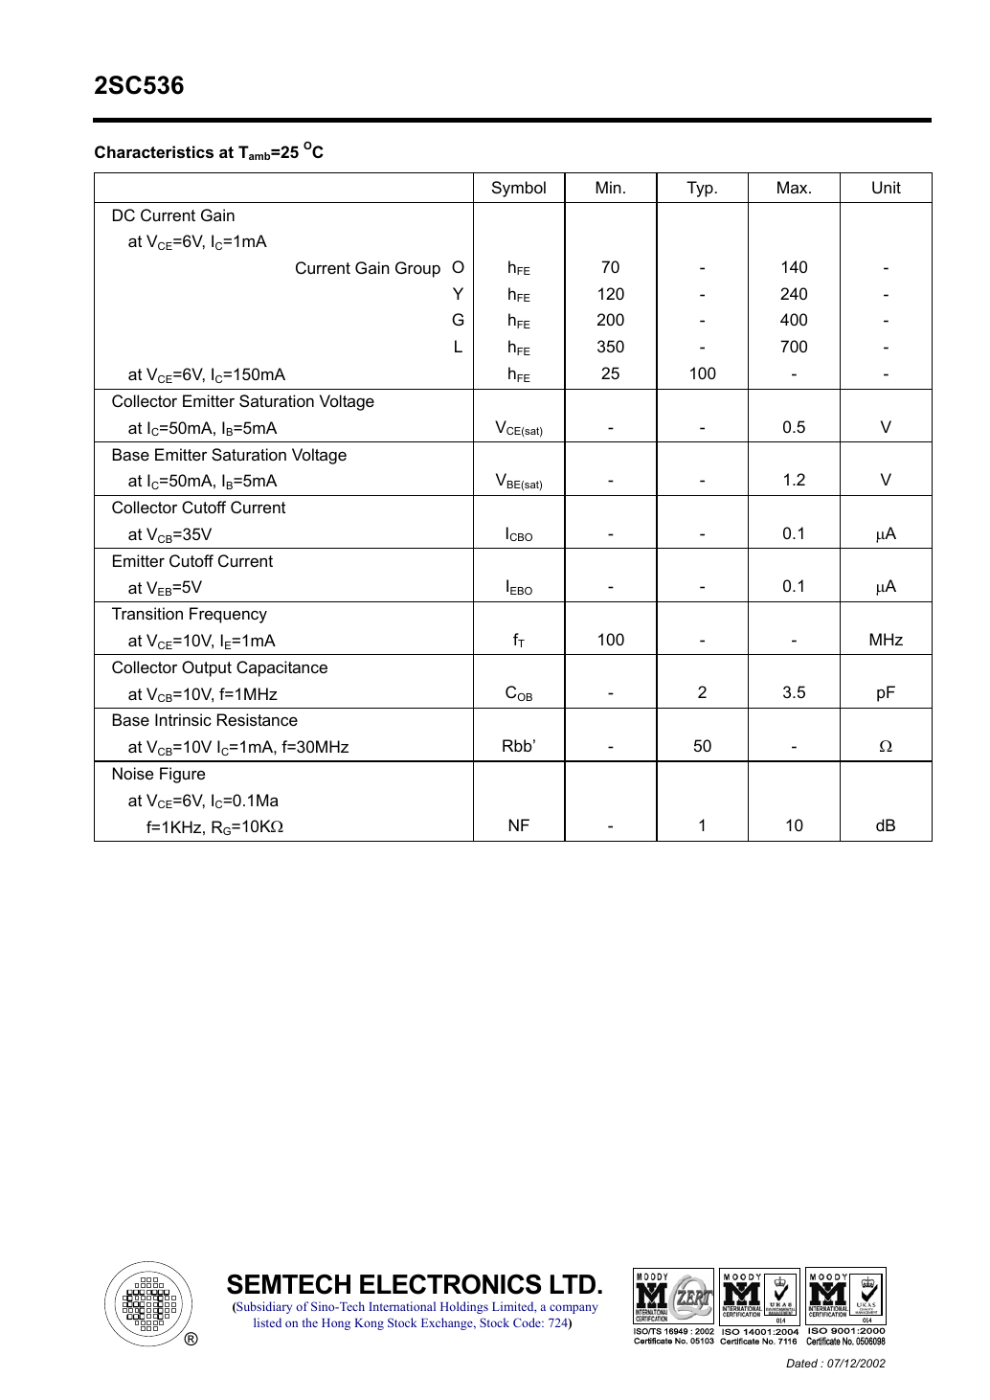
kicad-working/validation/models-review-10/remaining-quality-research/rendered/2sc536-candidate-pdf-unverified-publisher-2.png
