cozycactus/x0xb0x-hardware/kicad-working/validation/models-review-10/remaining-quality-research/rendered/abracon-awcr-md-2013-primary-mirror-2.png

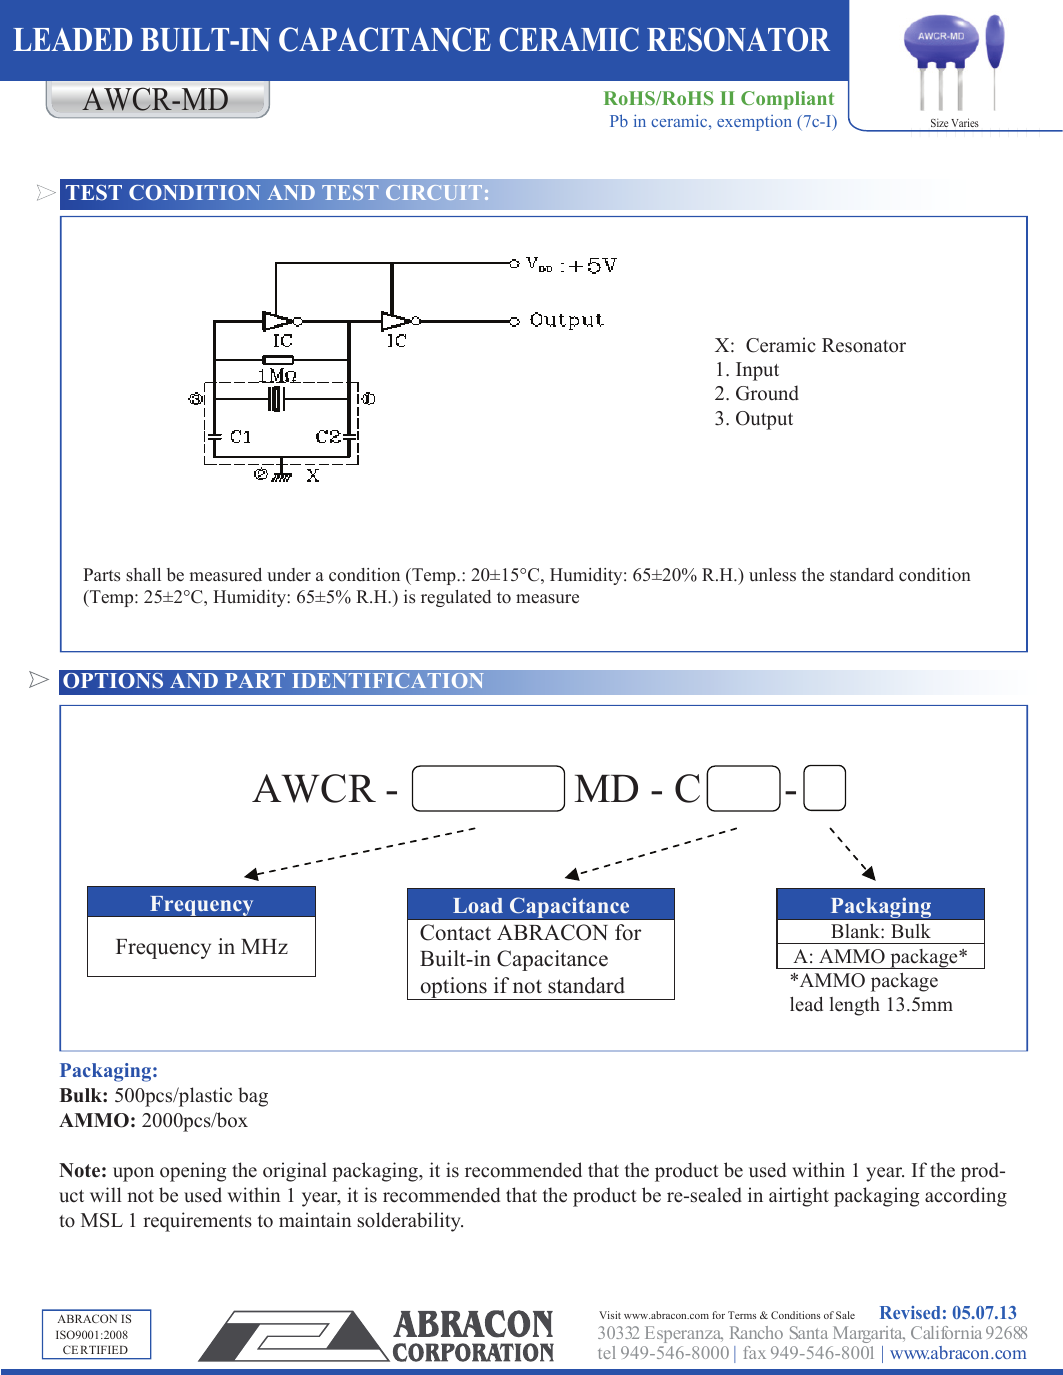
kicad-working/validation/models-review-10/remaining-quality-research/rendered/abracon-awcr-md-2013-primary-mirror-2.png
