cozycactus/x0xb0x-hardware/kicad-working/validation/models-review-10/remaining-quality-research/rendered/jscj-current-2sc536-outline-previously-retained.png

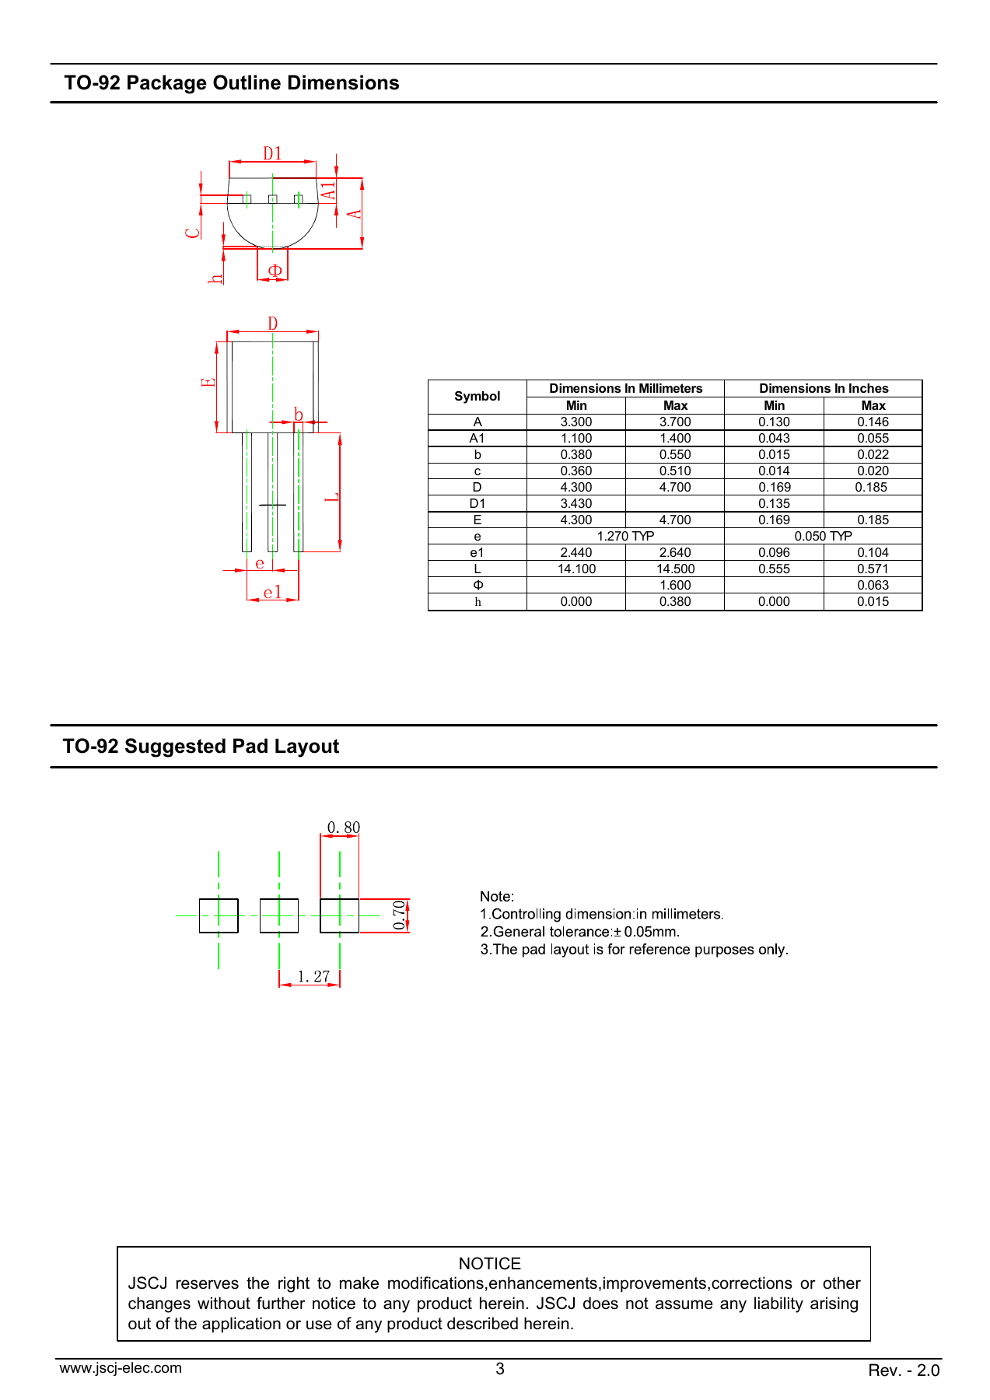
kicad-working/validation/models-review-10/remaining-quality-research/rendered/jscj-current-2sc536-outline-previously-retained.png
