cozycactus/x0xb0x-hardware/kicad-working/validation/models-review-10/remaining-quality-research/rendered/sanyo-2sc536N-primary-mirror-2.png

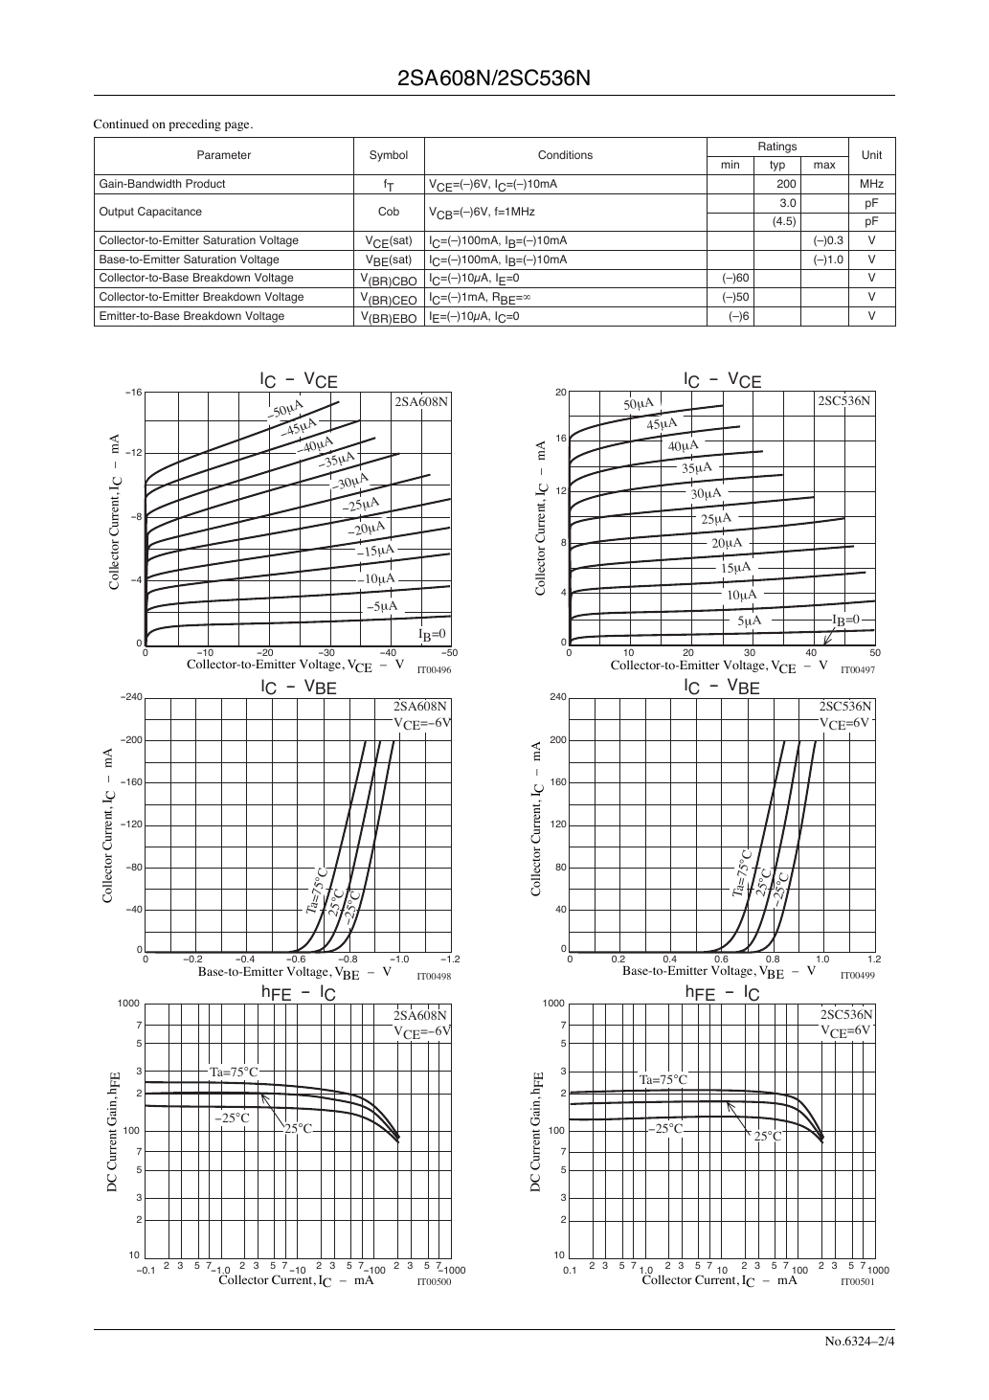
kicad-working/validation/models-review-10/remaining-quality-research/rendered/sanyo-2sc536N-primary-mirror-2.png
