cozycactus/x0xb0x-hardware/kicad-working/validation/models-review-10/remaining-quality-research/rendered/sanyo-discontinued-transistors-table-primary-scan-2.png

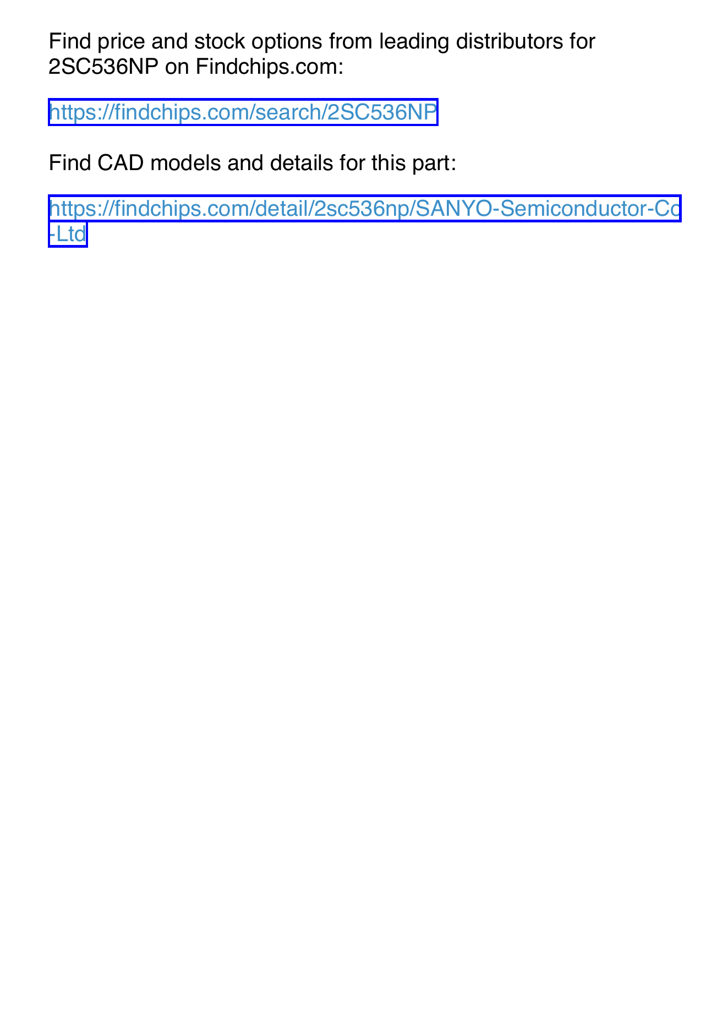
kicad-working/validation/models-review-10/remaining-quality-research/rendered/sanyo-discontinued-transistors-table-primary-scan-2.png
