cozycactus/x0xb0x-hardware/kicad-working/validation/models-review-10/remaining-quality-research/rendered/sanyo-historical-2sc536-family-scan-1.png

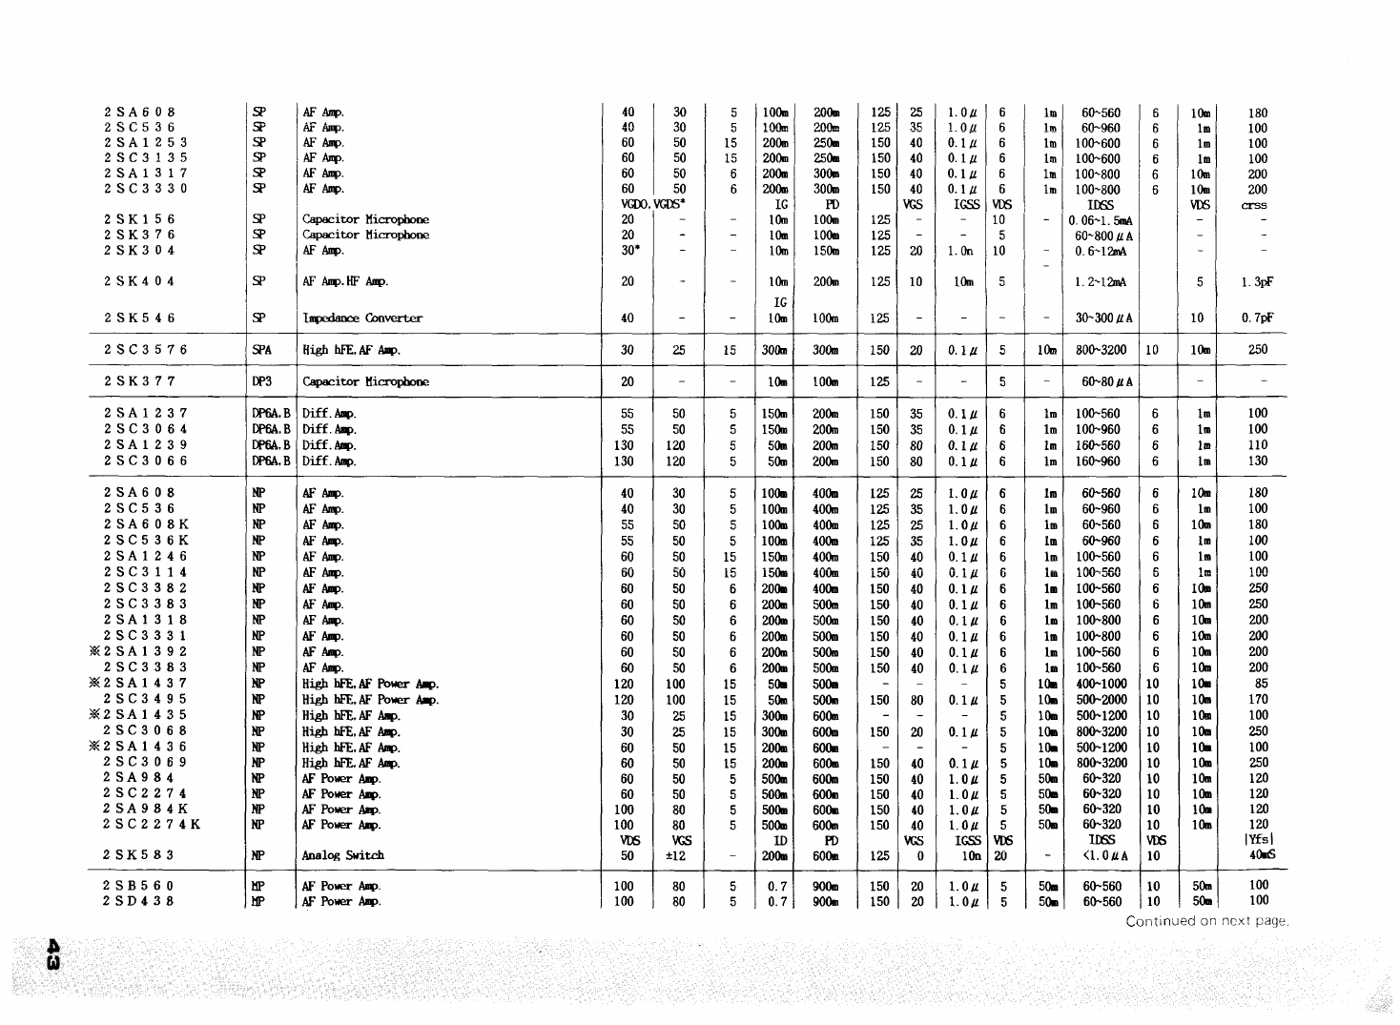
kicad-working/validation/models-review-10/remaining-quality-research/rendered/sanyo-historical-2sc536-family-scan-1.png
