cozycactus/x0xb0x-hardware/kicad-working/validation/models-review-11/resonator-quality/rendered/Abracon_AWCR_MD_2013-page-3.png

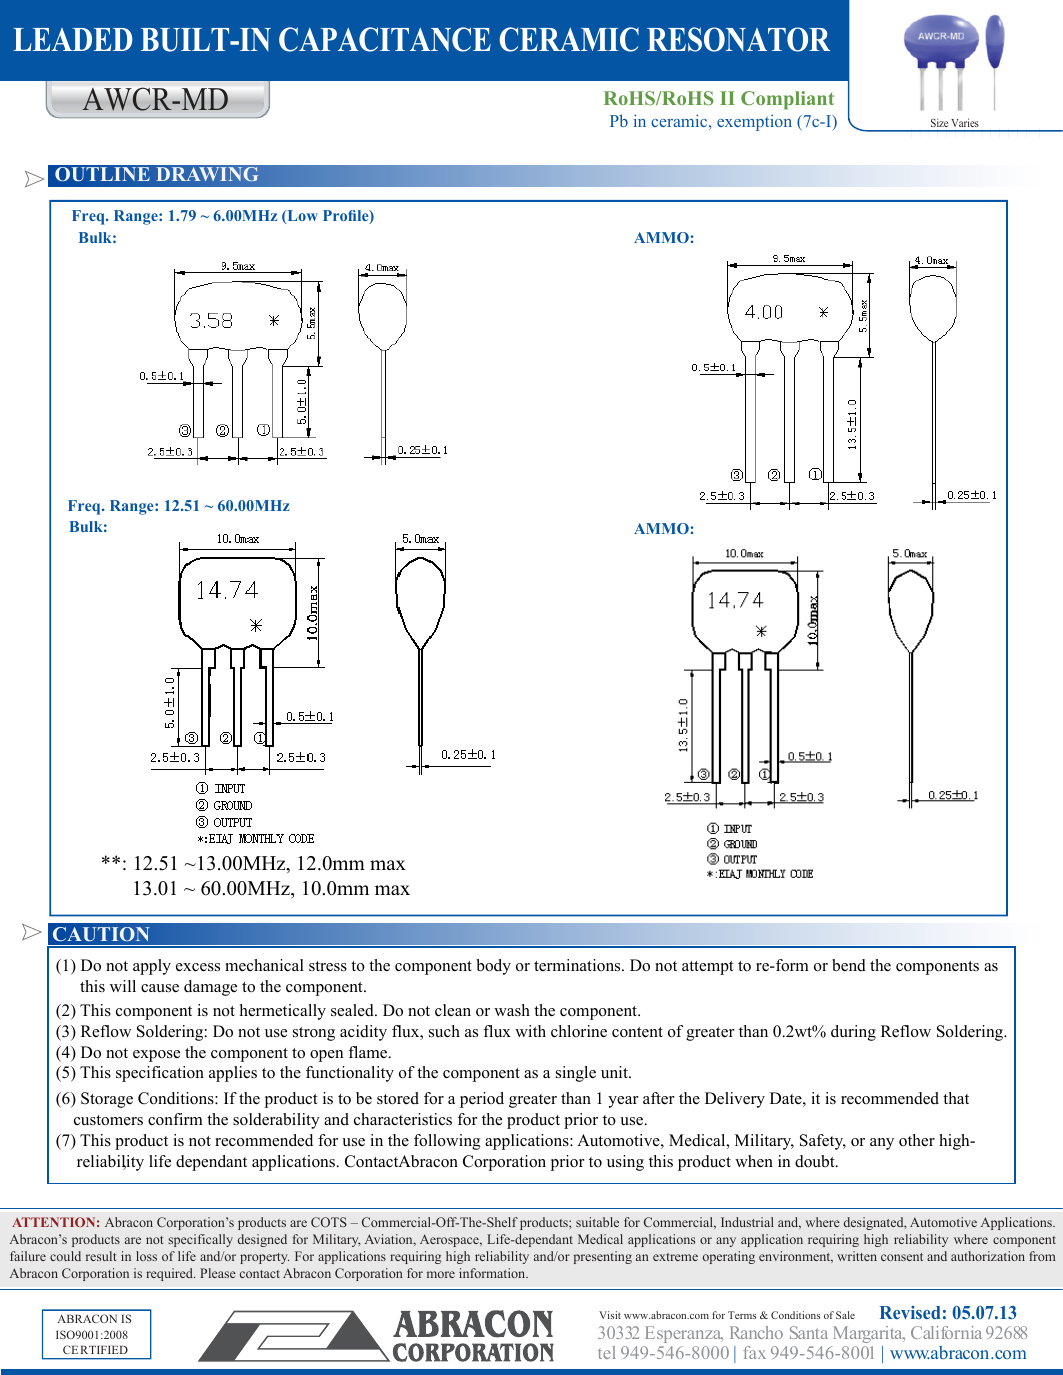
kicad-working/validation/models-review-11/resonator-quality/rendered/Abracon_AWCR_MD_2013-page-3.png
