cozycactus/x0xb0x-hardware/kicad-working/validation/models-review-11/resonator-quality/resonator-quality-contact-sheet.png

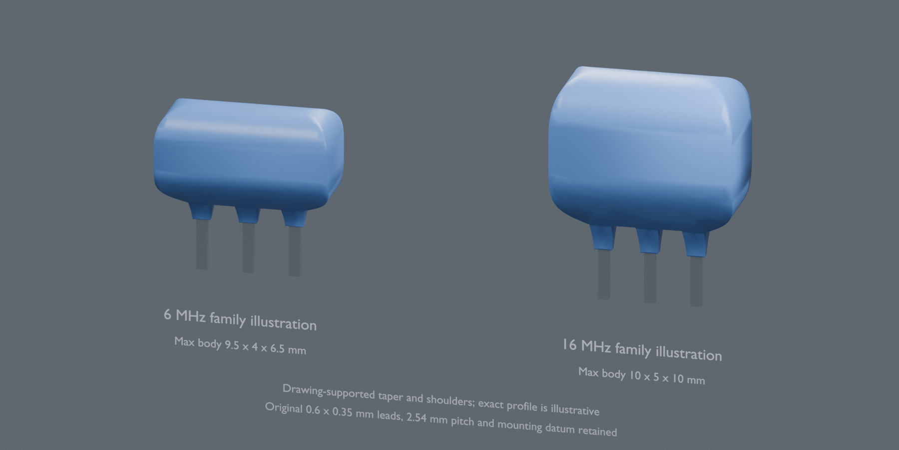
kicad-working/validation/models-review-11/resonator-quality/resonator-quality-contact-sheet.png
