cozycactus/x0xb0x-hardware/kicad-working/validation/models-review-11/transistor-quality/Sanyo-NP2003A-native-review.png

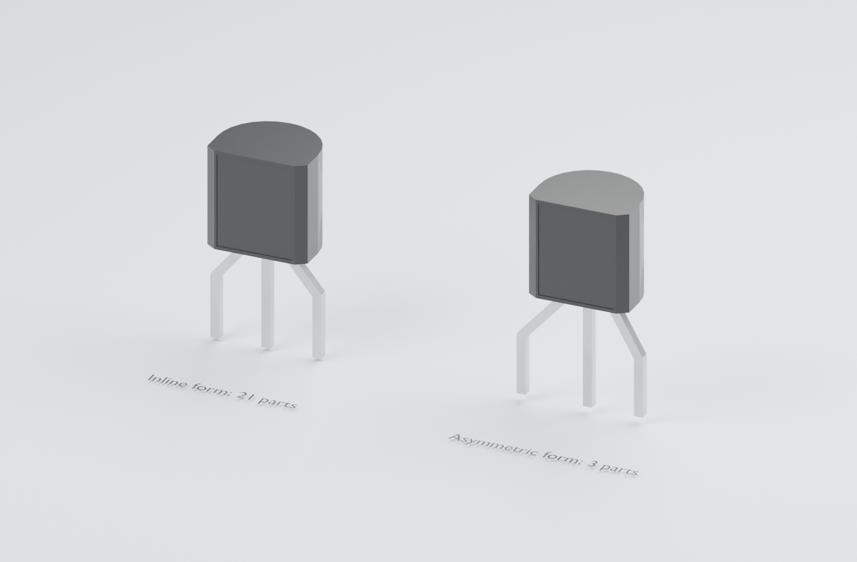
kicad-working/validation/models-review-11/transistor-quality/Sanyo-NP2003A-native-review.png
