cozycactus/x0xb0x-hardware/kicad-working/validation/models-review-11/transistor-research/rendered/1985-Sanyo-handbook-cover.png

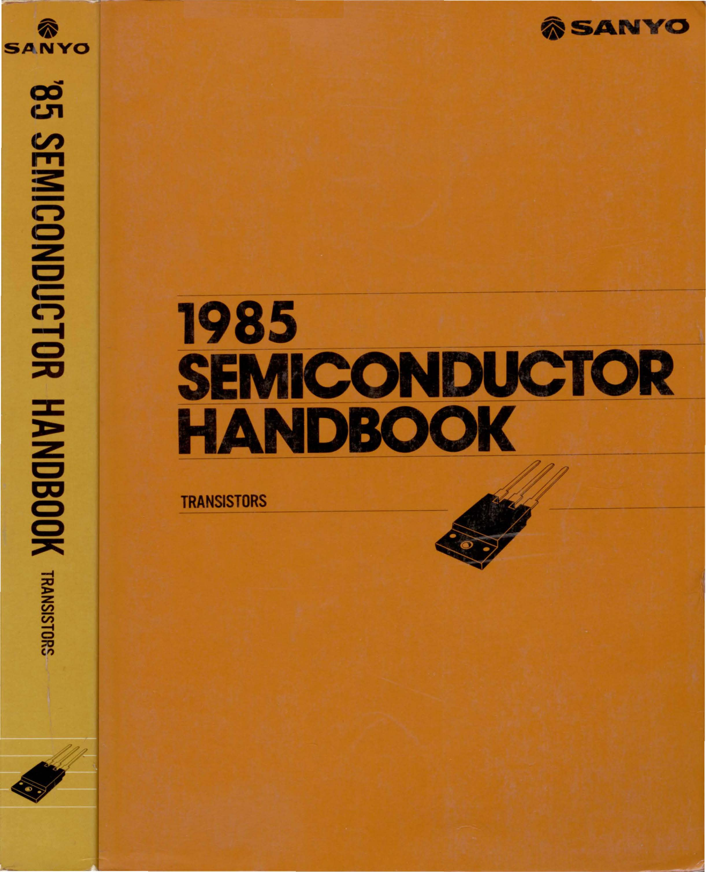
kicad-working/validation/models-review-11/transistor-research/rendered/1985-Sanyo-handbook-cover.png
