cozycactus/x0xb0x-hardware/kicad-working/validation/models-review-11/transistor-research/rendered/sanyo-general-package-page44.png

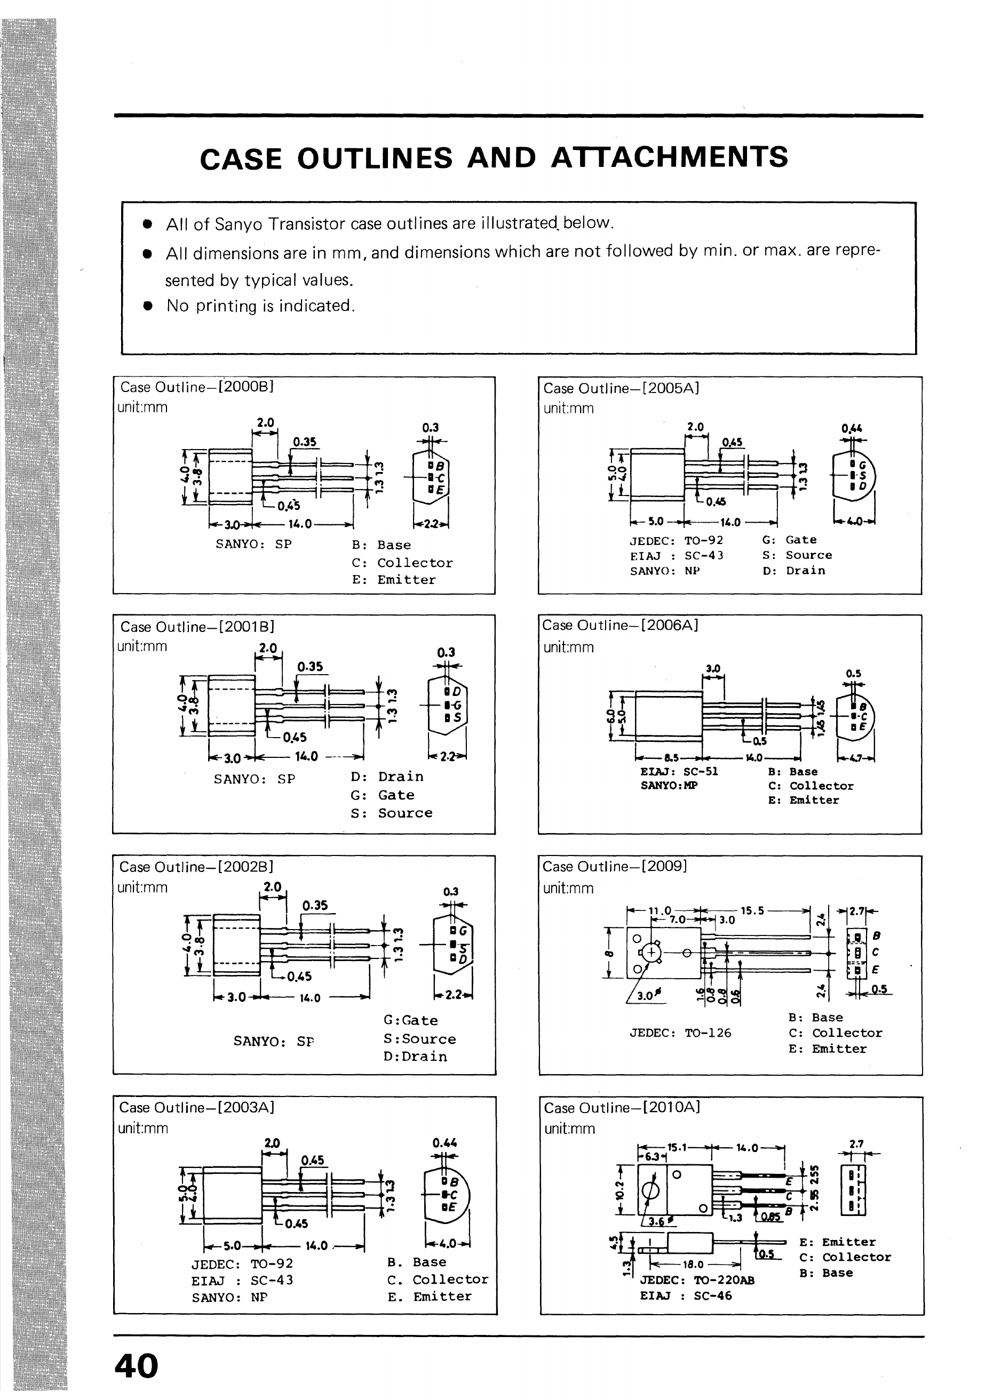
kicad-working/validation/models-review-11/transistor-research/rendered/sanyo-general-package-page44.png
