cozycactus/x0xb0x-hardware/kicad-working/validation/models-review-11/transistor-research/rendered/sanyo-No333H-handbook-page247.png

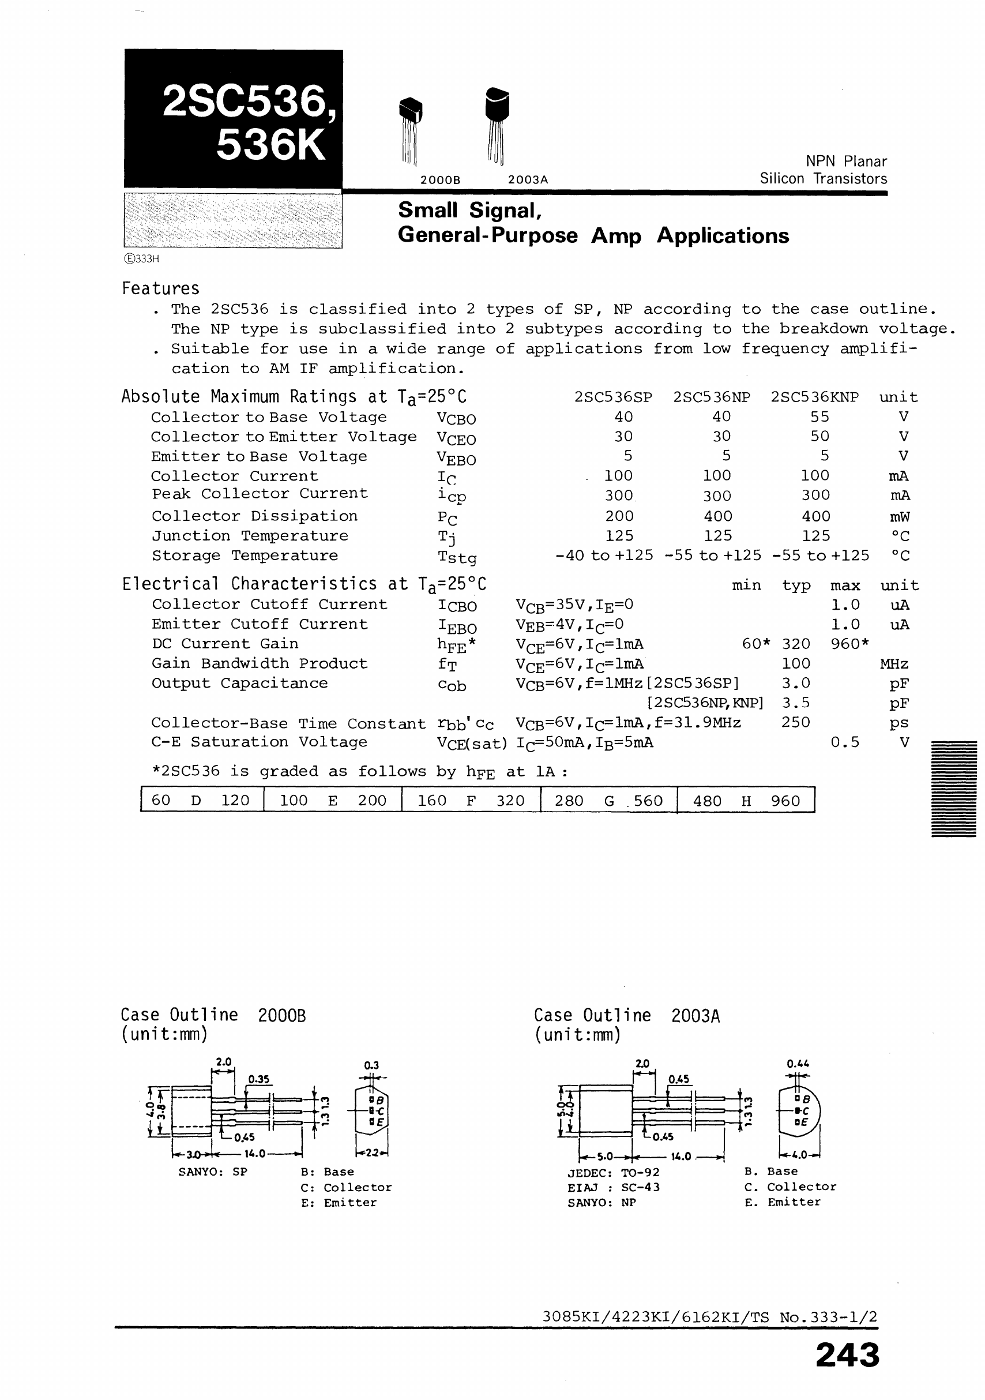
kicad-working/validation/models-review-11/transistor-research/rendered/sanyo-No333H-handbook-page247.png
