cozycactus/x0xb0x-hardware/kicad-working/validation/models-review-11/transistor-research/rendered/sanyo-No333H-outline-full-detail.png

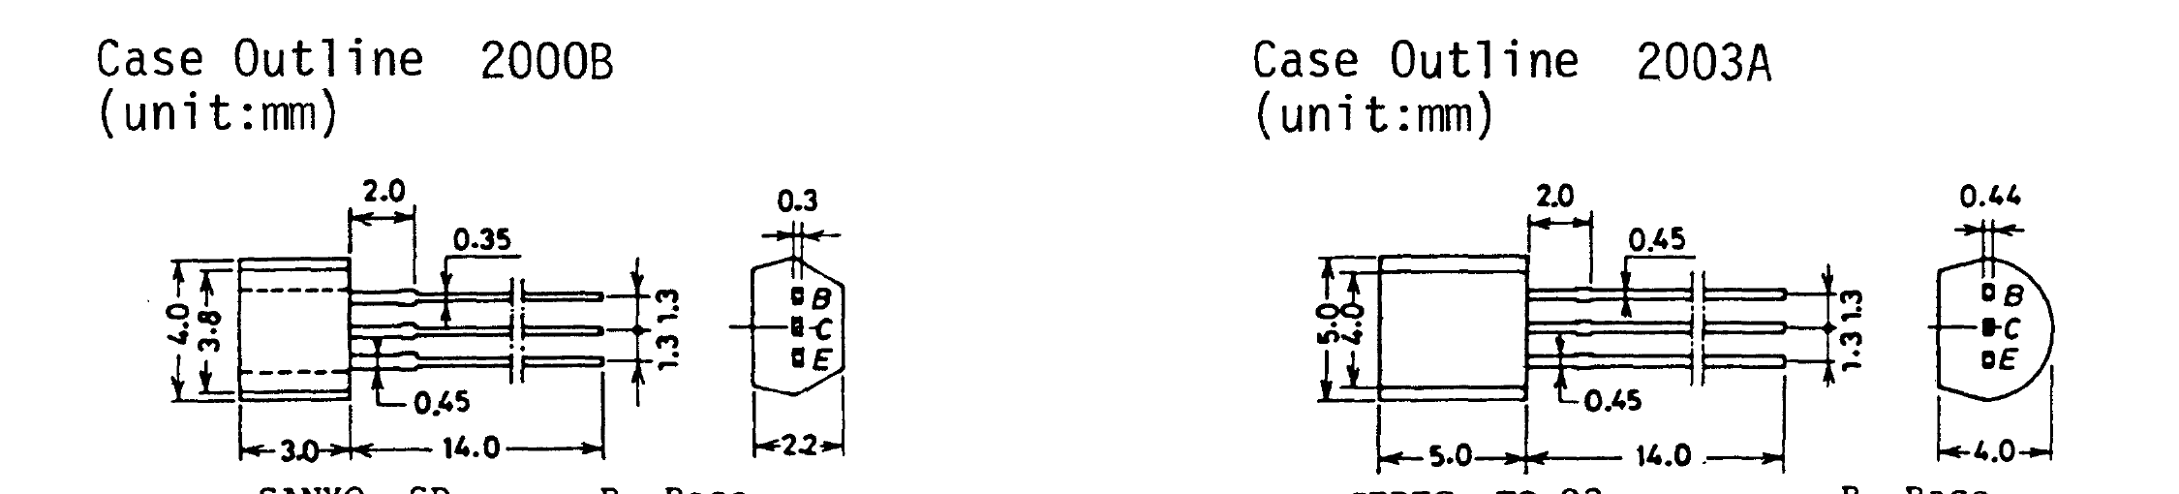
kicad-working/validation/models-review-11/transistor-research/rendered/sanyo-No333H-outline-full-detail.png
