cozycactus/x0xb0x-hardware/kicad-working/validation/rear-openings-review/source-audit/nys216-drawing.png

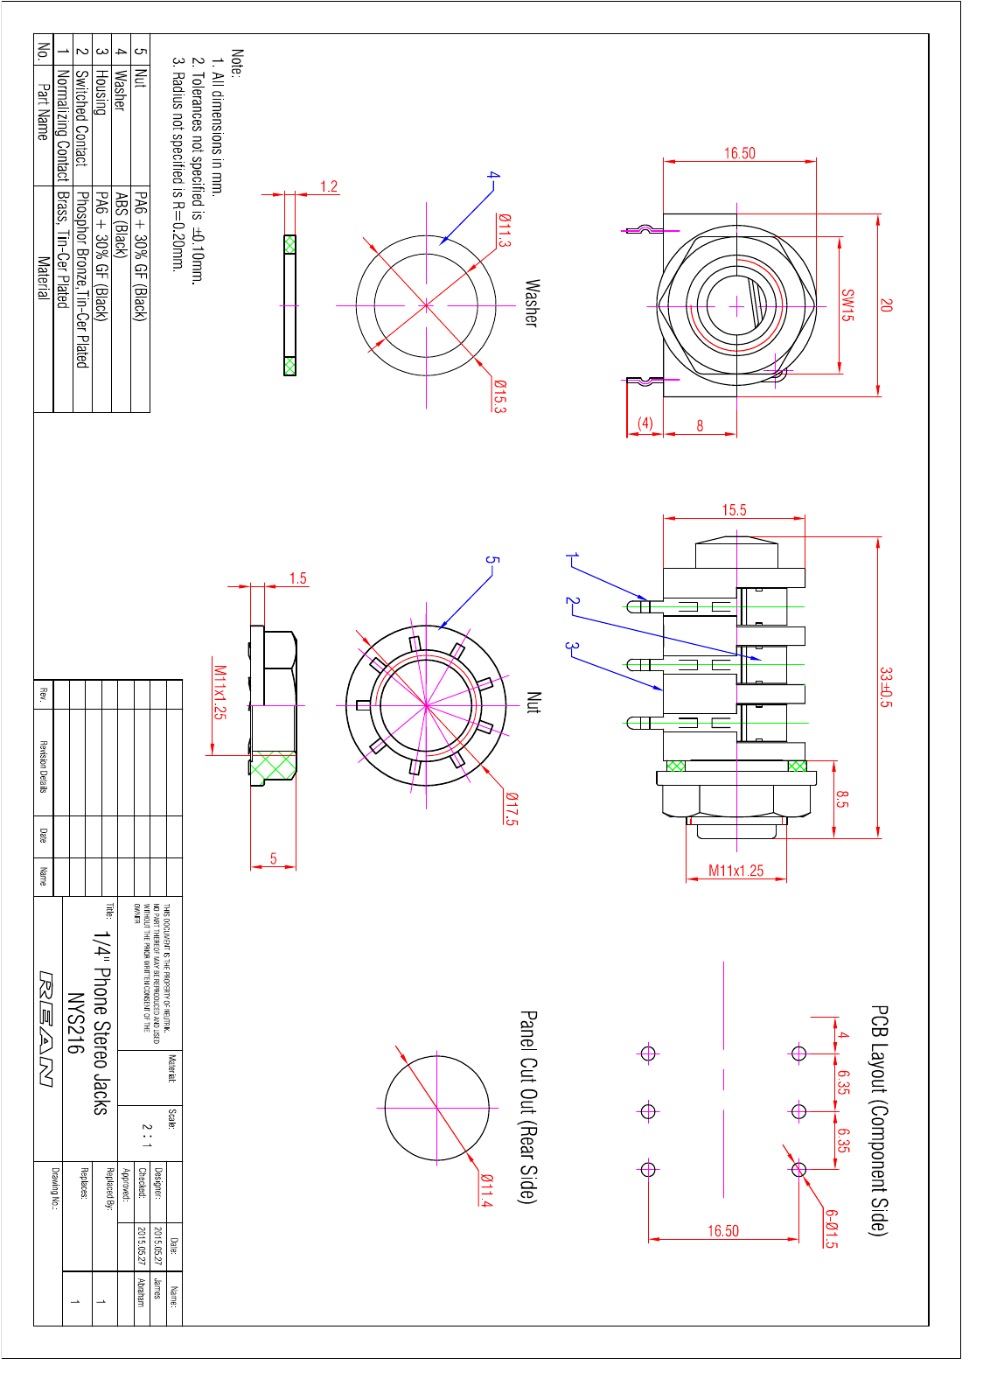
kicad-working/validation/rear-openings-review/source-audit/nys216-drawing.png
