cozycactus/x0xb0x-hardware/kicad-working/validation/rear-openings-review/source-audit/nys216-nut-detail.png

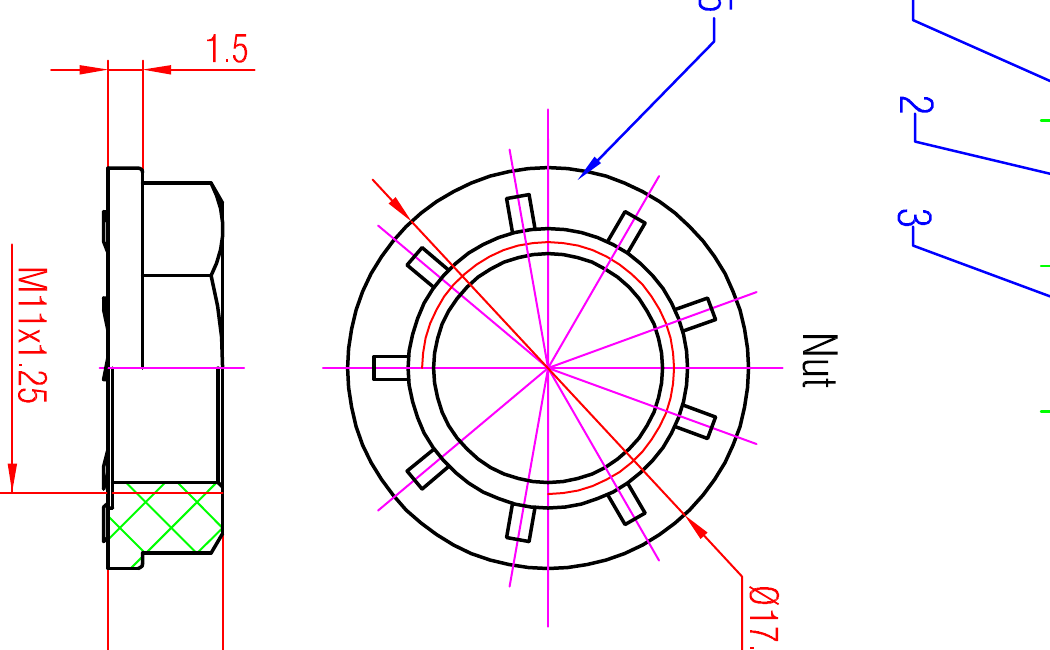
kicad-working/validation/rear-openings-review/source-audit/nys216-nut-detail.png
