cozycactus/x0xb0x-hardware/kicad-working/validation/rear-openings-review/source-audit/sds50j-drawing.png

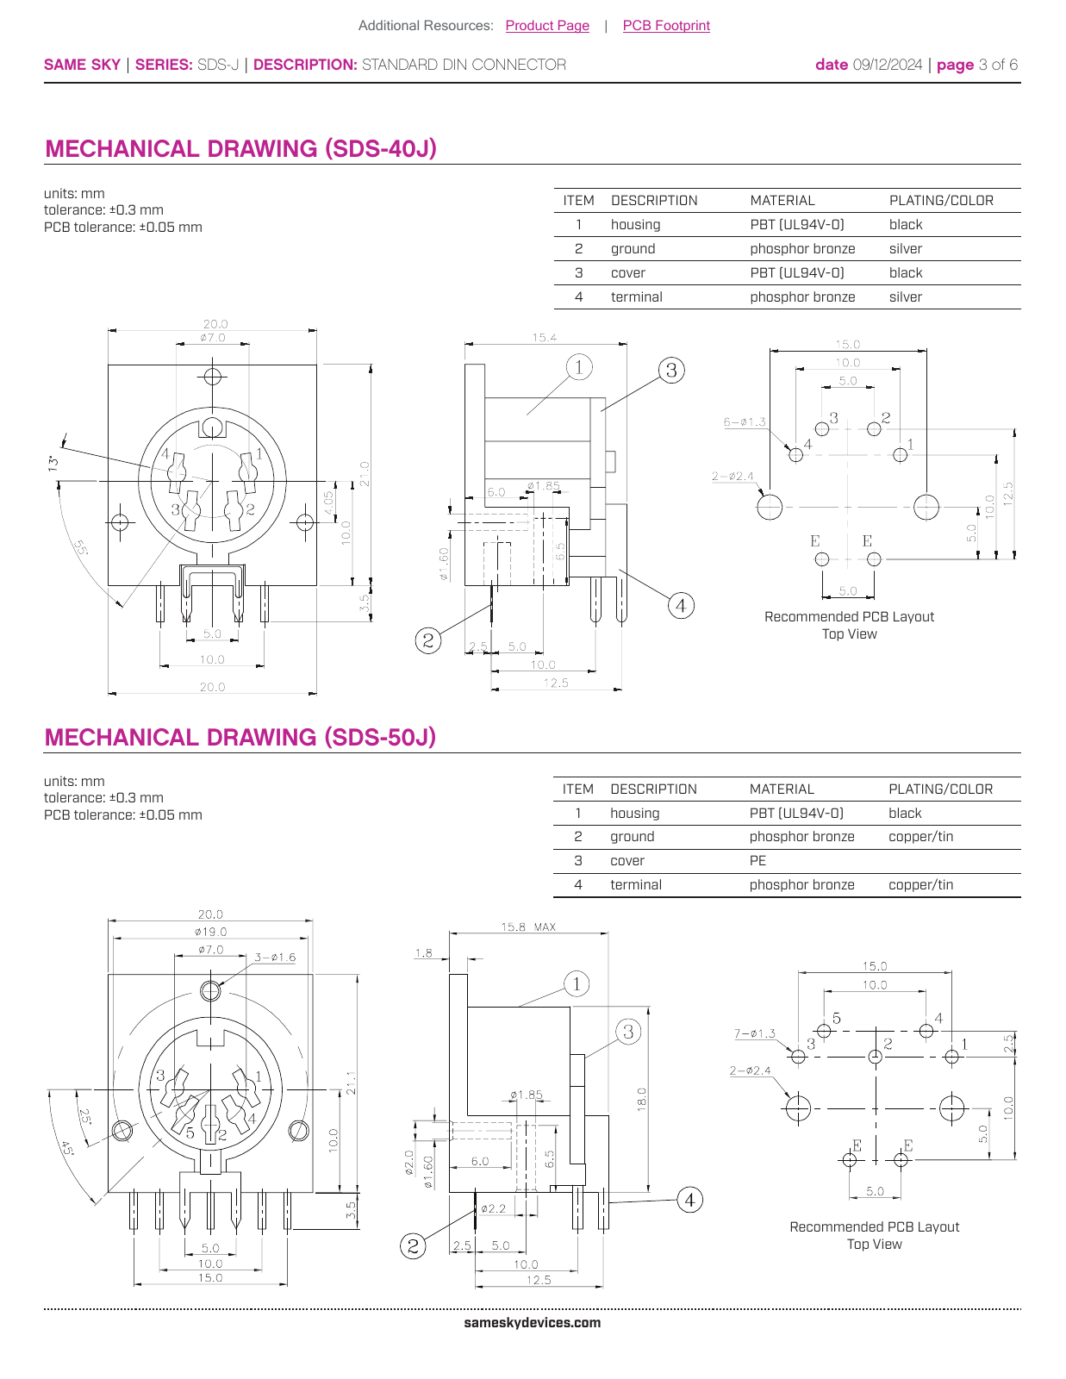
kicad-working/validation/rear-openings-review/source-audit/sds50j-drawing.png
