cozycactus/x0xb0x-hardware/kicad-working/validation/vcf-simulation/plots/01-validation.png

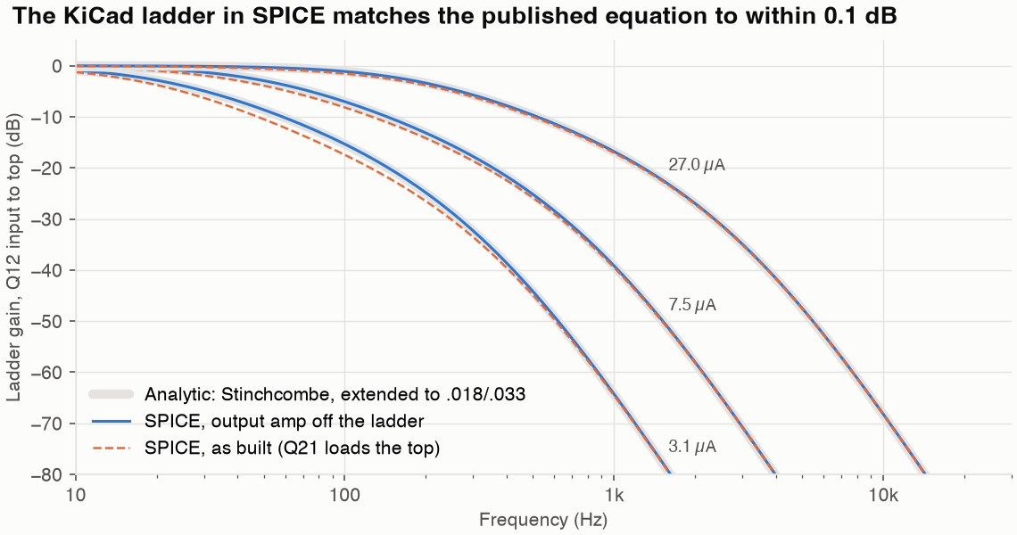
kicad-working/validation/vcf-simulation/plots/01-validation.png
