cozycactus/x0xb0x-hardware/kicad-working/validation/vcf-simulation/plots/05-waveforms.png

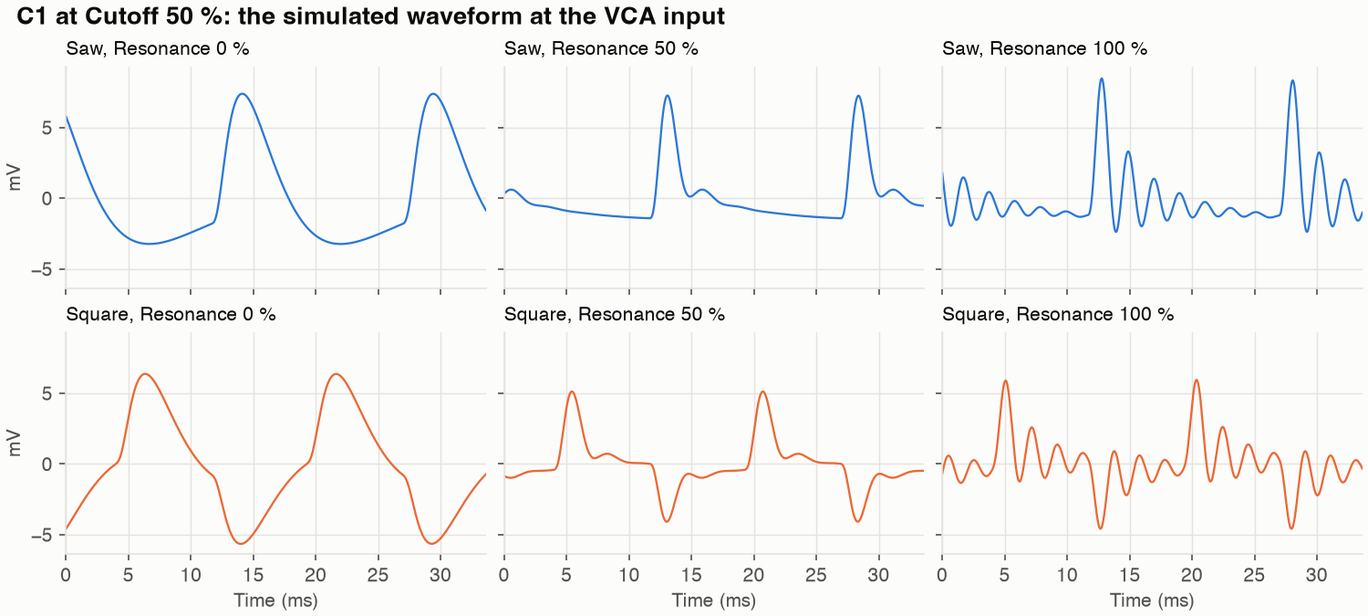
kicad-working/validation/vcf-simulation/plots/05-waveforms.png
