cozycactus/x0xb0x-hardware/kicad-working/schematic-redraw/ioboard-schematic.pdf

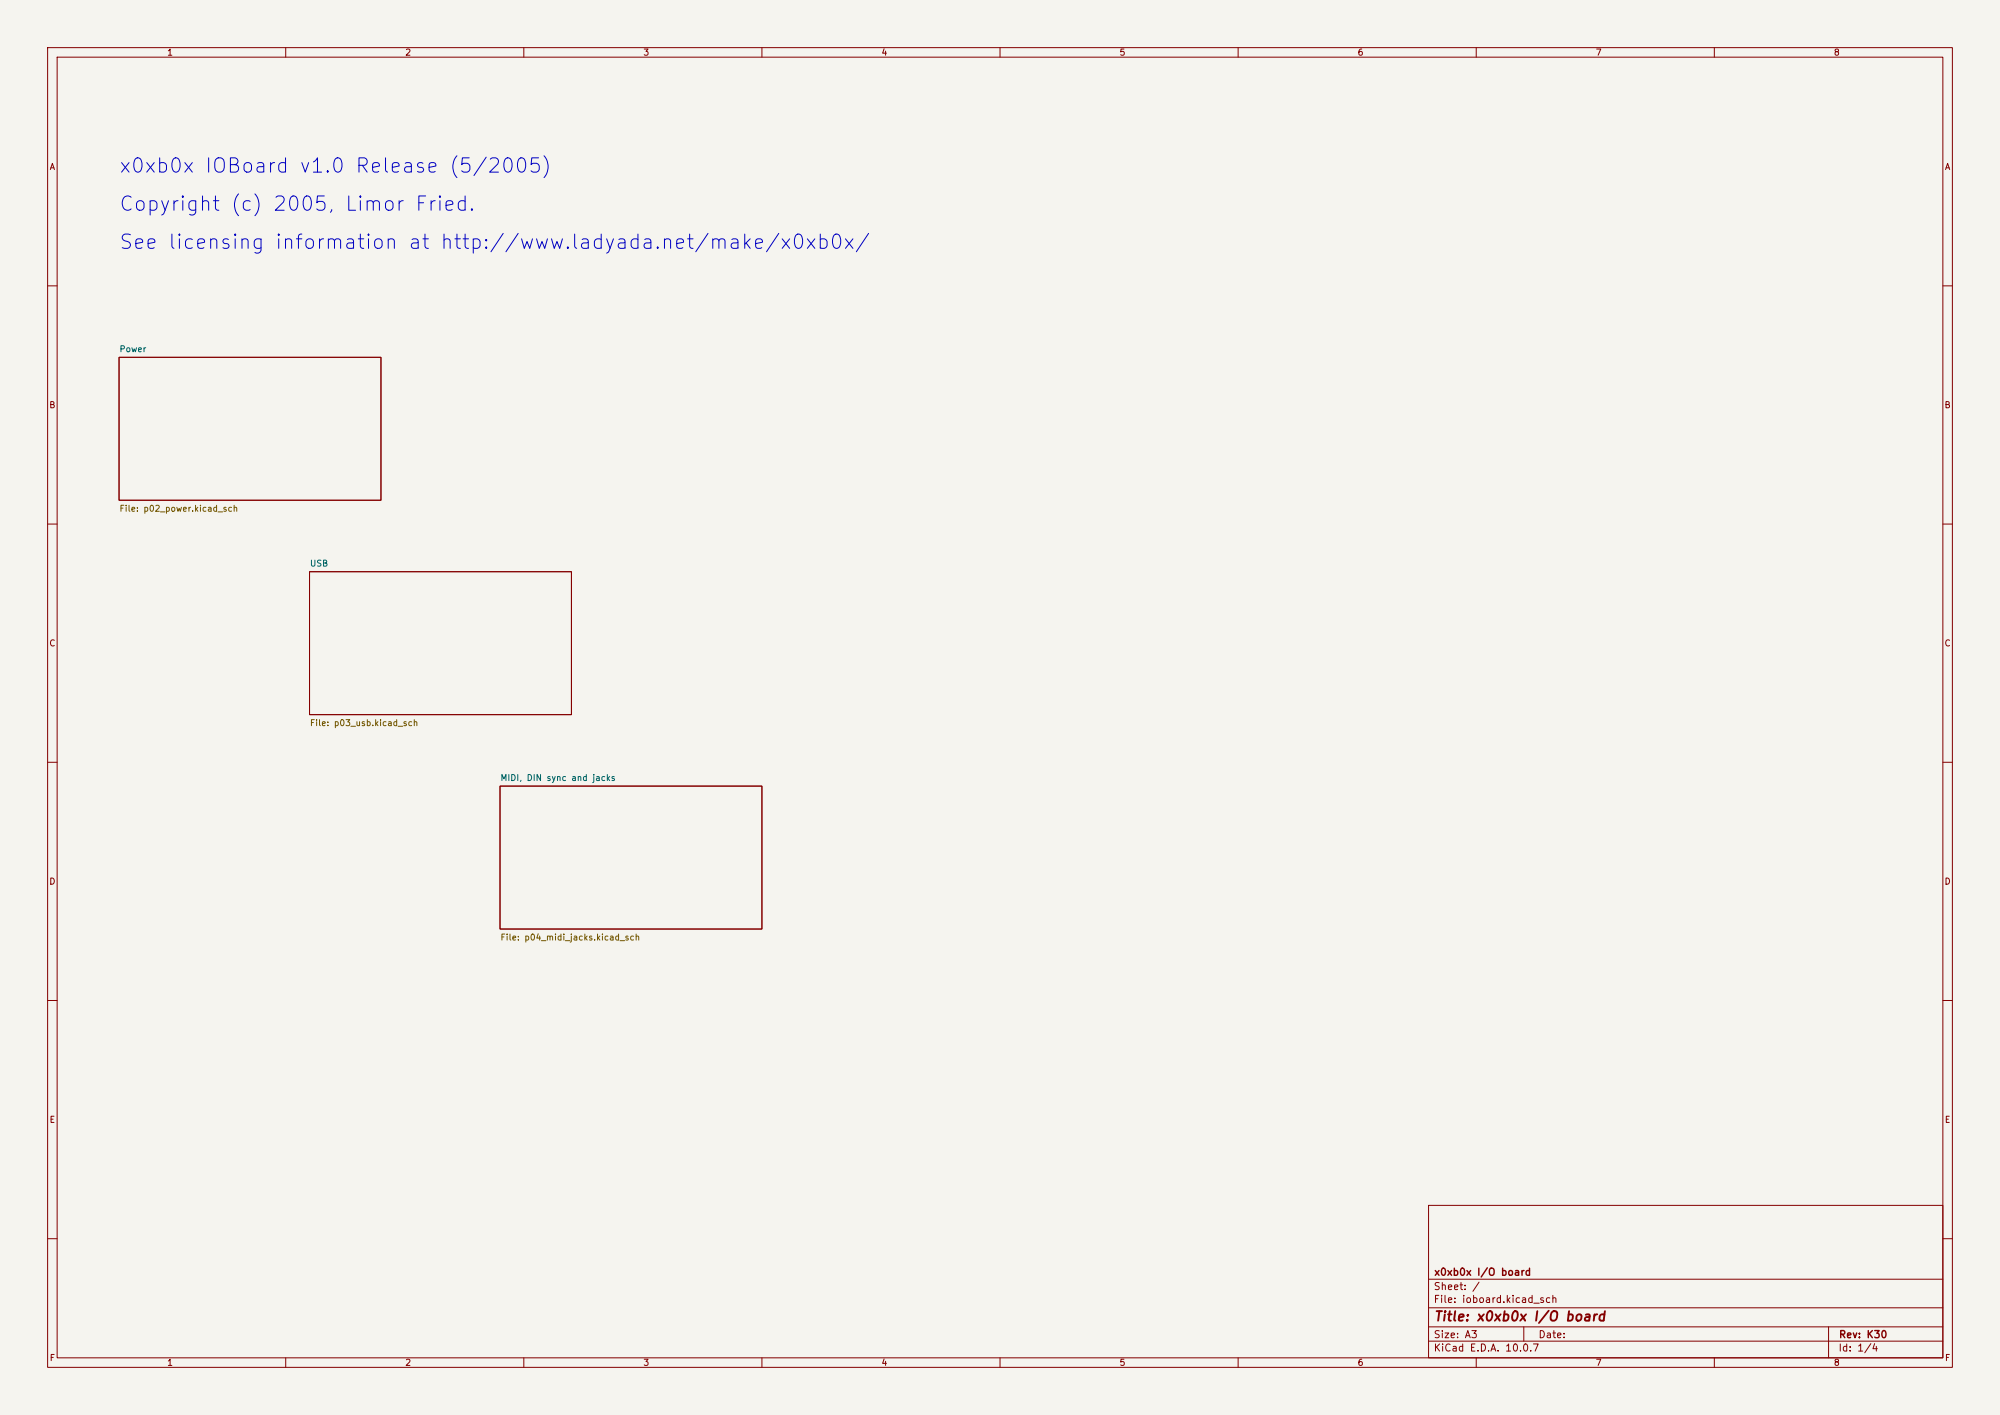
[picture p143: page 1]

x0xb0x IOBoard v1.0 Release (5/2005)
Copyright (c) 2005, Limor Fried.
See licensing information at http://www.ladyada.net/make/x0xb0x/

MIDI, DIN sync and jacks File: p04_midi_jacks.kicad_sch

Size: A3 | Rev: K30 | F Date:
KiCad E.D.A. 10.0.7 | Id: 1/4

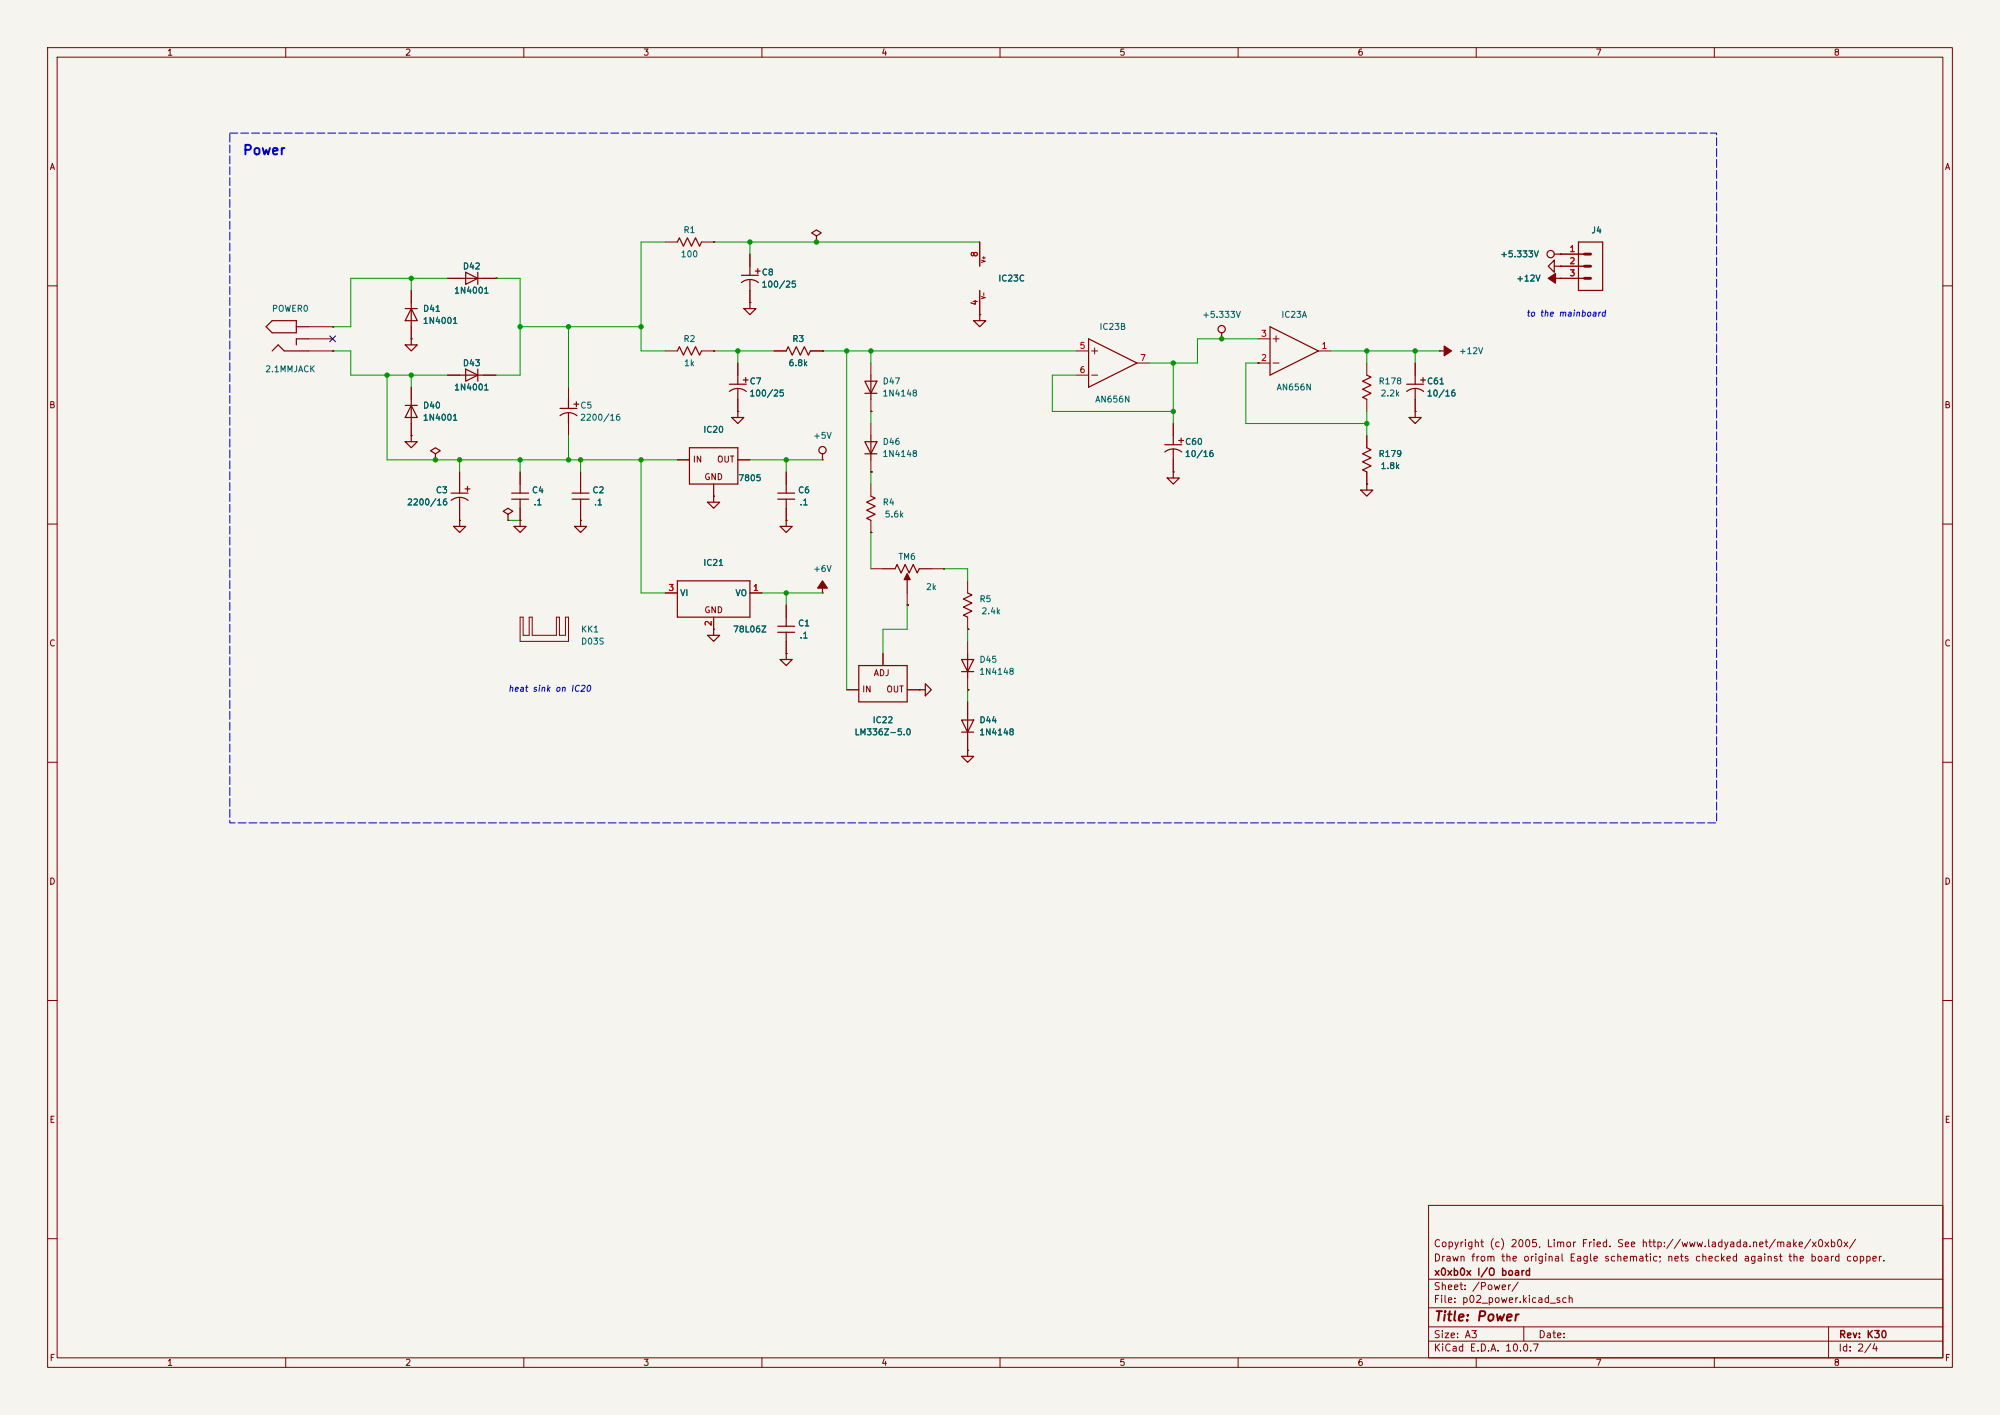
[picture p144: page 2]

Copyright (c) 2005, Limor Fried. See http://www.ladyada.net/make/x0xb0x/
Drawn from the original Eagle schematic; nets checked against the board copper.
x0xb0x I/O board
Sheet: /Power/
File: p02_power.kicad_sch
Title: Power

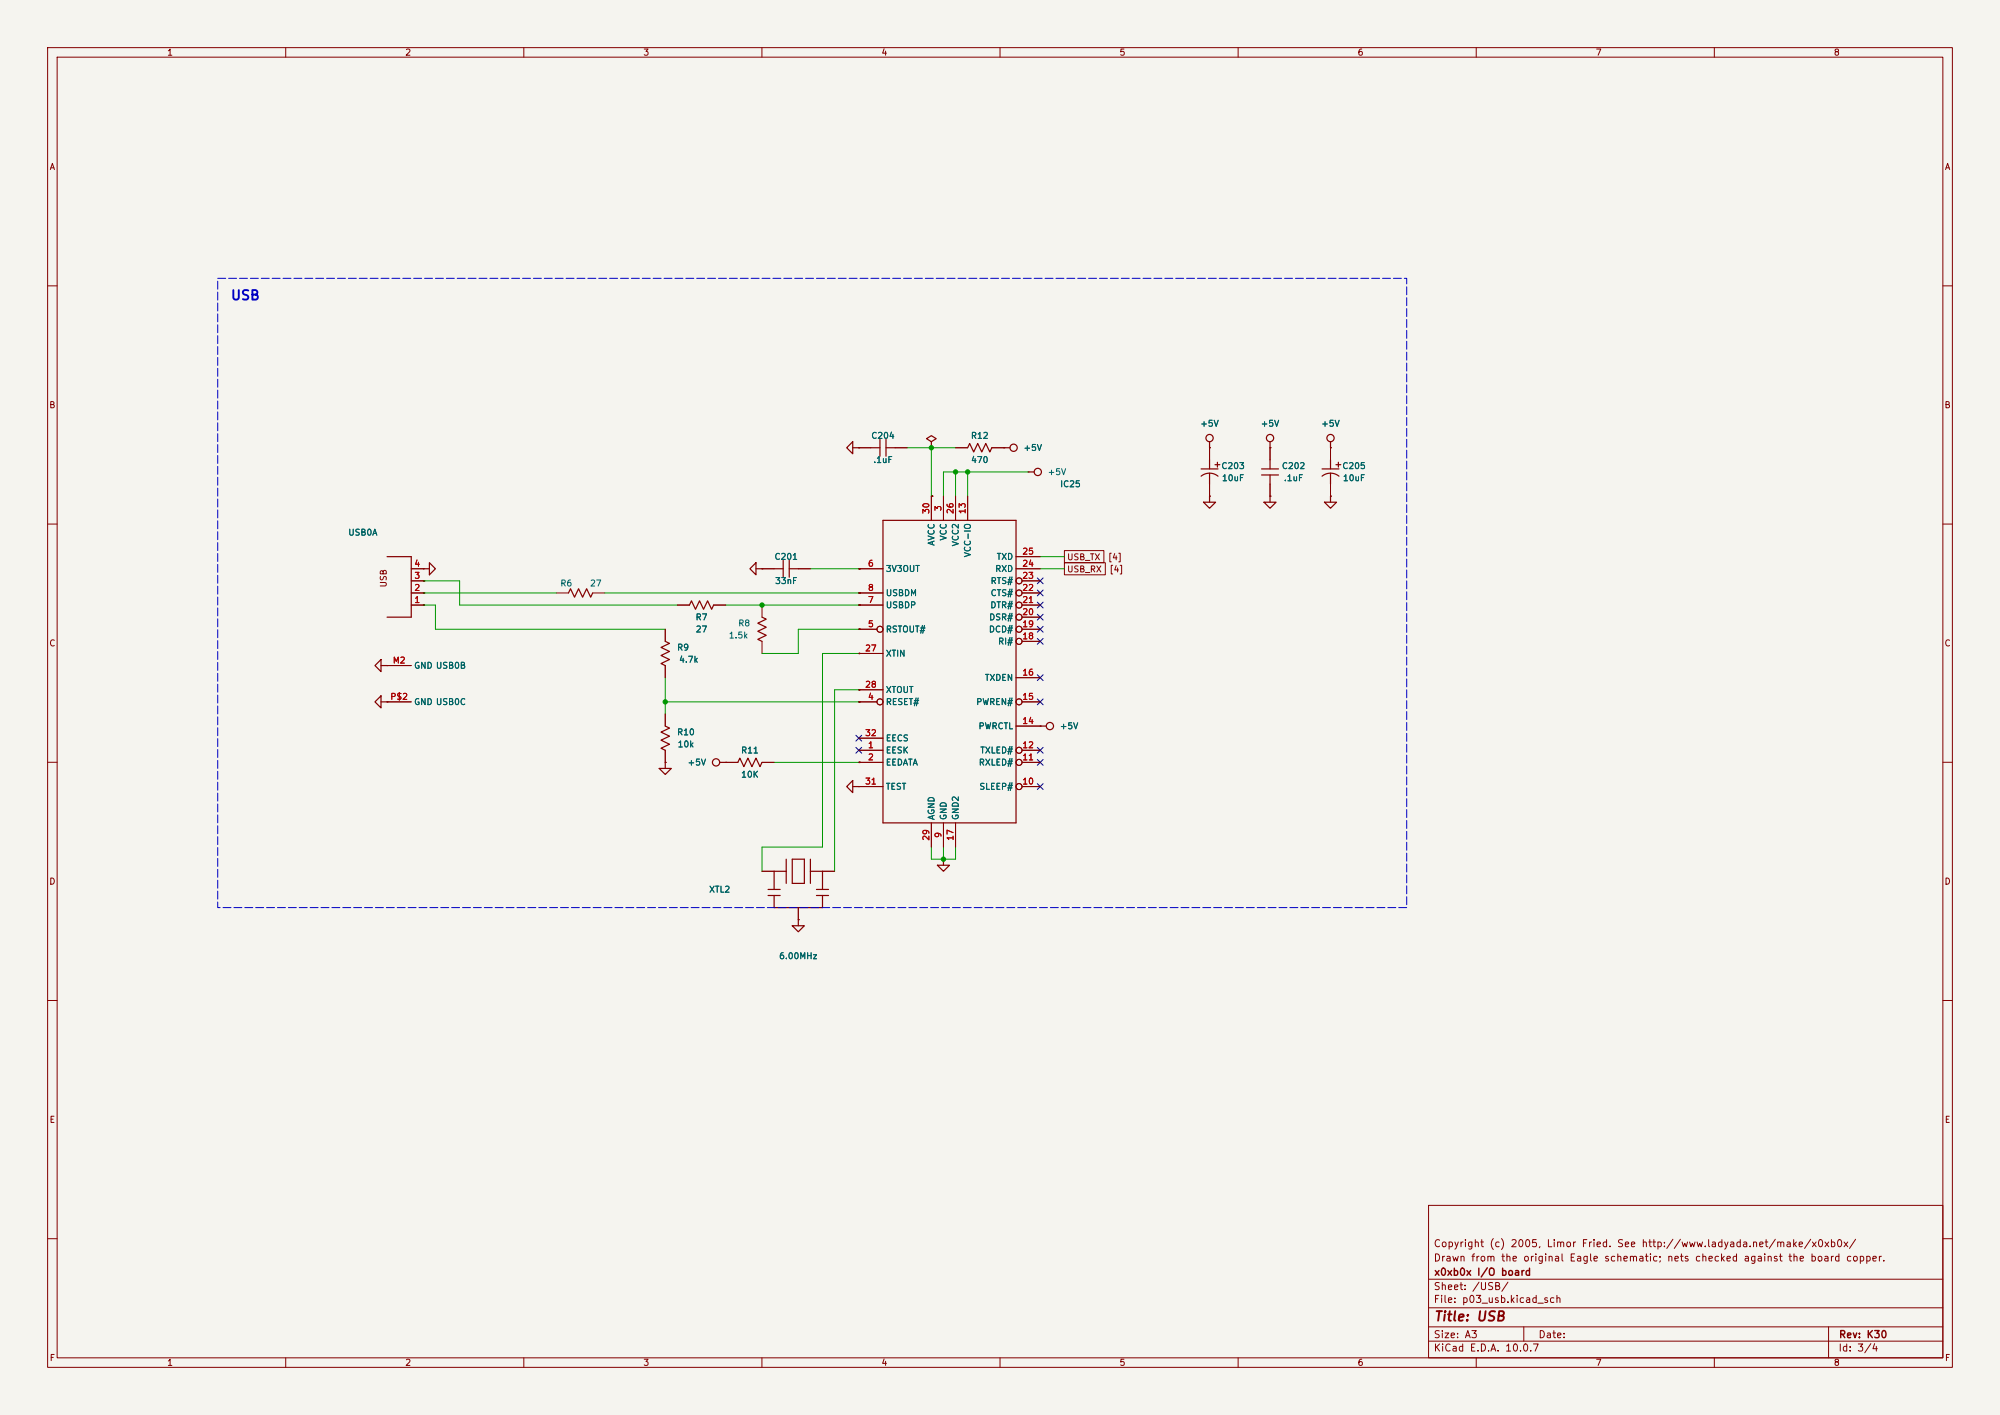
[picture p145: page 3]

Drawn from the original Eagle schematic; nets checked against the board copper.
x0xb0x I/O board
Sheet: /USB/
File: p03_usb.kicad_sch
Title: USB

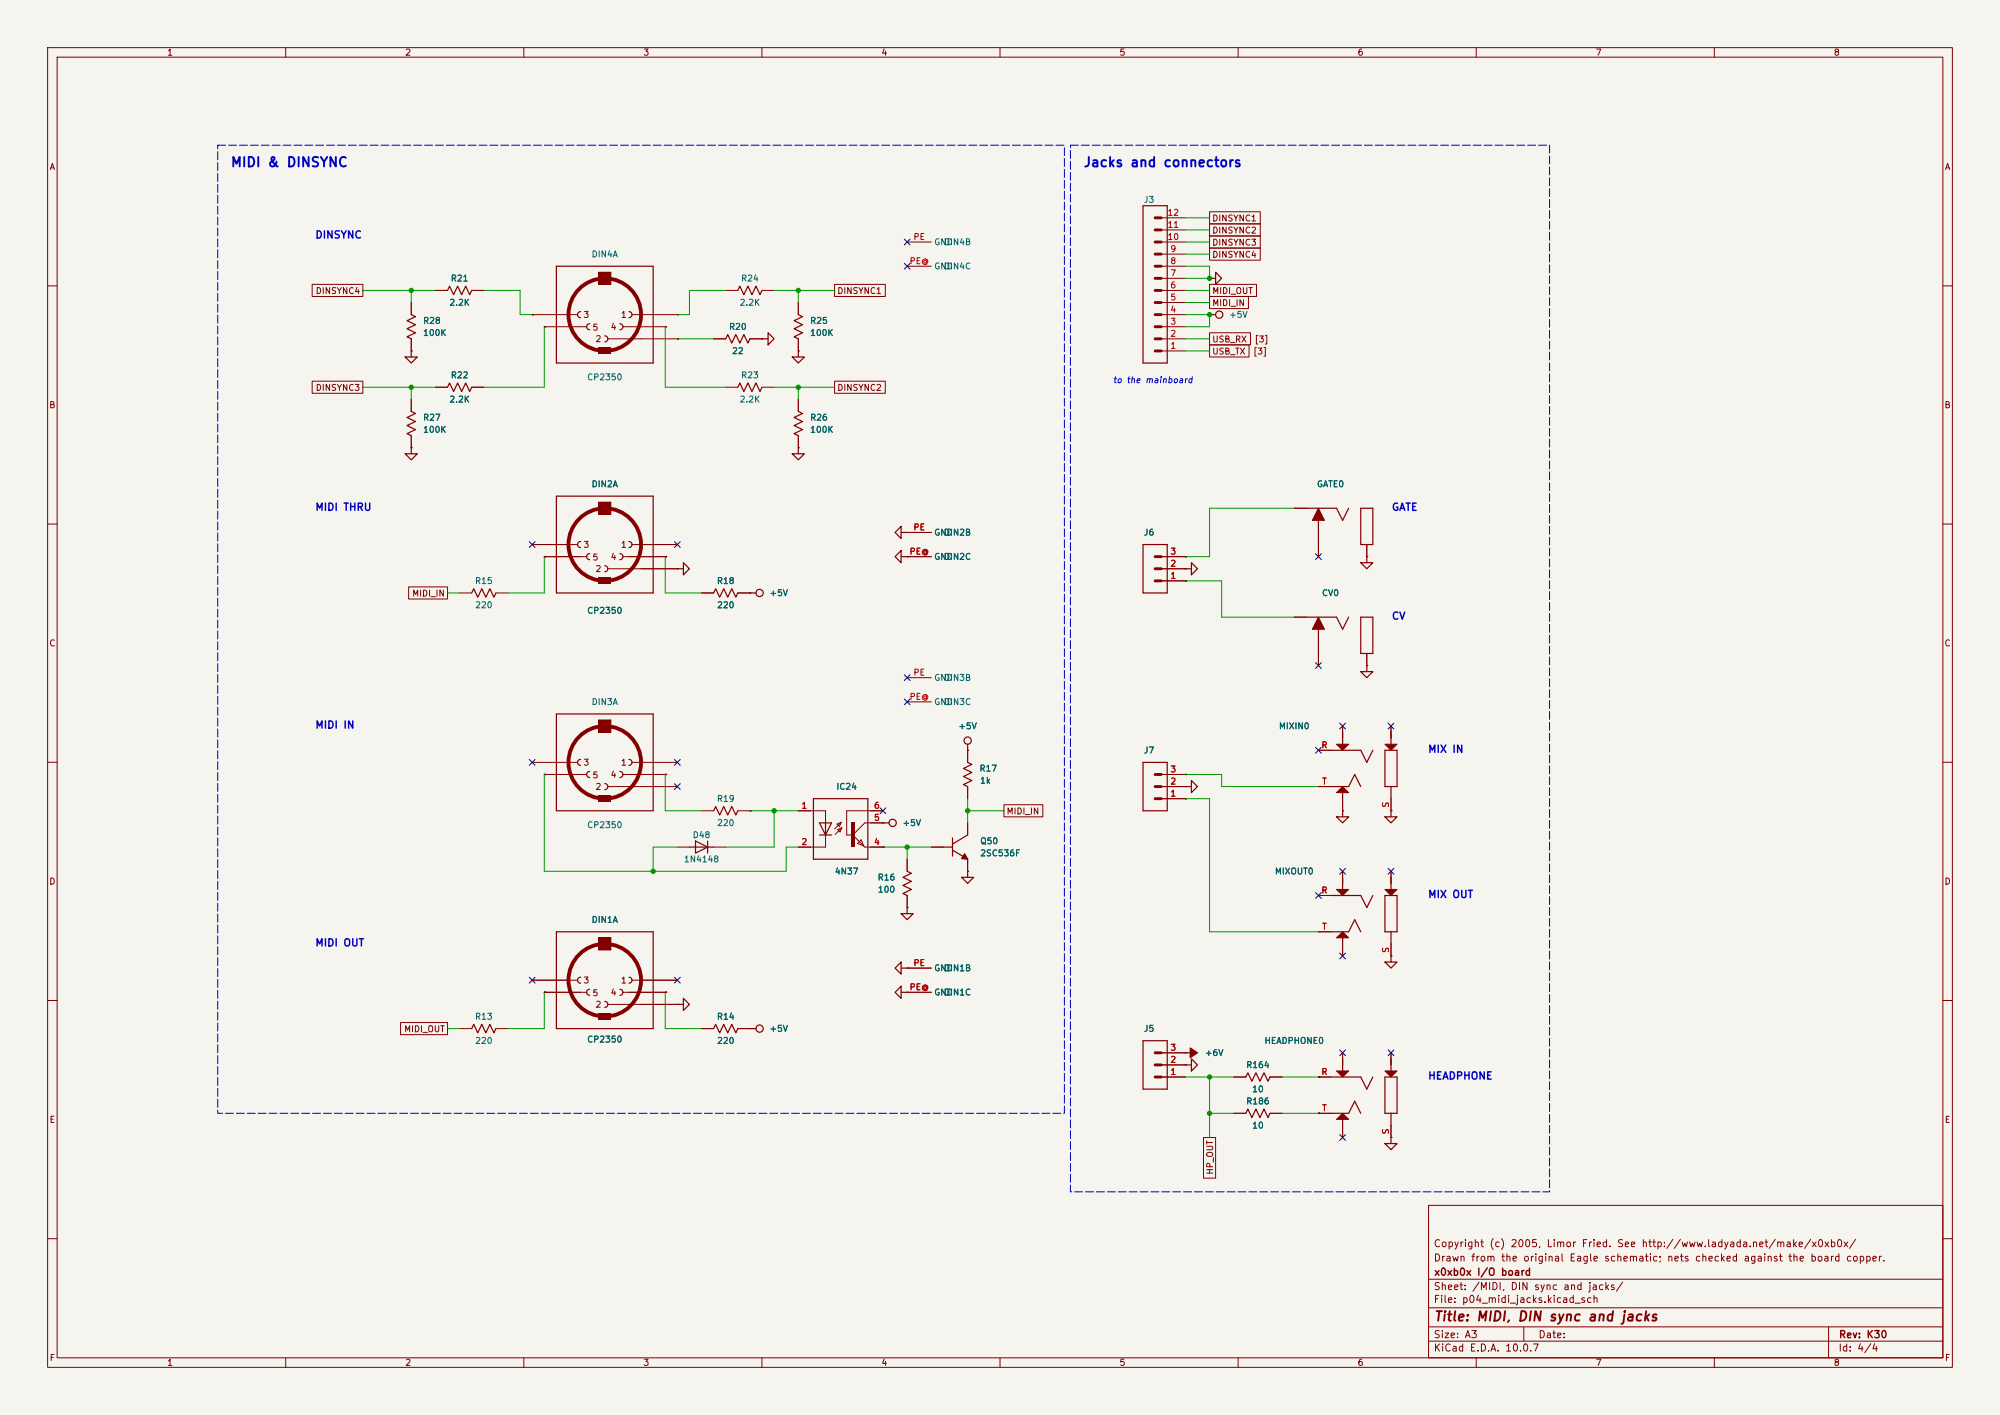
[picture p146: page 4]

Copyright (c) 2005, Limor Fried. See http://www.ladyada.net/make/x0xb0x/
Drawn from the original Eagle schematic; nets checked against the board copper.
x0xb0x I/O board
Sheet: /MIDI, DIN sync and jacks/
File: p04_midi_jacks.kicad_sch
Title: MIDI, DIN sync and jacks
