cozycactus/x0xb0x-hardware/kicad-working/schematic-redraw/mainboard-schematic.pdf

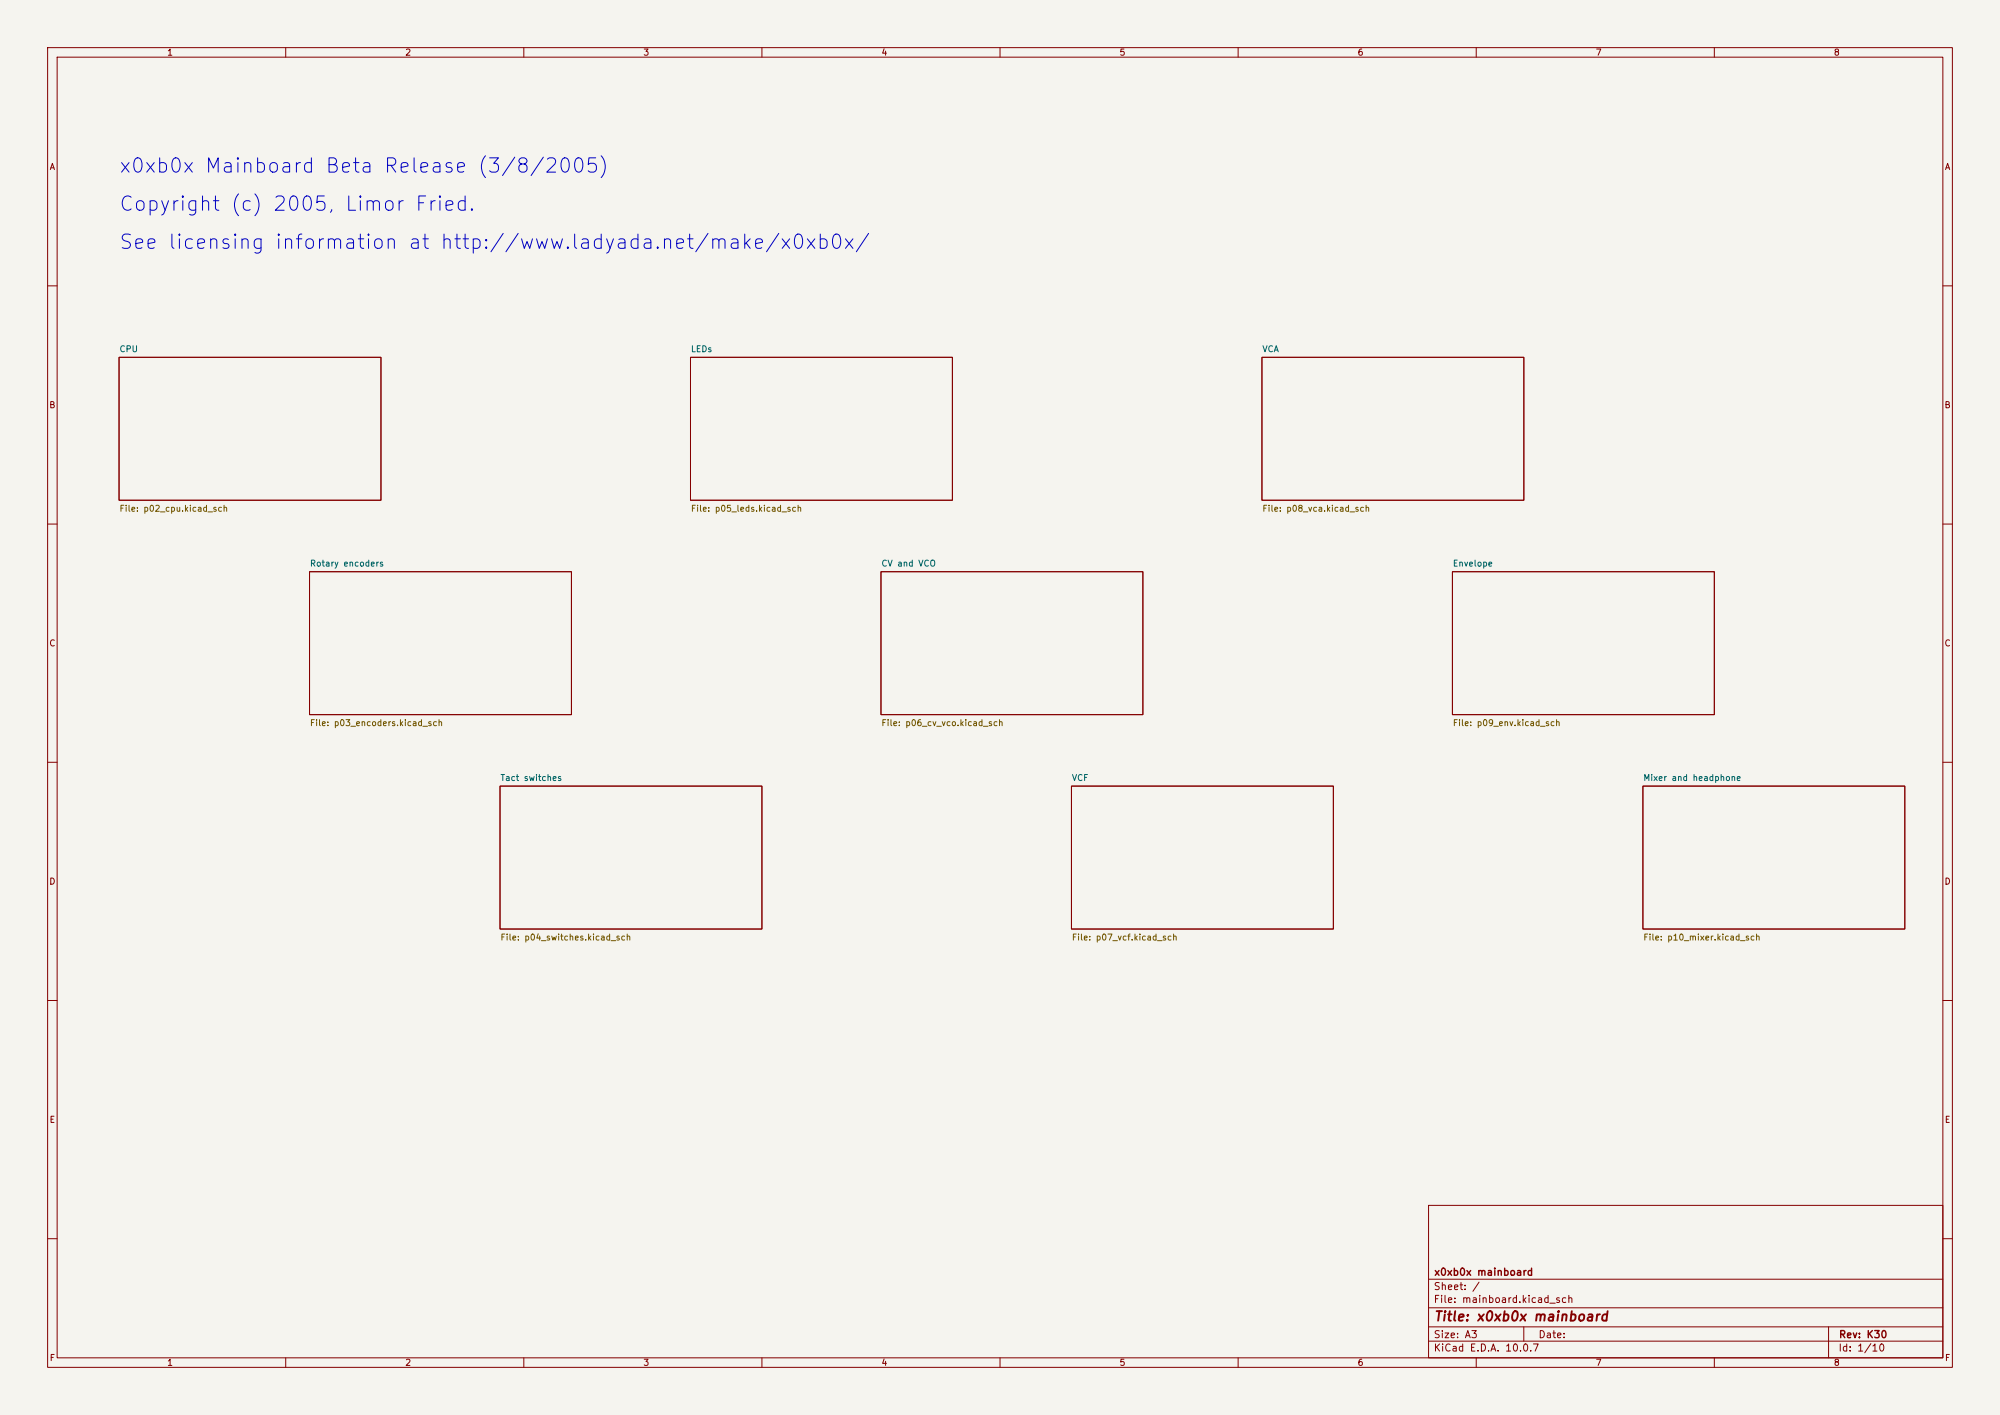
[picture p147: page 1]

x0xb0x Mainboard Beta Release (3/8/2005)
Copyright (c) 2005, Limor Fried.
See licensing information at http://www.ladyada.net/make/x0xb0x/

Size: A3 | Rev: K30 | F Date:
KiCad E.D.A. 10.0.7 | Id: 1/10

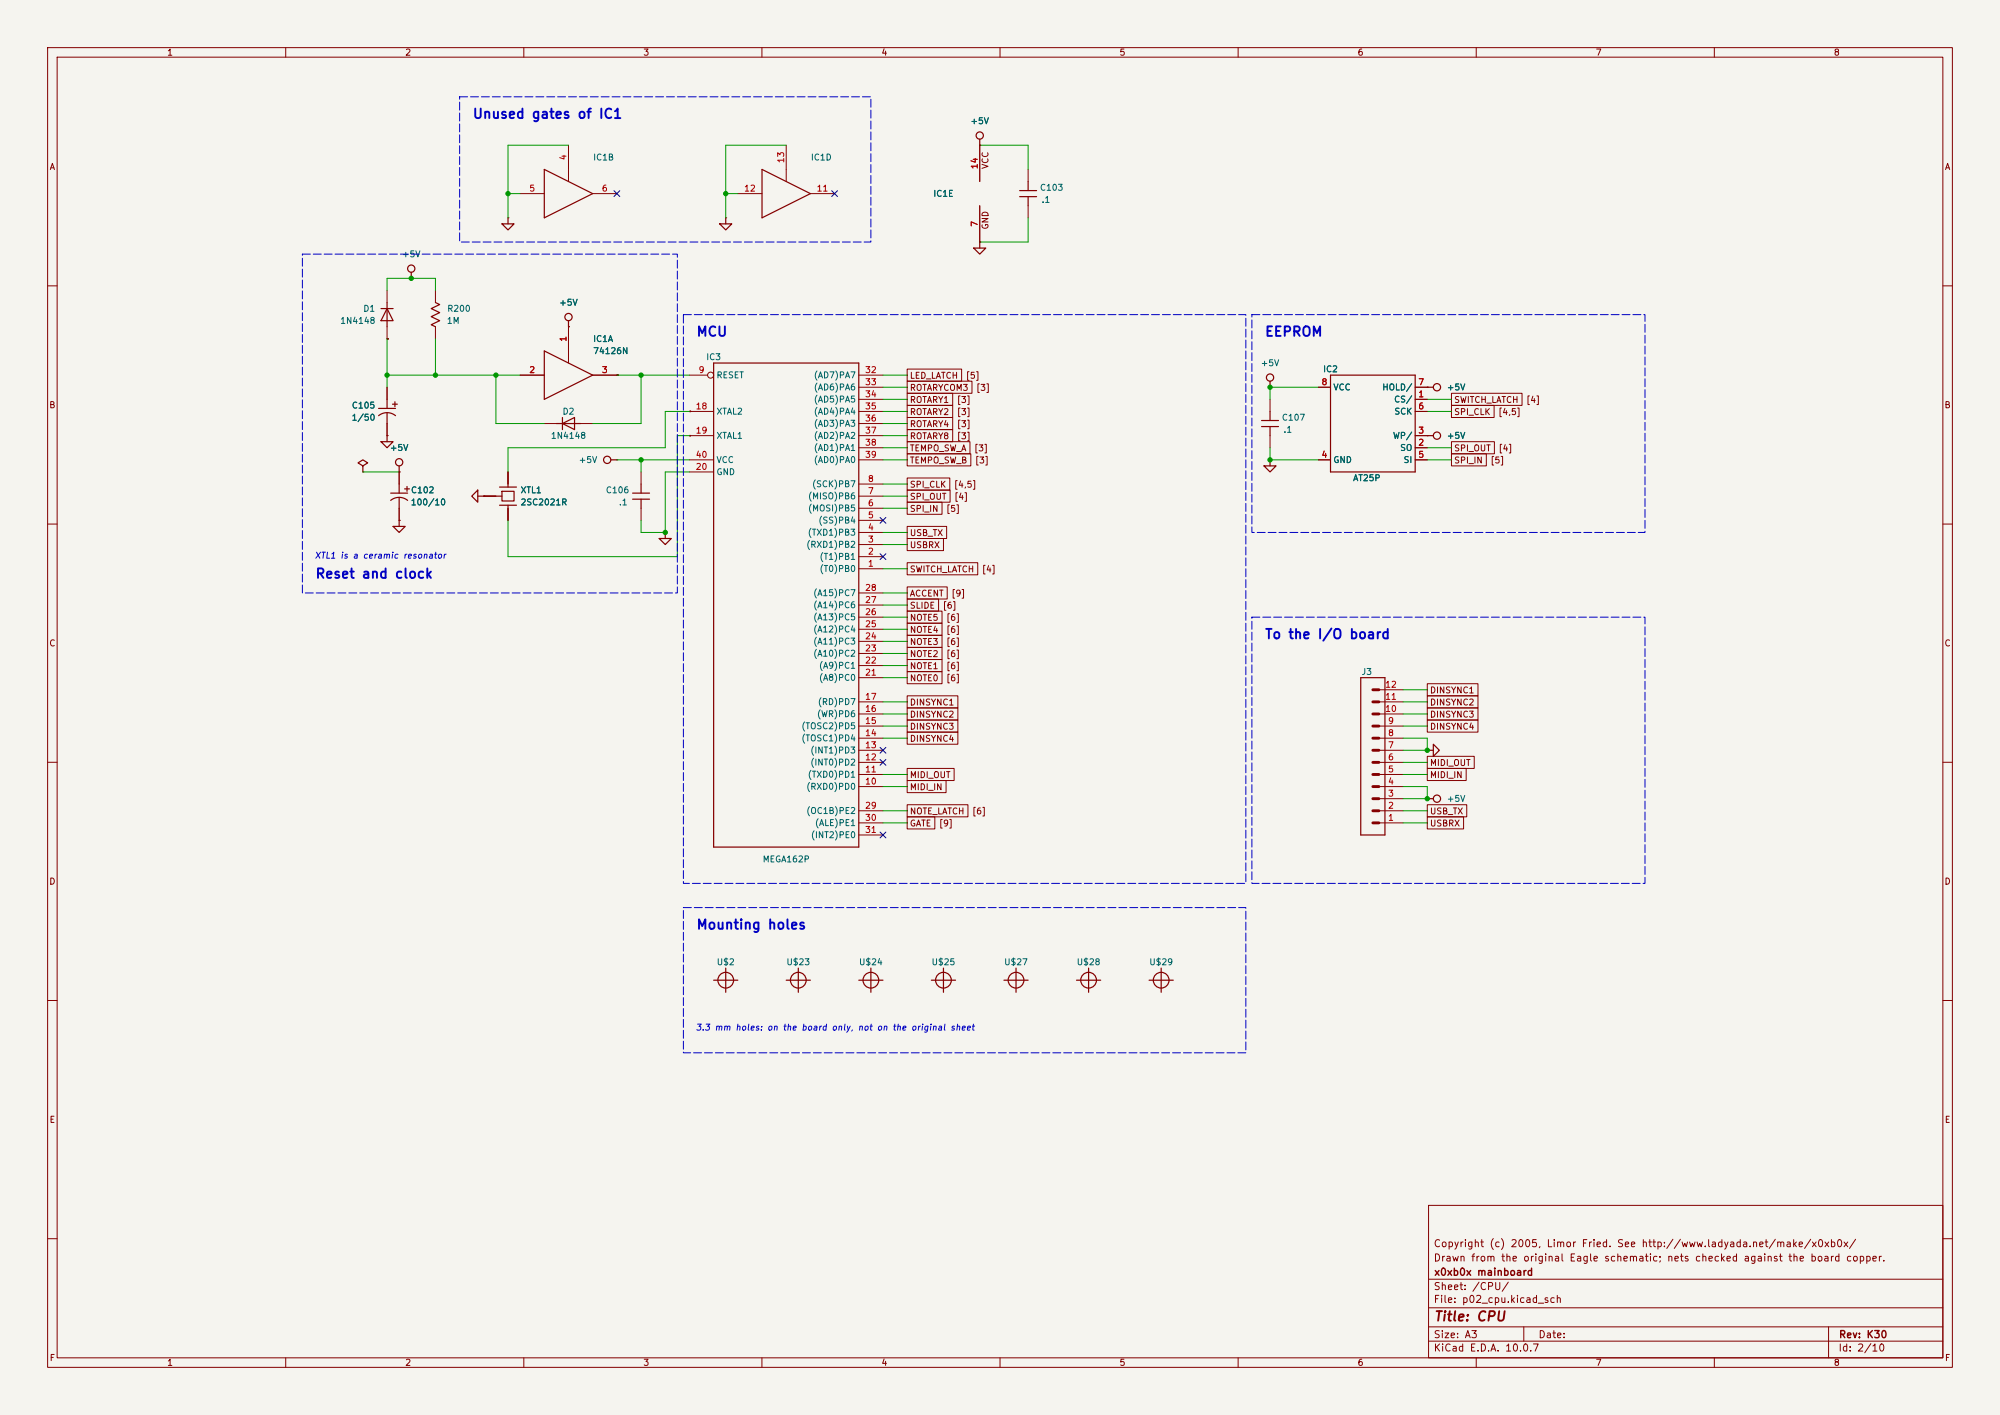
[picture p148: page 2]

XTL1 is a ceramic resonator Reset and clock

Copyright (c) 2005, Limor Fried. See http://www.ladyada.net/make/x0xb0x/
Drawn from the original Eagle schematic; nets checked against the board copper.
x0xb0x mainboard
Sheet: /CPU/
File: p02_cpu.kicad_sch
Title: CPU

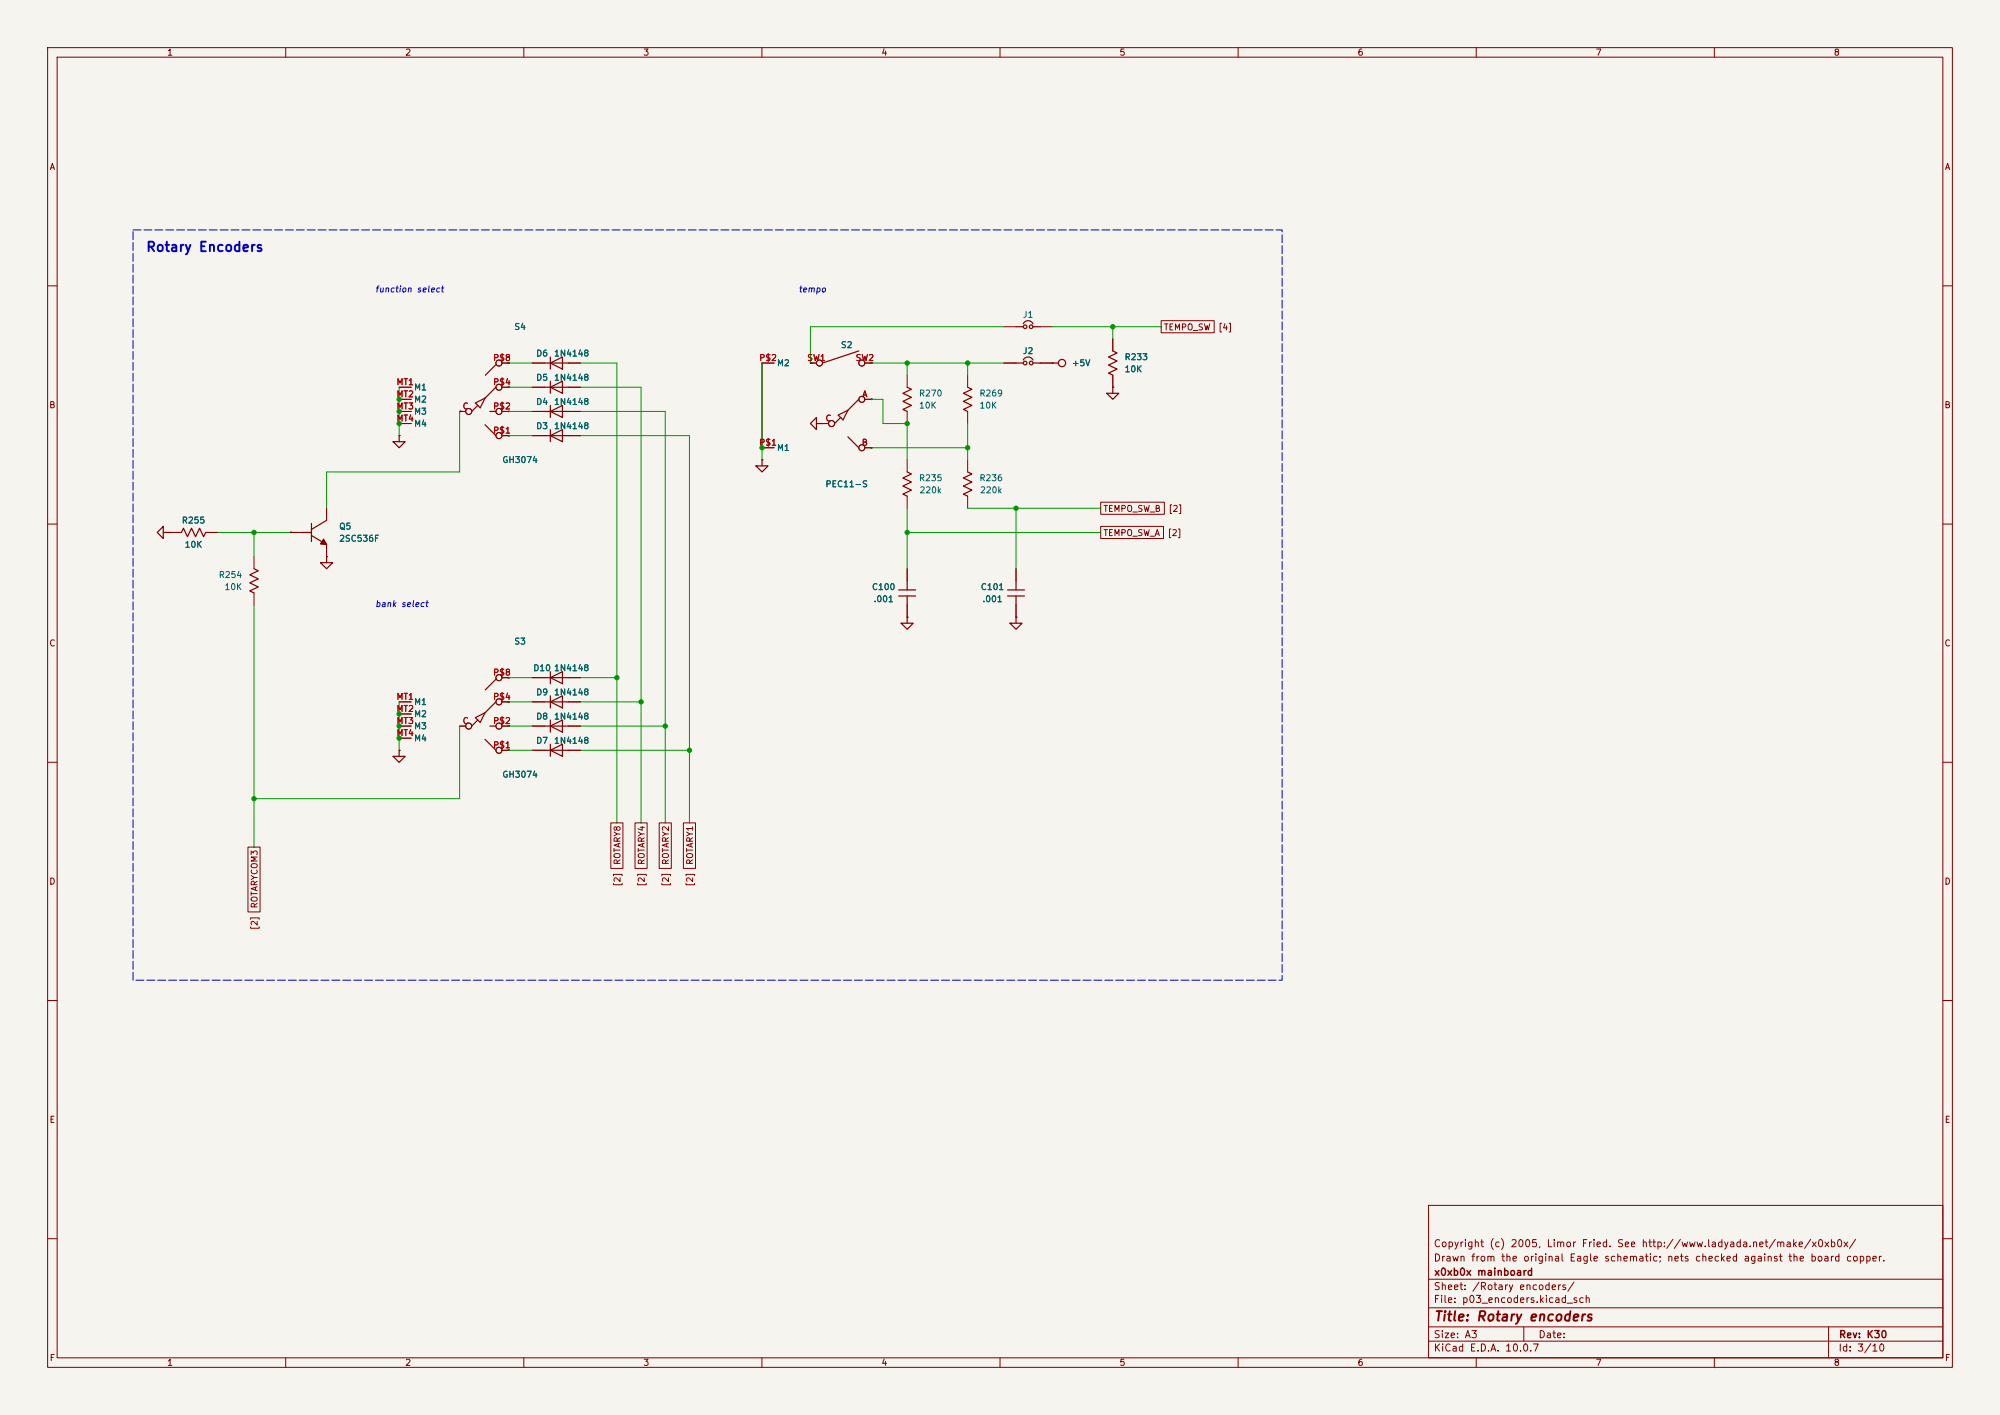
[picture p149: page 3]

function select Rotary Encoders

Copyright (c) 2005, Limor Fried. See http://www.ladyada.net/make/x0xb0x/
Drawn from the original Eagle schematic; nets checked against the board copper.
x0xb0x mainboard
Sheet: /Rotary encoders/
File: p03_encoders.kicad_sch
Title: Rotary encoders

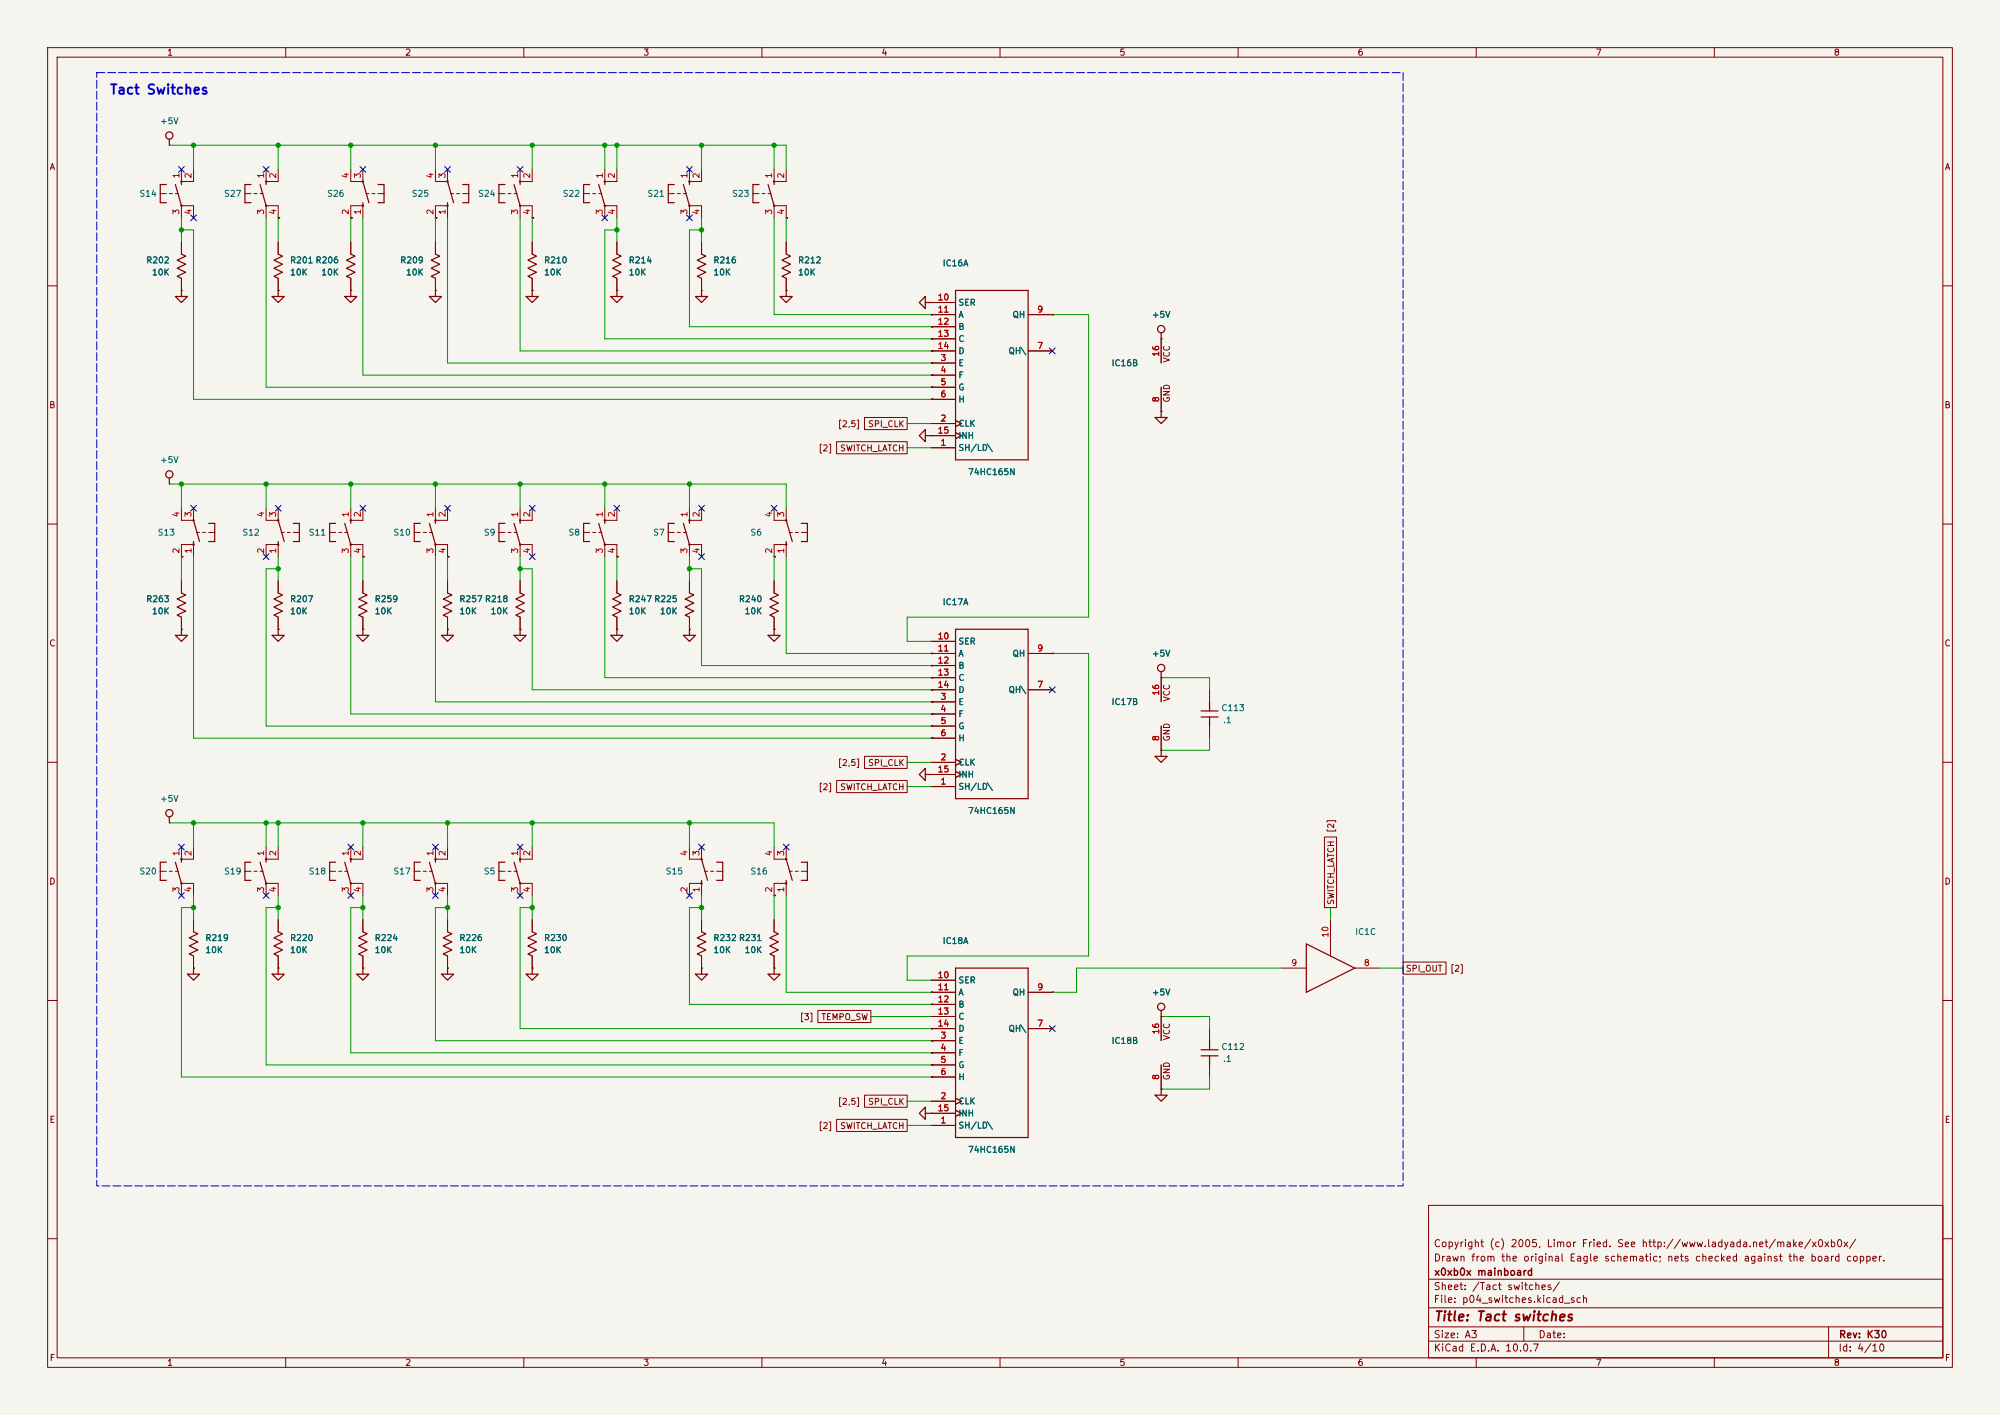
[picture p150: page 4]

Copyright (c) 2005, Limor Fried. See http://www.ladyada.net/make/x0xb0x/
Drawn from the original Eagle schematic; nets checked against the board copper.
x0xb0x mainboard
Sheet: /Tact switches/
File: p04_switches.kicad_sch
Title: Tact switches

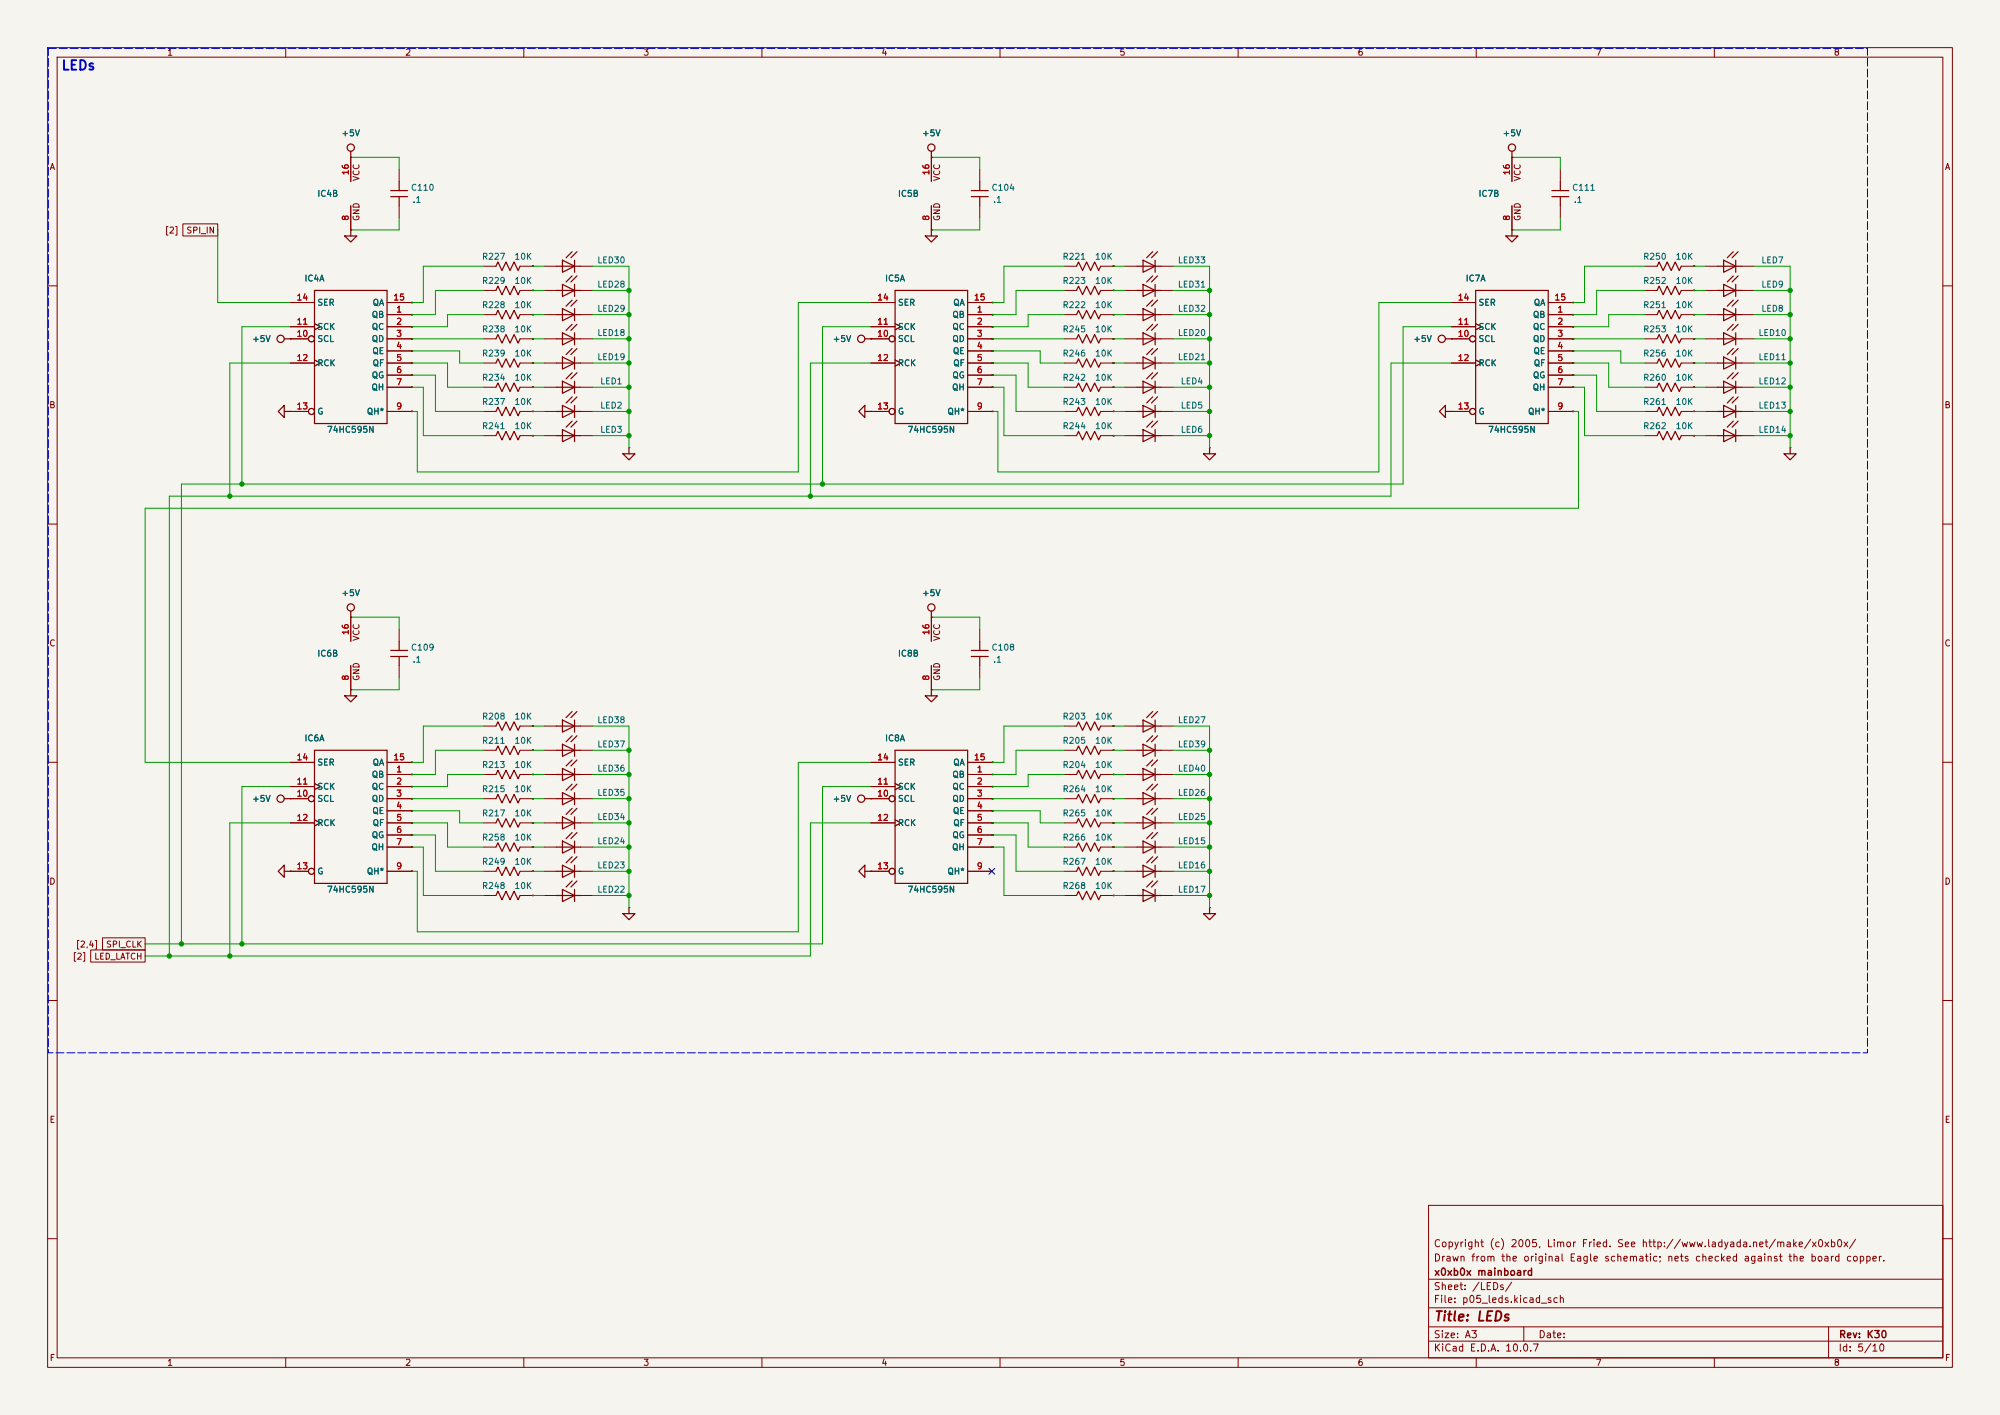
[picture p151: page 5]

Copyright (c) 2005, Limor Fried. See http://www.ladyada.net/make/x0xb0x/
Drawn from the original Eagle schematic; nets checked against the board copper.
x0xb0x mainboard
Sheet: /LEDs/
File: p05_leds.kicad_sch
Title: LEDs

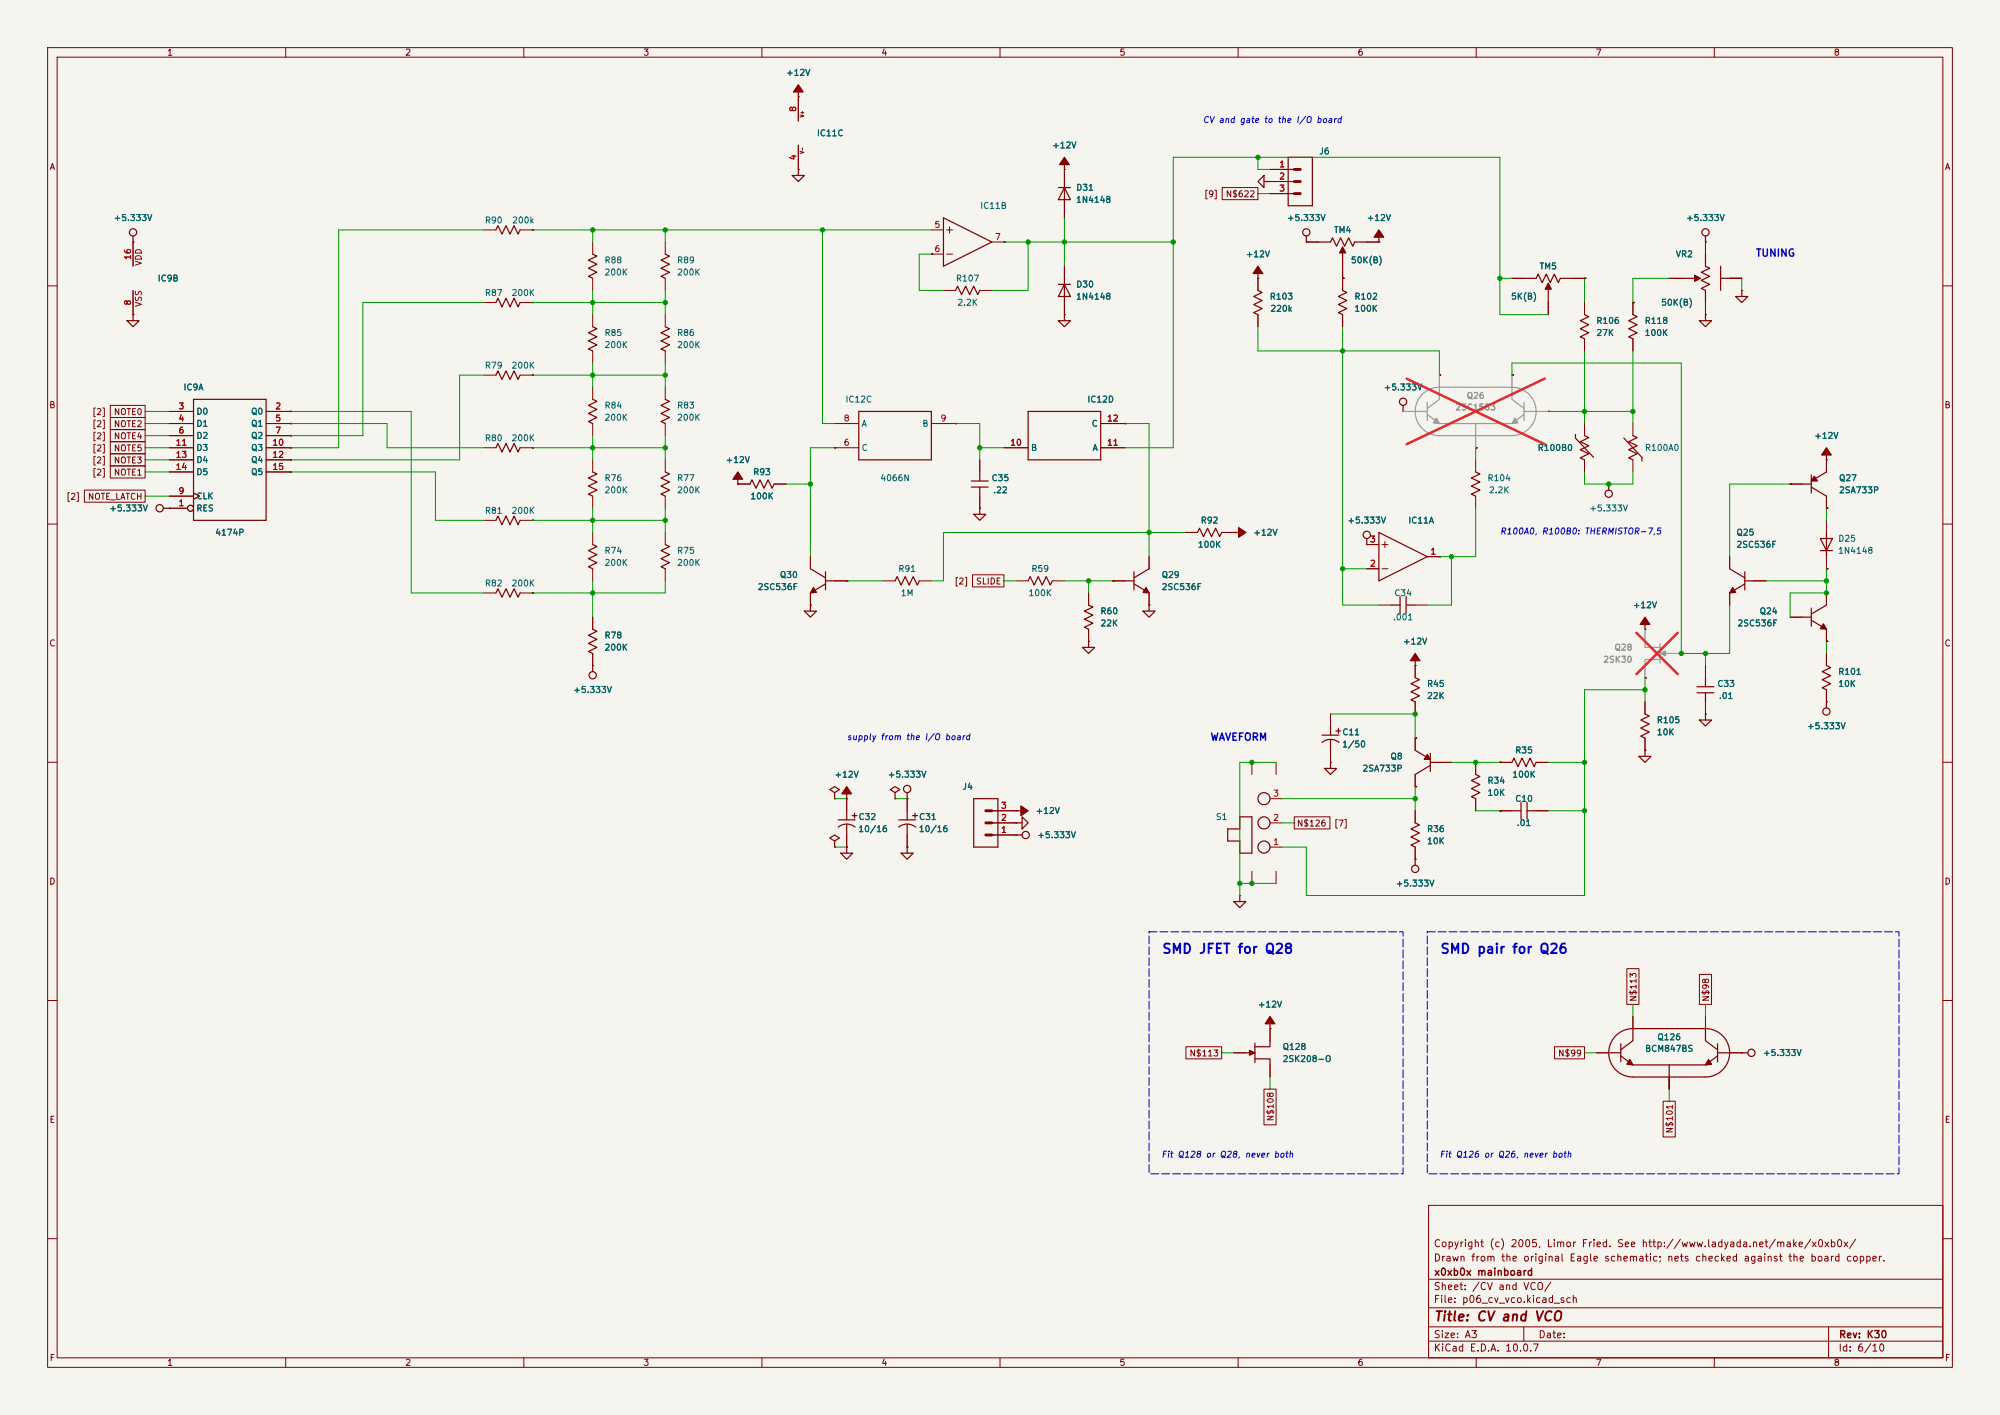
[picture p152: page 6]

Copyright (c) 2005, Limor Fried. See http://www.ladyada.net/make/x0xb0x/
Drawn from the original Eagle schematic; nets checked against the board copper.
x0xb0x mainboard
Sheet: /CV and VCO/
File: p06_cv_vco.kicad_sch
Title: CV and VCO

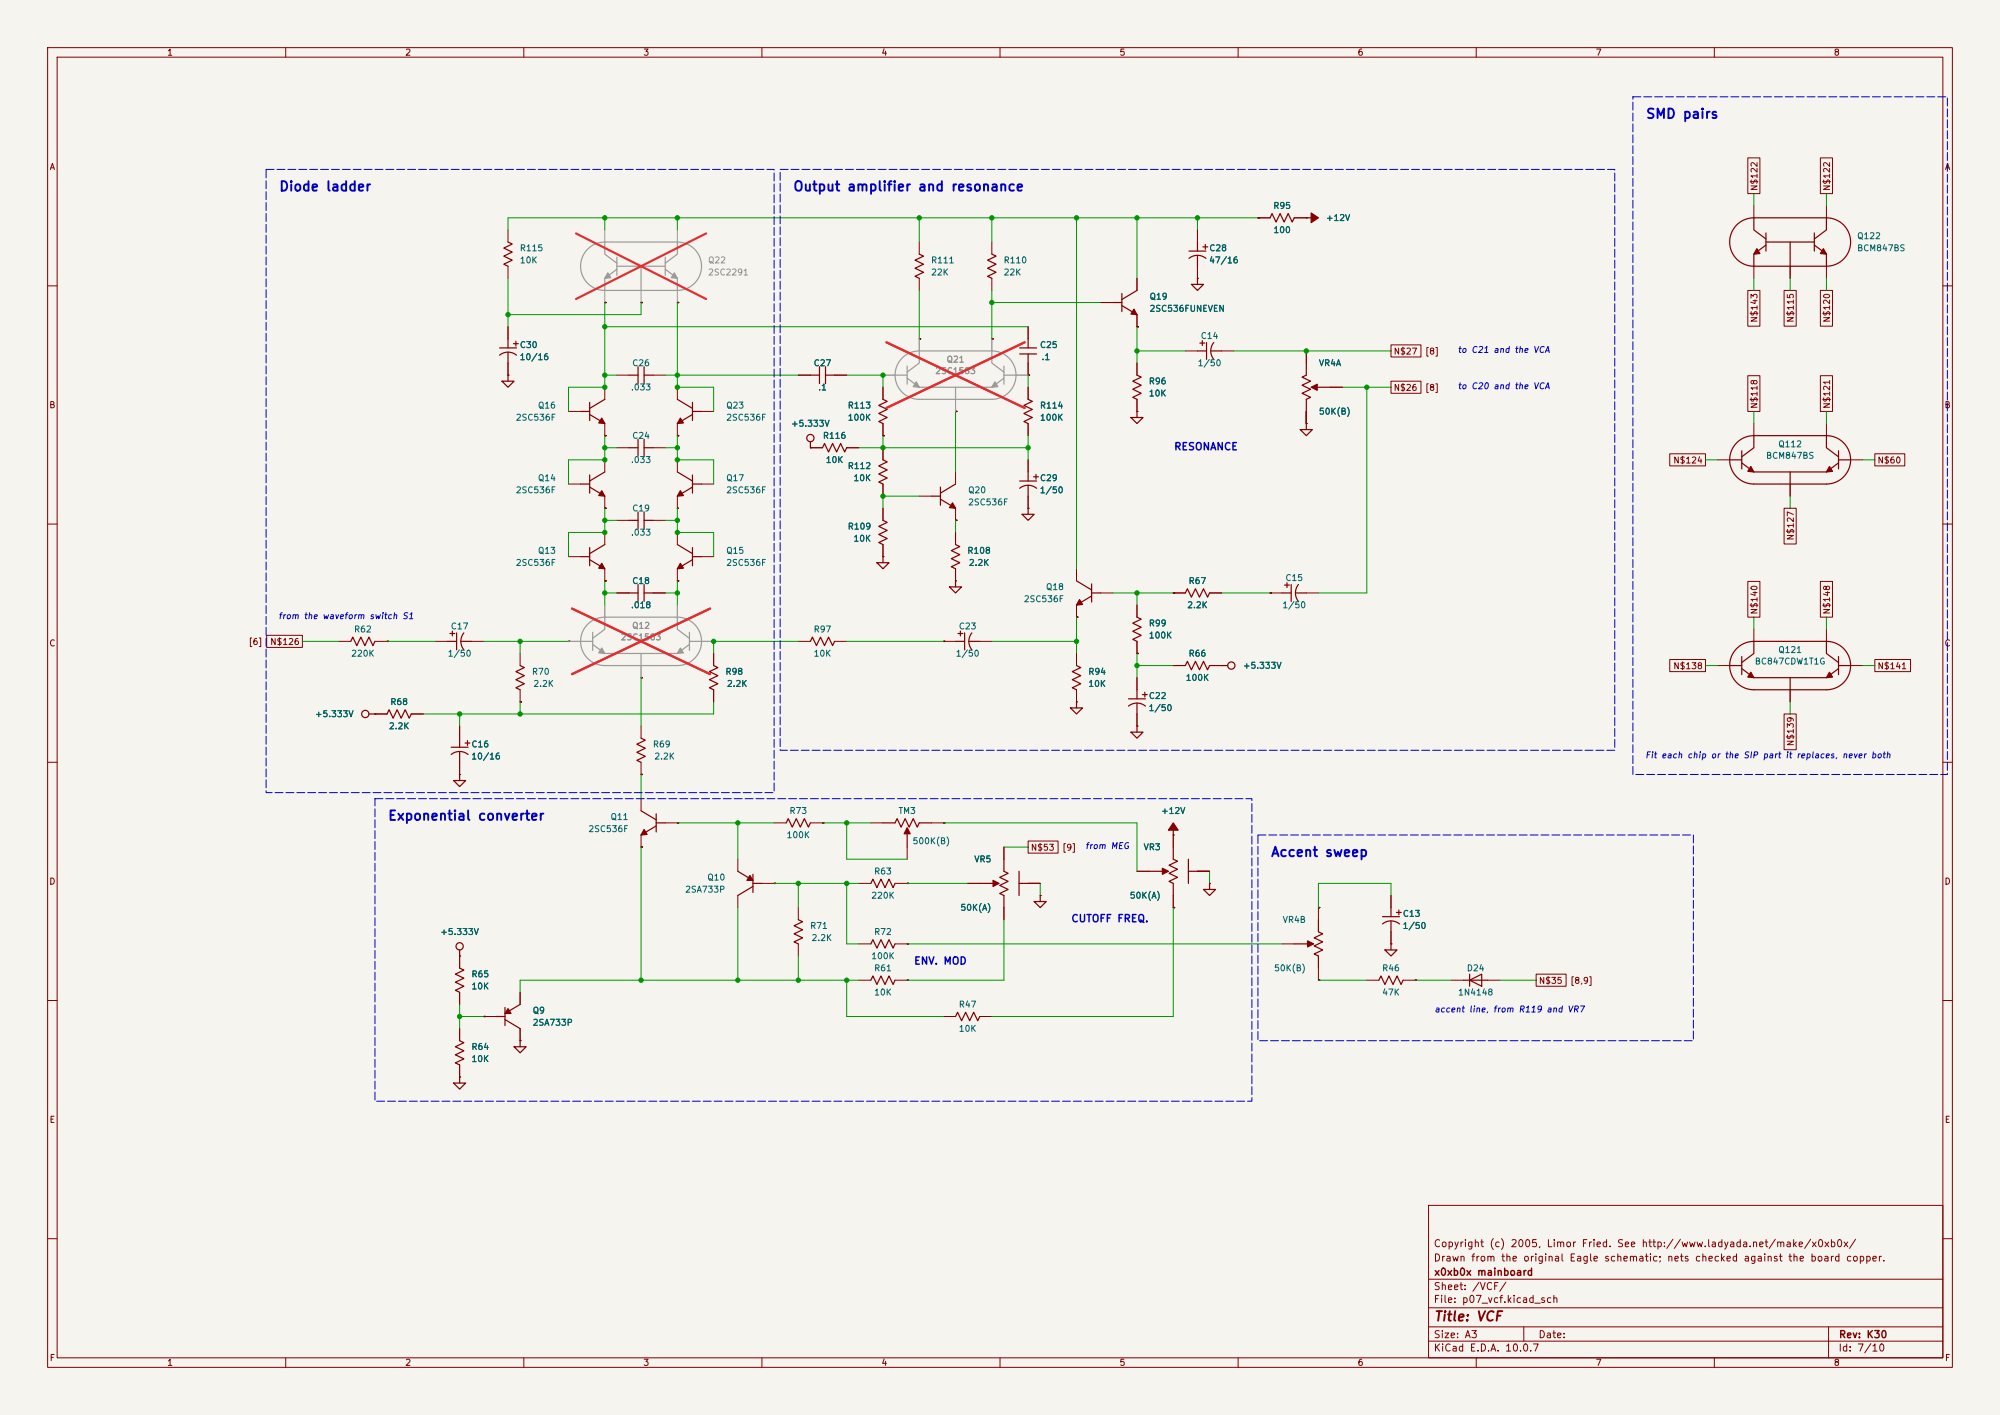
[picture p153: page 7]

Output amplifier and resonance | | R95

to C21 and the VCA

to C20 and the VCA

Fit each chip or the SIP part it replaces, never both Exponential converter

Copyright (c) 2005, Limor Fried. See http://www.ladyada.net/make/x0xb0x/
Drawn from the original Eagle schematic; nets checked against the board copper.
x0xb0x mainboard
Sheet: /VCF/
File: p07_vcf.kicad_sch
Title: VCF

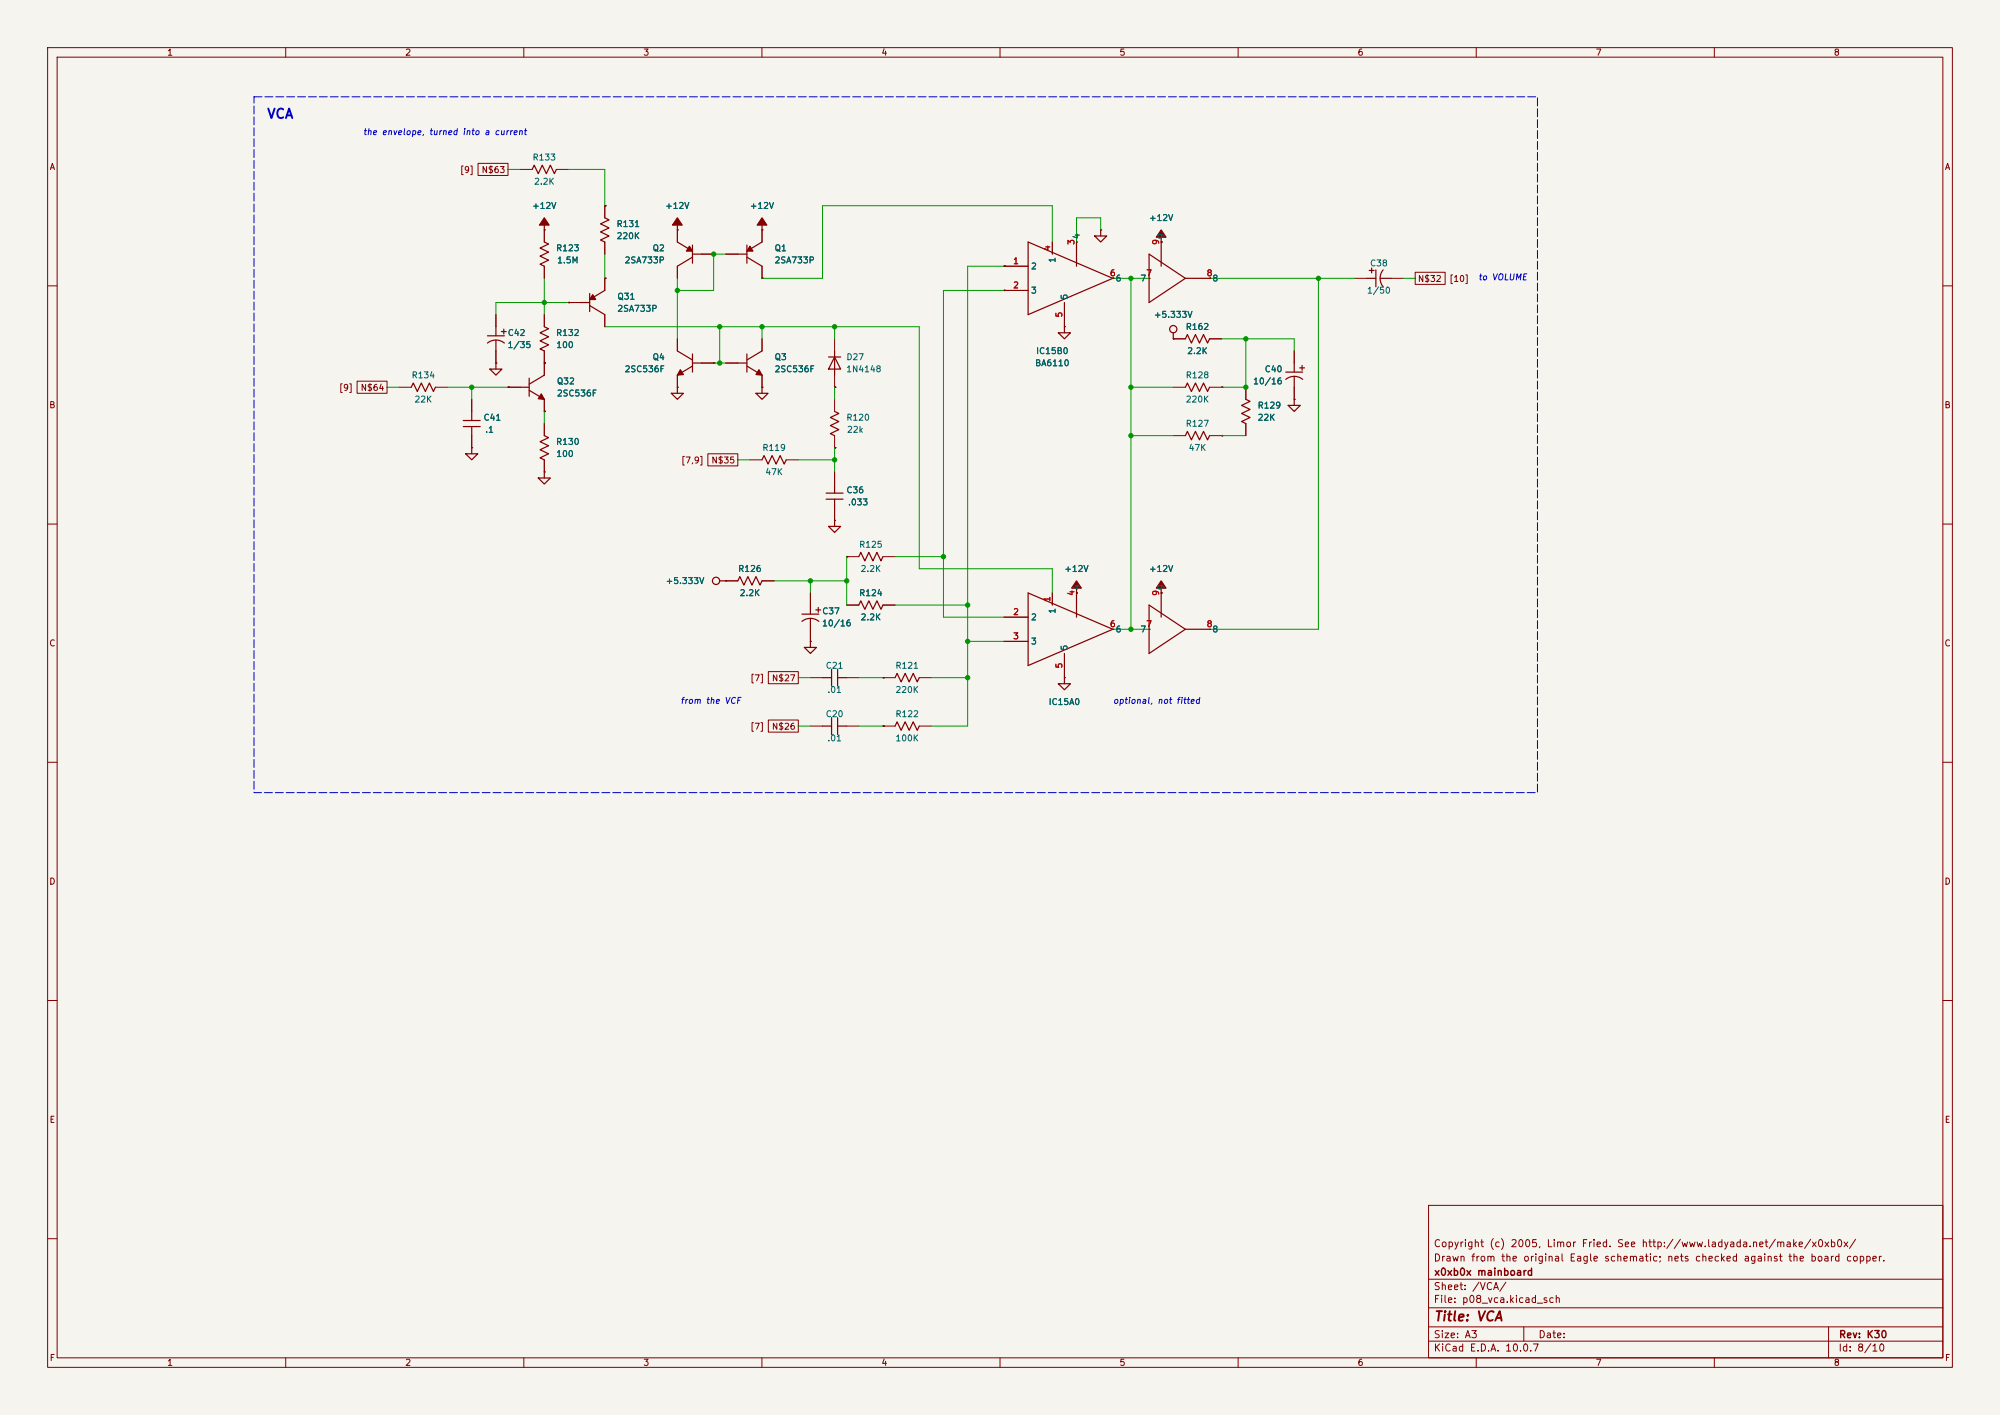
[picture p154: page 8]

the envelope, turned into a current VCA

Copyright (c) 2005, Limor Fried. See http://www.ladyada.net/make/x0xb0x/
Drawn from the original Eagle schematic; nets checked against the board copper.
x0xb0x mainboard
Sheet: /VCA/
File: p08_vca.kicad_sch
Title: VCA

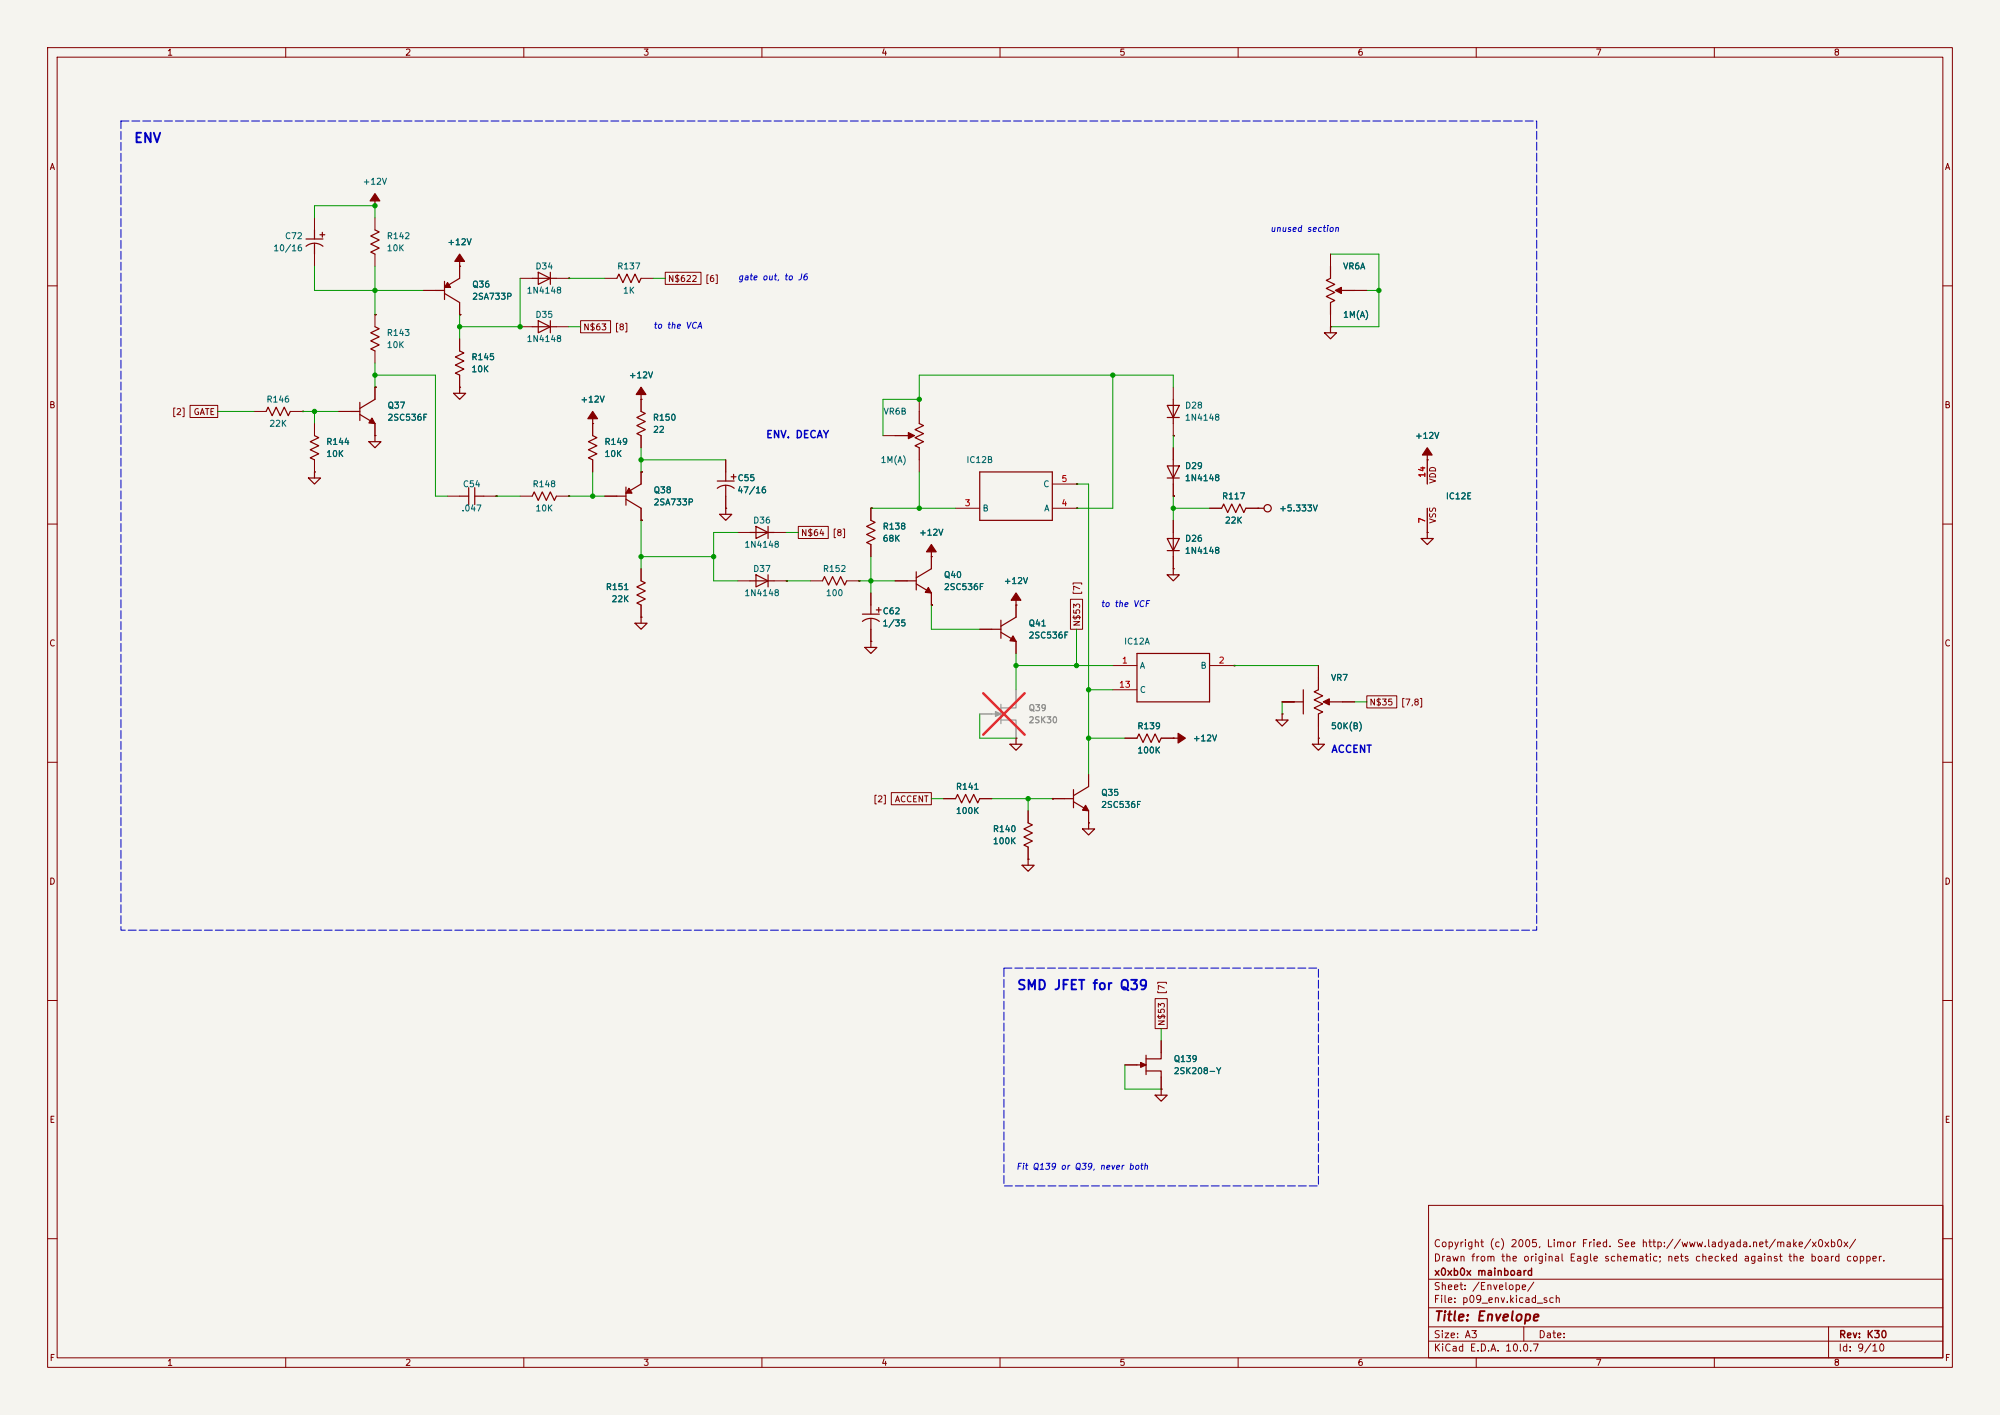
[picture p155: page 9]

Fit Q139 or Q39, never both

Copyright (c) 2005, Limor Fried. See http://www.ladyada.net/make/x0xb0x/
Drawn from the original Eagle schematic; nets checked against the board copper.
x0xb0x mainboard
Sheet: /Envelope/
File: p09_env.kicad_sch
Title: Envelope

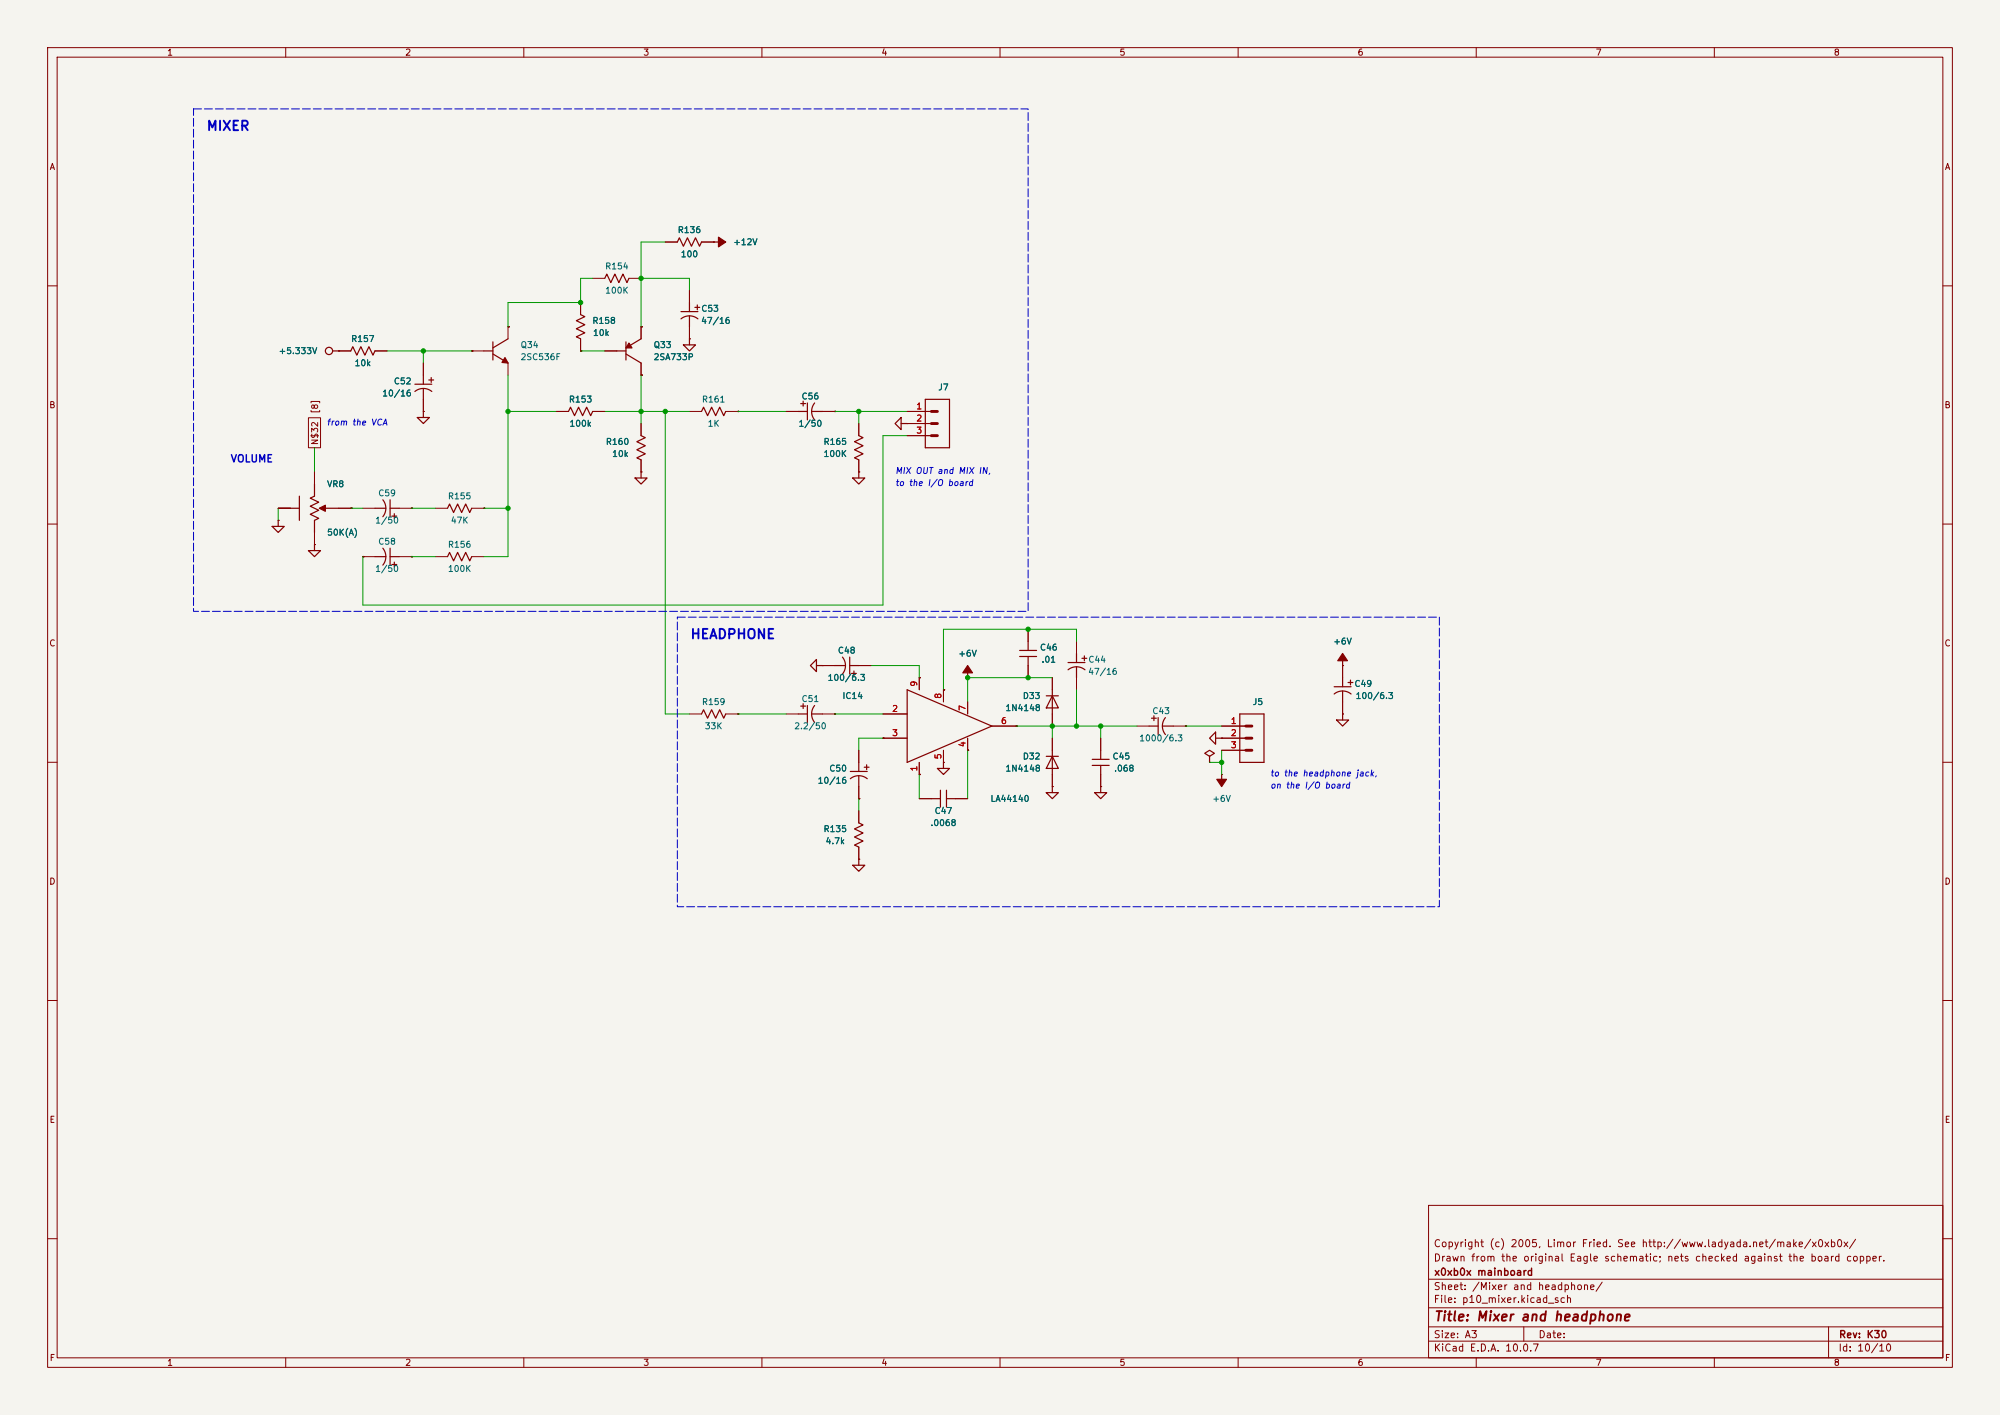
[picture p156: page 10]

to the headphone jack, on the I/O board MIXER

MIX OUT and MIX IN, to the I/O board

Copyright (c) 2005, Limor Fried. See http://www.ladyada.net/make/x0xb0x/
Drawn from the original Eagle schematic; nets checked against the board copper.
x0xb0x mainboard
Sheet: /Mixer and headphone/
File: p10_mixer.kicad_sch
Title: Mixer and headphone
