cozycactus/x0xb0x-hardware/(list of files, drawings)

Other design files:
docs/schematic-redraw.json
kicad-working/schematic-redraw/pcb-relink-record.json
