cozycactus/x0xb0x-hardware/kicad-working/mainboard/mainboard.kicad_pcb

## KiCad design kicad-working/mainboard/mainboard.kicad_pcb (2026-11-05)

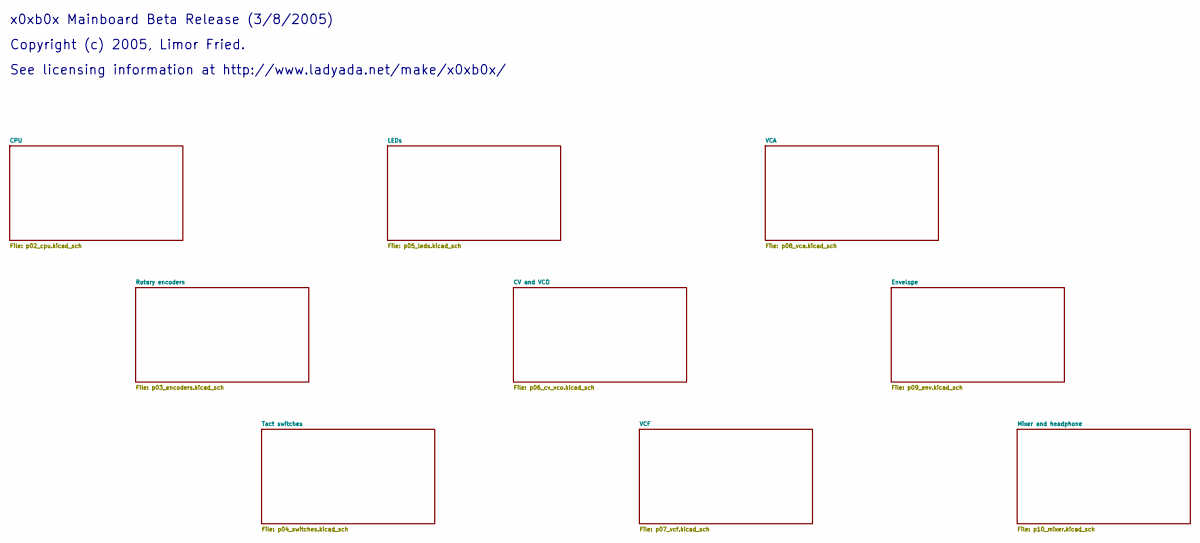
[picture p157: schematic mainboard.kicad_sch, x0xb0x mainboard]

Notes on the sheet:
x0xb0x Mainboard Beta Release (3/8/2005)
Copyright (c) 2005, Limor Fried.
See licensing information at http://www.ladyada.net/make/x0xb0x/

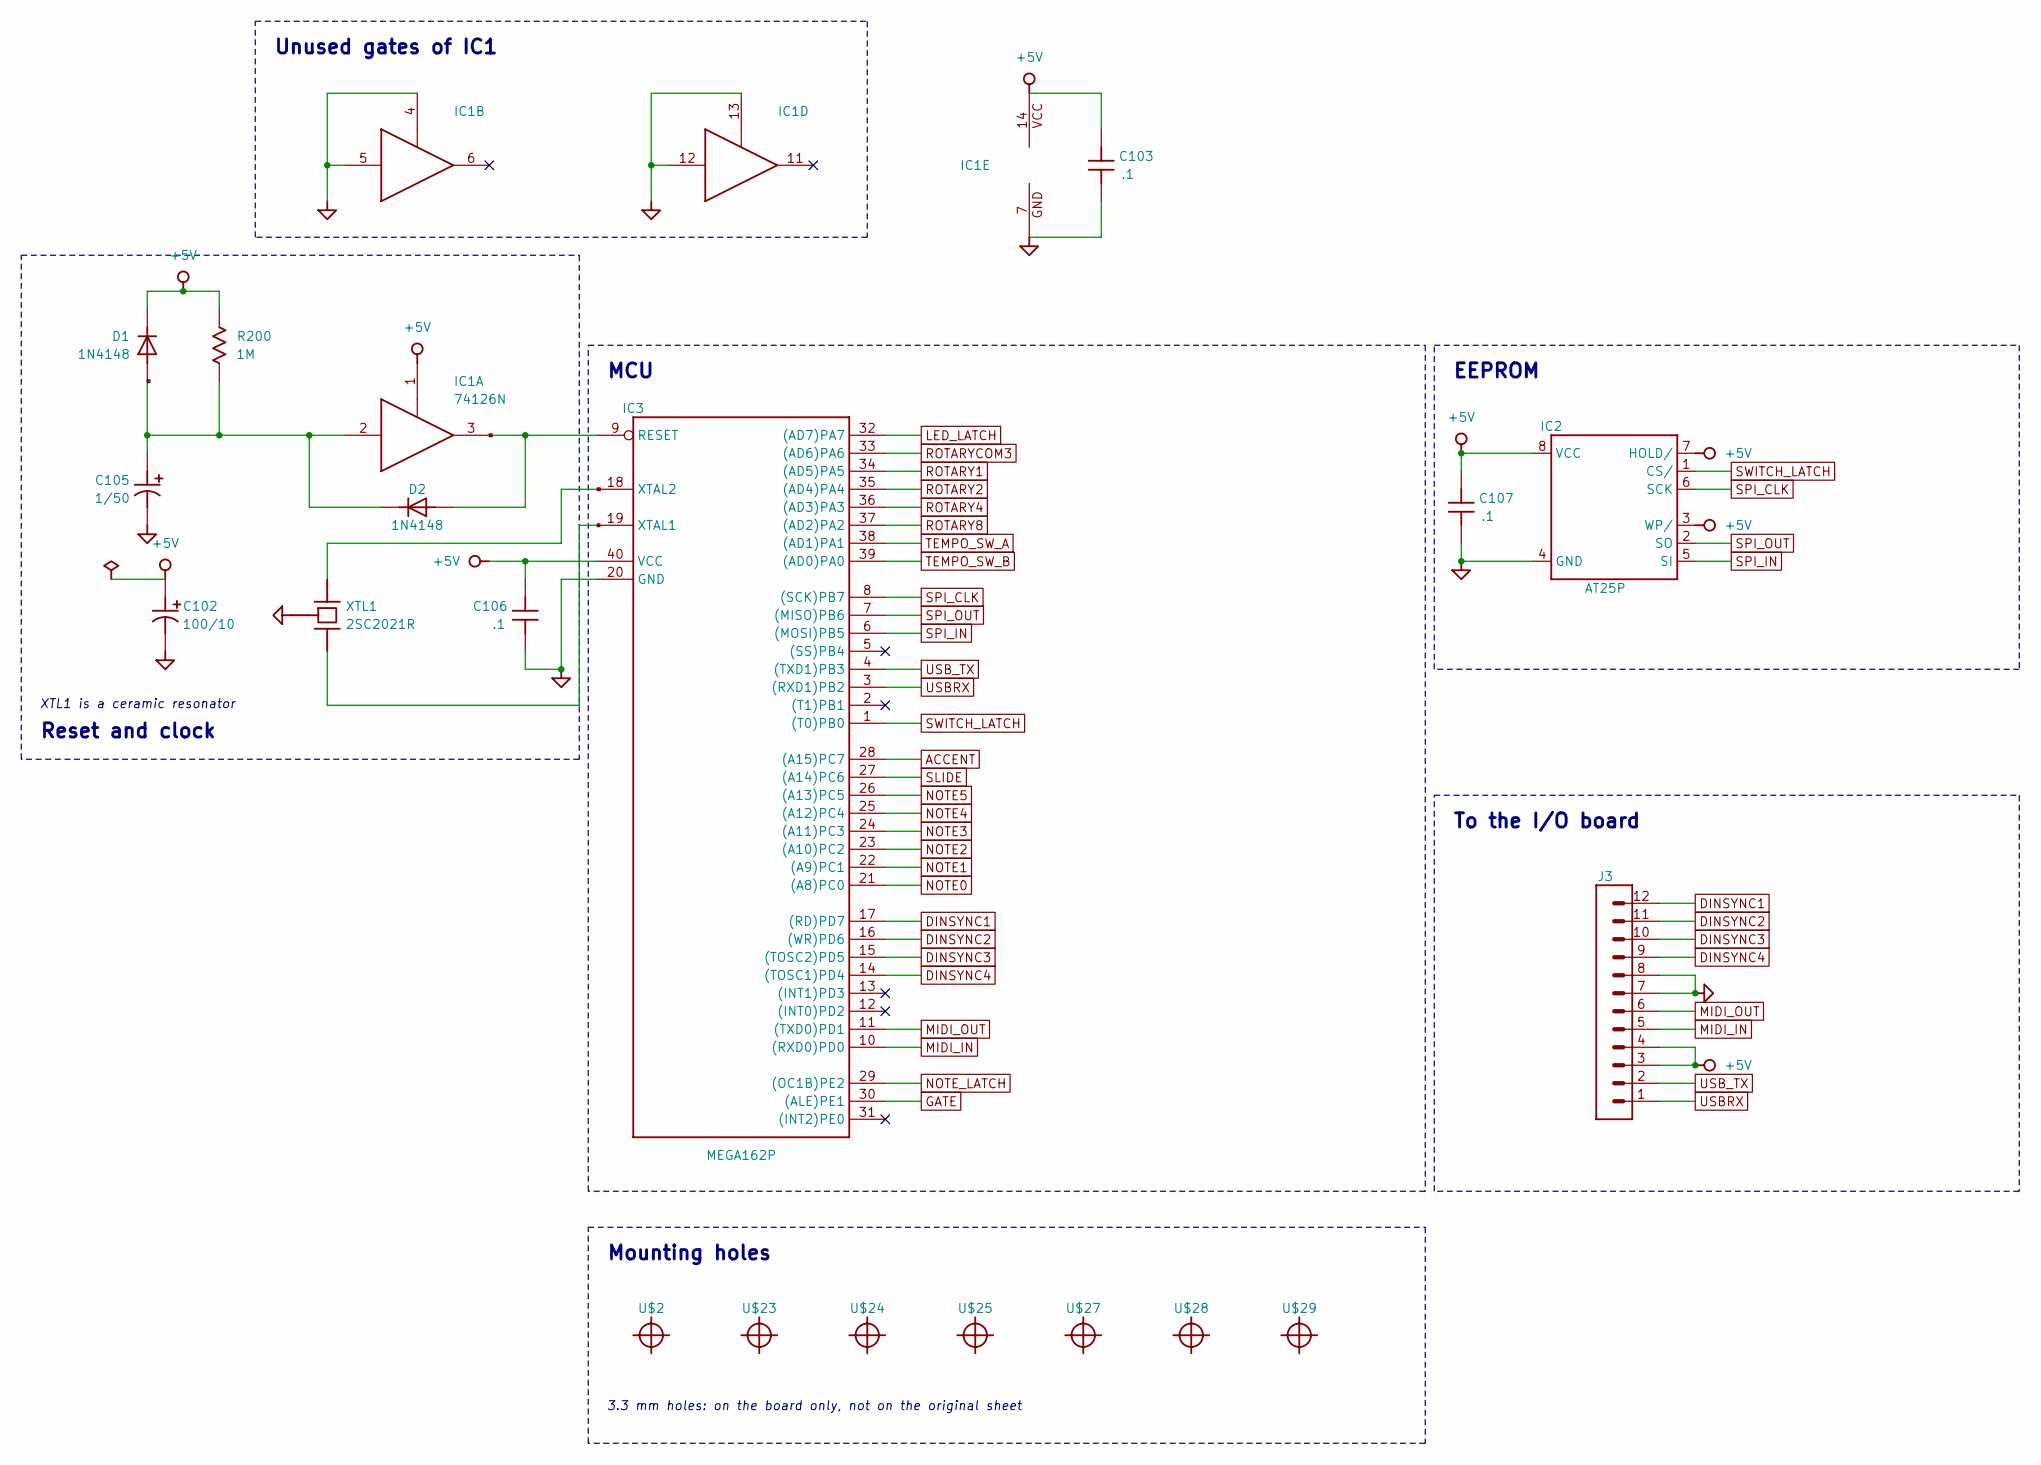
[picture p158: schematic p02_cpu.kicad_sch, CPU]

Parts:
C102: 100/10; E5-6
C103, C106, C107: .1; C050H075X075
C105: 1/50; E5-6
D1, D2: 1N4148; DO35-10
IC1: 74126N; DIL14
IC2: AT25P; DIL08_AT25
IC3: MEGA162P; DIL40
J3: MA12-''; MA12-1
R200: 1M; 0207_5V
U$2, U$23, U$24, U$25, U$27, U$28, U$29: 1,3
XTL1: 2SC2021R; 2SC2021

Connections:
+5V: C102.+, C103.1, C106.2, C107.2, D1.C, IC1.1 (OE), IC1.14 (VCC), IC2.3 (WP/), IC2.7 (HOLD/), IC2.8 (VCC), IC3.40 (VCC), J3.3, J3.4, R200.1; also elsewhere on the board
ACCENT: IC3.28 ((A15)PC7); also elsewhere on the board
DINSYNC1: IC3.17 ((RD)PD7), J3.12
DINSYNC2: IC3.16 ((WR)PD6), J3.11
DINSYNC3: IC3.15 ((TOSC2)PD5), J3.10
DINSYNC4: IC3.14 ((TOSC1)PD4), J3.9
GATE: IC3.30 ((ALE)PE1); also elsewhere on the board
GND: C102.-, C103.2, C105.-, C106.1, C107.1, IC1.4 (OE), IC1.5 (I), IC1.7 (GND), IC1.12 (I), IC1.13 (OE), IC2.4 (GND), IC3.20 (GND), J3.7, J3.8, XTL1.2 (C); also elsewhere on the board
LED_LATCH: IC3.32 ((AD7)PA7); also elsewhere on the board
MIDI_IN: IC3.10 ((RXD0)PD0), J3.5
MIDI_OUT: IC3.11 ((TXD0)PD1), J3.6
unnamed: C105.+, D1.A, D2.C, IC1.2 (I), R200.2
unnamed: D2.A, IC1.3 (O), IC3.9 (RESET)
unnamed: IC3.18 (XTAL2), XTL1.3 (B)
NOTE0: IC3.21 ((A8)PC0); also elsewhere on the board
NOTE1: IC3.22 ((A9)PC1); also elsewhere on the board
NOTE2: IC3.23 ((A10)PC2); also elsewhere on the board
NOTE3: IC3.24 ((A11)PC3); also elsewhere on the board
NOTE4: IC3.25 ((A12)PC4); also elsewhere on the board
NOTE5: IC3.26 ((A13)PC5); also elsewhere on the board
NOTE_LATCH: IC3.29 ((OC1B)PE2); also elsewhere on the board
ROTARY1: IC3.34 ((AD5)PA5); also elsewhere on the board
ROTARY2: IC3.35 ((AD4)PA4); also elsewhere on the board
ROTARY4: IC3.36 ((AD3)PA3); also elsewhere on the board
ROTARY8: IC3.37 ((AD2)PA2); also elsewhere on the board
ROTARYCOM3: IC3.33 ((AD6)PA6); also elsewhere on the board
SLIDE: IC3.27 ((A14)PC6); also elsewhere on the board
SPI_CLK: IC2.6 (SCK), IC3.8 ((SCK)PB7); also elsewhere on the board
SPI_IN: IC2.5 (SI), IC3.6 ((MOSI)PB5); also elsewhere on the board
SPI_OUT: IC2.2 (SO), IC3.7 ((MISO)PB6); also elsewhere on the board
SWITCH_LATCH: IC2.1 (CS/), IC3.1 ((T0)PB0); also elsewhere on the board
TEMPO_SW_A: IC3.38 ((AD1)PA1); also elsewhere on the board
TEMPO_SW_B: IC3.39 ((AD0)PA0); also elsewhere on the board
USBRX: IC3.3 ((RXD1)PB2), J3.1
USB_TX: IC3.4 ((TXD1)PB3), J3.2
XTL1: IC3.19 (XTAL1), XTL1.1 (E)

Notes on the sheet:
Reset and clock
MCU
Unused gates of IC1
EEPROM
To the I/O board
XTL1 is a ceramic resonator
Mounting holes
3.3 mm holes: on the board only, not on the original sheet

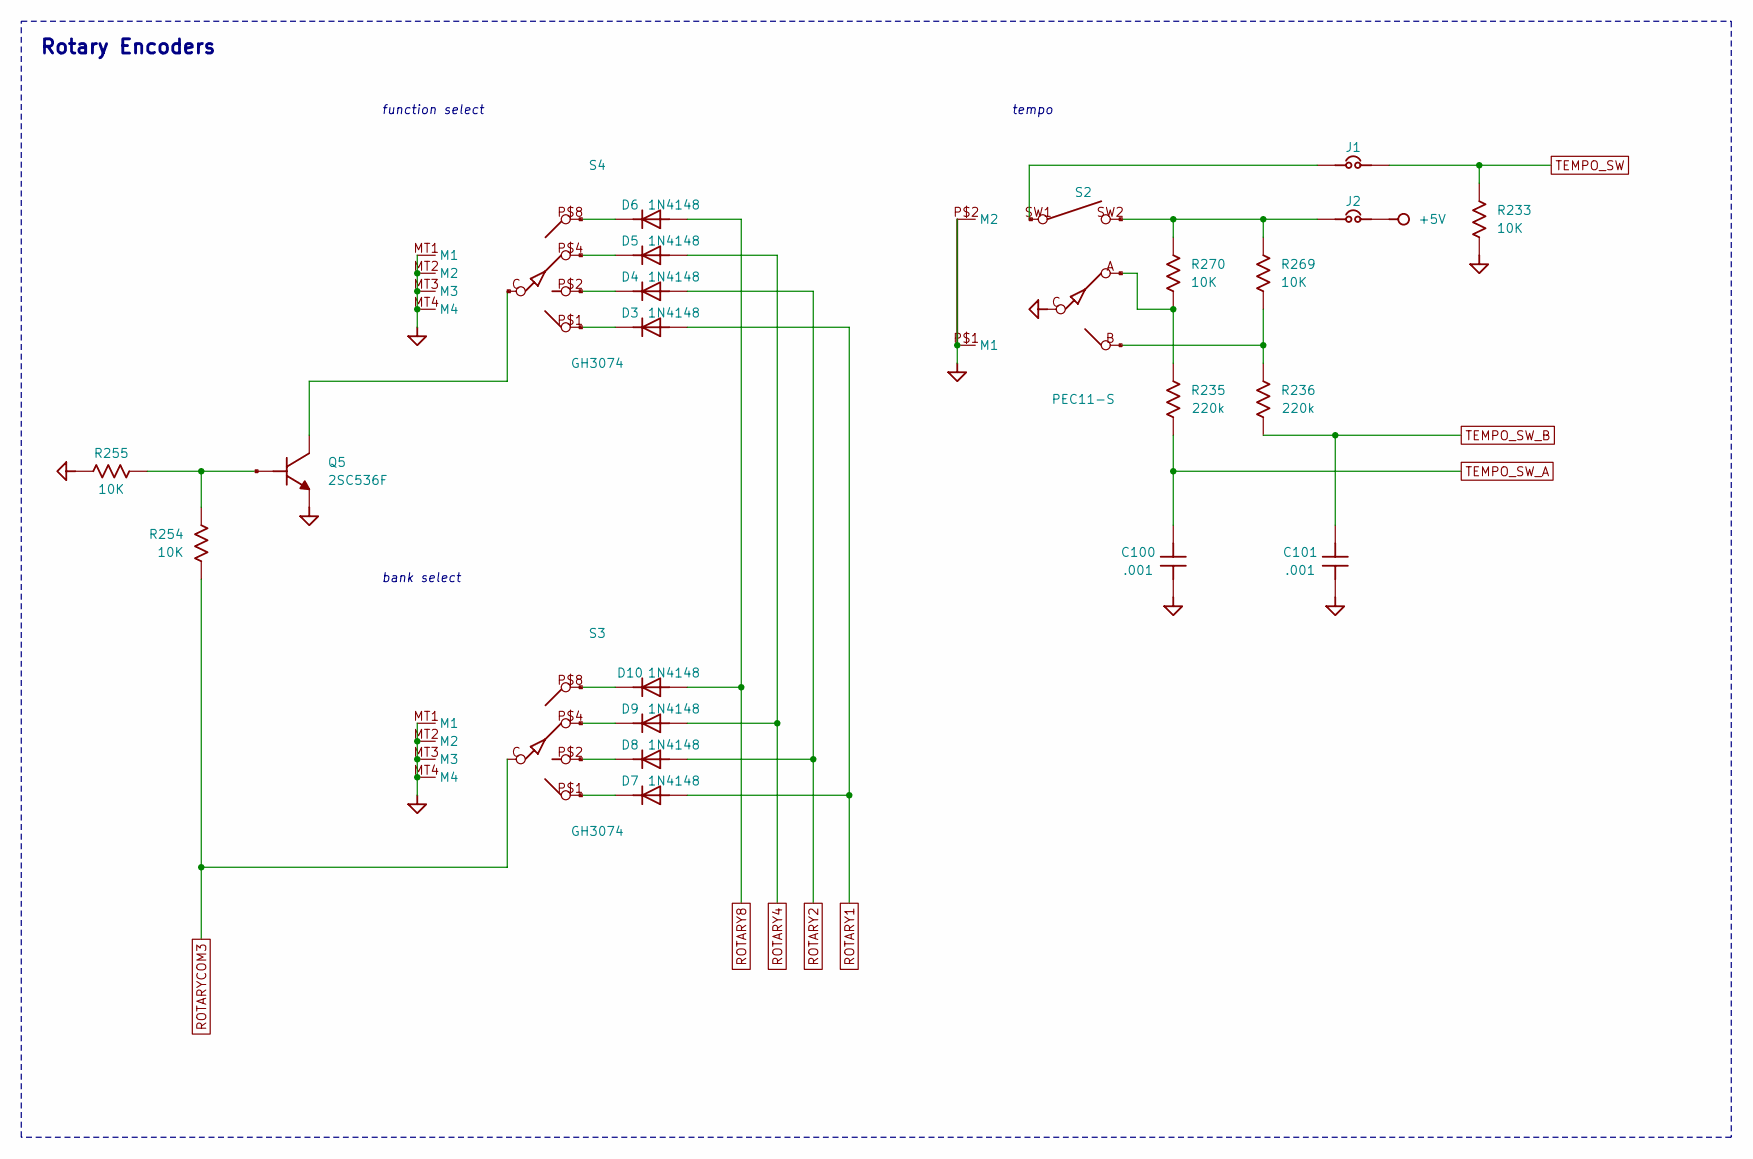
[picture p159: schematic p03_encoders.kicad_sch, Rotary encoders]

Parts:
C100, C101: .001; C050-035X075
D3, D4, D5, D6, D7, D8, D9, D10: 1N4148; DO35-10
J1: J12MM; 12
J2: J15MM; 15
Q5: 2SC536F
R233, R254, R255, R269, R270: 10K; 0207_5V
R235, R236: 220k; 0207_5V
S2: PEC11-S
S3, S4: GH3074

Connections:
+5V: J2.2; also elsewhere on the board
GND: C100.1, C101.1, Q5.3 (E), R233.2, R255.1, S2.C, S2.P$1 (M1), S2.P$2 (M2), S3.MT1 (M1), S3.MT2 (M2), S3.MT3 (M3), S3.MT4 (M4), S4.MT1 (M1), S4.MT2 (M2), S4.MT3 (M3), S4.MT4 (M4); also elsewhere on the board
unnamed: Q5.1 (B), R254.1, R255.2
unnamed: R236.1, R269.2, S2.B
unnamed: D3.C, S4.P$1 (1)
unnamed: D4.C, S4.P$2 (2)
unnamed: R235.1, R270.1, S2.A
unnamed: Q5.2 (C), S4.C
unnamed: D5.C, S4.P$4 (4)
unnamed: D6.C, S4.P$8 (8)
unnamed: D7.C, S3.P$1 (1)
unnamed: D8.C, S3.P$2 (2)
unnamed: D9.C, S3.P$4 (4)
unnamed: D10.C, S3.P$8 (8)
unnamed: J1.1, S2.SW1
unnamed: J2.1, R269.1, R270.2, S2.SW2
ROTARY1: D3.A, D7.A; also elsewhere on the board
ROTARY2: D4.A, D8.A; also elsewhere on the board
ROTARY4: D5.A, D9.A; also elsewhere on the board
ROTARY8: D6.A, D10.A; also elsewhere on the board
ROTARYCOM3: R254.2, S3.C; also elsewhere on the board
TEMPO_SW: J1.2, R233.1; also elsewhere on the board
TEMPO_SW_A: C100.2, R235.2; also elsewhere on the board
TEMPO_SW_B: C101.2, R236.2; also elsewhere on the board

Notes on the sheet:
Rotary Encoders
function select
bank select
tempo

Schematic: p04_switches.kicad_sch, Tact switches

Parts:
C112, C113: .1; C050H075X075
IC1: 74126N; DIL14
IC16, IC17, IC18: 74HC165N; DIL16
R201, R202, R206, R207, R209, R210, R212, R214, R216, R218, R219, R220, R224, R225, R226, R230, R231, R240, R247, R257, R259, R263: 10K; 0207_5V
R232: 10K; 0207_10
S5, S6, S7, S8, S9, S10, S11, S12, S13, S14, S15, S16, S17, S18, S19, S20, S21, S22, S23, S24, S25, S26, S27: 40-XX''; B3F-40XX

Connections:
+5V: C112.2, C113.2, IC16.16 (VCC), IC17.16 (VCC), IC18.16 (VCC), S5.2 (S1), S6.3, S7.1 (S), S8.1 (S), S9.1 (S), S10.1 (S), S11.1 (S), S12.4 (P1), S13.4 (P1), S14.2 (S1), S15.4 (P1), S16.4 (P1), S17.2 (S1), S18.2 (S1), S19.1 (S), S19.2 (S1), S20.2 (S1), S21.2 (S1), S22.1 (S), S22.2 (S1), S23.1 (S), S23.2 (S1), S24.2 (S1), S25.4 (P1), S26.4 (P1), S27.2 (S1); also elsewhere on the board
GND: C112.1, C113.1, IC16.8 (GND), IC16.10 (SER), IC16.15 (INH), IC17.8 (GND), IC17.15 (INH), IC18.8 (GND), IC18.15 (INH), R201.2, R202.2, R206.2, R207.1, R209.2, R210.2, R212.2, R214.2, R216.2, R218.2, R219.2, R220.2, R224.2, R225.2, R226.2, R230.2, R231.2, R232.2, R240.2, R247.2, R257.2, R259.2, R263.2; also elsewhere on the board
unnamed: IC1.9 (I), IC18.9 (QH)
unnamed: IC17.5 (G), R207.2, S12.1 (S)
unnamed: R257.1, S10.4 (P1)
unnamed: IC17.14 (D), R218.1, S9.3
unnamed: IC17.13 (C), S8.3
unnamed: IC17.12 (B), R225.1, S7.3
unnamed: R259.1, S11.4 (P1)
unnamed: IC18.14 (D), R230.1, S5.4 (P1)
unnamed: IC18.12 (B), R232.1, S15.1 (S)
unnamed: R206.1, S26.2 (S1)
unnamed: IC16.5 (G), S27.3
unnamed: IC17.9 (QH), IC18.10 (SER)
unnamed: IC18.4 (F), R224.1, S18.4 (P1)
unnamed: IC17.4 (F), S11.3
unnamed: R209.1, S25.2 (S1)
unnamed: IC16.9 (QH), IC17.10 (SER)
unnamed: IC16.13 (C), R214.1, S22.4 (P1)
unnamed: R210.1, S24.4 (P1)
unnamed: IC16.11 (A), S23.3
unnamed: IC16.4 (F), S26.1 (S)
unnamed: IC18.6 (H), R219.1, S20.4 (P1)
unnamed: IC16.12 (B), R216.1, S21.4 (P1)
unnamed: R240.1, S6.2 (S1)
unnamed: IC16.14 (D), S24.3
unnamed: R201.1, S27.4 (P1)
unnamed: R212.1, S23.4 (P1)
unnamed: IC18.5 (G), R220.1, S19.4 (P1)
unnamed: R231.1, S16.2 (S1)
unnamed: IC16.6 (H), R202.1, S14.3
unnamed: R263.1, S13.2 (S1)
unnamed: IC17.6 (H), S13.1 (S)
unnamed: IC18.3 (E), R226.1, S17.4 (P1)
unnamed: IC17.3 (E), S10.3
unnamed: IC17.11 (A), S6.1 (S)
unnamed: IC18.11 (A), S16.1 (S)
unnamed: IC16.3 (E), S25.1 (S)
unnamed: R247.1, S8.4 (P1)
SPI_CLK: IC16.2 (CLK), IC17.2 (CLK), IC18.2 (CLK); also elsewhere on the board
SPI_OUT: IC1.8 (O); also elsewhere on the board
SWITCH_LATCH: IC1.10 (OE), IC16.1 (SH/LD\), IC17.1 (SH/LD\), IC18.1 (SH/LD\); also elsewhere on the board
TEMPO_SW: IC18.13 (C); also elsewhere on the board

Notes on the sheet:
Tact Switches

Schematic: p05_leds.kicad_sch, LEDs

Parts:
C104, C108, C109, C110, C111: .1; C050H075X075
IC4, IC5, IC6, IC7, IC8: 74HC595N; DIL16
LED1, LED2, LED3, LED4, LED5, LED6, LED7, LED8, LED9, LED10, LED11, LED12, LED13, LED14, LED15, LED16, LED17, LED18, LED19, LED20, LED21, LED22, LED23, LED24, LED25, LED26, LED27, LED28, LED29, LED30, LED31, LED32, LED33, LED34, LED35, LED36, LED37, LED38, LED39, LED40: LED5MM
R203, R204, R205, R208, R211, R213, R215, R217, R221, R222, R223, R227, R228, R229, R237, R238, R239, R241, R242, R243, R244, R245, R246, R248, R249, R250, R251, R252, R253, R256, R258, R260, R261, R262, R264, R265, R266, R267, R268: 10K; 0207_5V
R234: 10K; 0207_15

Connections:
+5V: C104.2, C108.2, C109.2, C110.2, C111.2, IC4.10 (SCL), IC4.16 (VCC), IC5.10 (SCL), IC5.16 (VCC), IC6.10 (SCL), IC6.16 (VCC), IC7.10 (SCL), IC7.16 (VCC), IC8.10 (SCL), IC8.16 (VCC); also elsewhere on the board
GND: C104.1, C108.1, C109.1, C110.1, C111.1, IC4.8 (GND), IC4.13 (G), IC5.8 (GND), IC5.13 (G), IC6.8 (GND), IC6.13 (G), IC7.8 (GND), IC7.13 (G), IC8.8 (GND), IC8.13 (G), LED1.K (C), LED2.K (C), LED3.K (C), LED4.K (C), LED5.K (C), LED6.K (C), LED7.K (C), LED8.K (C), LED9.K (C), LED10.K (C), LED11.K (C), LED12.K (C), LED13.K (C), LED14.K (C), LED15.K (C), LED16.K (C), LED17.K (C), LED18.K (C), LED19.K (C), LED20.K (C), LED21.K (C), LED22.K (C), LED23.K (C), LED24.K (C), LED25.K (C), LED26.K (C), LED27.K (C), LED28.K (C), LED29.K (C), LED30.K (C), LED31.K (C), LED32.K (C), LED33.K (C), LED34.K (C), LED35.K (C), LED36.K (C), LED37.K (C), LED38.K (C), LED39.K (C), LED40.K (C); also elsewhere on the board
LED_LATCH: IC4.12 (RCK), IC5.12 (RCK), IC6.12 (RCK), IC7.12 (RCK), IC8.12 (RCK); also elsewhere on the board
unnamed: IC7.1 (QB), R252.2
unnamed: IC4.7 (QH), R241.1
unnamed: IC4.6 (QG), R237.1
unnamed: LED6.A, R244.1
unnamed: LED7.A, R250.1
unnamed: IC4.5 (QF), R234.1
unnamed: IC5.9 (QH*), IC7.14 (SER)
unnamed: IC5.6 (QG), R243.2
unnamed: IC5.7 (QH), R244.2
unnamed: IC5.5 (QF), R242.1
unnamed: IC7.15 (QA), R250.2
unnamed: IC7.2 (QC), R251.1
unnamed: LED1.A, R234.2
unnamed: LED2.A, R237.2
unnamed: IC7.3 (QD), R253.1
unnamed: IC7.4 (QE), R256.1
unnamed: LED14.A, R262.1
unnamed: IC8.3 (QD), R264.1
unnamed: IC8.6 (QG), R267.1
unnamed: IC8.7 (QH), R268.1
unnamed: IC8.5 (QF), R266.2
unnamed: IC5.1 (QB), R223.1
unnamed: IC8.4 (QE), R265.1
unnamed: IC5.2 (QC), R222.2
unnamed: IC5.15 (QA), R221.1
unnamed: IC5.4 (QE), R246.1
unnamed: IC5.3 (QD), R245.2
unnamed: IC4.3 (QD), R238.2
unnamed: IC4.4 (QE), R239.2
unnamed: IC4.1 (QB), R229.1
unnamed: IC7.6 (QG), R261.1
unnamed: IC7.7 (QH), R262.2
unnamed: IC7.5 (QF), R260.1
unnamed: IC4.2 (QC), R228.2
unnamed: IC4.15 (QA), R227.1
unnamed: IC8.15 (QA), R203.1
unnamed: IC8.1 (QB), R205.1
unnamed: IC8.2 (QC), R204.2
unnamed: IC6.15 (QA), R208.1
unnamed: IC6.1 (QB), R211.1
unnamed: IC6.2 (QC), R213.1
unnamed: IC6.3 (QD), R215.1
unnamed: IC6.4 (QE), R217.2
unnamed: IC6.7 (QH), R248.1
unnamed: IC6.6 (QG), R249.2
unnamed: IC6.5 (QF), R258.1
unnamed: LED9.A, R252.1
unnamed: LED10.A, R253.2
unnamed: LED11.A, R256.2
unnamed: LED12.A, R260.2
unnamed: LED16.A, R267.2
unnamed: LED3.A, R241.2
unnamed: LED4.A, R242.2
unnamed: LED5.A, R243.1
unnamed: LED15.A, R266.1
unnamed: LED8.A, R251.2
unnamed: LED13.A, R261.2
unnamed: IC4.9 (QH*), IC5.14 (SER)
unnamed: IC6.14 (SER), IC7.9 (QH*)
unnamed: IC6.9 (QH*), IC8.14 (SER)
unnamed: LED17.A, R268.2
unnamed: LED18.A, R238.1
unnamed: LED19.A, R239.1
unnamed: LED20.A, R245.1
unnamed: LED21.A, R246.2
unnamed: LED22.A, R248.2
unnamed: LED23.A, R249.1
unnamed: LED24.A, R258.2
unnamed: LED25.A, R265.2
unnamed: LED26.A, R264.2
unnamed: LED27.A, R203.2
unnamed: LED28.A, R229.2
unnamed: LED29.A, R228.1
unnamed: LED30.A, R227.2
unnamed: LED31.A, R223.2
unnamed: LED32.A, R222.1
unnamed: LED33.A, R221.2
unnamed: LED34.A, R217.1
unnamed: LED35.A, R215.2
unnamed: LED36.A, R213.2
unnamed: LED37.A, R211.2
unnamed: LED38.A, R208.2
unnamed: LED39.A, R205.2
unnamed: LED40.A, R204.1
SPI_CLK: IC4.11 (SCK), IC5.11 (SCK), IC6.11 (SCK), IC7.11 (SCK), IC8.11 (SCK); also elsewhere on the board
SPI_IN: IC4.14 (SER); also elsewhere on the board

Notes on the sheet:
LEDs

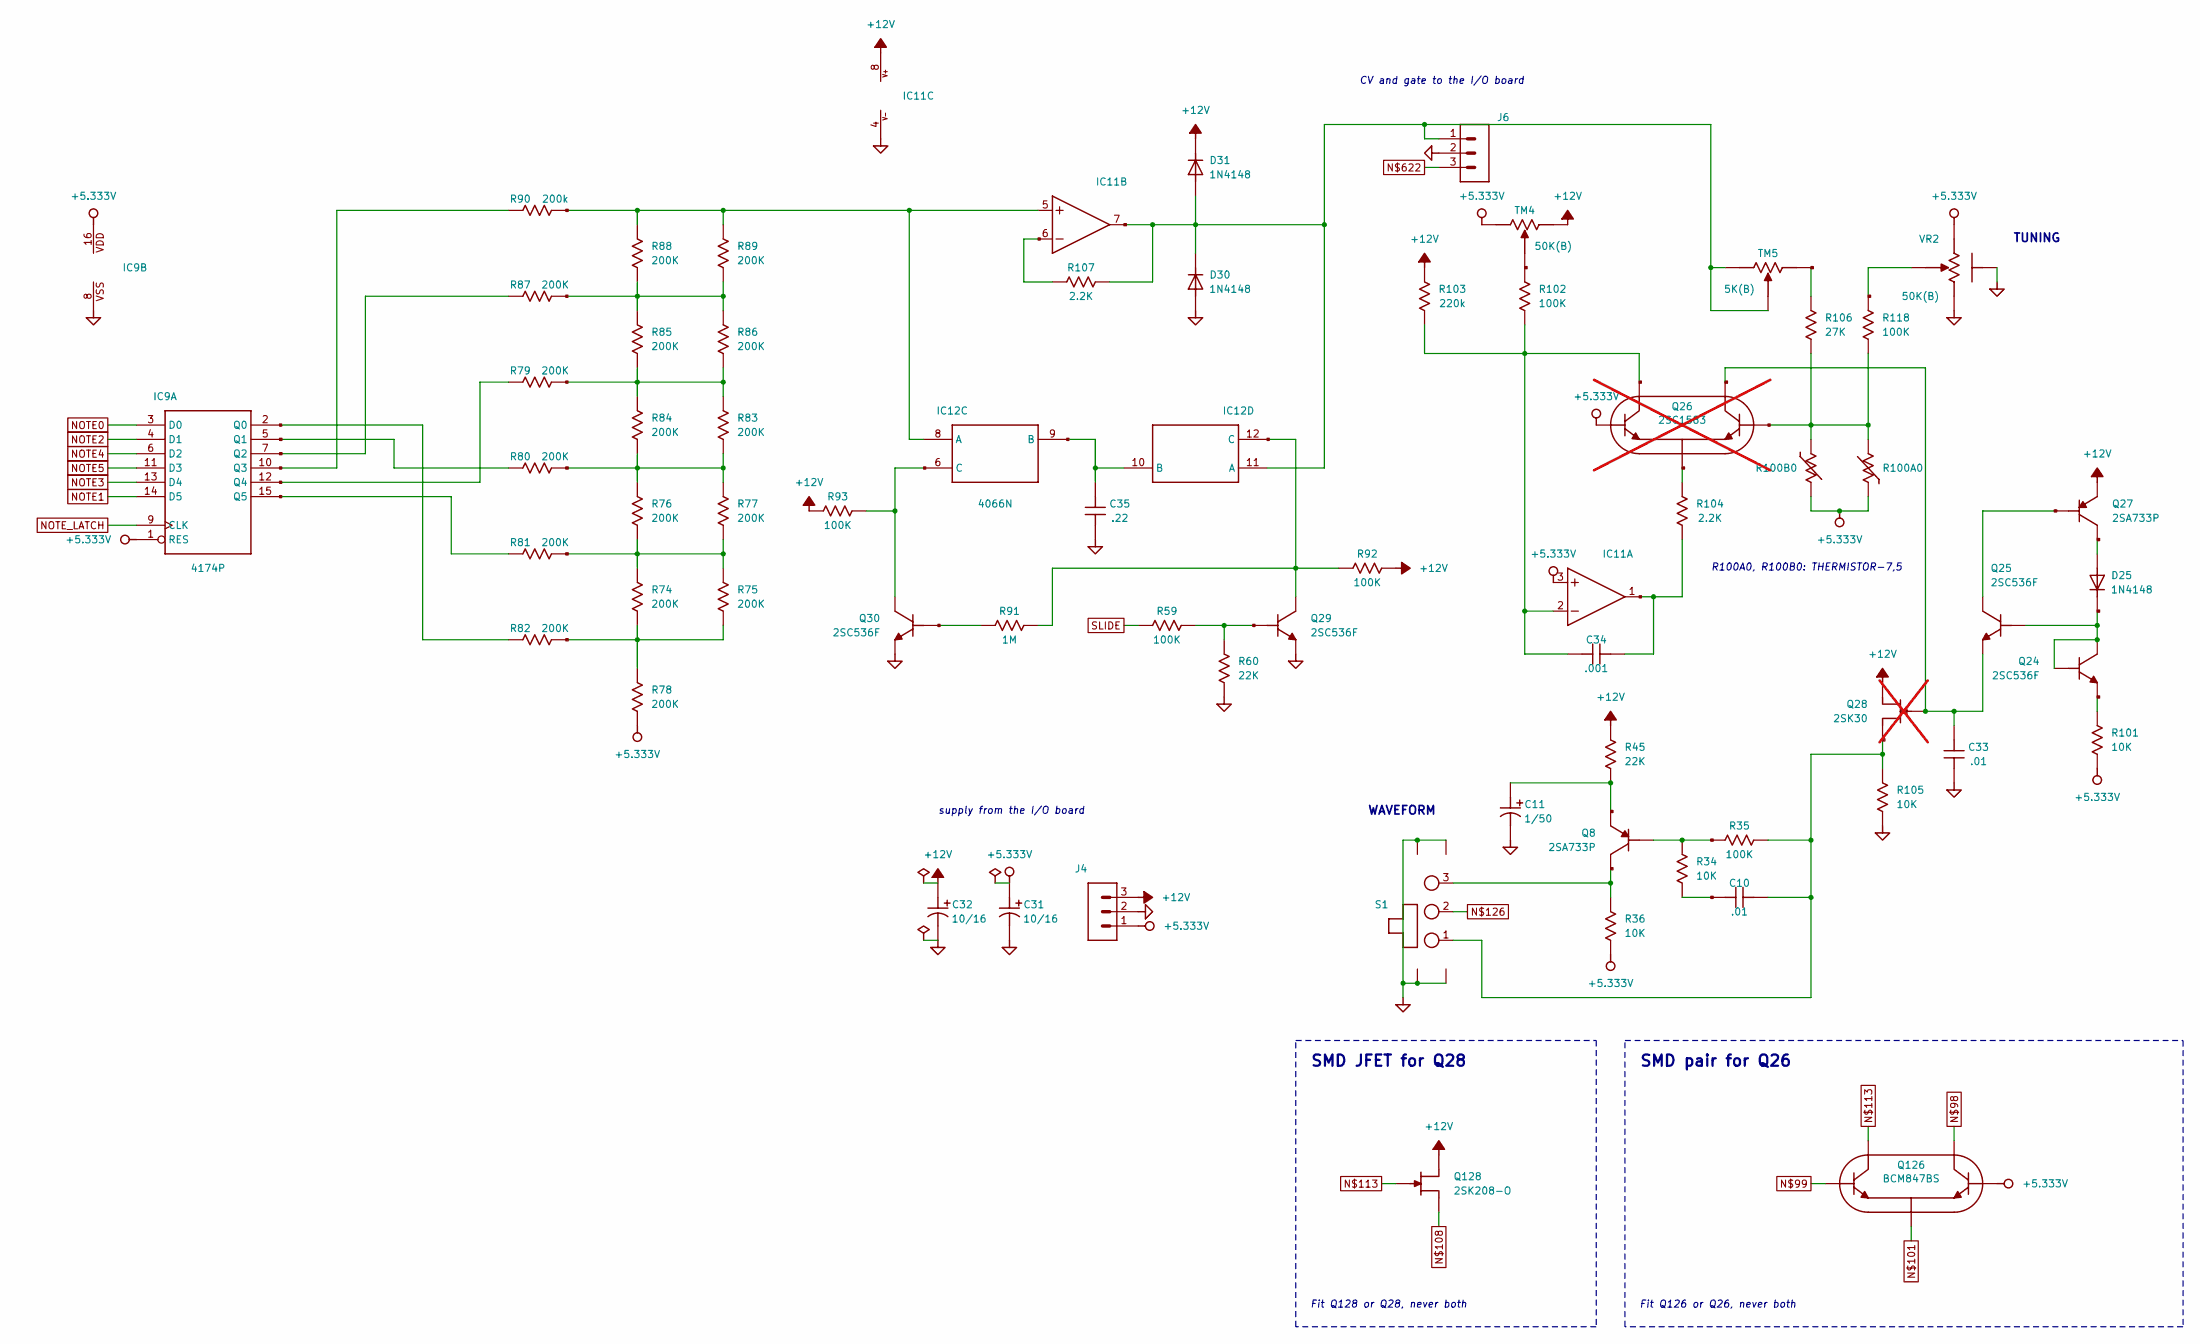
[picture p160: schematic p06_cv_vco.kicad_sch, CV and VCO]

Parts:
C10, C33: .01; C050-024X044
C11: 1/50; E5-6
C31, C32: 10/16; E5-6
C34: .001; C050-035X075
C35: .22; C050-045X075
D25, D30, D31: 1N4148; DO35-10
IC9: 4174P; DIL16
IC11: AN656N; DIL08
IC12: 4066N; DIL14
J4, J6: MA03-''; MA03-1
Q8, Q27: 2SA733P; TO92
Q24, Q25, Q29, Q30: 2SC536F
Q26: 2SC1583; SSIP5; not fitted
Q28: 2SK30; not fitted
Q126: BCM847BS; SOT-363_Hand
Q128: 2SK208-O; SC-59_Hand
R34, R36, R101, R105: 10K; 0207_5V
R35, R59, R92, R93, R102, R118: 100K; 0207_5V
R45, R60: 22K; 0207_5V
R74, R75, R76, R77, R78, R79, R80, R81, R82, R83, R84, R85, R86, R87, R88, R89: 200K; 0207_5V
R90: 200k; 0207_5V
R91: 1M; 0207_5V
R100A0, R100B0: THERMISTOR-7,5; R-7,5
R103: 220k; 0207_5V
R104, R107: 2.2K; 0207_5V
R106: 27K; 0207_5V
S1: SWITCH_GND; NKKTOGGLE
TM4: 50K(B); 306
TM5: 5K(B); 306
VR2: 50K(B); EVU

Connections:
+5.333V: C31.+, IC9.1 (RES), IC9.16 (VDD), IC11.3 (+IN), J4.1, Q26.1 (B), Q126.2 (B1), R36.2, R78.1, R100A0.2, R100B0.1, R101.2, TM4.3 (E), VR2.3 (E); also elsewhere on the board
+12V: C32.+, D31.C, IC11.8 (V+), J4.3, Q27.3 (E), Q28.1 (D), Q128.2 (D), R45.1, R92.2, R93.1, R103.1, TM4.1 (A); also elsewhere on the board
GND: C11.-, C31.-, C32.-, C33.2, C35.2, D30.A, IC9.8 (VSS), IC11.4 (V-), J4.2, J6.2, Q29.3 (E), Q30.3 (E), R60.1, R105.1, S1.M1, S1.M2, S1.M3, S1.M4, VR2.1 (A), VR2.M1, VR2.M2; also elsewhere on the board
unnamed: IC9.10 (Q3), R90.1
unnamed: C35.1, IC12.9 (B), IC12.10 (B)
unnamed: IC12.6 (C), Q30.2 (C), R93.2
unnamed: Q30.1 (B), R91.2
unnamed: IC11.6 (-IN), R107.1
unnamed: R85.2, R86.1, R87.2, R88.2, R89.1
unnamed: IC12.12 (C), Q29.2 (C), R91.1, R92.1
unnamed: R79.1, R83.1, R84.2, R85.1, R86.2
unnamed: IC9.15 (Q5), R81.2
unnamed: IC9.2 (Q0), R82.1
unnamed: IC9.12 (Q4), R79.2
unnamed: Q29.1 (B), R59.2, R60.2
unnamed: C34.1, IC11.1 (OUT), R104.2
unnamed: C34.2, IC11.2 (-IN), Q26.2 (C), Q126.6 (C1), R102.1, R103.2
unnamed: Q26.5 (B1), Q126.5 (B), R100A0.1, R100B0.2, R106.2, R118.2
unnamed: Q26.3 (E), Q126.1 (E), Q126.4 (E1), R104.1
unnamed: R118.1, VR2.2 (S)
unnamed: D25.A, Q27.2 (C)
unnamed: D25.C, Q24.1 (B), Q24.2 (C), Q25.1 (B)
unnamed: Q24.3 (E), R101.1
unnamed: Q25.2 (C), Q27.1 (B)
unnamed: C10.1, Q28.3 (S), Q128.1 (S), R35.1, R105.2, S1.1
unnamed: Q8.1 (B), R34.1, R35.2
unnamed: C10.2, R34.2
unnamed: IC11.5 (+IN), IC12.8 (A), R88.1, R89.2, R90.2
unnamed: C33.1, Q25.3 (E), Q26.4 (C1), Q28.2 (G), Q126.3 (C), Q128.3 (G)
unnamed: R102.2, TM4.2 (S)
unnamed 125: S1.2; also elsewhere on the board
unnamed: R76.2, R77.1, R80.2, R83.2, R84.1
unnamed: R106.1, TM5.1 (A)
unnamed: IC9.7 (Q2), R87.1
unnamed: IC9.5 (Q1), R80.1
unnamed: R74.2, R75.2, R78.2, R82.2
unnamed: R74.1, R75.1, R76.1, R77.2, R81.1
unnamed: C11.+, Q8.3 (E), R45.2
unnamed: Q8.2 (C), R36.1, S1.3
unnamed 297: J6.3; also elsewhere on the board
unnamed: D30.C, D31.A, IC11.7 (OUT), IC12.11 (A), J6.1, R107.2, TM5.2 (S), TM5.3 (E)
NOTE0: IC9.3 (D0); also elsewhere on the board
NOTE1: IC9.14 (D5); also elsewhere on the board
NOTE2: IC9.4 (D1); also elsewhere on the board
NOTE3: IC9.13 (D4); also elsewhere on the board
NOTE4: IC9.6 (D2); also elsewhere on the board
NOTE5: IC9.11 (D3); also elsewhere on the board
NOTE_LATCH: IC9.9 (CLK); also elsewhere on the board
SLIDE: R59.1; also elsewhere on the board

Notes on the sheet:
TUNING
R100A0, R100B0: THERMISTOR-7,5
WAVEFORM
supply from the I/O board
CV and gate to the I/O board
SMD pair for Q26
Fit Q126 or Q26, never both
SMD JFET for Q28
Fit Q128 or Q28, never both

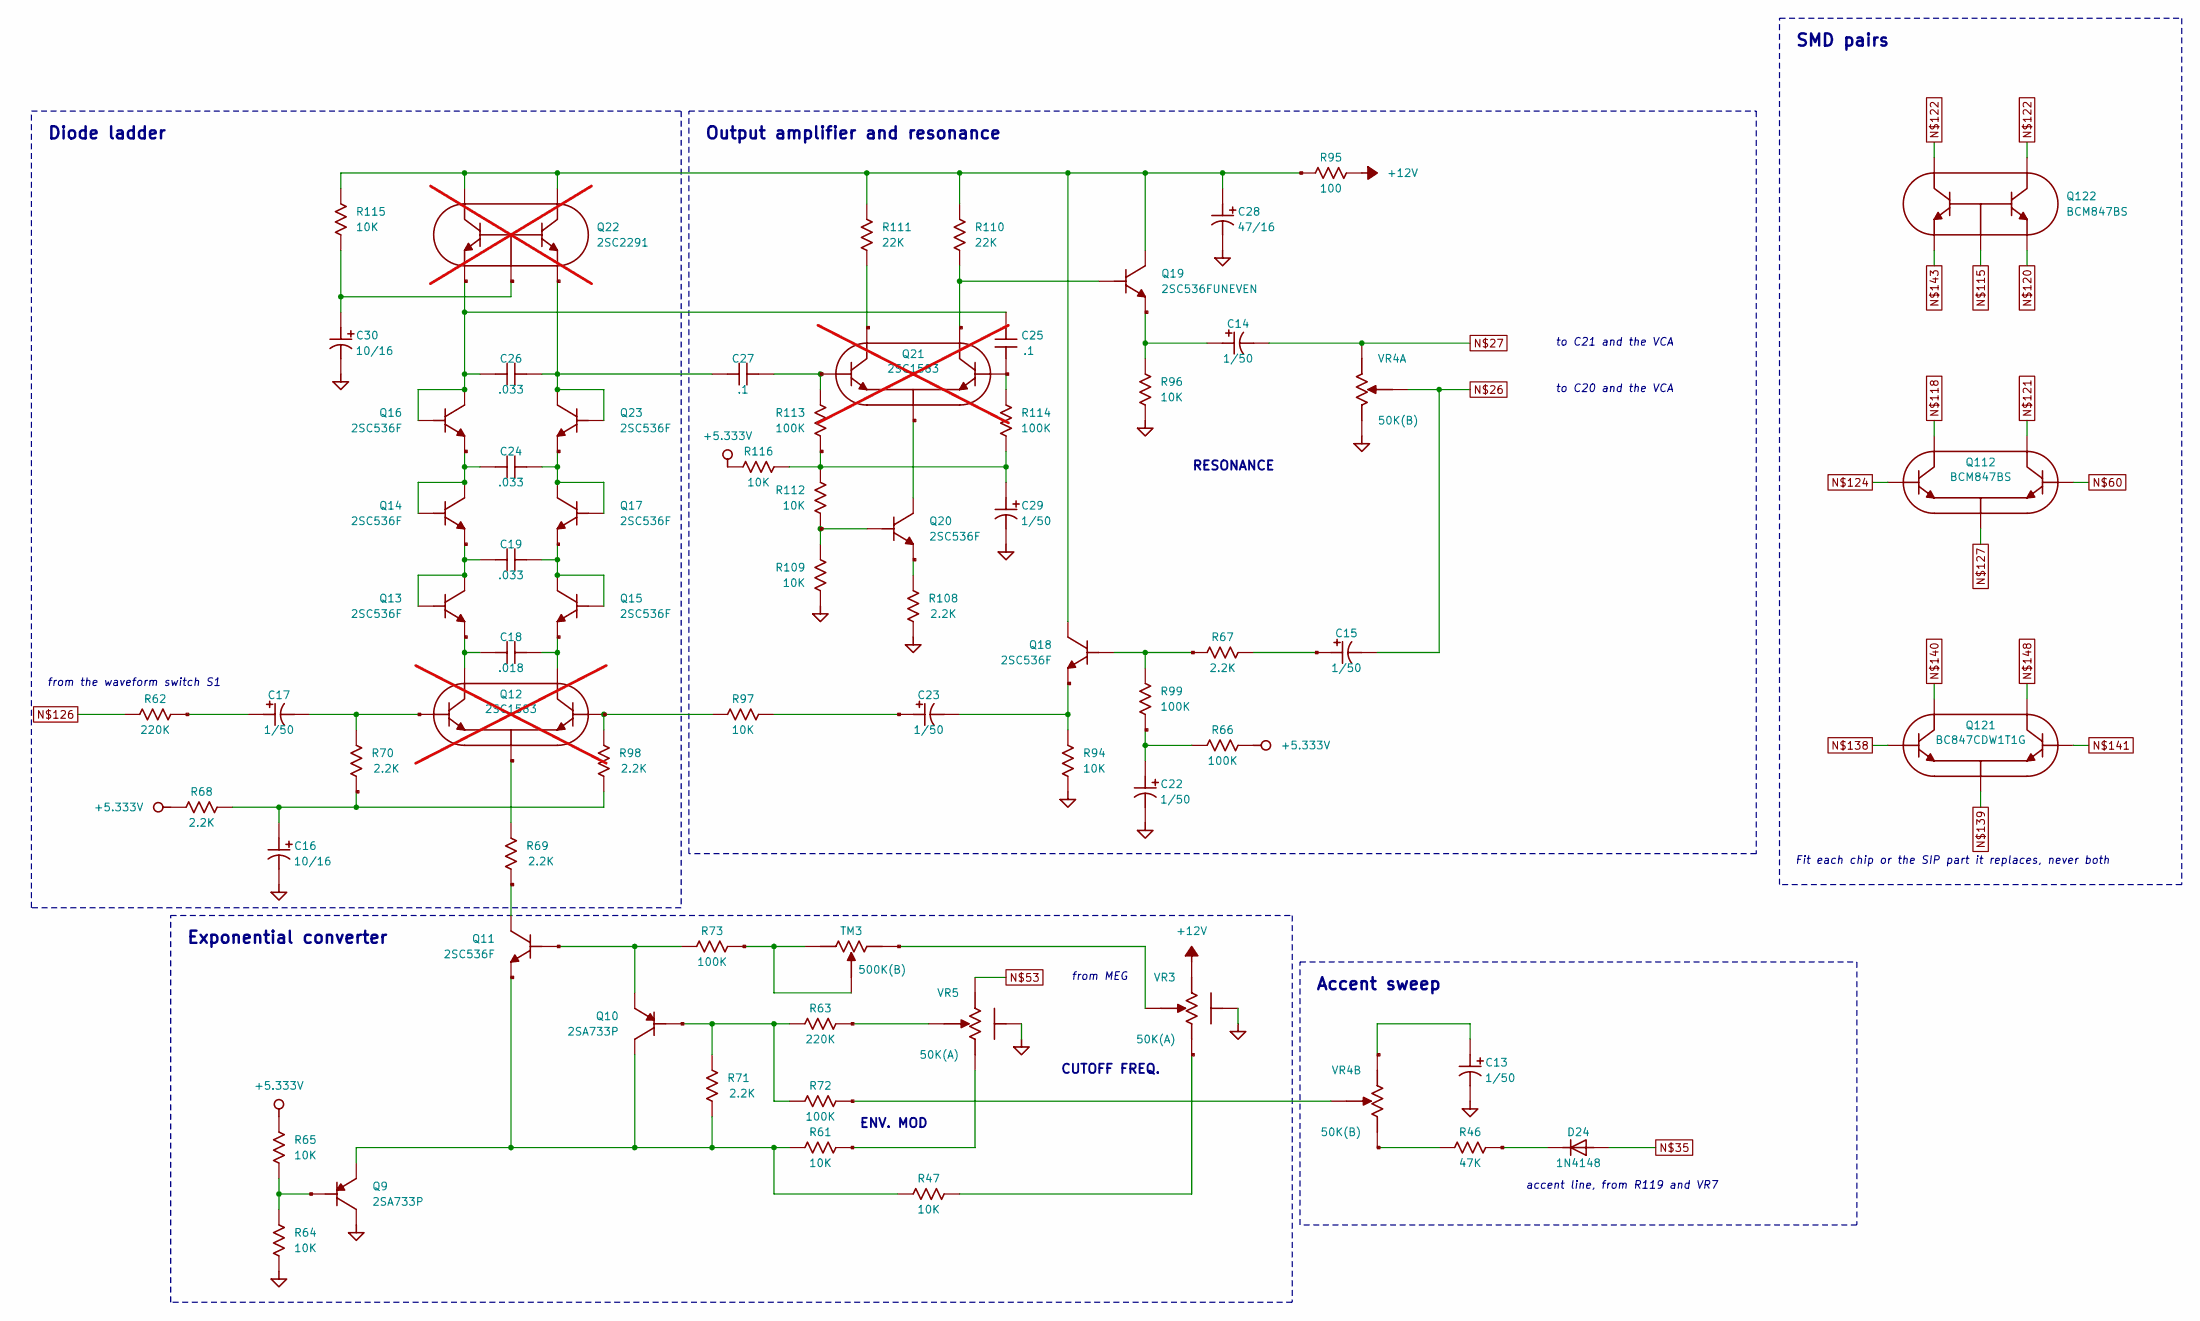
[picture p161: schematic p07_vcf.kicad_sch, VCF]

Parts:
C13, C14, C15, C22, C23, C29: 1/50; E5-6
C16, C30: 10/16; E5-6
C17: 1/50; E3,5-8
C18: .018; C050-025X075
C19, C24: .033; C050-025X075
C25, C27: .1; C050-030X075
C26: .033; C075-032X103
C28: 47/16; E5-6
D24: 1N4148; DO35-10
Q9, Q10: 2SA733P; TO92
Q11, Q13, Q14, Q15, Q16, Q18, Q20: 2SC536F
Q12, Q21: 2SC1583; SSIP5; not fitted
Q17, Q23: 2SC536F; 2SC536_UNEVEN
Q19: 2SC536FUNEVEN; 2SC536_UNEVEN
Q22: 2SC2291; SSIP5; not fitted
Q112, Q122: BCM847BS; SOT-363_Hand
Q121: BC847CDW1T1G; SOT-363_Hand
R46: 47K; 0207_5V
R47, R61, R64, R65, R94, R109, R112, R116: 10K; 0207_5V
R62, R63: 220K; 0207_5V
R66, R72, R73, R99, R113, R114: 100K; 0207_5V
R67, R68, R69, R70, R71, R108: 2.2K; 0207_5V
R95: 100; 0207_5V
R96, R97, R115: 10K; 0207_2V
R98: 2.2K; 0207_2V
R110, R111: 22K; 0207_5V
TM3: 500K(B); 306
VR3, VR5: 50K(A); EVU
VR4: 50K(B); ALPHADUAL

Connections:
+5.333V: R65.2, R66.2, R68.1, R116.2; also elsewhere on the board
+12V: R95.2, VR3.3 (E); also elsewhere on the board
GND: C13.-, C16.-, C22.-, C28.-, C29.-, C30.-, Q9.2 (C), R64.2, R94.1, R96.1, R108.1, R109.2, VR3.M1, VR3.M2, VR4.1A (A), VR4.M1 (MT1), VR4.M2 (MT2), VR5.M1, VR5.M2; also elsewhere on the board
unnamed 40: C15.-, VR4.2A (S); also elsewhere on the board
unnamed 41: C14.-, VR4.3A (E); also elsewhere on the board
unnamed 49: D24.A; also elsewhere on the board
unnamed: R61.1, VR5.1 (A)
unnamed 66: VR5.3 (E); also elsewhere on the board
unnamed: Q12.5 (B1), Q112.2 (B1), R97.1, R98.1
unnamed: C30.+, Q22.3 (B), Q122.2 (B), Q122.5 (B1), R115.2
unnamed: C24.1, Q14.1 (B), Q14.2 (C), Q16.3 (E)
unnamed: C19.1, Q13.1 (B), Q13.2 (C), Q14.3 (E)
unnamed: C18.2, Q12.2 (C), Q13.3 (E), Q112.3 (C)
unnamed: C24.2, Q17.1 (B), Q17.2 (C), Q23.3 (E)
unnamed: C26.2, C27.1, Q22.5 (E), Q23.1 (B), Q23.2 (C), Q122.1 (E)
unnamed: C18.1, Q12.4 (C1), Q15.3 (E), Q112.6 (C1)
unnamed: C28.+, Q18.2 (C), Q19.2 (C), Q22.2 (C1), Q22.4 (C), Q122.3 (C1), Q122.6 (C), R95.1, R110.2, R111.1, R115.1
unnamed: C17.+, R62.2
unnamed: C17.-, Q12.1 (B), Q112.5 (B), R70.1
unnamed: C16.+, R68.2, R70.2, R98.2
unnamed 125: R62.1; also elsewhere on the board
unnamed: Q12.3 (E), Q112.1 (E), Q112.4 (E1), R69.1
unnamed: C23.+, R97.2
unnamed: C23.-, Q18.3 (E), R94.2
unnamed: Q18.1 (B), R67.2, R99.2
unnamed: C22.+, R66.1, R99.1
unnamed: C15.+, R67.1
unnamed: Q10.1 (B), R63.1, R71.2, R72.1
unnamed: Q20.1 (B), R109.1, R112.2
unnamed: Q20.3 (E), R108.2
unnamed: C25.2, Q21.1 (B), Q121.5 (B), R114.2
unnamed: Q20.2 (C), Q21.3 (E), Q121.1 (E), Q121.4 (E1)
unnamed: Q19.1 (B), Q21.2 (C), Q121.3 (C), R110.1
unnamed: C27.2, Q21.5 (B1), Q121.2 (B1), R113.1
unnamed: R47.1, VR3.1 (A)
unnamed: C25.1, C26.1, Q16.1 (B), Q16.2 (C), Q22.1 (E1), Q122.4 (E1)
unnamed: C14.+, Q19.3 (E), R96.2
unnamed: Q11.2 (C), R69.2
unnamed: Q10.3 (E), Q11.1 (B), R73.1
unnamed: Q21.4 (C1), Q121.6 (C1), R111.2
unnamed: Q9.1 (B), R64.1, R65.1
unnamed: R73.2, TM3.2 (S), TM3.3 (E)
unnamed: R72.2, VR4.2B (S1)
unnamed: R63.2, VR5.2 (S)
unnamed: TM3.1 (A), VR3.2 (S)
unnamed: D24.C, R46.1
unnamed: R46.2, VR4.1B (A1)
unnamed: C13.+, VR4.3B (E1)
unnamed: Q9.3 (E), Q10.2 (C), Q11.3 (E), R47.2, R61.2, R71.1
unnamed: C29.+, R112.1, R113.2, R114.1, R116.1
Q17: C19.2, Q15.1 (B), Q15.2 (C), Q17.3 (E)

Notes on the sheet:
Diode ladder
Output amplifier and resonance
Exponential converter
Accent sweep
from the waveform switch S1
to C21 and the VCA
to C20 and the VCA
RESONANCE
from MEG
ENV. MOD
CUTOFF FREQ.
accent line, from R119 and VR7
SMD pairs
Fit each chip or the SIP part it replaces, never both
