cozycactus/x0xb0x-hardware/kicad-working/mainboard/mainboard.kicad_pcb

## KiCad design kicad-working/mainboard/mainboard.kicad_pcb (continued)

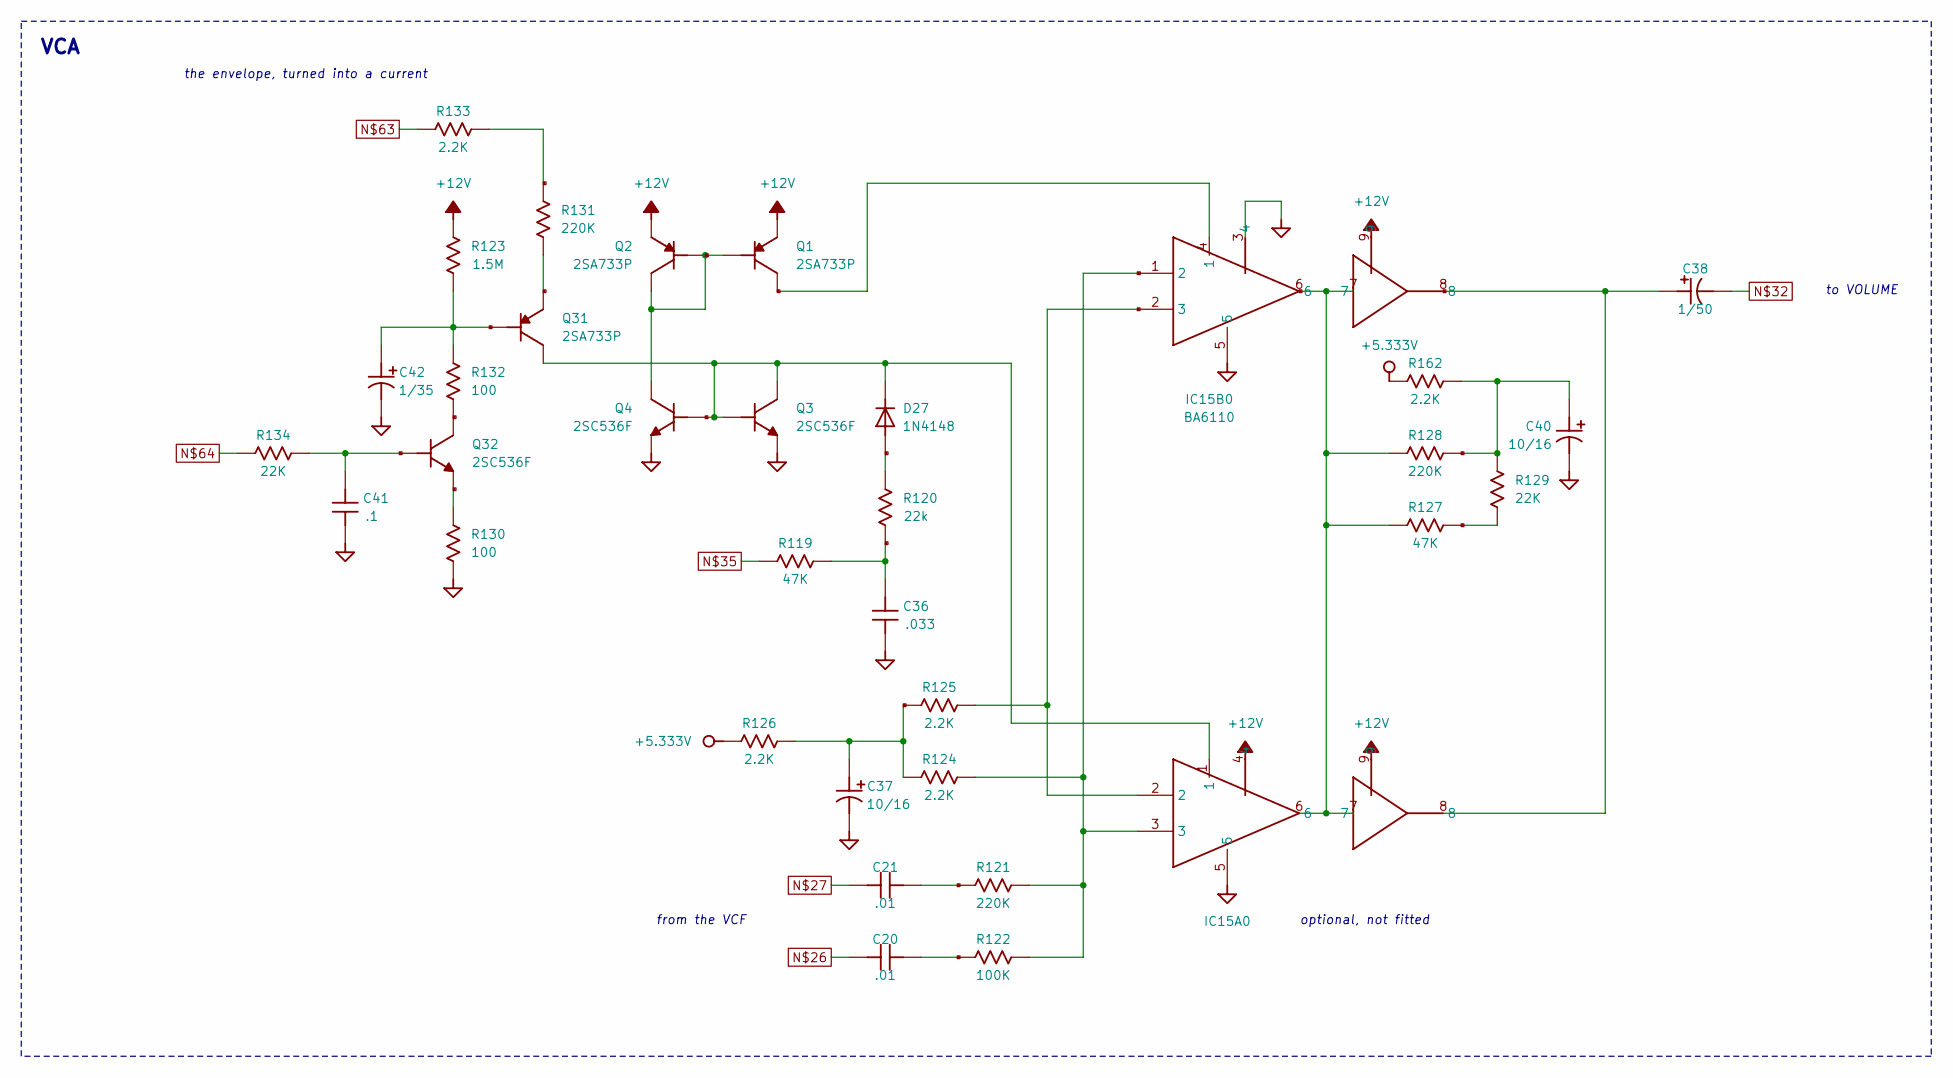
[picture p162: schematic p08_vca.kicad_sch, VCA]

Parts:
C20, C21: .01; C050-024X044
C36: .033; C050-025X075
C37, C40: 10/16; E5-6
C38: 1/50; E5-6
C41: .1; C050-030X075
C42: 1/35; E2,5-7
D27: 1N4148; DO35-10
IC15A0: BA662''; SIP9
IC15B0: BA6110; SIP9
Q1, Q2, Q31: 2SA733P; TO92
Q3, Q4, Q32: 2SC536F
R119, R127: 47K; 0207_5V
R120: 22k; 0207_5V
R121, R128, R131: 220K; 0207_5V
R122: 100K; 0207_5V
R123: 1.5M; 0207_5V
R124, R125, R126, R133, R162: 2.2K; 0207_5V
R129, R134: 22K; 0207_5V
R130, R132: 100; 0207_5V

Connections:
+5.333V: R126.1, R162.1; also elsewhere on the board
+12V: IC15A0.4, IC15A0.9, IC15B0.9, Q1.3 (E), Q2.3 (E), R123.2; also elsewhere on the board
GND: C36.2, C37.-, C40.-, C41.2, C42.-, IC15A0.5, IC15B0.3 (4), IC15B0.5, Q3.3 (E), Q4.3 (E), R130.2; also elsewhere on the board
unnamed: C20.1, R122.2
unnamed: C37.+, R124.2, R125.1, R126.2
unnamed: IC15A0.2, IC15B0.2 (3), R125.2
unnamed: C21.1, R121.1
unnamed 40: C20.2; also elsewhere on the board
unnamed 41: C21.2; also elsewhere on the board
unnamed: IC15A0.6, IC15A0.7, IC15B0.6, IC15B0.7, R127.1, R128.2
unnamed: IC15B0.4 (1), Q1.2 (C)
unnamed: R127.2, R129.1
unnamed: C40.+, R128.1, R129.2, R162.2
unnamed 46: C38.-; also elsewhere on the board
unnamed: D27.A, R120.1
unnamed: C36.1, R119.1, R120.2
unnamed 49: R119.2; also elsewhere on the board
unnamed: C38.+, IC15A0.8, IC15B0.8
unnamed: Q32.3 (E), R130.1
unnamed 73: R133.2; also elsewhere on the board
unnamed 74: R134.1; also elsewhere on the board
unnamed: C41.1, Q32.1 (B), R134.2
unnamed: Q32.2 (C), R132.2
unnamed: C42.+, Q31.1 (B), R123.1, R132.1
unnamed: D27.C, IC15A0.1, Q3.1 (B), Q3.2 (C), Q4.1 (B), Q31.2 (C)
unnamed: Q31.3 (E), R131.1
unnamed: R131.2, R133.1
unnamed: Q1.1 (B), Q2.1 (B), Q2.2 (C), Q4.2 (C)
unnamed: IC15A0.3, IC15B0.1 (2), R121.2, R122.1, R124.1

Notes on the sheet:
VCA
the envelope, turned into a current
optional, not fitted
to VOLUME
from the VCF

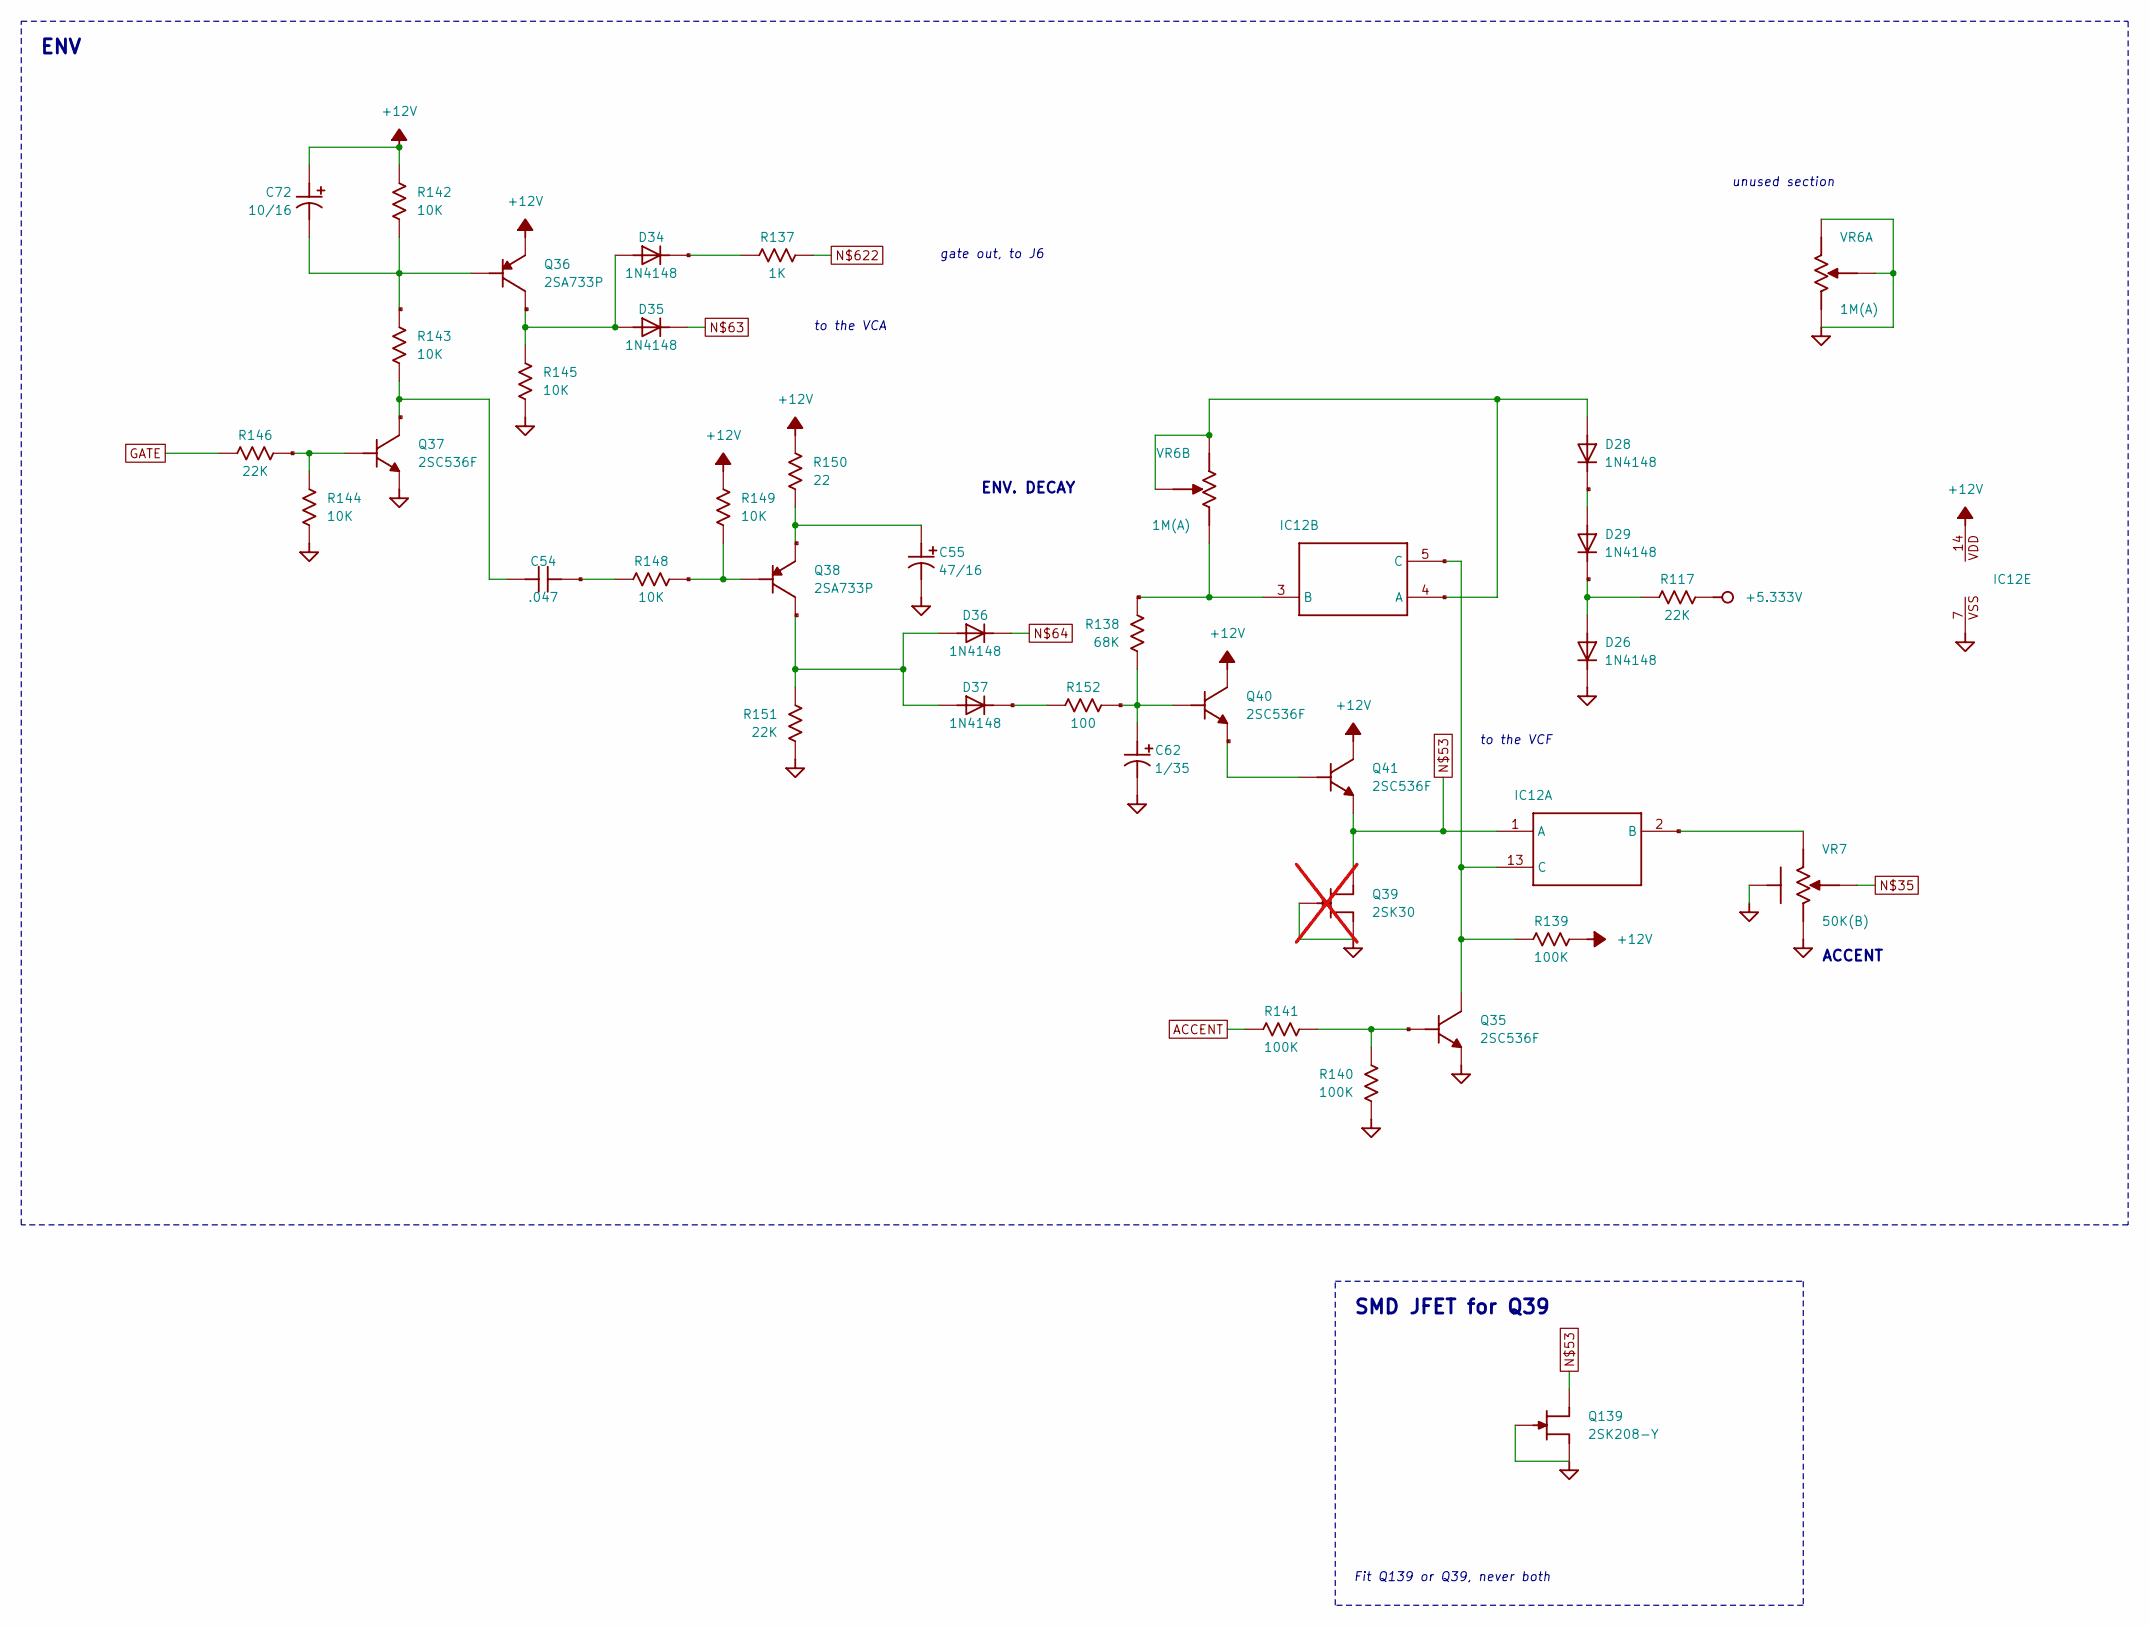
[picture p163: schematic p09_env.kicad_sch, Envelope]

Parts:
C54: .047; C050-055X075
C55: 47/16; E5-6
C62: 1/35; E2,5-7
C72: 10/16; E5-6
D26, D28, D29, D34, D35, D36, D37: 1N4148; DO35-10
IC12: 4066N; DIL14
Q35, Q37, Q40, Q41: 2SC536F
Q36, Q38: 2SA733P; TO92
Q39: 2SK30; not fitted
Q139: 2SK208-Y; SC-59_Hand
R117, R146, R151: 22K; 0207_5V
R137: 1K; 0207_10
R138: 68K; 0207_5V
R139, R140, R141: 100K; 0207_5V
R142, R143, R144, R145, R148, R149: 10K; 0207_5V
R150: 22; 0207_5V
R152: 100; 0207_5V
VR6: 1M(A); ALPHADUAL
VR7: 50K(B); EVU

Connections:
+5.333V: R117.1; also elsewhere on the board
+12V: C72.+, IC12.14 (VDD), Q36.3 (E), Q40.2 (C), Q41.2 (C), R139.2, R142.2, R149.2, R150.1; also elsewhere on the board
ACCENT: R141.2; also elsewhere on the board
GATE: R146.2; also elsewhere on the board
GND: C55.-, C62.-, D26.C, IC12.7 (VSS), Q35.3 (E), Q37.3 (E), Q39.2 (G), Q39.3 (S), Q139.1 (S), Q139.3 (G), R140.2, R144.2, R145.1, R151.1, VR6.1A (A), VR6.2A (S), VR6.3A (E), VR6.M1 (MT1), VR6.M2 (MT2), VR7.1 (A), VR7.M1, VR7.M2; also elsewhere on the board
unnamed 49: VR7.2 (S); also elsewhere on the board
unnamed: C55.+, Q38.3 (E), R150.2
unnamed: C72.-, Q36.1 (B), R142.1, R143.2
unnamed: D34.A, D35.A, Q36.2 (C), R145.2
unnamed: Q38.1 (B), R148.2, R149.1
unnamed: D37.C, R152.2
unnamed: C54.1, R148.1
unnamed: C54.2, Q37.2 (C), R143.1
unnamed: Q37.1 (B), R144.1, R146.1
unnamed: D36.A, D37.A, Q38.2 (C), R151.2
unnamed: C62.+, Q40.1 (B), R138.2, R152.1
unnamed: Q40.3 (E), Q41.1 (B)
unnamed: D26.A, D29.C, R117.2
unnamed: D28.C, D29.A
unnamed: D28.A, IC12.4 (A), VR6.2B (S1), VR6.3B (E1)
unnamed 66: IC12.1 (A), Q39.1 (D), Q41.3 (E), Q139.2 (D); also elsewhere on the board
unnamed: Q35.1 (B), R140.1, R141.1
unnamed: IC12.5 (C), IC12.13 (C), Q35.2 (C), R139.1
unnamed: D34.C, R137.1
unnamed 73: D35.C; also elsewhere on the board
unnamed 74: D36.C; also elsewhere on the board
unnamed: IC12.2 (B), VR7.3 (E)
unnamed: IC12.3 (B), R138.1, VR6.1B (A1)
unnamed 297: R137.2; also elsewhere on the board

Notes on the sheet:
ENV
gate out, to J6
to the VCA
ENV. DECAY
unused section
to the VCF
ACCENT
SMD JFET for Q39
Fit Q139 or Q39, never both

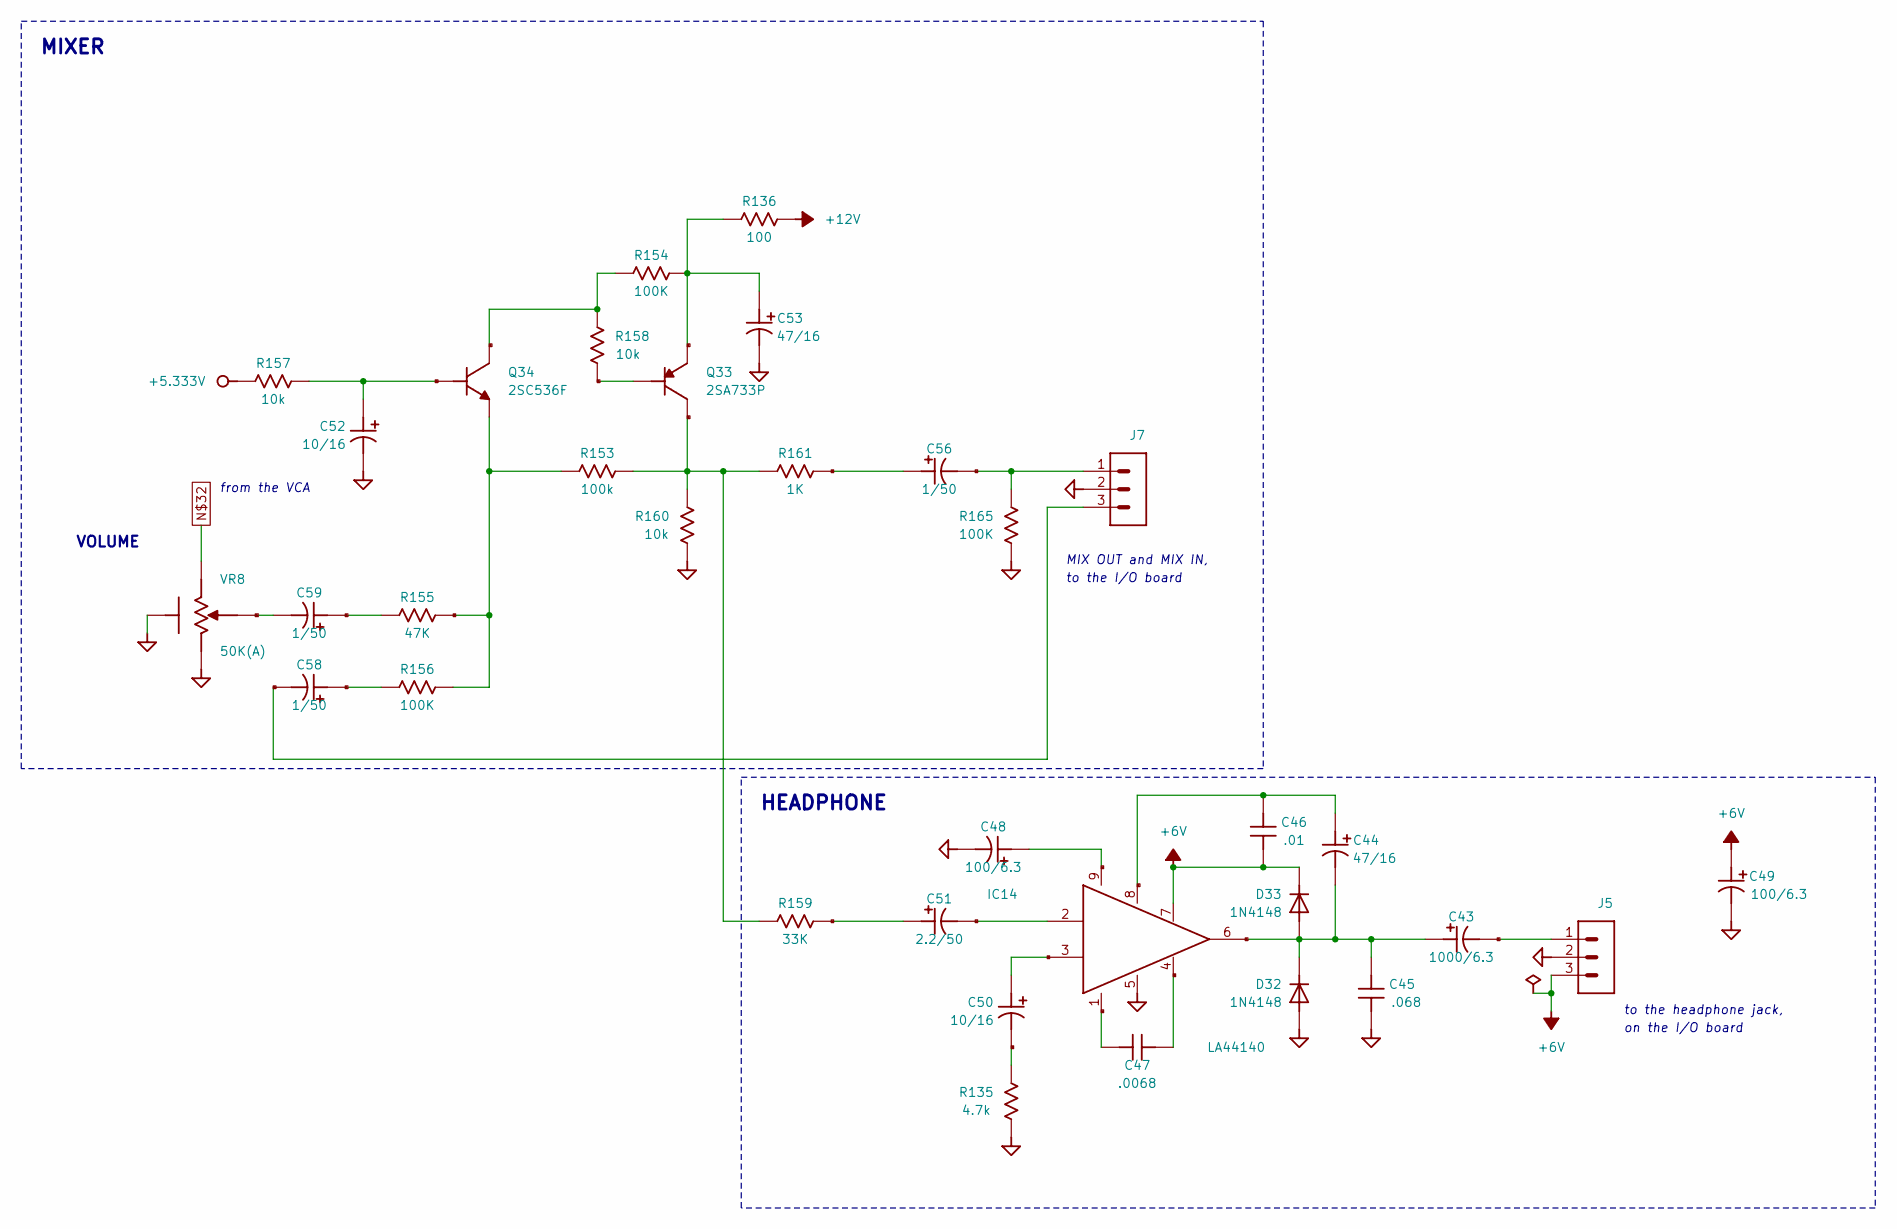
[picture p164: schematic p10_mixer.kicad_sch, Mixer and headphone]

Parts:
C43: 1000/6.3; E5-5
C44, C53: 47/16; E5-6
C45: .068; C050-050X075
C46: .01; C050-024X044
C47: .0068; C050-075X075
C48, C49: 100/6.3; E5-6
C50, C52: 10/16; E5-6
C51: 2.2/50; E5-6
C56, C58, C59: 1/50; E5-6
D32, D33: 1N4148; DO35-10
IC14: LA44140; SIP9
J5, J7: MA03-''; MA03-1
Q33: 2SA733P; TO92
Q34: 2SC536F
R135: 4.7k; 0207_5V
R136: 100; 0207_5V
R153: 100k; 0207_5V
R154, R156, R165: 100K; 0207_5V
R155: 47K; 0207_5V
R157, R158, R160: 10k; 0207_5V
R159: 33K; 0207_5V
R161: 1K; 0207_5V
VR8: 50K(A); EVU

Connections:
+5.333V: R157.2; also elsewhere on the board
+6V: C46.1, C49.+, D33.C, IC14.7, J5.3
+12V: R136.1; also elsewhere on the board
C48: C48.+, IC14.9
GND: C45.2, C48.-, C49.-, C52.-, C53.-, D32.A, IC14.5, J5.2, J7.2, R135.1, R160.1, R165.2, VR8.1 (A), VR8.M1, VR8.M2; also elsewhere on the board
unnamed: C51.-, IC14.2
unnamed: C51.+, R159.1
unnamed: C50.+, IC14.3
unnamed: C50.-, R135.2
unnamed: Q34.3 (E), R153.1, R155.2, R156.1
unnamed: C56.+, R161.1
unnamed: C56.-, J7.1, R165.1
unnamed: C47.1, IC14.4
unnamed: C47.2, IC14.1
unnamed: C43.-, J5.1
unnamed: C43.+, C44.-, C45.1, D32.C, D33.A, IC14.6
unnamed: Q33.2 (C), R153.2, R159.2, R160.2, R161.2
unnamed: C44.+, C46.2, IC14.8
unnamed: Q34.2 (C), R154.1, R158.1
unnamed: Q33.1 (B), R158.2
unnamed: C53.+, Q33.3 (E), R136.2, R154.2
unnamed: C52.+, Q34.1 (B), R157.1
unnamed: C59.+, R155.1
unnamed: C58.+, R156.2
unnamed: C58.-, J7.3
unnamed 46: VR8.3 (E); also elsewhere on the board
unnamed: C59.-, VR8.2 (S)

Notes on the sheet:
MIXER
HEADPHONE
from the VCA
VOLUME
MIX OUT and MIX IN,
to the I/O board
to the headphone jack,
on the I/O board

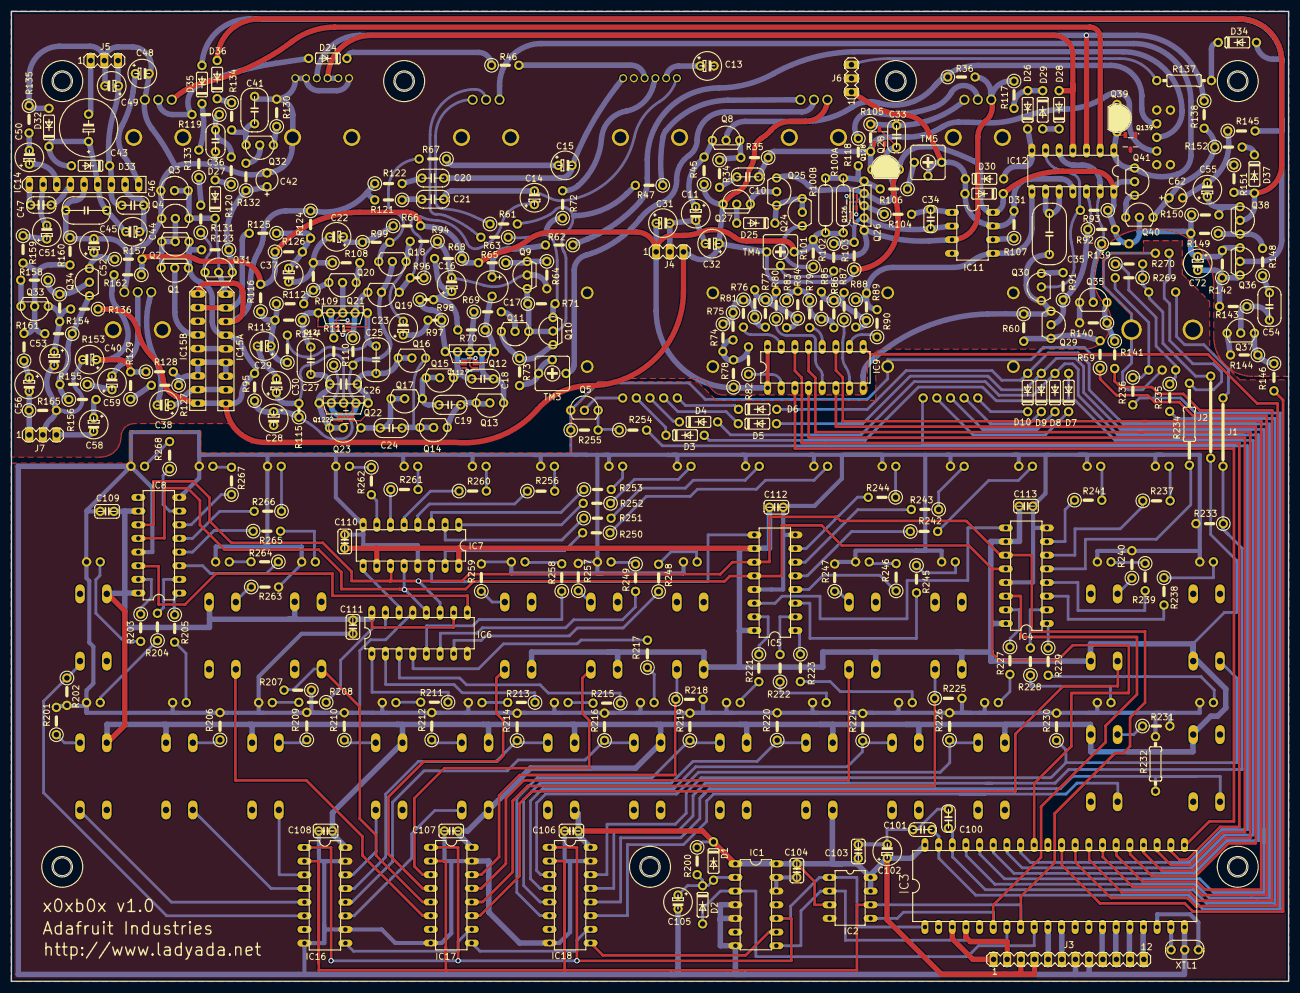
[picture p165: board mainboard.kicad_pcb from above]

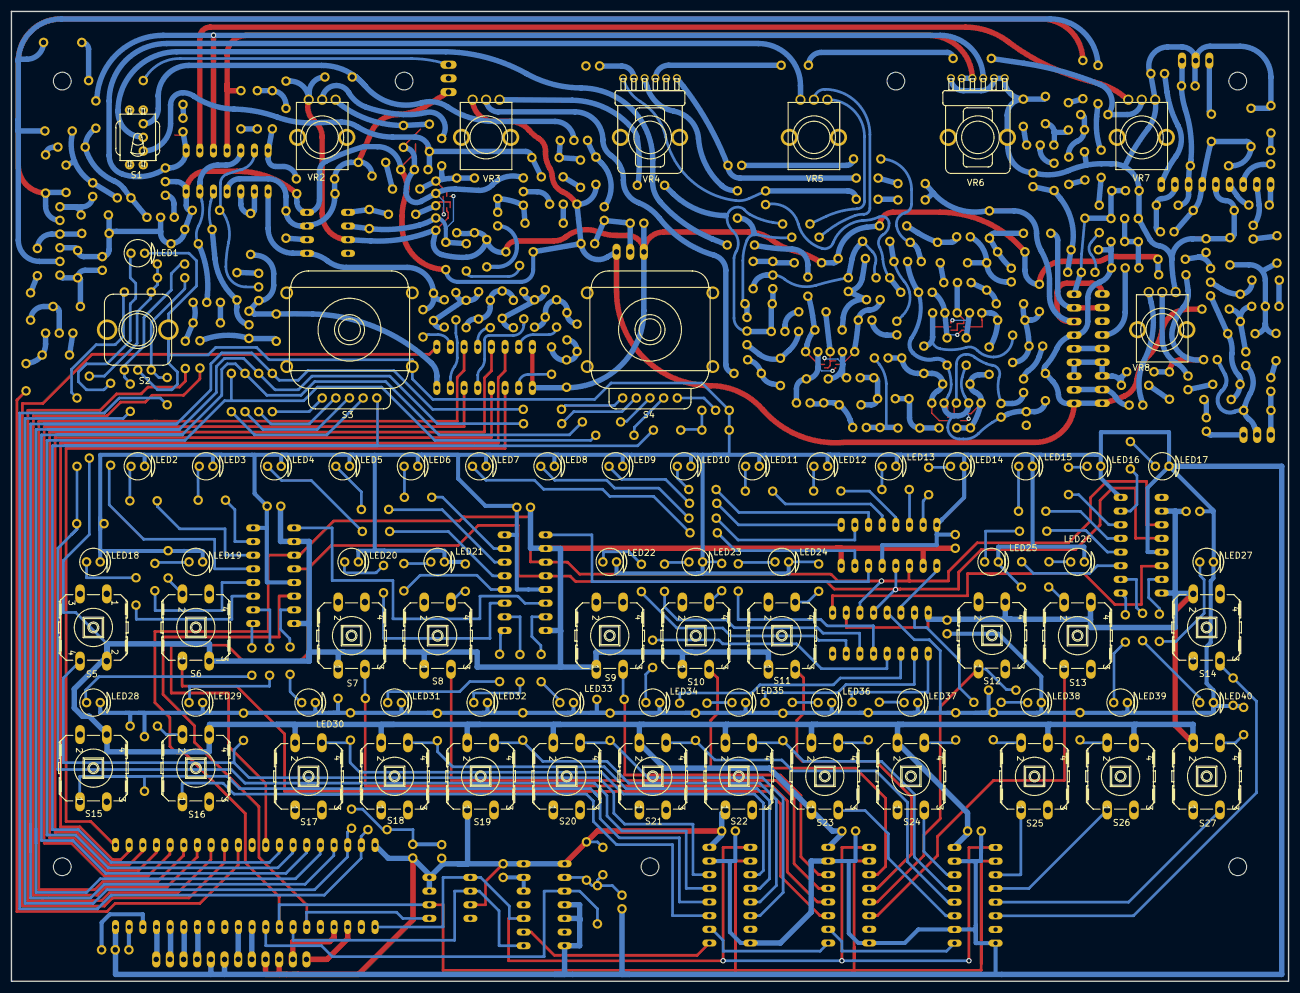
[picture p166: board mainboard.kicad_pcb from below]

Board: 2 copper layers, 237.5 x 180.3 mm, 423 parts (74 on the bottom side), 324 nets.
