cozycactus/x0xb0x-hardware/kicad-working/ioboard/ioboard.kicad_pcb

## KiCad design kicad-working/ioboard/ioboard.kicad_pcb (2026-11-04)

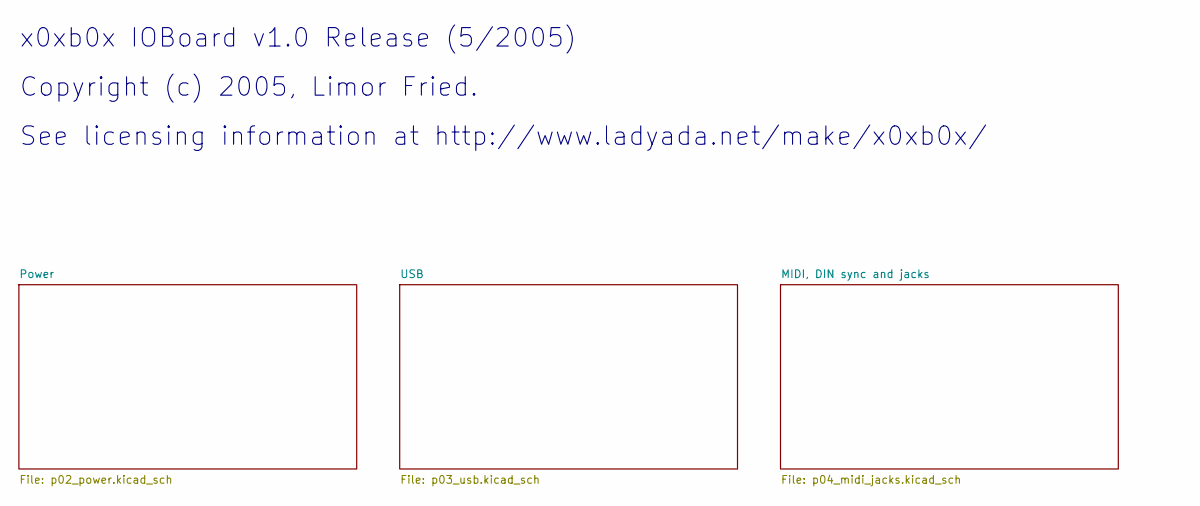
[picture p167: schematic ioboard.kicad_sch, x0xb0x I/O board]

Notes on the sheet:
x0xb0x IOBoard v1.0 Release (5/2005)
Copyright (c) 2005, Limor Fried.
See licensing information at http://www.ladyada.net/make/x0xb0x/

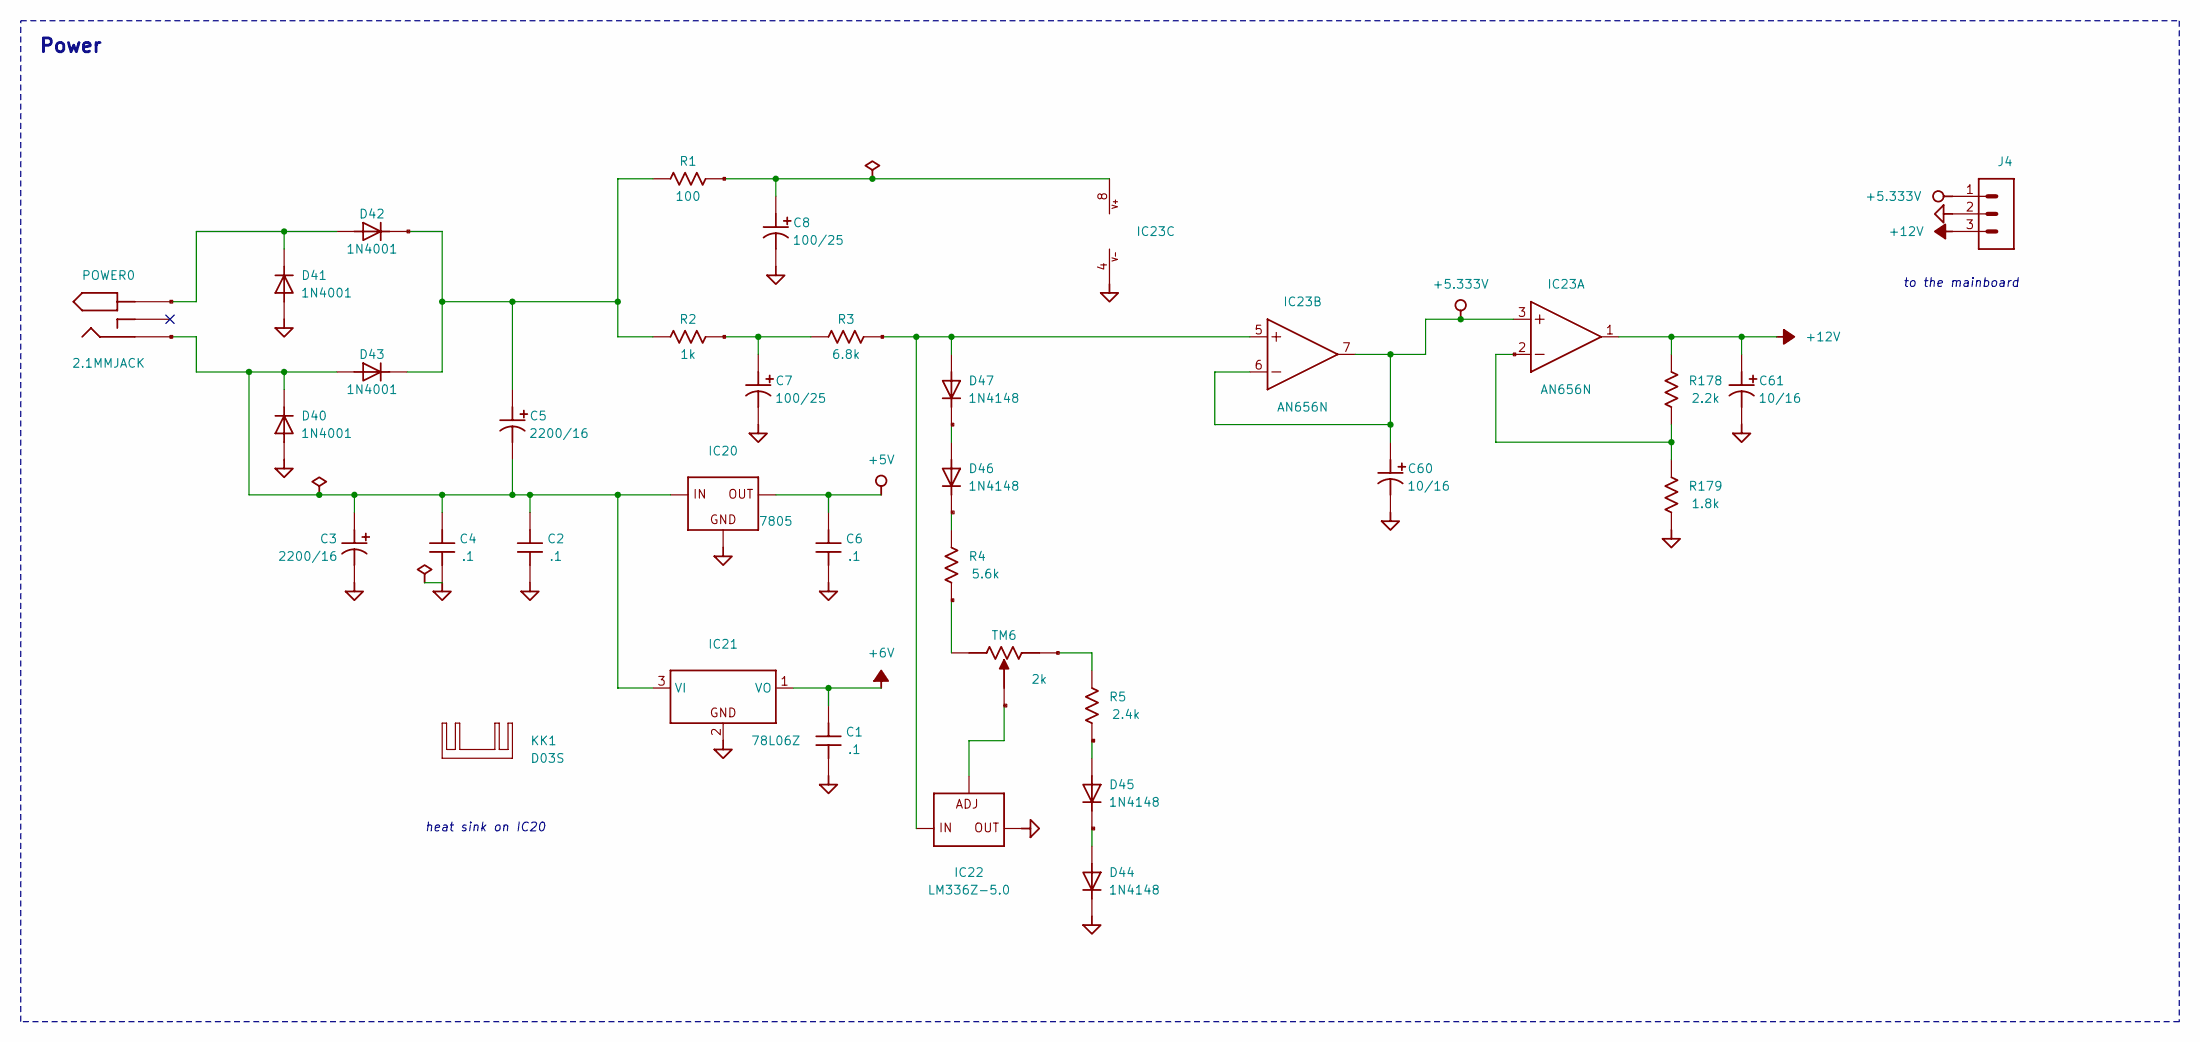
[picture p168: schematic p02_power.kicad_sch, Power]

Parts:
C1, C2, C4, C6: .1; C050H075X075
C3, C5: 2200/16; E5-13
C7, C8: 100/25; E5-6
C60, C61: 10/16; E5-6
D40, D41, D42, D43: 1N4001; DO41-10
D44, D45, D46, D47: 1N4148; DO35-10
IC20: 7805; 78XXS
IC21: 78L06Z; TO-92_x0x
IC22: LM336Z-5.0; TO-92_x0x
IC23: AN656N; DIL08
J4: MA03-''; MA03-1
KK1: D03S
POWER0: 2.1MMJACK; PJ-202AH
R1: 100; 0207_5V
R2: 1k; 0207_5V
R3: 6.8k; 0207_5V
R4: 5.6k; 0207_5V
R5: 2.4k; 0207_5V
R178: 2.2k; 0207_5V
R179: 1.8k; 0207_5V
TM6: 2k; 306

Connections:
+5.333V: C60.+, IC23.3 (+IN), IC23.6 (-IN), IC23.7 (OUT), J4.1
+5V: C6.1, IC20.OUT; also elsewhere on the board
+6V: C1.1, IC21.1 (VO); also elsewhere on the board
+12V: C61.+, IC23.1 (OUT), J4.3, R178.1
GND: C1.2, C2.2, C3.-, C4.2, C6.2, C7.-, C8.-, C60.-, C61.-, D40.A, D41.A, D44.C, IC20.GND, IC21.2 (GND), IC22.3 (A), IC23.4 (V-), J4.2, R179.2; also elsewhere on the board
unnamed: C8.+, IC23.8 (V+), R1.1
unnamed: D47.A, IC22.2 (K), IC23.5 (+IN), R3.2
unnamed: IC23.2 (-IN), R178.2, R179.1
unnamed: C7.+, R2.2, R3.1
unnamed: R4.1, TM6.3 (E)
unnamed: R5.2, TM6.1 (A)
unnamed: D46.A, D47.C
unnamed: D46.C, R4.2
unnamed: D45.A, R5.1
unnamed: D44.A, D45.C
unnamed: IC22.1 (ADJ), TM6.2 (S)
unnamed: D41.C, D42.A, POWER0.P$1
unnamed: C5.+, D42.C, D43.C, R1.2, R2.1
unnamed: C2.1, C3.+, C4.1, C5.-, D40.C, D43.A, IC20.IN, IC21.3 (VI), POWER0.P$2

Notes on the sheet:
Power
heat sink on IC20
to the mainboard

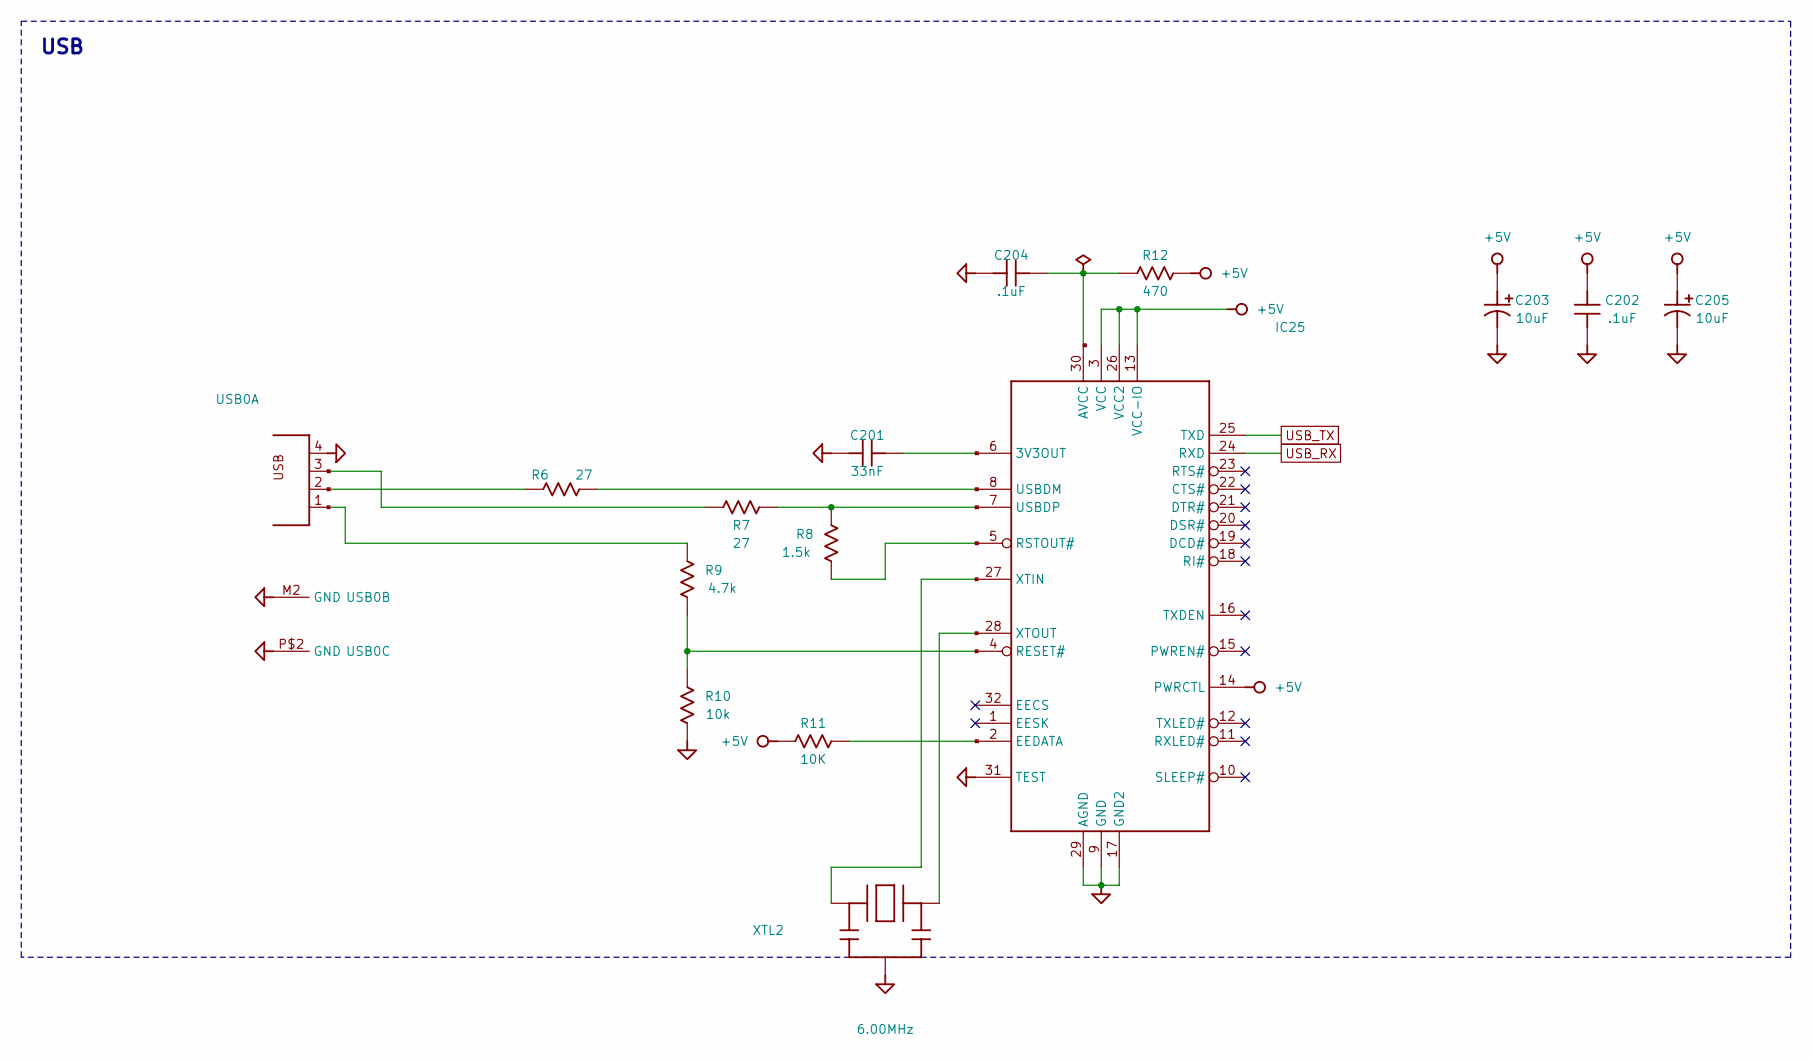
[picture p169: schematic p03_usb.kicad_sch, USB]

Parts:
C201: 33nF; C050-025X075
C202, C204: .1uF; C050H075X075
C203, C205: 10uF; E5-6
IC25: FT232; SQFP-S-7X7-32
R6, R7: 27; 0207_5V
R8: 1.5k; 0207_5V
R9: 4.7k; 0207_5V
R10: 10k; 0207_5V
R11: 10K; 0207_5V
R12: 470; 0207_5V
USB0: ACON_TYPEB''; PN61729
XTL2: 6.00MHz; Resonator_6MHz_x0x

Connections:
+5V: C202.1, C203.+, C205.+, IC25.3 (VCC), IC25.13 (VCC-IO), IC25.14 (PWRCTL), IC25.26 (VCC2), R11.2, R12.1; also elsewhere on the board
GND: C201.2, C202.2, C203.-, C204.2, C205.-, IC25.9 (GND), IC25.17 (GND2), IC25.29 (AGND), IC25.31 (TEST), R10.1, USB0.4, USB0.M2 (GND), USB0.P$2 (GND), XTL2.P$2 (GND); also elsewhere on the board
unnamed: R9.1, USB0.1
unnamed: IC25.27 (XTIN), XTL2.P$1 (IN)
unnamed: IC25.28 (XTOUT), XTL2.P$3 (OUT)
unnamed: IC25.4 (RESET#), R9.2, R10.2
unnamed: R6.2, USB0.2
unnamed: R7.1, USB0.3
unnamed: IC25.7 (USBDP), R7.2, R8.2
unnamed: IC25.8 (USBDM), R6.1
unnamed: IC25.5 (RSTOUT#), R8.1
unnamed: C201.1, IC25.6 (3V3OUT)
unnamed: C204.1, IC25.30 (AVCC), R12.2
unnamed: IC25.2 (EEDATA), R11.1
USB_RX: IC25.24 (RXD); also elsewhere on the board
USB_TX: IC25.25 (TXD); also elsewhere on the board

Notes on the sheet:
USB
