cozycactus/x0xb0x-hardware/kicad-working/ioboard/ioboard.kicad_pcb

## KiCad design kicad-working/ioboard/ioboard.kicad_pcb (continued)

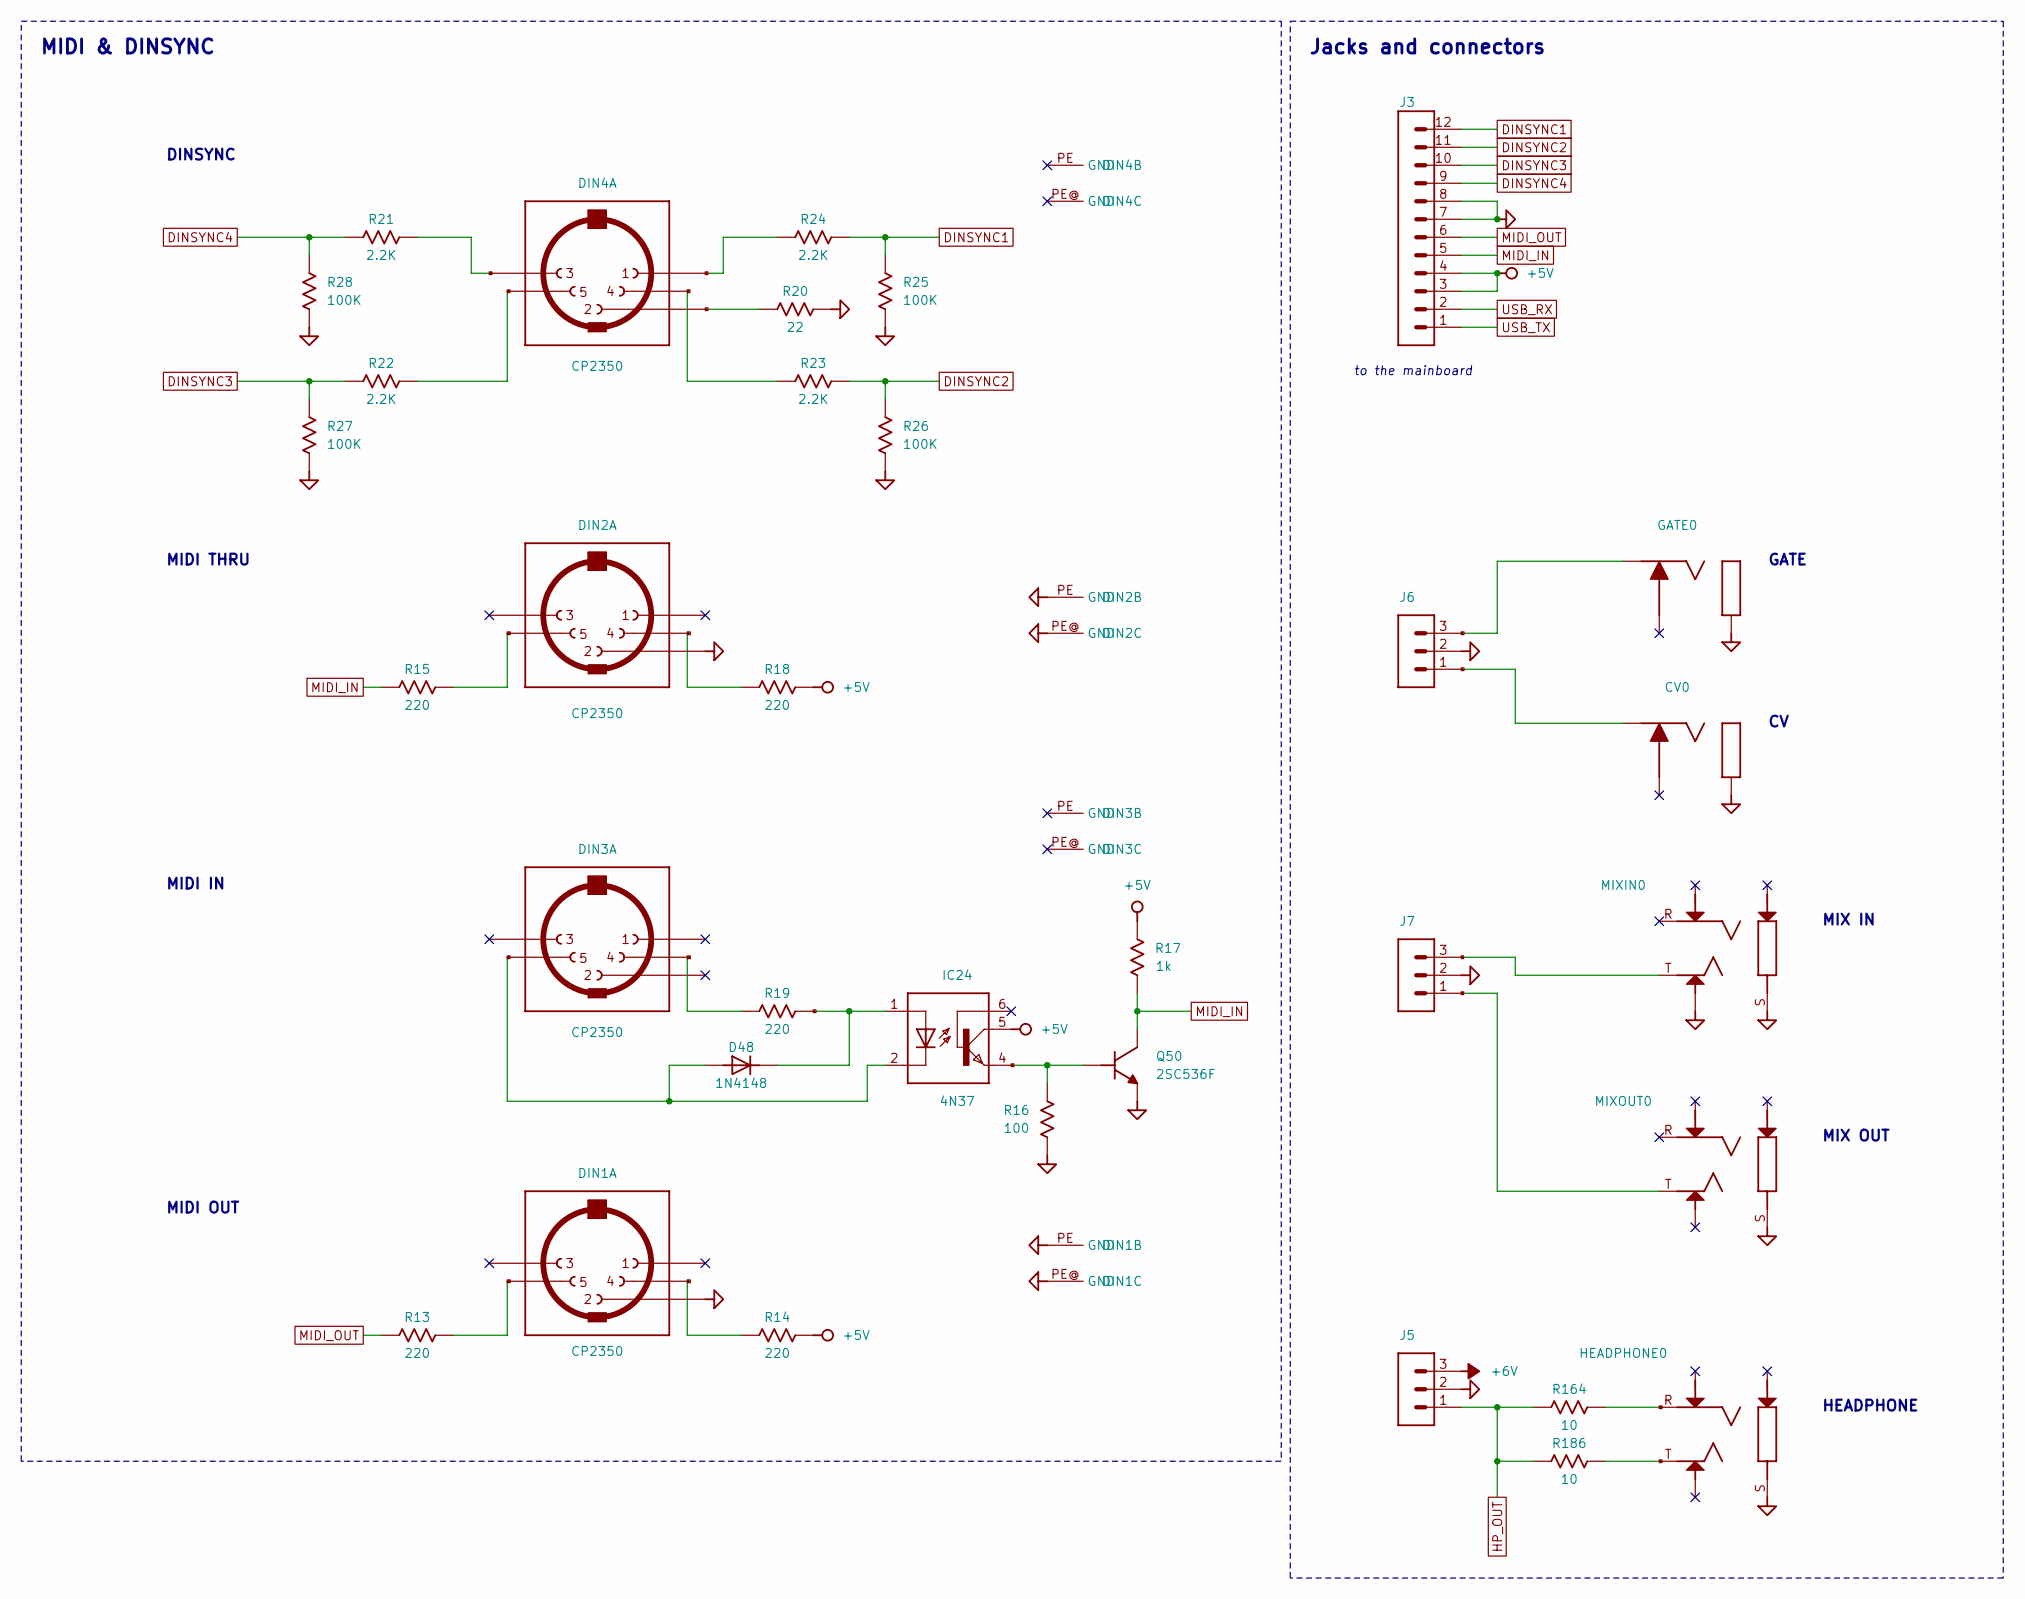
[picture p170: schematic p04_midi_jacks.kicad_sch, MIDI, DIN sync and jacks]

Parts:
CV0: MONO_CC; MJ-3536N
D48: 1N4148; DO35-10
DIN1, DIN2, DIN3, DIN4: CP2350; CP-2350
GATE0: MONO_CC; MJ-3536N
HEADPHONE0: NEUTRIX_STEREO; REAN_1_4STERO
IC24: 4N37; DIL06
J3: MA12-''; MA12-1
J5, J6, J7: MA03-''; MA03-1
MIXIN0: NEUTRIX_STEREO; REAN_1_4STERO
MIXOUT0: NEUTRIX_STEREO; REAN_1_4STERO
Q50: 2SC536F
R13, R14, R15, R18, R19: 220; 0207_5V
R16: 100; 0207_5V
R17: 1k; 0207_5V
R20: 22; 0207_5V
R21, R22, R23, R24: 2.2K; 0207_5V
R25, R26, R27, R28: 100K; 0207_5V
R164, R186: 10; 0207_5V

Connections:
+5V: IC24.5 (COL), J3.3, J3.4, R14.2, R17.2, R18.2; also elsewhere on the board
+6V: J5.3; also elsewhere on the board
DINSYNC1: J3.12, R24.1, R25.2
DINSYNC2: J3.11, R23.2, R26.1
DINSYNC3: J3.10, R22.1, R27.1
DINSYNC4: J3.9, R21.2, R28.2
GND: CV0.SLEEVE, DIN1.2, DIN1.PE (GND), DIN1.PE@ (GND), DIN2.2, DIN2.PE (GND), DIN2.PE@ (GND), GATE0.SLEEVE, HEADPHONE0.S, J3.7, J3.8, J5.2, J6.2, J7.2, MIXIN0.S, MIXIN0.TN, MIXOUT0.S, Q50.3 (E), R16.1, R20.2, R25.1, R26.2, R27.2, R28.1; also elsewhere on the board
HP_OUT: J5.1, R164.1, R186.1
MIDI_IN: J3.5, Q50.2 (C), R15.2, R17.1
MIDI_OUT: J3.6, R13.1
unnamed: J7.1, MIXOUT0.T
unnamed: J7.3, MIXIN0.T
unnamed: IC24.4 (EMI), Q50.1 (B), R16.2
unnamed: DIN4.3, R21.1
unnamed: DIN4.5, R22.2
unnamed: DIN4.1, R24.2
unnamed: DIN4.4, R23.1
unnamed: GATE0.TIP, J6.3
unnamed: CV0.TIP, J6.1
unnamed: HEADPHONE0.R, R164.2
unnamed: HEADPHONE0.T, R186.2
unnamed: DIN4.2, R20.1
unnamed: D48.A, DIN3.5, IC24.2 (C)
unnamed: D48.C, IC24.1 (A), R19.2
unnamed: DIN3.4, R19.1
unnamed: DIN2.5, R15.1
unnamed: DIN2.4, R18.1
unnamed: DIN1.5, R13.2
unnamed: DIN1.4, R14.1
USB_RX: J3.2; also elsewhere on the board
USB_TX: J3.1; also elsewhere on the board

Notes on the sheet:
MIDI & DINSYNC
Jacks and connectors
DINSYNC
MIDI THRU
MIDI IN
MIDI OUT
to the mainboard
GATE
MIX IN
MIX OUT
HEADPHONE

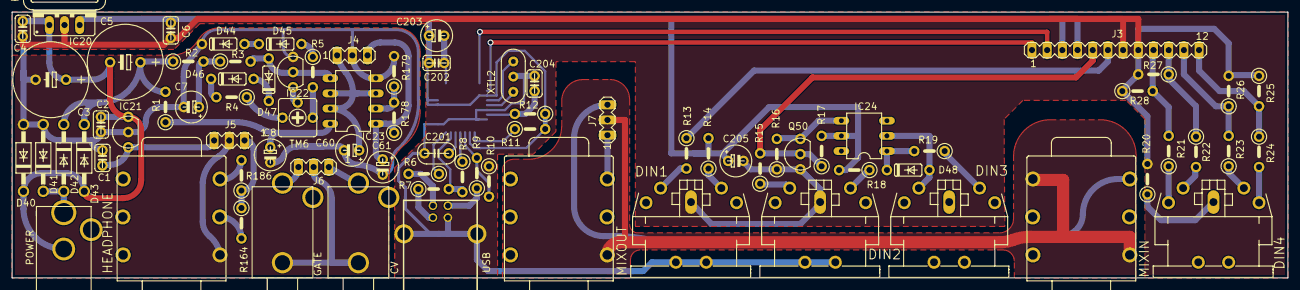
[picture p171: board ioboard.kicad_pcb from above]

Board: 2 copper layers, 213.4 x 44.5 mm, 82 parts (1 on the bottom side), 59 nets.
