cozycactus/x0xb0x-hardware/kicad-working/schematic-redraw/ioboard_sheets.py

#!/usr/bin/env python3
# SPDX-License-Identifier: CC0-1.0
"""The I/O board's sheets, in the same way as mainboard_sheets.py."""

DIN, JACK, MONO, HDR3, BUFFER = "CP235''", "NEUTRIX_STEREO''", "MONO_CC''", "MA03-''", 'AN656N_POWER_BUFFER'


def draw_power(d):
    d.dx, d.dy = 30.48, 20.32
    d.block('Power', 17.78, 7.62, 330.0, 152.4)

    # The 9 V AC input, its doubler and the raw supplies.
    d.chip('POWER0', "2.1MMJACK''", 1, 30.48, 50.8, ref_at=(30.48, 44.45), val_at=(30.48, 57.15))
    d.nc('POWER0.P$3')
    d.route('POWER0.P$1', (43.18, 48.26), (43.18, 38.1), (63.5, 38.1))
    d.down('D41', 55.88, 45.72, 'C')
    d.route((55.88, 38.1), 'D41.C')
    d.ground('D41.A')
    d.across('D42', 68.58, 38.1, 'A')
    d.route('POWER0.P$2', (43.18, 53.34), (43.18, 58.42), (63.5, 58.42))
    d.down('D40', 55.88, 66.04, 'C')
    d.route((55.88, 58.42), 'D40.C')
    d.ground('D40.A')
    d.across('D43', 68.58, 58.42, 'A')
    d.route('D42.C', (78.74, 38.1), (78.74, 58.42), 'D43.C')
    d.route((78.74, 48.26), (104.14, 48.26))
    d.route((50.8, 58.42), (50.8, 76.2), (111.76, 76.2))
    d.down('C5', 88.9, 66.04, '+')
    d.route((88.9, 48.26), 'C5.+')
    d.route('C5.-', (88.9, 76.2))
    d.down('C3', 66.04, 83.82, '+', left_text=True)
    d.route((66.04, 76.2), 'C3.+')
    d.ground('C3.-')
    d.down('C4', 78.74, 83.82, '1')
    d.route((78.74, 76.2), 'C4.1')
    d.ground('C4.2')
    d.down('C2', 91.44, 83.82, '1')
    d.route((91.44, 76.2), 'C2.1')
    d.ground('C2.2')

    # The regulators: +5 V for the logic and +6 V for the headphone amplifier.
    d.chip('IC20', "78XXS''", 1, 119.38, 76.2, ref_at=(119.38, 69.85), val_at=(127.0, 80.01))
    d.route((111.76, 76.2), 'IC20.IN')
    d.ground('IC20.GND')
    d.route('IC20.OUT', (142.24, 76.2))
    d.rail('+5V', (142.24, 76.2), 'T')
    d.down('C6', 134.62, 83.82, '1')
    d.route((134.62, 76.2), 'C6.1')
    d.ground('C6.2')
    d.chip('KK1', "D03S''", 1, 83.82, 114.3, ref_at=(91.44, 111.76), val_at=(91.44, 114.3), just='left')
    d.note('heat sink on IC20', 76.2, 124.46)
    d.chip('IC21', '78Z', 1, 119.38, 104.14, ref_at=(119.38, 97.79), val_at=(127.0, 111.76))
    d.route((104.14, 76.2), (104.14, 104.14), 'IC21.3')
    d.ground('IC21.2')
    d.route('IC21.1', (142.24, 104.14))
    d.rail('+6V', (142.24, 104.14), 'T')
    d.down('C1', 134.62, 111.76, '1')
    d.route((134.62, 104.14), 'C1.1')
    d.ground('C1.2')

    # The analog supply: filtered by R1 and R2, and referred to the LM336.
    d.route((104.14, 48.26), (104.14, 30.48))
    d.across('R1', 114.3, 30.48, '2')
    d.route((104.14, 30.48), 'R1.2')
    d.route('R1.1', (175.26, 30.48))
    d.down('C8', 127, 38.1, '+')
    d.route((127, 30.48), 'C8.+')
    d.ground('C8.-')
    d.across('R2', 114.3, 53.34, '1')
    d.route((104.14, 48.26), (104.14, 53.34), 'R2.1')
    d.down('C7', 124.46, 60.96, '+', left_text=False)
    d.route('R2.2', (124.46, 53.34), 'C7.+')
    d.ground('C7.-')
    d.across('R3', 137.16, 53.34, '1')
    d.route((124.46, 53.34), 'R3.1')
    d.route('R3.2', (195.58, 53.34))

    # The 5.333 V reference, adjusted by TM6.
    d.down('D47', 152.4, 60.96, 'A')
    d.route((152.4, 53.34), 'D47.A')
    d.down('D46', 152.4, 73.66, 'A')
    d.route('D47.C', 'D46.A')
    d.down('R4', 152.4, 86.36, '2')
    d.route('D46.C', 'R4.2')
    d.route('R4.1', (152.4, 99.06))
    d.trim('TM6', 160.02, 99.06)
    d.route((152.4, 99.06), 'TM6.3')
    d.route('TM6.1', (172.72, 99.06))
    d.down('R5', 172.72, 106.68, '2')
    d.route((172.72, 99.06), 'R5.2')
    d.down('D45', 172.72, 119.38, 'A')
    d.route('R5.1', 'D45.A')
    d.down('D44', 172.72, 132.08, 'A')
    d.route('D45.C', 'D44.A')
    d.ground('D44.C')
    d.chip('IC22', 'LM336Z-5.0', 1, 154.94, 124.46, ref_at=(154.94, 130.81), val_at=(154.94, 133.35))
    d.route((147.32, 53.34), (147.32, 124.46), 'IC22.2')
    d.ground('IC22.3', 'R')
    d.route('IC22.1', (154.94, 111.76), (160.02, 111.76), 'TM6.2')

    # The two op-amps: a buffer for +5.333 V, and +12 V from it through R178 and R179.
    d.chip('IC23', BUFFER, 3, 175.26, 38.1, ref_at=(179.07, 38.1), hide_value=True, just='left')
    d.ground('IC23.4')
    d.chip('IC23', BUFFER, 2, 203.2, 55.88, ref_at=(203.2, 48.26), val_at=(203.2, 63.5))
    d.route((195.58, 53.34), 'IC23.5')
    d.route('IC23.6', (190.5, 58.42), (190.5, 66.04), (215.9, 66.04), (215.9, 55.88))
    d.route('IC23.7', (220.98, 55.88), (220.98, 50.8))
    d.down('C60', 215.9, 73.66, '+')
    d.route((215.9, 66.04), 'C60.+')
    d.ground('C60.-')
    d.chip('IC23', BUFFER, 1, 241.3, 53.34, ref_at=(241.3, 45.72), val_at=(241.3, 60.96))
    d.route((220.98, 50.8), 'IC23.3')
    d.rail('+5.333V', (226.06, 50.8), 'T')
    d.route('IC23.1', (266.7, 53.34))
    d.down('R178', 256.54, 60.96, '1')
    d.route((256.54, 53.34), 'R178.1')
    d.down('R179', 256.54, 76.2, '1')
    d.route('R178.2', (256.54, 68.58), 'R179.1')
    d.ground('R179.2')
    d.route('IC23.2', (231.14, 55.88), (231.14, 68.58), (256.54, 68.58))
    d.down('C61', 266.7, 60.96, '+')
    d.route((266.7, 53.34), 'C61.+')
    d.ground('C61.-')
    d.route((266.7, 53.34), (271.78, 53.34))
    d.rail('+12V', (271.78, 53.34), 'R')

    # The supply to the mainboard.
    d.chip('J4', HDR3, 1, 304.8, 35.56, 180, ref_at=(304.8, 28.0), hide_value=True)
    d.rail('+5.333V', 'J4.1', 'L')
    d.ground('J4.2', 'L')
    d.rail('+12V', 'J4.3', 'L')
    d.note('to the mainboard', 290.0, 45.72)
    # GND is the board's reference here, not driven by a part.
    d.route('C4.2', (76.2, 88.9))
    d.flag((76.2, 88.9))
    # These nets are fed through a part the checks can't see as a supply: a diode or a resistor.
    d.flag((60.96, 76.2))
    d.flag((140.0 + 0.97, 30.48))


def draw_usb(d):
    d.dx, d.dy = 25.4, 25.4
    d.block('USB', 20.32, 33.02, 270.0, 165.1)
    d.chip('USB0', "ACON_TYPEB''", 1, 60.96, 96.52, 180, ref_at=(50.8, 86.36), hide_value=True)
    d.chip('USB0', "ACON_TYPEB''", 2, 60.96, 114.3, ref_at=(66.04, 114.3), hide_value=True, just='left')
    d.chip('USB0', "ACON_TYPEB''", 3, 60.96, 121.92, ref_at=(66.04, 121.92), hide_value=True, just='left')
    d.ground('USB0.M2', 'L')
    d.ground('USB0.P$2', 'L')
    d.ground('USB0.4', 'R')
    d.chip('IC25', "FT232''", 1, 190.5, 116.84, ref_at=(199.39, 76.2), val_at=(182.88, 158.75), hide_value=True)
    d.across('R6', 96.52, 99.06, '2', compact=True)
    d.route('USB0.2', 'R6.2')
    d.route('R6.1', 'IC25.8')
    d.across('R7', 121.92, 101.6, '1', flip_text=True)
    d.route('USB0.3', (71.12, 96.52), (71.12, 101.6), 'R7.1')
    d.route('R7.2', 'IC25.7')
    d.down('R8', 134.62, 106.68, '2', left_text=True)
    d.route('R8.1', (142.24, 111.76), (142.24, 106.68), 'IC25.5')
    # VBUS through R9 and R10 to RESET#, so the chip resets with the USB cable.
    d.route('USB0.1', (66.04, 101.6), (66.04, 106.68), (114.3, 106.68))
    d.down('R9', 114.3, 111.76, '1')
    d.route('R9.2', (114.3, 121.92), 'IC25.4')
    d.down('R10', 114.3, 129.54, '2')
    d.route((114.3, 121.92), 'R10.2')
    d.ground('R10.1')
    # The resonator.
    d.chip('XTL2', "ZTT''", 1, 152.4, 162.56, ref_at=(125.73, 161.29), val_at=(142.24, 175.26))
    d.route('IC25.27', (147.32, 111.76), (147.32, 152.4), (134.62, 152.4), 'XTL2.P$1')
    d.route('IC25.28', (149.86, 119.38), 'XTL2.P$3')
    d.ground('XTL2.P$2')
    # Pull-up and the unused lines.
    d.across('R11', 132.08, 134.62, '2')
    d.route('R11.1', 'IC25.2')
    d.rail('+5V', 'R11.2', 'L')
    d.ground('IC25.31', 'L')
    d.nc('IC25.32')
    d.nc('IC25.1')
    d.across('C201', 139.7, 93.98, '2')
    d.route('C201.1', 'IC25.6')
    d.ground('C201.2', 'L')
    for pin_no in (23, 22, 21, 20, 19, 18, 16, 15, 12, 11, 10):
        d.nc(f'IC25.{pin_no}')
    d.out('IC25.25', 'USB_TX', 'R', 5.08)
    d.out('IC25.24', 'USB_RX', 'R', 5.08)
    d.rail('+5V', 'IC25.14', 'R')
    # Its supplies, with AVCC filtered by R12 and C204.
    d.route('IC25.3', (172.72, 73.66), (190.5, 73.66))
    d.route('IC25.26', (175.26, 73.66))
    d.route('IC25.13', (177.8, 73.66))
    d.rail('+5V', (190.5, 73.66), 'R')
    d.route('IC25.30', (170.18, 68.58))
    d.across('R12', 180.34, 68.58, '2')
    d.route((170.18, 68.58), 'R12.2')
    d.rail('+5V', 'R12.1', 'R')
    d.across('C204', 160.02, 68.58, '2')
    d.route('C204.1', (170.18, 68.58))
    d.ground('C204.2', 'L')
    d.flag((170.18, 68.58))
    d.route('IC25.29', (170.18, 154.94), (175.26, 154.94), 'IC25.17')
    d.route('IC25.9', (172.72, 154.94))
    d.ground((172.72, 154.94))
    for ref, x, top, low in (('C203', 228.6, '+', '-'), ('C202', 241.3, '1', '2'), ('C205', 254, '+', '-')):
        d.down(ref, x, 73.66, top)
        d.rail('+5V', f'{ref}.{top}')
        d.ground(f'{ref}.{low}')


def draw_midi(d):
    d.dx, d.dy = 25.4, 10.16
    d.block('MIDI & DINSYNC', 20.32, 20.32, 198.12, 223.52)
    d.block('Jacks and connectors', 199.39, 20.32, 300.0, 240.0)

    def shield(ref, x, y, grounded=True):
        d.chip(ref, DIN, 2, x, y, ref_at=(x + 2.54, y), hide_value=True, just='left')
        d.chip(ref, DIN, 3, x, y + 5.08, ref_at=(x + 2.54, y + 5.08), hide_value=True, just='left')
        if grounded:
            d.ground(f'{ref}.PE', 'L')
            d.ground(f'{ref}.PE@', 'L')
        else:
            d.nc(f'{ref}.PE')
            d.nc(f'{ref}.PE@')

    # DIN sync.
    d.caption('DINSYNC', 40.64, 39.37)
    d.chip('DIN4', DIN, 1, 101.6, 55.88, ref_at=(101.6, 43.18), val_at=(101.6, 69.0))
    shield('DIN4', 170.18, 40.64, grounded=False)
    d.across('R21', 71.12, 50.8, '2')
    d.route('DIN4.3', (83.82, 55.88), (83.82, 50.8), 'R21.1')
    d.down('R28', 60.96, 58.42, '2')
    d.route('R21.2', (60.96, 50.8), 'R28.2')
    d.ground('R28.1')
    d.route((60.96, 50.8), (50.8, 50.8))
    d.label('DINSYNC4', (50.8, 50.8), 'L')
    d.across('R22', 71.12, 71.12, '1')
    d.route('DIN4.5', (88.9, 71.12), 'R22.2')
    d.down('R27', 60.96, 78.74, '1')
    d.route('R22.1', (60.96, 71.12), 'R27.1')
    d.ground('R27.2')
    d.route((60.96, 71.12), (50.8, 71.12))
    d.label('DINSYNC3', (50.8, 71.12), 'L')
    d.across('R24', 132.08, 50.8, '2')
    d.route('DIN4.1', (119.38, 55.88), (119.38, 50.8), 'R24.2')
    d.down('R25', 142.24, 58.42, '2')
    d.route('R24.1', (142.24, 50.8), 'R25.2')
    d.ground('R25.1')
    d.route((142.24, 50.8), (149.86, 50.8))
    d.label('DINSYNC1', (149.86, 50.8), 'R')
    d.across('R23', 132.08, 71.12, '1')
    d.route('DIN4.4', (114.3, 71.12), 'R23.1')
    d.down('R26', 142.24, 78.74, '1')
    d.route('R23.2', (142.24, 71.12), 'R26.1')
    d.ground('R26.2')
    d.route((142.24, 71.12), (149.86, 71.12))
    d.label('DINSYNC2', (149.86, 71.12), 'R')
    d.across('R20', 129.54, 60.96, '1')
    d.route('DIN4.2', 'R20.1')
    d.ground('R20.2', 'R')

    # MIDI thru.
    d.caption('MIDI THRU', 40.64, 96.52)
    d.chip('DIN2', DIN, 1, 101.6, 104.14, ref_at=(101.6, 91.44), val_at=(101.6, 118.0))
    shield('DIN2', 170.18, 101.6)
    d.nc('DIN2.3')
    d.nc('DIN2.1')
    d.ground('DIN2.2', 'R')
    d.across('R15', 76.2, 114.3, '2')
    d.route('DIN2.5', (88.9, 114.3), 'R15.1')
    d.out('R15.2', 'MIDI_IN', 'L', 2.54)
    d.across('R18', 127, 114.3, '1')
    d.route('DIN2.4', (114.3, 114.3), 'R18.1')
    d.rail('+5V', 'R18.2', 'R')

    # MIDI in, through the opto-isolator.
    d.caption('MIDI IN', 40.64, 142.24)
    d.chip('DIN3', DIN, 1, 101.6, 149.86, ref_at=(101.6, 137.16), val_at=(101.6, 163.0))
    shield('DIN3', 170.18, 132.08, grounded=False)
    for pad in ('3', '1', '2'):
        d.nc(f'DIN3.{pad}')
    d.across('R19', 127, 160.02, '1')
    d.route('DIN3.4', (114.3, 160.02), 'R19.1')
    d.chip('IC24', "4N37''", 1, 152.4, 162.56, ref_at=(152.4, 154.94), val_at=(152.4, 172.72))
    d.route('R19.2', 'IC24.1')
    d.route('DIN3.5', (88.9, 172.72), (139.7, 172.72), (139.7, 167.64), 'IC24.2')
    d.across('D48', 121.92, 167.64, 'A')
    d.route((111.76, 172.72), (111.76, 167.64), 'D48.A')
    d.route('D48.C', (137.16, 167.64), (137.16, 160.02))
    d.nc('IC24.6')
    d.rail('+5V', 'IC24.5', 'R')
    d.transistor('Q50', 175.26, 167.64, 'NPN')
    d.route('IC24.4', 'Q50.1')
    d.ground('Q50.3')
    d.down('R16', 165.1, 175.26, '2', left_text=True)
    d.route((165.1, 167.64), 'R16.2')
    d.ground('R16.1')
    d.down('R17', 177.8, 152.4, '2')
    d.rail('+5V', 'R17.2')
    d.route('R17.1', 'Q50.2')
    d.route((177.8, 160.02), (185.42, 160.02))
    d.label('MIDI_IN', (185.42, 160.02), 'R')

    # MIDI out.
    d.caption('MIDI OUT', 40.64, 187.96)
    d.chip('DIN1', DIN, 1, 101.6, 195.58, ref_at=(101.6, 182.88), val_at=(101.6, 208.0))
    shield('DIN1', 170.18, 193.04)
    d.nc('DIN1.3')
    d.nc('DIN1.1')
    d.ground('DIN1.2', 'R')
    d.across('R13', 76.2, 205.74, '1')
    d.route('DIN1.5', (88.9, 205.74), 'R13.2')
    d.out('R13.1', 'MIDI_OUT', 'L', 2.54)
    d.across('R14', 127, 205.74, '1')
    d.route('DIN1.4', (114.3, 205.74), 'R14.1')
    d.rail('+5V', 'R14.2', 'R')

    # The connector to the mainboard.
    d.chip('J3', "MA12-''", 1, 215.9, 50.8, ref_at=(215.9, 31.75), hide_value=True)
    for pin_no, net in ((12, 'DINSYNC1'), (11, 'DINSYNC2'), (10, 'DINSYNC3'), (9, 'DINSYNC4'), (6, 'MIDI_OUT'), (5, 'MIDI_IN'), (2, 'USB_RX'), (1, 'USB_TX')):
        d.out(f'J3.{pin_no}', net, 'R', 5.08)
    d.route('J3.8', (228.6, 45.72), (228.6, 48.26), 'J3.7')
    d.ground((228.6, 48.26), 'R')
    d.route('J3.4', (228.6, 55.88), (228.6, 58.42), 'J3.3')
    d.rail('+5V', (228.6, 55.88), 'R')
    d.note('to the mainboard', 208.28, 69.85)

    # CV and gate.
    d.chip('J6', HDR3, 1, 215.9, 109.22, ref_at=(215.9, 101.6), hide_value=True)
    d.ground('J6.2', 'R')
    d.chip('GATE0', MONO, 1, 256.54, 101.6, ref_at=(254.0, 91.44), hide_value=True)
    d.route('J6.3', (228.6, 106.68), (228.6, 96.52), 'GATE0.TIP')
    d.ground('GATE0.SLEEVE')
    d.nc('GATE0.TIPSHUNT')
    d.caption('GATE', 266.7, 96.52)
    d.chip('CV0', MONO, 1, 256.54, 124.46, ref_at=(254.0, 114.3), hide_value=True)
    d.route('J6.1', (231.14, 111.76), (231.14, 119.38), 'CV0.TIP')
    d.ground('CV0.SLEEVE')
    d.nc('CV0.TIPSHUNT')
    d.caption('CV', 266.7, 119.38)

    # Mix in and mix out.
    d.chip('J7', HDR3, 1, 215.9, 154.94, ref_at=(215.9, 147.32), hide_value=True)
    d.ground('J7.2', 'R')
    d.chip('MIXIN0', JACK, 1, 256.54, 149.86, ref_at=(246.38, 142.24), hide_value=True)
    d.route('J7.3', (231.14, 152.4), (231.14, 154.94), 'MIXIN0.T')
    d.ground('MIXIN0.TN')
    d.ground('MIXIN0.S')
    for pad in ('R', 'RN', 'SN'):
        d.nc(f'MIXIN0.{pad}')
    d.caption('MIX IN', 274.32, 147.32)
    d.chip('MIXOUT0', JACK, 1, 256.54, 180.34, ref_at=(246.38, 172.72), hide_value=True)
    d.route('J7.1', (228.6, 157.48), (228.6, 185.42), 'MIXOUT0.T')
    d.ground('MIXOUT0.S')
    for pad in ('R', 'RN', 'SN', 'TN'):
        d.nc(f'MIXOUT0.{pad}')
    d.caption('MIX OUT', 274.32, 177.8)

    # Headphones.
    d.chip('J5', HDR3, 1, 215.9, 213.36, ref_at=(215.9, 205.74), hide_value=True)
    d.rail('+6V', 'J5.3', 'R')
    d.ground('J5.2', 'R')
    d.chip('HEADPHONE0', JACK, 1, 256.54, 218.44, ref_at=(246.38, 208.28), hide_value=True)
    d.across('R164', 238.76, 215.9, '1')
    d.across('R186', 238.76, 223.52, '1')
    d.route('J5.1', (228.6, 215.9), 'R164.1')
    d.route('R164.2', 'HEADPHONE0.R')
    d.route((228.6, 215.9), (228.6, 223.52), 'R186.1')
    d.route('R186.2', 'HEADPHONE0.T')
    d.route((228.6, 223.52), (228.6, 228.6))
    d.label('HP_OUT', (228.6, 228.6), 'B')
    d.ground('HEADPHONE0.S')
    for pad in ('RN', 'SN', 'TN'):
        d.nc(f'HEADPHONE0.{pad}')
    d.caption('HEADPHONE', 274.32, 215.9)
