cozycactus/x0xb0x-hardware/(commit log)

2026-10-14 Import x0xb0x KiCad and Blender working project
    [2SC2291_SSIP5_ApproxBody--Body.stl, 2SC2291_SSIP5_ApproxBody.step, 2SC2291_SSIP5_ApproxBody.stl, Aavid_574502B00000G_BentBack_PhotoQualified--BlackAnodizedSpring.stl, Aavid_574502B00000G_BentBack_PhotoQualified.step, Aavid_574502B00000G_BentBack_PhotoQualified.stl, Aavid_574502B00000G_DrawingDerived_FoldedSpring.step, Aavid_574502B00000G_DrawingDerived_FoldedSpring.stl]
2026-10-14 Add fresh-clone project checks and opening guide
    Verify that downloaded KiCad libraries and embedded Blender geometry work without the original workspace. Record isolated native checks and provide reusable integrity, dependency and scene checks while preserving all design and model bytes.
2026-10-14 Refine historical transistor and ceramic resonator models
    Use the recovered Sanyo No.333H NP outline for 24 qualified transistor illustrations and refine the two Abracon bodies while retaining full leads. Preserve every non-model PCB node and the corrected front-control assembly. Record source limitations, native checks and saved-scene preservation evidence.
    [Resonator_AWCR16MD_TaperShoulders_P2.54_Illustration--Body.stl, Resonator_AWCR16MD_TaperShoulders_P2.54_Illustration--Lead1.stl, Resonator_AWCR16MD_TaperShoulders_P2.54_Illustration--Lead2.stl, Resonator_AWCR16MD_TaperShoulders_P2.54_Illustration--Lead3.stl, Resonator_AWCR16MD_TaperShoulders_P2.54_Illustration.FCStd, Resonator_AWCR16MD_TaperShoulders_P2.54_Illustration.step, Resonator_AWCR16MD_Ta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]
2026-10-14 Open rear connector passages in Blender assembly
    Remove five obsolete solid recess disks and bore the six audio mounting hardware illustrations around the native socket axes. Preserve KiCad revision 11 and all native component geometry.
    Add geometric opening regression checks covering all eleven rear ports, saved-scene preservation evidence and refreshed views. Document NYS216 DXF/PDF hardware differences and the real SW15 nut profile.
    [x0xb0x-populated-with-case.blend]
2026-10-14 Refine NYS216 mounting nuts from manufacturer drawings
    Replace the three plain hex illustrations with SW15 flats, the documented circular flange and a qualified rounded front. Align the complete nut meshes with the native socket axes while retaining object poses, washers and all native component geometry.
    Save Blender revision 10 with independent measured-geometry, preservation and rear-opening checks, refreshed renders and explicit source/appearance qualifications.
    [x0xb0x-populated-with-case.blend]
2026-10-14 Seat rear panel legends and record connector seating limits
    Move eleven retained rear legends along the panel normal so their glyphs
    sit on the plate without detached shadows. Preserve all component,
    connector, hardware, PCB and enclosure geometry and animation.
    Record nominal audio shoulder and power/USB edge intersections without
    inferring uncertain historical assembly datums or qualifying physical fit.
    Keep KiCad revision 11 and earlier Blender baselines byte-preserved.
    Validation: 14,820 saved-scene preservation checks, 185 glyph-plane checks,
    44 rear-opening checks with 974 rays, 106 portability checks, seven
    rendered views, and repository/library integrity checks passed.
    [x0xb0x-populated-with-case.blend]
2026-10-14 Correct MIDI port legends against original wiring
    Match the three rear MIDI legends to the original Eagle and current PCB
    connectivity: DIN1 OUT, DIN2 THRU and DIN3 IN. Preserve all component,
    connector, enclosure and hardware geometry, poses and animation.
    Record source-derived function evidence and inspect the user-supplied
    Warehouse COLLADA/SKP receipts. Keep standalone CAD outside the repository
    and qualify the supplied model's dimension and appearance differences.
    Validation: frozen saved-scene comparisons, four-frame glyph checks,
    source-function regression, 106 portability checks, 44 rear-opening
    checks with 974 rays and seven fresh rendered views passed. KiCad core
    files and earlie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
    [x0xb0x-populated-with-case.blend]
2026-10-14 Correct SDS-50J contact centers and slot directions
    Interpret the primary drawing's 25-degree leaders as slot tilts and restore the outer DIN contacts to the horizontal diameter. Retain body dimensions, PCB/case poses and all other scene data, with saved-file, native geometry and aperture regression evidence.
    Keep the received Warehouse CAD in local comparison scenes. Record its nominal pin/panel registration conflict and preserve the existing electrical findings.
    [Housing.stl, MatingSocket1.stl, MatingSocket2.stl, MatingSocket3.stl, MatingSocket4.stl, MatingSocket5.stl, RearCover.stl, SDS50J_CorrectedContactPattern.FCStd]
2026-10-15 Seat rear plate on the original Eagle I/O datum
    The original I/O board carries a detached Dimension strip 0.508 mm
    behind the PCB rear edge, exactly at the three REAN footprint origins,
    and the finishing manual clamps the rear plate with those jacks.
    Revision 13 put the plate inner face on the PCB edge, driving each
    audio shoulder 0.508 mm (about 102 mm3) into the plate.
    Blender revision 14 moves only the I/O board placement 0.508 mm toward
    the case front, with its wiring-study endpoints and conductor ends.
    The audio shoulders now seat on the plate and DIN/MJ fronts sit
    0.508 mm behind it. KiCad, copper, placement, case, plate cutouts and
    all other poses are unchanged; the strip-as-plate re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
    [x0xb0x-populated-with-case.blend]
2026-10-15 Seat I/O board on the original rear-panel height datum
    Every cutout in the original rear-panel DXF is measured from a
    component mounting plane 0.250 in above the plate's lower edge: both
    POWER/USB rectangles start there, and the audio and DIN holes sit
    their part axis heights above it within 0.001 and 0.018 mm. Revision
    14's 6.269 mm compromise left the POWER/USB bodies 0.081 mm below
    their cutouts.
    Blender revision 15 raises only the I/O board placement 0.081 mm, with
    its wiring-study endpoints, conductor ends and the three audio nuts
    that thread onto the jacks. POWER/USB now rest on their cutout edges,
    the audio jacks are centred and no port overlaps plate material.
    KiCad, copper, placeme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
    [x0xb0x-populated-with-case.blend]
2026-10-15 Record MJ-3536N axis height as a design tolerance
    The original CV/GATE holes sit 0.21 in above the rear-DXF datum,
    0.166 mm below the modelled 5.5 mm MJ-3536N axis. The manufacturer
    revision history in the retained 2020 and 2024 sheets shows that axis
    unchanged from the 2005 release, so the holes read as an inch rounding
    within the part's +-0.2 mm tolerance. No geometry change follows.
2026-10-15 Add KiCad-vs-Blender model consistency check
    The Blender assembly embeds native meshes exported from the KiCad
    projects, but no check confirmed they still match the current models.
    The new verifier exports both PCBs with kicad-cli into a temporary
    directory and compares every placed model's footprint frame and
    geometry with the scene's native mesh of the same designator, checking
    that the PCB files stay unchanged.
    Revision 15 matches all 491 models exactly; revision 12 reports
    exactly the four DIN models corrected in revision 13. README and
    OPENING document the command.
2026-10-15 Add drawing-derived terminals to the twelve pinless models
    Twenty-five placed references (rear jacks, DIN and USB sockets, the
    bent-back regulator, thermistors, encoder, pots and switches) showed
    bodies with nothing in their drilled holes. KiCad working revision 13
    adds solder terminals from each manufacturer drawing; Blender revision
    16 brings in the native meshes. Every fitted model now has a lead in
    every drilled hole except the four Grayhill bracket holes, whose legs
    the drawing does not define.
    Terminals follow the drawing dimensions in each model frame and were
    not moved to the pads. Previous body solids are retained exactly and
    the seven assembly models keep their named parts. A nati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
    [Alpha_RV112BCF40_25_DetailedCandidate_Terminals.step, CTS_290VAA5F201B2_DetailedCandidate_Terminals.step, Grayhill_25LB22H_DetailedCandidate_Terminals.step, MC78M05_TO220_BentBack_PhotoQualified_Terminals.step, MJ3536N_DrawingDerived_DetailedBody_Terminals.step, Microohm_LPTC12T21001_ApproxBody_Terminals.step, NKK_B12AB_DetailedCandidate_Terminals.step, NYS216_DrawingDerived_DetailedBody_Terminal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]
2026-10-15 Correct four terminal models against their drawings
    An independent source review of revision 13's 19 nominal hole
    conflicts found four terminal models that did not follow their
    drawings. The Alpha RV112 and Panasonic EVUF2L overall tab dimensions
    (13.0 and 10.60 mm) run across the outer slot edges, so the tabs sit
    at +-5.5 and +-4.50 mm, matching Eagle; revision 13 misread them as
    centre spacing. PJ-202AH terminal 2 is the 2.50 mm blade, and the
    SDS-50J pin sections follow the period CUI rev D drawing (2006),
    now retained in the repository.
    KiCad working revision 14 changes 12 PCB model paths and four
    footprint-cache paths; non-model nodes and transforms are verified
    identical, ERC is clean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
    [Alpha_RV112BCF40_25_DetailedCandidate_Terminals.step, PJ202AH_DrawingDerived_DetailedBody_Terminals.step, Panasonic_EVUF2LFL3_DetailedCandidate_Terminals.step, SDS50J_CorrectedContactPattern_Terminals.step, ioboard.kicad_pcb, mainboard.kicad_pcb, x0xb0x-populated-with-case.blend]
2026-10-15 Add a drill-fit check for every placed model
    The revision-13 and revision-14 hole audits covered only the 25
    terminal-completed references. This verifier exports both PCBs with
    kicad-cli, reads the drilled pads from the PCB files and cuts all 489
    models with drilled holes at both board faces and mid-depth. It
    requires a lead in every drilled hole and fails on any interference
    or board crossing not declared in docs/drill-fit-allowances.json.
    The allowances record the remaining nominal conflicts with their
    sources: TL1100F free-state retention kinks, the unresolved NYS216
    row offset, the USB board-lock press fit, SDS-50J pins 1-2 and
    PJ-202AH terminal 3 at Eagle grid positions, and the undime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
2026-10-15 Join every drawing-derived terminal to its body
    Inspection in the KiCad 3D viewer showed potentiometer pins that did
    not come out of the pots. A solid-distance audit found 24 terminals
    of six models (Alpha and Panasonic pots, CTS encoder, NKK bracket
    legs, SDS-50J pins 4-5, MJ-3536N tip and shunt) stopping just above
    the seat, 0.03-2.4 mm beside the body. The drawings show these
    terminals leaving the base edge and turning down; revisions 13-14
    modelled only the part below the seat.
    KiCad working revision 15 gives each a formed leg with its own
    section, running from the pin into the nearest body edge. Leg height
    and bend are assumptions; pin positions, holes and the 11 recorded
    hole conflict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
    [Alpha_RV112BCF40_25_DetailedCandidate_Terminals.step, CTS_290VAA5F201B2_DetailedCandidate_Terminals.step, MJ3536N_DrawingDerived_DetailedBody_Terminals.step, NKK_B12AB_DetailedCandidate_Terminals.step, Panasonic_EVUF2LFL3_DetailedCandidate_Terminals.step, SDS50J_CorrectedContactPattern_Terminals.step, ioboard.kicad_pcb, mainboard.kicad_pcb]
2026-10-15 Rebuild the Grayhill 25L switches from drawing and photograph
    The S3/S4 model was a plain square block with a misplaced
    anti-rotation tab. A photograph of the 25L hex-output part (label
    8 4 2 1 C, matching the BOM's 25LB22-H) shows a round drum top over
    the square base, two lock lugs, a white label band and a green output
    board with soldered pins; the Series 25L drawing's front view puts the
    non-turn tab on the centre line opposite the pins.
    KiCad working revision 16 rebuilds the body with those features. All
    printed dimensions, the board, bushing and shaft solids and the pin
    positions are unchanged; drum, lug and label proportions are
    photo-derived. The pins rise 0.8 mm through the solder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
    [Grayhill_25LB22H_PhotoDrawing.step, Grayhill_25LB22H_PhotoDrawing_Terminals.step, mainboard.kicad_pcb, x0xb0x-populated-with-case.blend]
2026-10-15 Colour the TL1100F switch legs as metal
    The 23 TL1100F tact switches showed black legs in the KiCad 3D
    viewer. The publisher CAD is one grey solid; revision 8 coloured its
    faces by position and gave terminal metal only to faces wholly below
    the seat, so the 24 leg faces per switch that leave the 12 x 12 mm
    housing and rise up to 1.45 mm above the board stayed black.
    KiCad working revision 17 re-points only those faces' STYLED_ITEM
    entries to the terminal style; every other STEP entity and the B-rep
    are byte-identical. KiCad's own export confirms the colours on all
    23 switches with geometry equal to revision 16. Only 23 PCB model
    paths and one footprint-cache path change; ERC is clean and bo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
    [TL1100F_ManufacturerCAD_FullNominalFreeState_MetalLegs.step, mainboard.kicad_pcb, x0xb0x-populated-with-case.blend]
2026-10-15 Correct the BOM USB connector standoff and terminal projections
    [DrawingDerivedTerminals.stl, Insulator.stl, Kobiconn1542442E_DrawingDerived_Terminals.FCStd, Kobiconn1542442E_DrawingDerived_Terminals.step, MatingContacts.stl, Shell.stl, ioboard.kicad_pcb, x0xb0x-populated-with-case.blend]
2026-10-15 Use current revision paths in USB verification replay scripts
2026-10-15 Add drawing-derived STD240B spacers beneath all forty LEDs
    [AnodeFullWidthLead.stl, BlackSTD240BSpacer.stl, CathodeFullWidthLead.stl, ClearLensBody.stl, LED5mm_STD240B_WithSpacer.FCStd, LED5mm_STD240B_WithSpacer.step, mainboard.kicad_pcb, x0xb0x-populated-with-case.blend]
2026-10-15 Correct Micro-Ohm PTC bodies and leads from the recovered source
    [Band1.stl, Band2.stl, Band3.stl, Band4.stl, Band5.stl, Body.stl, DrawingDerivedTerminals.stl, Microohm_LPTC12_PrimaryDimensions_FormedLeads.FCStd]
2026-10-15 Model the original Xicon XRL electrolytics at the exact board pitch
    KiCad working revision 21 / Blender revision 24. The original parts
    list names the electrolytics only as generic Mouser parts; the kit
    photographs and expanded-BOM extracts identify the light-blue Xicon
    XRL family. The 36 placements that used generic 5 mm- and 10 mm-tall
    KiCad cans at 2.50/5.00 mm pitch now use XRL datasheet bodies
    (XC-600178, 1/8/07): 5x11 mm for 33 parts, 6.3x11 mm for C7/C8
    (100uF 25V) and 10x12.5 mm for C43, with photo-sampled sleeve colours.
    The models are built in the inherited KiCad model frames, so pads,
    copper and transforms are unchanged and the leads land on the exact
    2.54/5.08 mm holes. The 5 mm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
    [CP_Xicon_XRL1u50_P3.556_PhotoColours.step, CP_Xicon_XRL2200u16_P5.08_PhotoColours.step, CP_Xicon_XRL_D10x12.5_P5.08_KiCadFrame.step, CP_Xicon_XRL_D5.0x11_P2.54_KiCadFrame.step, CP_Xicon_XRL_D6.3x11_P2.54_KiCadFrame.step, ioboard.kicad_pcb, mainboard.kicad_pcb, x0xb0x-populated-with-case.blend]
2026-10-15 Add the original kit colour bands to every fixed resistor
    KiCad working revision 22 / Blender revision 25. All 212 fixed
    resistors used the plain beige KiCad DIN0207 body. The original parts
    page prints the band colours for every value, so each resistor now
    carries the bands of the part supplied in the kit: tan 5% bodies with
    four bands and light-blue 1% bodies (R4, R5, R106, R74-R90) with five,
    the latter sampled from the page photographs.
    The bands are flush rings cut from the KiCad body's own material, so
    body and lead geometry, heights and hole fit are unchanged; only the
    212 model paths change and the shared footprint caches keep the plain
    body. The 200K 1% bands are read from its phot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
    [R_DIN0207_P10.16mm_Horizontal_Brown-Black-Orange-Gold_KiCadBody.step, R_DIN0207_P10.16mm_Horizontal_Brown-Black-Red-Gold_KiCadBody.step, R_DIN0207_P15.24mm_Horizontal_Brown-Black-Orange-Gold_KiCadBody.step, R_DIN0207_P2.54mm_Vertical_Brown-Black-Orange-Gold_KiCadBody.step, R_DIN0207_P2.54mm_Vertical_Red-Red-Red-Gold_KiCadBody.step, R_DIN0207_P5.08mm_Vertical_Blue-Grey-Orange-Gold_KiCadBody.step, 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]
2026-10-15 Seat IC3 and IC2 in their original-BOM TE DIP sockets
    KiCad working revision 23 / Blender revision 26. The original parts
    list fits IC3 (ATmega162) and IC2 (EEPROM) in AMP 390262-5 and
    390261-2 DIP sockets, but the model placed the chips on the board.
    TE's manufacturer models of the lead-free successors 1-390262-5 and
    1-390261-2 are now used unchanged: black ladder housings 5.10 mm tall
    with tin contacts, matching the kit photograph and distributor data.
    Each socket is aligned in the existing KiCad DIP model frame with its
    notch at pin 1 and its 0.17 x 0.60 mm tails on the original pad axes,
    so pads, drills and transforms are unchanged. The KiCad DIP chips are
    raised 5.10 mm onto the socket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
    [DIP-40_W15.24mm_in_1-390262-5_Socket_KiCadFrame.step, DIP-8_W7.62mm_in_1-390261-2_Socket_KiCadFrame.step, mainboard.kicad_pcb, x0xb0x-populated-with-case.blend]
2026-10-16 Print the kit-photo part markings on all seventeen ICs
    KiCad working revision 24 / Blender revision 27. The chip models were
    blank. Each IC now carries its marking transcribed from the original
    kit photographs - part number and code lines, logos omitted - raised
    0.03 mm in light-grey ink on the unchanged chip top: the 74HC595s,
    74AC174PC, MM74HC126N, MC14066BCP, AN6562, ATMEGA162-16PI, 25C33P,
    4N37 and FT232BM. The 74HC165s have no photograph and show their part
    number only.
    Chip and socket solids, face colours and transforms are unchanged;
    only the 17 model paths and six single-placement footprint caches
    change. The underside FT232BM reads correctly from below because
    KiCad rotates bottom-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
    [DIP-14_W7.62mm_Marked_4066.step, DIP-14_W7.62mm_Marked_74HC126.step, DIP-16_W7.62mm_Marked_74AC174.step, DIP-16_W7.62mm_Marked_74HC165.step, DIP-16_W7.62mm_Marked_74HC595.step, DIP-40_W15.24mm_in_1-390262-5_Socket_KiCadFrame_Marked_ATmega162.step, DIP-6_W7.62mm_Marked_4N37.step, DIP-8_W7.62mm_Marked_AN6562.step]
2026-10-16 Cross-check the models against the expanded x0xb0x BOM
    The AdaWiki expanded BOM blocks automated fetches, so the electrolytic
    part numbers came from search-engine extracts. The repository owner
    printed the page (last modified 2016-01-28) to PDF; the print is kept
    byte-for-byte with a script that re-runs 22 checks against it.
    It confirms all seven Xicon XRL part numbers and that the eight rows
    name exactly the 39 modelled electrolytics. Its two 100uF part numbers
    are transposed against their descriptions; the circuit shows the
    descriptions are right (C7/C8 sit on the stacked rail above 10 V), so
    the revision-21 sizes stand. 208 of the 209 listed resistors match the
    revision-22 bands; R16 is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
2026-10-16 Compare both boards with the original Eagle CAM data and declare the switch strips
    KiCad working revision 25 checks the boards for ordering. Gerbers and
    Excellon drills from KiCad 10.0.7 are compared object by object with the
    original Eagle 4.13 boards. The Eagle side is evaluated with Eagle's CAM
    rules from the conversion's staging XML, which is cross-checked against
    an independent read of original-eagle/. Drills, all copper tracks and
    arcs, vias, every pad except 27 SIP9 pads, the pour outlines and
    connectivity, paste and all non-text silkscreen match. The remaining
    differences are recorded with their locations, not changed: SIP9 pad
    length, 445 name-label positions and 11 renamed labels,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
    [mainboard.kicad_pcb]
2026-10-16 Restore the Eagle SIP9 pad size and the smashed name labels
    KiCad working revision 26 corrects the copper and silkscreen differences
    that the revision-25 fabrication comparison recorded.
    The 27 SIP9 pads of IC14, IC15A and IC15B and the library footprint's
    nine now measure 1.408 x 2.816 mm. Eagle 4.13 restrings the 1.016 mm
    library diameter on the 0.9 mm drill to 1.408 mm and then elongates it;
    the importer had elongated the library value (1.40 x 2.032 mm). Only the
    pad size nodes change; drills and positions stay.
    The reference labels of the 381 mainboard and 80 I/O parts with an
    Eagle smashed name record take that record's position, rotation, layer
    and size, oriented by KiCad's own Eagle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
    [ioboard.kicad_pcb, mainboard.kicad_pcb]
2026-10-17 Refill the mainboard pours, take the I/O datum off Edge.Cuts and add order packages
    KiCad working revision 27 corrects two defects that a first fabrication
    export found when its Gerbers were re-imported against the board files.
    The mainboard's saved F.Cu ground fill still cleared the SIP9 pads as
    they were before revision 26 lengthened them. As saved and plotted it
    touched 23 of them: KiCad's DRC without a refill finds 23 clearance
    violations at 0.000 mm and 23 mask bridges. Revision 26's DRC refilled
    the zones first, and the Eagle comparison checks pour outlines, not
    fills. KiCad's refill of a temporary copy is installed by copying only
    the filled_polygon nodes of the two zones; every othe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
    [ioboard-B_Cu.gbr, ioboard-B_Mask.gbr, ioboard-B_Paste.gbr, ioboard-B_Silkscreen.gbr, ioboard-Edge_Cuts.gbr, ioboard-F_Cu.gbr, ioboard-F_Mask.gbr, ioboard-F_Paste.gbr]
2026-11-04 Add an ngspice simulation of the VCF from the KiCad schematic
    The filter shapes most of this instrument's sound, and no unit is built
    yet, so there is nothing to measure. A model built from the revision 27
    schematic gives a first reference for what shapes the filter and what to
    check at bring-up. Parts and nets come from the schematic through
    vcf-parts.json rather than being retyped.
    The ladder matches Stinchcombe's analysis to within 0.09 dB. The model
    agrees with the kit pages and the Devil Fish manual on tuning range,
    self-oscillation only with doubled feedback, and accent shape. The top
    of the cutoff range depends on VR3's taper, which is unknown.
    Resonance strength follows cutoff beca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
2026-11-04 Simulate the whole analog section and render WAVs from the line output
    The filter study stopped at the VCA input and used an ideal saw and an
    approximate gain envelope. This adds the CV DAC, slide, transistor-level
    VCO, both envelopes, accent, VCA and mixer to one deck, driven by the
    stock firmware's note timing, so the audio comes from N$7 with no gain
    envelope added afterwards.
    Only the trims are set. CV, pitch, saw, square, gate levels and VCA
    closing time agree with the kit pages and the Devil Fish manual. The VCA
    opens in 5.6 ms against 1 to 5 ms.
    IC15 is a generic OTA and IC11 a generic op-amp, because no usable
    datasheet was found. Q27 is fitted, because the VCO core latched at high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
2026-11-04 Add SSIP5 adapter boards for the rare dual transistors
    The 2SC1583 and 2SC2291 now exist only as old stock, with a real risk
    of fakes, so the owner chose adapters. These two small boards carry a
    current SOT-363 dual and land on the existing 2.286 mm holes at Q12,
    Q21, Q26 (common emitter) and Q22 (common base). The main boards are
    unchanged.
    The parts come from running datasheet-fitted stand-ins through the VCF
    and VCO models. Only Q21's gain matters much, so it gets the higher
    gain BC847C and the others BCM847BS. The board stands on edge because
    a flat one would not clear the neighbours at Q12 and Q22.
    Nothing has been built or measured. Noise is white only and thermal
    drift is not simula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
    [ssip5-cb-B_Cu.gbr, ssip5-cb-B_Mask.gbr, ssip5-cb-B_Silkscreen.gbr, ssip5-cb-Edge_Cuts.gbr, ssip5-cb-F_Cu.gbr, ssip5-cb-F_Mask.gbr, ssip5-cb-F_Silkscreen.gbr, ssip5-cb-NPTH.drl]
2026-11-04 Redraw both schematics by hand on sheets, one per block
    The imported schematics were one large sheet per board, with service
    references such as #GND42 and an N$ label on nearly every net. They were
    hard to read, and the analog part was packed tight.
    KiCad revision 28 redraws them as nine A3 sheets for the mainboard and
    three for the I/O board, in the blocks of the original sheet. Every wire
    is typed by hand. Each pin is checked against the board copper and the
    original Eagle nets, with the same net names; leaving a wire out of any
    sheet makes the check fail. Nets on one sheet keep their Eagle names
    through a 0.05 mm label, because the board, the fabrication packages and
    the simulation use t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
    [ioboard.kicad_pcb, ioboard.kicad_sch, mainboard.kicad_pcb, mainboard.kicad_sch, p02_cpu.kicad_sch, p02_power.kicad_sch, p03_encoders.kicad_sch, p03_usb.kicad_sch]
2026-11-04 Fix the redrawn sheets' links, found by opening them in KiCad
    Opening the mainboard from ad65ff0 in the KiCad editor showed what
    kicad-cli had not reported. The editor said it had fixed an error on
    loading and warned of an older file format, and Update PCB wanted to
    relink all 410 footprints.
    There were three causes. Sheet instances named a top-level sheet other
    than the project file's, so the editor rebuilt them and renumbered the
    pages. The format numbers were older than KiCad 10 writes. A regex in
    relink_board.py gave every footprint on a sheet the same path.
    verify_redraw.py now checks all three, and these checks fail on the old
    files. Both projects now open with no message and pages i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
    [ioboard.kicad_pcb, ioboard.kicad_sch, mainboard.kicad_pcb, mainboard.kicad_sch, p02_cpu.kicad_sch, p02_power.kicad_sch, p03_encoders.kicad_sch, p03_usb.kicad_sch]
2026-11-04 Give the mainboard's mounting holes symbols
    Update PCB with its default options would have deleted the seven 3.3 mm
    mounting holes, because they are on the board but on no sheet. This was
    already so at revision 27.
    A new frame on the CPU sheet has a pin-less symbol for each hole, out of
    the BOM, so the BOM doesn't change. The board gains one path line per
    hole and nothing else, and its Gerbers re-export the same. Schematic
    parity goes from 120 to 127 warnings: 7 extra-footprint warnings became
    14 mismatches on value and BOM flag. Update PCB has still not been
    applied.
    verify_redraw.py now fails on any footprint with no symbol.
    relink_board.py and the check that the board differs only in it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
    [mainboard.kicad_pcb, p02_cpu.kicad_sch, pcb-relink-record.json, schematic-redraw.json]
2026-11-04 Add SMD sites for the rare dual transistors to the mainboard
    The 2SC1583 and 2SC2291 pairs are only available as old stock. This is
    KiCad revision 29: four SOT-363 chips, parts in production, sit beside
    Q12, Q21, Q22 and Q26. The SIP holes stay, so an original pair or an
    adapter can still go in. The sheets and BOM mark those pairs do not
    place; fit a chip or its pair, never both.
    Routed by hand in the PCB editor: 81 track segments and 7 vias around
    the chips. Every original pad, drill, track and via still matches the
    Eagle board, apart from one track split where a new one joins it. The
    sheets show the chips apart from the circuit, joined by visible
    labels. Nothing has been built or measured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
    [ioboard-B_Cu.gbr, ioboard-B_Mask.gbr, ioboard-B_Paste.gbr, ioboard-B_Silkscreen.gbr, ioboard-Edge_Cuts.gbr, ioboard-F_Cu.gbr, ioboard-F_Mask.gbr, ioboard-F_Paste.gbr]
2026-11-04 Add the SMD sites and KiCad 29 copper to the Blender scene
    Blender revision 28 brings the scene level with KiCad working revision
    29 on the mainboard. Revision 27 had no chips, so the KiCad/Blender
    model check no longer matched.
    The four SOT-363 chips stand at their footprints, as the native
    export's own objects. The SIP pairs Q12, Q21, Q22 and Q26 leave the
    scene: KiCad marks them do-not-place, the scene counts fitted
    references, and a chip or its pair goes on the board, never both. The
    count stays 491, and verify_kicad_blender_models.py now exports with
    --no-dnp. The drill-fit and terminal-join checks read KiCad and still
    check the pairs' leads against the holes that stay. Revision 27 sti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
    [x0xb0x-populated-with-case.blend]
2026-11-05 Add SC-59 sites for the 2SK30A JFETs to the mainboard
    The 2SK30A is the last rare transistor on the board. Its replacement,
    the Toshiba 2SK208, comes only in SC-59 and this project has no adapter
    for it, so the mainboard gets two more chip sites: Q128 (O grade) beside
    Q28 and Q139 (Y grade) beside Q39. The TO-92 holes stay, and both
    originals are marked do-not-place.
    The two datasheets give the same ratings and characteristics. Neither
    part has been measured, and nothing has been built.
    The 9 track segments were written from a hand-drawn plan, not drawn with
    the mouse, because the screen was locked. KiCad's DRC checks them like
    any other track: 341, 1 and 127, as at revision 29. Every orig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
    [ioboard-B_Cu.gbr, ioboard-B_Mask.gbr, ioboard-B_Paste.gbr, ioboard-B_Silkscreen.gbr, ioboard-Edge_Cuts.gbr, ioboard-F_Cu.gbr, ioboard-F_Mask.gbr, ioboard-F_Paste.gbr]
2026-11-05 Show sheet numbers on global labels and link them in the PDFs
    Following a signal across the 12 A3 sheets meant searching for its
    name. Each global label now shows the other sheets its net is on, as
    N$53 [9], in the KiCad editor and in the schematic PDFs.
    The generator places the field past the label's box, because on the
    label's own anchor it overlaps the name. A net on one sheet leaves the
    field empty, because KiCad prints [] for it. R138's text and two notes
    moved to make room.
    KiCad plots each reference as a JavaScript menu that only Acrobat runs,
    so export_pdfs.py rewrites them as plain links, one per number. Clicked
    with the real mouse, they jump in macOS Preview. In the editor a clic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
    [p02_cpu.kicad_sch, p02_power.kicad_sch, p03_encoders.kicad_sch, p03_usb.kicad_sch, p04_midi_jacks.kicad_sch, p04_switches.kicad_sch, p05_leds.kicad_sch, p06_cv_vco.kicad_sch]
2026-11-05 Add the JFET sites and KiCad 30 copper to the Blender scene
    Blender revision 29 brings the scene level with KiCad working revision
    30 on the mainboard. Revision 28 still had Q28 and Q39 and lacked Q128
    and Q139, so the KiCad/Blender model check no longer matched.
    The two SC-59 chips stand at their footprints, as the native export's
    own objects. The TO-92 JFETs Q28 and Q39 leave the scene: KiCad marks
    them do-not-place, the scene counts fitted references, and a chip or
    its JFET goes on the board, never both. The count stays 491. The
    drill-fit and terminal-join checks read KiCad and still check the
    JFETs' leads against the holes that stay. Revision 28 still shows them.
    The eight mainboard la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
    [x0xb0x-populated-with-case.blend]
2026-11-05 Correct the voltage drop on Q128's drain track
    The SMD sites README said about 12 mV. The track is about 12 milliohm
    and under 1 mA runs through R105, so it loses about 0.01 mV. No board
    file or check depends on this figure.
2026-11-05 Add FR-4 main and rear panels as KiCad boards
    The case needs two custom panels, and the original drawings have no
    legends. Drilling 58 holes and 23 cuts by hand can't hold the LED
    margins, so draw the panels as boards a PCB fab can make, with the
    legends in silkscreen.
    Hole and cut centres follow Adafruit's DXFs. The LED, toggle, CV and
    GATE holes and the button, USB and power cuts are wider, because the
    original fits leave too little for the fab's tolerances. The README
    lists each change and its margin. Wording comes from the label map
    read from the original panel photo; positions are set from the holes.
    Small unconnected copper rings sit under screw heads and nuts, because
    a fab may refu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
    [iopanel-B_Cu.gbr, iopanel-B_Mask.gbr, iopanel-B_Silkscreen.gbr, iopanel-Edge_Cuts.gbr, iopanel-F_Cu.gbr, iopanel-F_Mask.gbr, iopanel-F_Silkscreen.gbr, iopanel-NPTH.drl]
2026-11-05 Compute how far the FR-4 panels flex
    The panel README listed flex under button presses as unknown. Model
    panel and mainboard as thin plates tied by the three middle standoffs,
    with the corners held by the case, and press each button, knob and
    the panel itself.
    At a firm 10 N press the board alone gives 0.76 mm, as with the
    original. If the panel edge bears on the case ledge, FR-4 changes
    nothing under the controls; if only the corners hold it, the worst
    button sinks 1.45 mm against 0.95 mm for aluminium. Gmsh and CalculiX
    from FreeCAD repeat 12 of the cases within 0.5-2.0 %. Model only.
2026-11-05 Move the parts order list into the repository
    The list for one unit lived in a sibling folder with no version
    control, so its history and Mouser readings could be lost. Keep its
    scripts, the footprint data they read and the generated lists under
    parts/, and link them from the README.
    Only links changed: paths now point inside the repository, and four
    datasheets kept as local copies are linked at their makers' sites.
    Rebuilt here, the lists match the old ones apart from those links,
    and the footprint data read from the current boards is unchanged.
    [x0xb0x-parts-order.csv]
