cozycactus/x0xb0x-hardware/(notices)

Notices in the files:
kicad-working/panels/iopanel/iopanel.kicad_pcb:
Panel drawing (c) Limor Fried and Adafruit Industries, MIT license
kicad-working/visualization/blender-case-revision-7/harness-sources/primary-wiki-jumpers.md:
https://wiki.ladyada.net/lib/images/license/button/cc-by-sa.png
